dotrodeo/rodeo/web/src/assets/hardware/rev-b/rodeo-power-usbc-iso.webp

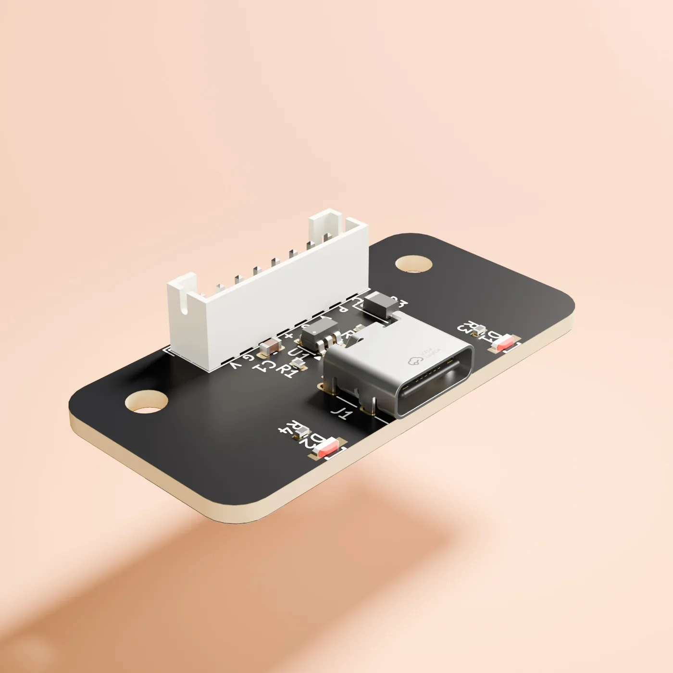
web/src/assets/hardware/rev-b/rodeo-power-usbc-iso.webp
