dotrodeo/rodeo/hardware/rodeo-motherboard/renders/rodeo-motherboard-front.jpg

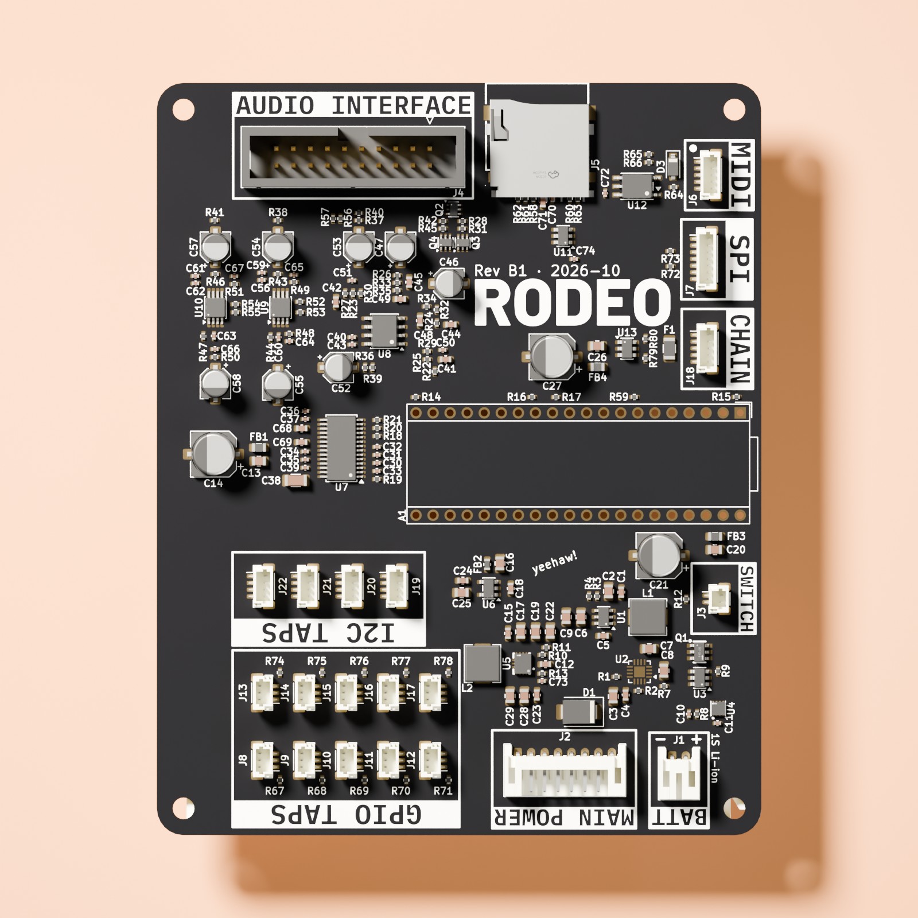
hardware/rodeo-motherboard/renders/rodeo-motherboard-front.jpg
