dotrodeo/rodeo/instruments/rodeo-002/docs/RODEO_002_CONCEPT.md

---
title: "rodeo-002 — Instrument Concept"
tags: [rodeo, rodeo-002, instrument, concept, granular, plaits, daisy-seed]
status: draft
created: 2026-09-20
updated: 2026-09-22
---

# rodeo-002 — Instrument Concept

**What it is:** the second instrument instance built on the Rodeo platform (see the repo
README — the platform is the product, an instance is a demonstration of it). rodeo-002 is a
**multi-engine digital polysynth feeding a Chroma-Console-style texture chain that ends in a
granular delay.** It is played from an external MIDI keyboard; it has no keybed and no
sequencer.

It is deliberately *not* rodeo-001. rodeo-001's governing rule was **no hidden controls**;
rodeo-002 accepts a **single shift layer** (Derek, 2026-09-20) in exchange for far more
parameters than its 21 physical controls could otherwise reach.

## Fixed constraints (Derek, 2026-09-20)

| | |
|---|---|
| Parts on hand | 1 motherboard · 1 encoder hub · **5 encoders** · **16 pots** · 1 OLED · **no buttons** |
| Played by | MIDI keyboard only (TRS MIDI IN). No arp/sequencer requirement |
| Daisy | Seed, **64 MB SDRAM** variant |
| Audio input | **Ignored for this build.** Possible future upgrade (the jacks exist) |
| Presets | **Required** |
| Voices | Voice-mode switch. **6 minimum, 8 target, 12 only if resources spare** |
| Touchstone | **Hologram Electronics Chroma Console** — its textures and granular delays |

## Signal flow

```
MIDI IN ─► voice alloc ─► N × [ macro-oscillator engine ─► SVF ─► amp env ] ─► stereo sum
                                                                                   │
   ┌───────────────────────────────────────────────────────────────────────────────┘
   ▼
 [CHARACTER] ──► [MOVEMENT] ──► [TEXTURE] ──► [SPACE] ──► tilt EQ ─► volume ─► LINE OUT
  drive /        chorus /       bitcrush /    granular delay / cloud,
  fold /         vibrato /      tape wobble / freeze, reverse, pitch-shifted
  saturate       phaser         lo-fi filter  grains (shimmer)
```

### The voice

One **engine per patch**, selected on the main encoder. Every engine is driven by the same
three macros — **Harmonics / Timbre / Morph** — so the panel never changes meaning, only
character. The engine list, **measured on hardware 2026-09-20** (budget section below).
"Voices" is the largest count that stayed under 70% audio load **with the texture chain
running**. Poly mode caps at 8 regardless — a higher number here is headroom, not voices.

| Engine | Source | Cost/voice | Voices |
|---|---|---|---|
| Virtual analog (synced variable-shape) | DaisySP `VariableShapeOscillator` | 3.3% | **16** |
| Variable saw | DaisySP `VariableSawOscillator` | 3.0% | **16** |
| ~~Particle (resonant noise grains)~~ | ~~DaisySP `Particle`~~ | ~~3.6%~~ | **DROPPED 2026-09-29** |
| Formant / vowel | DaisySP `FormantOscillator` | 4.6% | **12** |
| Harmonic / additive (16 partials) | DaisySP `HarmonicOscillator<16>` | 6.7% | **8** |
| 2-op FM | DaisySP `Fm2` | 6.8% | **8** |
| ~~Grainlet~~ | ~~DaisySP `GrainletOscillator`~~ | ~~6.9%~~ | **DROPPED 2026-09-29** |
| Vosim | DaisySP `VosimOscillator` | 8.9% | 6 |
| Z-osc | DaisySP `ZOscillator` | 9.5% | 6 |
| ~~Karplus string~~ | ~~DaisySP `String`~~ | ~~14.0%~~ | **DROPPED 2026-09-29** |
| ~~String voice~~ | ~~DaisySP `StringVoice`~~ | ~~16.4%~~ | **DROPPED 2026-09-29** |
| ~~Modal~~ | ~~DaisySP `ModalVoice`~~ | ~~46.2%~~ | **DROPPED** |
| Wavetable | *deferred* — would port from Plaits (MIT) | unmeasured | — |
| Chord | *deferred* — would port from Plaits (MIT) | unmeasured, ~4–6 osc/voice | — |

**Wavetable and Chord are deferred** (Derek, 2026-09-20): not ported for now, so the shipping
engine list is the twelve measured above.

**MODAL IS DROPPED** (Derek, 2026-09-22): at 46% for a single voice it could not run at all
beside an expensive Space type, and designing around it was not worth it.

**GRAINLET, PARTICLE, STRING AND KARPLUS ARE DROPPED** (Derek, 2026-09-29, after living with
the instrument): four engines nobody reached for, two of which could not be played
polyphonically at all. That leaves **seven engines** — virtual analog, variable saw, 2-op FM,
formant, Vosim, harmonic-16, Z-osc — every one of them polyphonic, so nothing overrides the
voice mode any more. The DSP stays in DaisySP if any of it is ever worth having back.

**The removal paid for itself twice over.** `Engine` holds one union sized by its largest
member, and `StringVoice` is **5368 bytes** against **148** for everything that remains. Per
voice storage fell 5220 bytes; across eight voices that is **~41.6 KB of DTCM**, and the build
went from **85.5% to 53.8%** of the 128 KB budget. The CPU ceiling moved too: the dearest engine
left is Z-osc at 9.02%, where String was 16.43%.

Per-voice costs above are the 2026-09-22 hardware fit (raw ticks, post-optimisation); they
are the numbers [`cost_model.h`](../firmware/common/cost_model.h) uses.

Most of the list is already vendored in `rodeo-sdk/DaisySP` — these are the
Plaits-derived modules Émilie Gillet contributed upstream, so the "Plaits-like" feel is mostly
a matter of *driving* them from common macros rather than porting new DSP. Anything still
missing comes from the MIT-licensed Mutable source.

**Per voice, after the engine:** a DaisySP `Svf` (Derek chose a real multimode filter over a
Plaits-style low-pass gate), **one ADSR** and one LFO.

**One envelope, shared** (decided 2026-09-21). The single ADSR drives the amp directly, and
the filter, Timbre and Morph through their amount controls (Filter env amount, Env→Timbre,
Env→Morph). That is what the panel has controls for — four envelope stages, not eight — and
it is how the platform's `06_poly_synth` example works.

**Voice modes:** Poly (8, or 6 on Vosim/Z-osc) · Mono (legato + glide) · Unison (stacked,
detuned by Spread).

### Patch gain (2026-10-01)

Derek: *"the maximum volume output has quite a wide range. Some patches are very loud, other
patches are very quiet."* Measured, that was **19.3 dB of peak spread** across the sixteen factory
presets — a lot more than "some patches are just louder".

**Where it comes from.** Not the engines: at identical settings all seven sit within **5.7 dB** of
each other, so a per-engine trim would have bought almost nothing. It comes from the patches —
envelope, filter, voice mode and how much of the chain is in play — which means nothing but a
stored, per-preset number can fix it.

**So every preset carries a gain**, linear, −18 to +12 dB, on the patch settings page in dB and
adjusted half a decibel at a time — **and shown to the half decibel**, since the step is half a
decibel. It first rounded to whole dB, which printed `+8 dB` for two different settings and so said
the knob had done nothing; a readout that cannot tell two states apart is worse than no readout
(Derek, 2026-10-01). Each adjustment also snaps to the half-decibel grid rather than running the
value through log and exp and keeping the error, so the text is exactly the state. Sixty-one
distinct readings end to end, enforced by `Ui.EveryGainDetentReadsDifferentlyFromTheLast`. It is applied **after the chain**, as a separate trim from the
master volume, for two reasons: turning a preset down must not also turn its drive down, and the
master is squared for feel, which would make a trim folded into it mean something else.

Why not a normaliser, the other option on the table: an automatic one fights the player. Close the
filter and it gets louder; it cannot tell "quiet because it is a pluck" from "quiet because it
needs gain". A number set once per sound is predictable, and it is what every synth with this
problem does.

**The factory bank is balanced with it**, to a −6 dB peak on a four-note chord at full velocity.
`Level.SuggestedFactoryGains` prints the figure each preset needs, and those are the numbers in
`factory_presets.h`. Peak spread is **2.4 dB** now, enforced by `Level.TheFactoryBankIsLevel`.
Peak is what is matched and RMS deliberately is not: a pluck carries less energy than a pad at the
same peak, and forcing their RMS together would mean boosting the pluck until it clipped.

**It cost no new storage.** `release` had been dead since the envelope became ADS on 2026-09-24 —
written in step with `decay`, read by nothing — so the gain took its four bytes at the same offset.
That still needed `PresetBank::kVersion` 2 → 3, because a v2 slot holds a copy of `decay` there and
a decay value read as a gain is a quiet preset nobody asked for. **A v2 bank is migrated rather
than rejected**: the layout is identical, so the whole migration is to put unity in that one field
and move the version on. Nothing saved is lost, which is the only reason the version could be
bumped at all.

### Effects review (2026-09-29)

Derek: *"I suspected some of them may not be working as expected."* All twenty types were measured
against what their names claim, not just for stability — the existing tests already asked whether
each type was stable, transparent at zero and audible at full, and a phaser that is really a
low-pass passes all three. `tests/fx_review_gtest.cpp` holds the harness and prints every number.

**Character, Movement and Space came out clean.** All five waveshapers add harmonics and none leaks
DC; Bias brings in even harmonics on four of them and takes them *away* on Rectify, which is
correct and documented (centred, Rectify is already full-wave). The Movement LFO runs at exactly the
0.05–12 Hz it claims, Vibrato is the only type without stereo motion (by design, no dry path), and
every Space type responds properly to both Time and Feedback.

**Two real faults, both in Texture:**

* **Crush was sending −0.125 of DC to the output.** `Decimator` quantises with an arithmetic shift,
  which truncates toward minus infinity instead of rounding, so every sample rounds down by up to a
  step; at full crush the step is a quarter of full scale and the mean error is half of that.
  Nothing downstream removed it — the output stage is tilt, volume and the limiter — so it reached
  the codec, and reached Space's feedback, where DC is amplified and a railed output is heard as
  *silence* because the line out is AC-coupled. **The Texture wet path is DC-blocked now**, the same
  arrangement Character has always had. `FxReview.NoSlotSendsDcDownTheChain` is the guard.
* **Squash was a volume control with a compressor attached.** Its make-up gain applied half the
  theoretical compensation, leaving a nominal −6 dB signal 7.5 dB down on Soft and 11.3 dB down on
  Pump. At 0.85 all three options land within half a decibel of unity, *together* — that they agree
  across ratios is what says 0.85 is right rather than a fudge.

**Two things that looked wrong and were not**, both worth recording so they are not "fixed" later:

* Crush's Smooth/Stepped option makes no difference at full crush. That is arithmetic, not a bug:
  `Decimator`'s `bit_overflow_` works out to exactly 2 at a whole-bit setting, and shifting by
  `bits+1` after a 2× pre-scale is the same as shifting by `bits`. The option is about the *sweep* —
  measured across the knob, Smooth changes on 19 of 28 steps and Stepped on 12.
* Dust barely registers in an energy measurement because it is crackle *on top of* the signal rather
  than a bed replacing it. It puts peaks at 0.85 against a 0.5 input, which is the thing to measure.

**One design observation, not a fault:** Chorus, Phaser and Flanger all show ~0.9 amplitude
modulation on a sine. That is a single delay tap combing against the dry, and the nulls sweep
through the fundamental. It is thin and wobbly where a multi-tap chorus would be lush. Left alone.

### The factory bank (rebuilt 2026-09-29)

Sixteen sounds, written from nothing for the instrument as it now is. The old bank predated the
sub-oscillator, Spread-as-width and the per-voice drift, so half of those controls sat at their
defaults in every slot.

It is built to **cover the instrument** rather than to be sixteen good sounds in one corner of it:
all seven engines, all three voice modes, all three filter types, all five Space types, and the sub
above the note, below it and switched off. `FactoryBank.CoversTheInstrument` enforces exactly that,
so the claim cannot quietly stop being true as engines and effects come and go, and
`FactoryBank.EveryPresetFitsTheBudget` checks every slot against the same cost model the firmware
uses — a factory sound the board cannot run is worse than no sound. Polyphony across the bank
lands between 4 and 8 voices, worst predicted load 68.7%.

Slot 1 is still **Init** and is not really a sound: it is the zero point, it is what every empty
user slot plays, and it is one detent away whatever you are doing.

**Editing this file does not change an instrument that already has a bank.** The stored bank is
replaced only when it is invalid or when asked, and the version is unchanged — *Factory Reset* in
the menu is what loads a new one. That also clears gestures and instrument state, which is what it
is for.

### Analog behaviour (2026-09-29)

Derek: *"I mostly just want to add a little more complexity/depth/richness."* Two things every
analog polysynth does for free and a digital one has to be told to do. Both cost effectively
nothing — no CPU worth measuring, no RAM, and **no panel controls at all**.

**Every voice is tuned slightly wrong, and wanders.** A fixed error per voice in cents
(`kVoiceCents`, irregular on purpose — evenly spaced offsets comb rather than thicken), plus a
slow wander from one-pole filtered noise, ~0.5 s to settle so it reads as drift and not vibrato.
Peak deviation is about 6 cents. Voice 0 is exactly in tune, because Mono only ever plays voice 0
and a lead should not be detuned from the rest of the band.

**Every voice has a place in the stereo field**, scaled by Spread (`kVoicePan`). The pan law is
equal power, so opening the field does not change how loud the instrument is, and Spread at 0 is
the old mono sum sample for sample.

The ordering of those positions is the whole point, and the first attempt got it wrong. A linear
ramp across all eight looks right and is not: Poly fills voices from index 0 upward, so a chord
smaller than the full polyphony takes the first few positions and sits entirely on one side —
measured, a C major 7th came out **L=371 against R=101**. The positions alternate outward from
the centre instead, so every even number of voices is balanced and a single held note lands 20%
off centre rather than hard left. `VoiceManager.AChordIsNotPushedToOneSide` is the regression
test.

### The sub-oscillator (2026-09-29)

A plain waveform under (or over) the note, mixed in before the filter. **Not a second macro
engine**, and that is the whole design: a second engine would roughly double the per-voice cost,
taking FM and Harmonic from 8 voices to 5 and Vosim and Z-osc to 3. What a second engine would
mostly buy is beating, which **Unison already gives** now that its detune works. What Poly lacked
was *weight*, and that is what a sub is for.

**Two knobs on the shift layer**: Sub level, and Sub interval (stepped — the screen names the
value rather than drawing a meter). Intervals are −12, −7, −5, unison, +5, +7, +12, +19; the
waveform (sine, triangle, saw, square) is on the patch settings page, being a set-once choice.
**Env→Timbre and Env→Morph moved to that page** to free the knobs — they are depths you set for a
patch and leave, so nothing was lost but the travel.

**Level 0 is off and costs nothing**, in CPU and in sound: `CostModel::MaxVoices` charges for the
sub only when a patch uses one, so presets that do not stay at full polyphony.

**It fits in the two bytes `StoredPreset` had left**, which is why it needed no
`PresetBank::kVersion` bump — a bump rejects the stored bank and loses every saved preset. Both
bytes were `reserved` and have always been written as zero, so every preset ever saved decodes as
*sub off, −12, sine*: silent, and set to what you would have picked anyway. Level is 0..255 over
0..1; the second byte packs waveform in the high nibble and interval in the low one.

**There is no slack left in the format.** The next thing that needs preset storage needs a
migration first, not another field.

**There are no mono-only engines any more (2026-09-29).** Modal, String and Karplus were the
three that cost too much per voice to be polyphonic, and all three are gone. Every engine that
remains plays in every voice mode; the polyphony cap is budget arithmetic in `CostModel` rather
than a property an engine declares, and `IsMonoOnly` / `ConstrainVoiceMode` have gone with them.
Poly is Poly on every engine.

| Engine class | Poly | Mono | Unison |
|---|---|---|---|
| Everything 8-voice or better | 8 | yes | up to 4 |
| Vosim, Z-osc | 7 | yes | up to 4 |

**The voice outranks the voice count** (Derek, 2026-09-21). FM, Harmonic and Grainlet run 8
voices at 66–69% in the plain build, 63.5–64.7% under the bootloader — close to the ceiling
either way, with ~5 points of room for the finished voice. If the finished voice (LFO, voice management, any
richer-voice additions) pushes one of them past 70%, **that engine drops to 6 voices** rather
than the voice being held back for it. Each engine's poly count is therefore set from the
finished firmware's measured load, not from the benchmark table.

Selecting a mono-only engine while in Poly **switches the voice mode to Mono and says so on
the OLED**, remembering the previous mode so that moving back to a polyphonic engine restores
it. The engine list is never filtered — every engine stays reachable in the same order, and
the instrument explains the change rather than hiding the option. This is the one place where
engine choice reaches outside the voice.

### The texture chain

Four slots in series, mirroring the Chroma Console's module layout: each slot has a
**selectable effect type** (encoder), **one amount knob** (pot), a **secondary parameter**
(shift + encoder) and a **bypass** (encoder tap). The chain is stereo and runs once on the
voice sum, not per voice.

### Effect types (decided 2026-09-21)

Chain order is **fixed: Character → Movement → Texture → Space**. Derek approved the lists
below as the starting set, to be revisited during implementation if something doesn't earn
its place.

**Each slot's secondary means one thing across all its types.** The shift layer is printed on
the locked panel, so "Character secondary" has to become a word that is true for every
Character type — otherwise the label could not be silkscreened and the OLED would have to
explain it. The discrete option is shown on the OLED, so it may vary.

| Slot | Amount pot | Secondary *(printed)* | Option *(shift + encoder turn, OLED)* |
|---|---|---|---|
| **Character** | Drive | **Bias** — offset into the shaper, odd ↔ even harmonics | Low cut before the drive: off / 100 Hz / 300 Hz |
| **Movement** | Depth | **Rate** | LFO shape: sine / triangle / square / random |
| **Texture** | Intensity | **Tone** — darker ↔ brighter after the effect | Per type (below) |
| **Space** | Mix | **Damp** — darkening in the feedback path | Grain-pitch quantize: free / semitones / fifths + octaves / octaves |

**CHARACTER** — waveshaping

| Type | What it is | Source |
|---|---|---|
| Warm | Gentle soft saturation — the "always on" sweetener | new, trivial (tanh) |
| Drive | Classic overdrive | DaisySP `Overdrive` |
| Fuzz | Hard clip; high Bias makes it gated and sputtery | new, small |
| Fold | Wavefolder; Bias gives asymmetric folds | DaisySP `Wavefolder` |
| Rectify | Octave-up fuzz; Bias blends half-wave into full-wave | new, trivial |

**MOVEMENT** — modulation

| Type | What it is | Source |
|---|---|---|
| Chorus | Stereo chorus | own, on DaisySP `DelayLine` |
| Vibrato | Pitch wobble only, no dry | own, on DaisySP `DelayLine` |
| Phaser | Swept all-pass, 6 stages with feedback | own |
| Flanger | Short delay with feedback | own, on DaisySP `DelayLine` |
| Tremolo | Amplitude; stereo LFO offset makes it autopan | own |

DaisySP's chorus, flanger and phaser each run a fixed internal LFO, so **all five are driven
from our own LFO** — that is what makes the LFO-shape option uniform. (As implemented; the
original plan had named the DaisySP classes.)

**TEXTURE** — degradation

| Type | What it is | Option | Source |
|---|---|---|---|
| Crush | Bit-depth reduction | smooth / hard steps | DaisySP `Decimator` |
| Downsample | Sample-rate reduction, aliasing | — | DaisySP `SampleRateReducer` |
| Tape | Wow and flutter, saturation, hiss | slow wow / fast flutter | new: modulated delay |
| Dust | Vinyl crackle and noise bed | vinyl / radio | own (xorshift RNG, not `rand()`) |
| Squash | Compressor, up to audible pumping | soft / hard / pump | own |

**SPACE** — the granular block. All types use Time / Feedback / Grain / Mix, grain pitch and
spread; **Freeze works in every type**.

| Type | What it does | Time | Feedback | Grain |
|---|---|---|---|---|
| Echo | Granular delay; small grains sound like a clean echo, large ones smear | delay time | repeats | grain size |
| Cloud | Grains scattered across the last *Time* seconds of the buffer | window | regeneration | density |
| Reverse | Echoes play backwards | delay time | repeats | segment length |
| Wash | Grains feed a diffuser — an ambient, reverb-like tail | size | regeneration | diffusion |
| Reverb | A plain reverb | pre-delay | decay | **shimmer** — pitched grains fed into the tail |

**Reverb is DaisySP-LGPL's `ReverbSc`** (Derek, 2026-09-21). Its controls map naturally:
Feedback is `SetFeedback`, Damp is `SetLpFreq`, and Freeze holds the tail indefinitely. Grain
turns the grain engine into a shimmer: grains pitched by the grain-pitch pot, fed back into the
reverb. It is the only type that runs the granular engine *and* a reverb together, so it is
the one to watch on the budget.

**Two rules the feedback types have to obey** — both learned from hardware on 2026-09-23, where
long decays "oversaturated and the audio eventually cut out, coming back when you lower the
settings":

* **No DC goes into a feedback loop.** The voices carry a small offset (~-0.04 measured, which
  is ordinary for asymmetric and sync'd oscillators) and every Space type feeds itself back —
  ReverbSc's DC gain is near 1/(1 - 0.99) = 100x at full decay, the granular types' about 20x.
  The offset walks the output onto the limiter and holds it at a constant -1.0, which has no AC
  left in it; since the Seed's line out is AC-coupled, that is *heard as silence*. Space blocks
  DC on its effect input and again on the reverb's input, where the shimmer loop makes its own.
  The dry path is deliberately not blocked, so the chain stays transparent at zero.
* **A longer decay must not be a louder reverb.** A feedback network's steady-state level goes
  as 1/sqrt(1 - decay), so the reverb's input trim tracks the decay instead of being fixed. The
  decay knob then lengthens the tail without acting as a volume control.

**Measured on hardware, 2026-09-21, re-measured 2026-09-22 after optimisation.** Load added by
each type at its heaviest settings, over an all-bypassed baseline, under the bootloader.
Measurement note: these figures come from raw timer ticks. libDaisy's `CpuLoadMeter` reported
0.0 for every case in `bench_space` (cause unexplained); in `bench_voices` it agrees with raw
ticks to within 0.2 points, so the voice numbers it produced stand.

| Slot | Types, cheapest → costliest (% of CPU) |
|---|---|
| Character | Drive 1.7 · Fold 1.9 · Fuzz 2.2 · Rectify 2.7 · Warm 3.0 |
| Movement | Tremolo 1.4 · Vibrato 3.4 · Chorus 3.6 · Flanger 3.6 · Phaser 5.2 |
| Texture | Downsample 1.3 · Crush 1.9 · Squash 2.4 · Dust 2.6 · Tape 6.5 |
| Space | Reverse 5.3 · Echo 7.8 · Cloud 11.0 · Wash 11.7 · **Reverb 20.6** |

Space's figures are **after the grain-engine optimisation of 2026-09-22** (Echo −23%,
Cloud −21%; the log before it is
[`bench_voices-2026-09-21-fx.log`](bench_voices-2026-09-21-fx.log), after it
[`bench_voices-2026-09-22-optimised.log`](bench_voices-2026-09-22-optimised.log)).

**Costs add:** the worst-case chain (Warm + Phaser + Tape + Reverb) measured **35.4%**, against
35.3% summed — so any configuration's cost can be predicted from this table. That is still
**~3× the 12.9% the benchmark's stand-in chain cost**, and Space is most of it: Reverb alone
costs more than the other three slots combined, because **ReverbSc is 11.6 of its 20.6**
(profile: [`bench_space-2026-09-22.log`](bench_space-2026-09-22.log) — ReverbSc 11.6, grains
~5.0, Space's own per-sample overhead ~5.2). A lighter in-house reverb is the one remaining
optimisation of any size; it is **not** done.

**SPACE is the headline block.** A granular delay whose buffer lives in SDRAM — 64 MB is
minutes of stereo float, so buffer length is a non-issue. Controls: Time, Feedback, Grain
(size/density macro), Mix on the main layer; grain pitch, position spread on shift.
**Freeze** (long-press its encoder) locks the buffer so new notes play over a held cloud;
that is the instrument's signature gesture, and it makes a "capture" feature nearly free.

## Resource budget — MEASURED on hardware, 2026-09-20

Measured by [`bench_voices`](../firmware/bench_voices/) on the real board, at 48 kHz / block
48, voices in SRAM and the grain buffer in SDRAM. Raw log:
[`bench_voices-2026-09-20.log`](bench_voices-2026-09-20.log).

**The texture chain costs a flat 12.9%** — 12.8–13.0% measured across five engines — and it
does not scale with voice count, because it runs once on the voice sum. That figure includes
the granular delay at its worst case: 12 overlapping grains, long and dense, shimmer pitch,
feedback up, reading a 4-second SDRAM buffer. **The headline feature of the instrument costs
about an eighth of the processor**, and SDRAM latency — the thing most likely to have made
this unworkable — is a non-issue.

Everything else is linear in voice count, so the whole budget is:

```
load = 12.9% (chain) + voices x cost-per-voice
```

**8 voices is confirmed for 7 of the 12 measured engines**, and the two cheapest run 16.
Per-engine cost is in the table above.

### Re-measured under the bootloader, 2026-09-21

The instrument runs as `BOOT_SRAM` (see *Firmware platform*), so the sweep was repeated in
that mode — log: [`bench_voices-2026-09-21-bootsram.log`](bench_voices-2026-09-21-bootsram.log).
**Every number carries over or improves:** across 125 paired measurements the load is 1.4
points lower on average (−3%), ranging from 5.6 points better to 1.6 worse. The chain is
unchanged at 12.9%. The gains concentrate in the engines with the most per-voice state — FM,
Formant, Grainlet — consistent with voice state moving to zero-wait-state DTCM in this mode.

The table above keeps the original plain-build figures, so it slightly *overstates* cost in
the shipping configuration. No engine changes voice class: Karplus now fits 4 voices at 68.6%,
a hair under the line, which doesn't matter because it is Mono/Unison-2 by design.

### What this means for the design

* **8 voices is the architecture** — not 6, not 12. Only the two VA engines and Particle
  could do more, and designing around a count that a third of the engine list cannot reach
  would make a worse instrument.
* **There is real headroom at 8 voices** on the cheaper engines: 8 VA voices plus the chain
  is ~39%. That is better spent on a *richer voice* — a second oscillator, a better filter, a
  second LFO — than on voices 9 through 16. **Cost anything per-voice against FM, Harmonic
  and Grainlet**, not VA: they are the ones at the ceiling, and they drop to 6 voices if it
  pushes them past it (see *Voice modes*).
* **70% is the ceiling, deliberately.** The benchmark ran with no pot scanning, no encoder
  polling, no OLED and no MIDI. Audio runs in interrupt context and the UI runs in what is
  left, so that 30% remainder is the UI's entire budget — a full OLED frame at 400 kHz is
  ~23 ms of I²C by itself.
* **Wavetable and Chord are deferred, and so unmeasured.** If revisited: Chord stacks 4–6
  oscillators per voice, so expect roughly 4 voices; Wavetable should be cheap.

## MIDI performance mapping (decided 2026-09-21)

A MIDI-keyboard-only instrument, so the keyboard's own controls matter as much as the panel's:

| Source | Destination | Adjust |
|---|---|---|
| Velocity | Amp level, always; filter by a per-patch amount | Patch settings: velocity→filter |
| Pitch bend | Pitch, **±2 semitones** default | Patch settings: bend range |
| Mod wheel (CC1) | **Adds** to LFO depth | — |
| Channel aftertouch | Morph | — |
| Sustain pedal (CC64) | Holds notes | — |

Glide time and LFO shape also sit on the patch-settings page — they have no panel position.

### The real chain changes the voice budget (2026-09-21)

With the real effects, the worst-case chain costs **36.8%**, not 12.9%. Voices at the 70%
ceiling with that chain running (log above; bootloader build):

| Engine | Stand-in chain | Real worst-case chain |
|---|---|---|
| Virtual analog · Variable saw · Particle · Formant | 12+ | 8–10 |
| FM · Harmonic · Grainlet | 8 | **4** |
| Vosim · Z-osc | 6 | **2** |
| Modal | 1 | **0** — does not fit |

A *light* chain is a different story: Warm + Chorus + Crush + Echo costs ~16%, and FM keeps 8
voices under it. The cap is what makes the difference visible instead of audible.

**Polyphony is capped from the cost table** (Derek, 2026-09-21), implemented in
[`cost_model.h`](../firmware/common/cost_model.h) and pinned to the hardware logs by host
tests — it predicts measured load within 2 points. The worst case is reachable by any player,
and an overload is an audible dropout, not a slowdown — so the firmware computes a safe voice
count from the measured costs whenever the engine or a slot's type changes, and the OLED
always shows it ("FM · 6 voices"). **The voice count can therefore change when a Space type
changes.** With Modal dropped, **every remaining engine fits beside every Space type**, so
there is no unplayable combination to rule on.

### Engine quirk worth knowing: virtual-analog Timbre at morph 0.5

`VariableShapeOscillator` crossfades two waveshapes, and **at exactly morph 0.5 the pulse width
cancels out** — measured on the host, bit-identical output for pulse widths 0.2 and 0.8, while
morph 0 or 1 gives ~0.85 relative divergence from the same change. Timbre drives pulse width on
that engine, so at the midpoint the Timbre knob does nothing whatsoever. It is the oscillator's
behaviour rather than a bug in the mapping, but it is invisible and it makes a knob look broken,
so the **Init** preset sits at morph 0.35 rather than 0.5.

## Envelope — ADS (2026-09-24)

One envelope drives amp and filter, and it has **three controls, not four**: Attack, Decay and
Sustain, with **Decay setting the fall time whether or not the key is still held** (Moog style,
Derek's call). The expressive range is the same in practice — a separate release is rarely set
to something very different from the decay — and it buys back a panel slot, which is what let
the whole envelope come onto the main layer and Filter env come out of the shift layer.

`Patch` and `StoredPreset` keep a `release` field, moved in step with decay by the panel and by
CC. Nothing reads it: `VoiceManager` takes the release time from `decay`. It is retained so the
stored format is byte-identical, which means no version bump and no saved preset lost; a later
firmware could separate the two again the same way.

**Two rules about starting a voice**, both learned the hard way on 2026-09-24, when Decay at
zero made the synth "somewhat randomly" stop responding to keypresses in a way no preset change
could clear:

* **Start a voice by retriggering its envelope, never by the gate alone.** DaisySP's `Adsr`
  restarts on a rising edge (`gate && !gate_`), and there is no edge when a voice is re-used for
  the same note or stolen while it is still held -- its gate was already high. The envelope then
  continues from wherever it was, which is inaudible with a long decay and *silent* with a short
  one.
* **A voice is finished only once it has been released and freed**, not merely when it is silent
  and idle. With sustain at zero the envelope reaches IDLE while the key is still down, so a
  note-off that skips the voice means the `Adsr` never sees the falling edge and its internal
  gate flag stays true for ever -- after which no note-on has a rising edge and the voice is
  dead until reset. A negative note number is the marker for properly wound down; rendering one
  more block of silence is what earns it.

Mono is exempt from the first rule on purpose: it is legato, so a new note over a held one
changes pitch without restarting the envelope. `MonoOn` therefore writes the voice directly
rather than going through `Start()`.

**And a third: glide belongs to a note that arrives while a key is still down**, nothing else.
`Start()` used to decide that from whether the voice was still *sounding*, which is right in
Poly — where a new note lands on a free voice — and wrong everywhere else. Unison restarts the
same voices for every note, so one still ringing out its release counted as sounding and every
keypress glided in from the last (2026-09-24). A stolen Poly voice did the same, from an
unrelated pitch. The caller now says whether it is legato, and only Unison and Mono ever say
yes.

## Preset system

Patches in the Daisy's QSPI flash: engine, all pot values (both layers), all four slot types
and their parameters, voice mode, the patch-settings page, **and the gesture loop if one was
recorded**. Browsing and saving live on the main encoder (see the control map).

**Not in presets** (Derek, 2026-09-21): **MIDI channel** and **master volume** are global. A
preset that stored the MIDI channel could leave the synth deaf to the keyboard, and one that
stored volume would jump the output level on load. Pot calibration is global too.

**Gestures save with presets** (Derek, 2026-09-21), so a preset can move by itself: it starts
its loop when loaded. Size is the only cost: gestures sample at the pot scan rate (~108 Hz —
see the control map), so a full 16-second, 16-pot gesture is ~55 KB, and 64 presets with full
gestures would take ~3.5 MB of the QSPI (which also holds the program image — see *Firmware
platform*). Storing only the pots that actually moved makes a
typical gesture far smaller.

**The instrument boots into the preset it was left on**, as STORED — unsaved edits are
discarded (Derek, 2026-09-24), so power-up is always a known-good sound and the header's `*` is
what tells you the patch has drifted since. Slot 1 if nothing has been chosen yet. The slot is
written to its own sector a few seconds after it changes, never the instant a preset is chosen:
the write is a 64 KB erase.

**Built 2026-09-24** (`common/preset.h`, `common/factory_presets.h`): **16 slots, all sixteen
shipping a factory sound**, browsed and loaded from MAIN exactly as the control map describes.
Saving therefore means replacing one, and there is no restore gesture yet — worth adding, along
with more slots, before the bank starts feeling crowded.

**New factory sounds reach an instrument that has already been saved to by filling its empty
slots at boot** (`FillEmptySlots`). The store's defaults are only written while it has never
been used, so after a first save a later firmware's bank would otherwise never be seen. Nothing
already in a slot is touched, whether factory or yours. The one thing it cannot tell is a slot
deliberately emptied from one never filled — there is no gesture for emptying a slot, so that
cannot arise today, but it is a constraint on adding one. Gestures and naming are built too (2026-09-25): saving spells a name first, and a take is
stored per slot.
Sixteen slots rather than sixty-four because that is what the browser can turn through
comfortably; the sector holds far more when gestures need it.

**Engines are stored by a stable id, never by enum position.** Dropping an engine renumbers
every engine after it, which would silently turn every saved patch into a different sound. Each
engine has a number assigned once in `preset.h` and never reused; a preset naming an engine the
firmware no longer has loads as virtual-analog **and says so**, rather than pretending. Every
other stored enum is range-checked on load, so an old or corrupt bank cannot produce a patch
that indexes past a table. No factory preset uses Grainlet, Particle, String or Karplus, so
dropping those (under consideration, 2026-09-24) orphans nothing.

**LFO rate: 0.05–40 Hz** (2026-09-24). It is ticked once per block, so the block rate is its
sample rate — initialised at the audio rate instead, it ran 48× slow and a nominal 20 Hz
measured 0.45 Hz on the host. Saved presets keep their stored 0–1 knob position, so their LFOs
now run at the speed they were always meant to.

**Physical-position problem:** pots hold their last physical position, so after a preset load
(and after every shift-layer release) the panel disagrees with the patch. Every pot therefore
uses **pickup** — a pot is inert until it crosses the stored value. This applies to the main
layer too, not just the shift layer.

## Firmware platform (decided 2026-09-21)

**The program runs from SRAM via the Daisy bootloader (`APP_TYPE = BOOT_SRAM`), not from
internal flash.** The Seed's internal flash is 128 KB, and `bench_voices` alone — twelve
engines and the chain, with no MIDI, UI, OLED, ADC driver, presets or gestures — already uses
89.7% of it at libDaisy's default `-O2`. The instrument cannot fit there.

Under `BOOT_SRAM` the bootloader copies the program from QSPI into ~480 KB of AXI SRAM at boot
and runs it from there, which is also fast memory, so DSP cost should carry over. Consequences:

* **Zero-initialised globals go to the 128 KB DTCM, not the 480 KB SRAM** — and DTCM also holds
  the stack. This is the real memory budget. `bench_voices` could not link its 16 voices there
  (overflow ~5 KB) and runs 12 in that mode, at 87% of DTCM. The instrument's 8 voices fit
  comfortably, but **any large buffer must be placed explicitly in SDRAM**
  (`DSY_SDRAM_BSS`): the grain buffer already is, and **the live gesture buffer (~55 KB) and
  preset staging must be too**. DTCM is zero-wait-state, so keeping voice state there is a
  speed win rather than a compromise.

* **Install the bootloader once** (`make program-boot`). After that, updates are `make
  program-dfu` into the bootloader: tap RESET, then tap BOOT while the LED pulses to hold it
  in DFU indefinitely. The BOOT button no longer has to be held through a reset.
* **Program image, calibration and presets share the 8 MB QSPI** (7.75 MB usable above the
  bootloader's reserved region). Plenty for all three. The map so far, with erases at 64 KB so
  each tenant gets its own 64 KB boundary:

  | Offset | What |
  |---|---|
  | `0x000000`–`0x03FFFF` | Reserved by the bootloader — do not touch |
  | `0x040000`– | Program image (an SRAM build cannot exceed 480 KB) |
  | `0x780000` | **Panel wiring map** (`PanelPots::Calibration`, ~12 B — which analog runs were built straight) |
  | `0x790000` | **Preset bank** (`PresetBank`, 16 slots, 2.6 KB) |
  | `0x100000`–`0x2FFFFF` | **Gestures**, 128 KB per preset slot — two erase blocks, which is what a full-length 32-lane take needs |
  | `0x7A0000` | **Instrument state** (the preset slot to boot into) |
  | `0x7B0000`– | Free |

  It lives far past the program on purpose: a reflash rewrites only the image, so what is stored
  survives a firmware update as well as a power cycle. **Pot travel is not stored, because it is
  not measured** — the ranges are fixed per wiring and inset by a dead zone (see the harness doc,
  *Bringing it up*). Learning them was tried on 2026-09-24 and removed: a learned endpoint is
  only as good as the worst sample ever taken, and persisting it made one bad sample permanent.
* **Re-run `bench_voices` under `BOOT_SRAM` once** (`make APP_TYPE=BOOT_SRAM`) to confirm the
  benchmark numbers carry over before relying on them in that mode.
* **Licence: the rodeo-002 firmware is always open source** (Derek, 2026-09-21), so the LGPL
  half of DaisySP (`ReverbSc`, `Compressor`, …) is fair game. Enable it with
  `USE_DAISYSP_LGPL = 1` in the app Makefile; the library is already built in the vendored
  tree (`DaisySP-LGPL/build/libdaisysp-lgpl.a`).
* **The enclosure needs access to the Daisy's own micro-USB** — updates and the debug log both
  go through it, and the panel USB-C is power-only. Derek is designing this into the case.

## rodeo-002 firmware v1.0.0 — 2026-09-25

**Scoped to this instrument.** The repository holds the whole platform — the motherboard, the
satellites, rodeo-001 — and each versions itself, so tags are written `rodeo-002/v1.0.0` rather
than `v1.0.0`, which would claim all of it. Component first, so a tag listing groups by
component rather than by version number.

The first build of rodeo-002 that is a finished instrument rather than a bring-up: MIDI, eight voices, the
texture chain, the panel and OLED, sixteen factory presets with naming, the gesture recorder
with per-slot persistence, settings pages, and CC in and out. Versioned in
`firmware/common/version.h` and printed in the startup banner.

**Semantic versioning**, which for an instrument means: **MAJOR** when the panel or a stored
format changes in a way a player or a saved preset would notice — a control moving, a bank that
has to be re-saved; **MINOR** for something new that takes nothing away — an engine, an effect
type, a destination, a page; **PATCH** for a fix.

## rodeo-002 firmware v2.0.0 — 2026-09-29

**Eight empty user slots** (16 factory + 8, `kNumSlots` 16 → 24), a **factory reset** in the
menu, and a **boot splash** carrying the version.

**MAJOR, not minor.** Nothing was taken away, but the bank grew, which changes the stored
layout: a v1 bank is rejected and the factory sixteen come back, so anything saved over a
factory slot is lost. That is the case the rule exists for — *a bank that has to be re-saved* —
and the version number is the only warning a player gets. No migration, by Derek's call
(2026-09-29).

**Factory reset clears presets, gestures and instrument state — not the panel wiring map**
(Derek, 2026-09-29), which is a fact about which cables were built rather than a preference;
clearing it would mean re-proving all 24 pots for no gain. It is the one destructive thing on
the instrument and so the one thing that must be *answered*: the confirmation page starts on
`NO` and has to be turned to `YES` before a tap does anything. A hold could not serve, because a
hold is shift.

Gestures are invalidated by writing zeros over each header's magic rather than by erasing —
flash can always clear bits, so four bytes turn a valid header invalid. Erasing 24 regions of
128 KB would freeze the panel for the better part of a minute; a later save to any of those
slots erases it properly anyway.

### Backlog after v2.0.0

* **The menu is awkward to navigate.** Reported as feeling "difficult and inconsistent" in use.
  Worth a design pass rather than a patch — likely candidates are how entering and leaving
  nest, and that a page and the menu answer the same gestures differently.
* **Occasional ghost UI updates remain**, less often than before the 20 ms confirm window.
  **The obvious theory is probably wrong**: they looked like they might share a cause with the
  load-dependent hum, the supply dipping under CPU load — but the motherboard feeds the pots and
  the ADC's reference from *the same* 3.3 V rail (`hardware-map.md`, *Power*), so the readings
  are ratiometric and rail movement cancels by construction. Something else is producing them.
  Worth measuring a resting channel's raw codes over minutes, looking for whether the excursions
  correlate with anything — OLED frames and the I²C burst that goes with them are the next
  suspects, since they are the loudest thing sharing the board with a 24-channel SPI scan.
* ~~A boot splash~~ **BUILT in v2.0.0** — RODEO, the instrument name and the version, shown
  while the log settles so it costs no time of its own.
* ~~Factory reset~~ **BUILT in v2.0.0.** Four regions were considered:
  the preset bank back to the factory sixteen (`PersistentStorage::RestoreDefaults`), the
  instrument state (boot slot, MIDI channels), the panel wiring map, and **all sixteen gesture
  regions**, which is sixteen 128 KB erases and therefore seconds rather than milliseconds — it
  should say what it is doing while it does it. Two things to decide first: whether a reset also
  clears the wiring map (it is a fact about the cables, not a preference, so arguably not), and
  **how it is confirmed**. The menu has no confirmation pattern yet, and a bare `Factory reset`
  entry that fires on a tap is a foot-gun; a hold cannot be used for it, because a hold is
  shift. The likely shape is a value-style item — turn to `YES`, then tap — which reuses the
  settings-page gesture rather than inventing one. This also closes the gap left when all
  sixteen slots became factory presets: there is currently no way back.
* ~~Eight more slots~~ **BUILT in v2.0.0** — 16 factory + 8 user, `kNumSlots` 16 → 24.
  **Empty rather than copies of Init**: an empty slot shows `-- empty --` and refuses to load,
  which is honest, whereas a copy of Init looks like a sound someone chose. **Half of this was
  wrong, and v3.0.0 fixed it**: once NAV cycled presets, refusing to load made an empty slot a
  hole in the scroll, so an empty slot now *plays* Init while still being *named* `-- empty --`.
  The name is what carries the honesty; the silence was carrying nothing (Derek, 2026-09-29:
  *"I don't think empty user slots should be silent"*). Init is substituted at load time rather
  than written into the bank, so banks already in flash need no version bump and lose nothing.
  `FillEmptySlots`
  composes correctly with that — it only fills where the *factory* bank has a preset, so slots
  17–24 stay empty rather than being refilled at every boot. Two costs to note: changing
  `kNumSlots` changes `PresetBank`'s size, so a stored bank is rejected and **a migration is
  needed or saved presets are lost** (read the 16-slot layout, copy it into the first sixteen);
  and 24 gesture regions at 128 KB are 3 MB, ending at `0x400000`, still well clear of the
  stores at `0x780000`. DTCM cost is ~2.6 KB for the two copies the store keeps, against ~21 KB
  free.

Still deferred by choice: Wavetable and Chord engines, a lighter in-house reverb to replace
ReverbSc, audio input, more preset slots and banks. **Grainlet, Particle, String and Karplus
were dropped on 2026-09-29** — that question is closed.

## Open questions

1. ~~Gesture recorder~~ **RESOLVED (Derek, 2026-09-21), BUILT 2026-09-24** (`common/gesture.h`).
   It moved off MAIN's long-press onto a menu entry — see the control map — because a hold that
   sometimes meant shift and sometimes armed a recorder was confusable in both directions.
   **Saved with presets since 2026-09-24**, and it cost no stored format change at all: a take
   is ~100 KB, three orders of magnitude bigger than a preset, so it never belonged in the bank.
   Each slot has its own 128 KB region from `0x100000`, and that region's own header answers
   whether the preset has a gesture — so no version bump, no migration, and no saved preset
   lost. Only the frames actually recorded are erased and written (a four-second take is 25 KB,
   not 100), because erasing stalls the panel for the best part of a second. Saving a slot
   *without* a gesture writes an empty header, which clears whatever was there: an old loop must
   not attach itself to a new sound.
2. ~~The three physical models miss the 6-voice minimum~~ **RESOLVED (Derek, 2026-09-20):**
   keep them, restricted to Mono/Unison — see Voice modes above.
3. ~~Panel layout~~ **LOCKED (Derek, 2026-09-20):** 4×4 pots, a column of 4 slot encoders, MAIN
   isolated under the OLED, 30 × 35 mm pitch — see the control map.
4. ~~Texture-slot effect lists~~ **RESOLVED (Derek, 2026-09-21):** see *Effect types* — 5 / 5 /
   5 / 5, printed secondaries Bias / Rate / Tone / Damp, fixed chain order. Every type still
   needs a cost measurement.
5. ~~MIDI CC in/out map for the pots~~ **RESOLVED, BUILT 2026-09-25.** In and out share one
   map (firmware README). Out is throttled to one message per 10 ms, round-robin: MIDI carries
   ~330 three-byte messages a second and 32 parameters would saturate it.
6. ~~The real chain's cost~~ **RESOLVED (Derek, 2026-09-22):** grain engine optimised
   (Space types −14 to −23%), worst chain now 35.4%; polyphony cap implemented in
   `cost_model.h`; Modal dropped, which removes the only unplayable combination. **Deferred:**
   replacing ReverbSc with a lighter in-house reverb (it is 11.6 of Reverb's 20.6) — worth
   ~2 voices on the heavy engines if Reverb patches ever feel too tight.
