dotrodeo/rodeo/instruments/rodeo-001/docs/RODEO_CONTROL_MAP.md

---
title: "Rodeo Control Map — Interface Contract"
tags: [rodeo, hardware, control-map, daisy-seed, pinout, ads114s08]
status: active
created: 2026-08-08
updated: 2026-08-22
---

# Rodeo Control Map — Interface Contract

**Owner:** Bumble (hardware/electronics). Source of truth for the pin/channel → function
assignment. Firmware (Fizz) reads controls exactly as mapped here; the panel (Honey) must
physically fit what is specified here. Keep all three in sync.

> Status: verified against the KiCad schematics in `rev-a/rodeo-motherboard/kicad/` (root
> `rodeo-motherboard.kicad_sch` + subsheets `daisy_seed`, `digital_io`, `jst_connectors`,
> `serial_io`) and cross-checked with the firmware-side `docs/hardware-map.md`. The **PCB**
> (`rodeo-motherboard.kicad_pcb`, 87 parts) is the net authority — the root schematic does not
> hierarchically instantiate the subsheets, so a schematic-only netlist is incomplete.

## ✅ SPI orientation — RESOLVED & bench-verified (2026-08-15)

The earlier "SPI data lines crossed" concern was a **stale local snapshot**. The current
copy under `rev-a/rodeo-motherboard/kicad/` is drawn **correctly** — verified pin-by-pin this
session: A1 pad11 `SPI1_PICO` (controller-out/MOSI) → `SPI_MOSI` ─R16─ `ADC_MOSI` → U3/U4
**DIN** (pin 10); A1 pad10 `SPI1_POCI` (controller-in/MISO) → `SPI_MISO` ─R13─ `ADC_MISO` →
U3/U4 **DOUT** (pin 12). And it is **proven in silicon**: `04_adc_1ch` read live data on U3
and `05_adc_scan` streams U4, so DOUT→MISO / DIN→MOSI is correct on the real board. No
reroute needed. (See resolved Issue 1 below.)

## Design maturity (Derek, 2026-08-08)

- **Finalized / trustworthy:** `rodeo-potentiometer` and the motherboard analog+digital
  fan-out it mates to. *(2026-08-20/21: `rodeo-rotary-switch` was here but is now **dropped**
  — see Ecosystem Update in the Path B section. Locked control types: pot, encoder (I2C),
  momentary button, OLED.)*
- **Done / interface-verified (2026-08-20):** `rodeo-button`, `rodeo-encoder`,
  `rodeo-encoder-hub` (STM32C031C6, 9-slot). The motherboard itself is the only remaining
  moving piece (this local copy may lag the latest).
- **Dropped:** `rodeo-rotary-switch`, `rodeo-switch` (SPDT), `rodeo-pixel`,
  `rodeo-encoder-bank` (RP2040 4-gang → replaced by the hub-and-satellite above).

---

## Confirmed budget (Derek, 2026-08-08)

| Resource | Count | Reality |
|---|---|---|
| Analog inputs | 24 | Two external **TI ADS114S08** 12-ch 16-bit ΔΣ ADCs (U3/U4) on **SPI1**, not the Seed's native ADC pins |
| Digital I/O | 12 | Raw Daisy Seed GPIO — **no buffers, no expanders, no muxes** |
| I2C | I2C1 | Qwiic/STEMMA-QT 4-pin header (J42); smart modules live here |
| SPI | SPI1 | Shared with the two ADCs; also broken out on J43 (no dedicated CS) |
| UART/MIDI | USART1 | J44 header **and** the MIDI DIN share USART1 → mutually exclusive |
| Display | **SSD1309 OLED, 128×64** | **I2C @ 0x3C** (Decision A, 2026-08-15) — feedback-only, shares I2C1/J42 with the encoder hub(s). **DD-001 originally chose SPI but that was SUPERSEDED:** the only SPI bus (SPI1) is fully owned by the two ADS114S08 ADCs, so the OLED had to move to I2C. So the I2C bus = **OLED 0x3C + encoder hub(s) 0x30–0x33.** (2026-08-20: I briefly mis-corrected this to SPI — reverted; Derek confirmed I2C.) |

## Governing design principle: NO HIDDEN CONTROLS

Derek: *"one of the goals of the synth is to have no hidden controls."* Every
player-adjustable parameter gets its own dedicated physical control — no menu-diving, no
shift layers. The OLED is feedback/visualization only. Consequences:

1. Continuous parameters are bounded by the **24 analog channels**.
2. Discrete selectors remain "visible" if labeled — a resistor-ladder rotary switch reads
   as one analog voltage giving N silk-screened positions on a single channel.
3. Encoders arrive over I2C (smart modules), so they do **not** consume the 24/12 budget —
   they're bus-limited, not pin-limited (see budget note under Modules).

---

## Motherboard is a HUB; controls are satellite PCBs

Rodeo is a modular ecosystem, not a monolith. The motherboard exposes its I/O as JST-SH
connectors; each control type is its own satellite PCB that wires back to the hub. This
**supersedes** the earlier "single co-designed control PCB" seam Honey and I sketched.

- **Dumb analog satellite** (`rodeo-potentiometer`): 3-pin JST-SH → an ADC channel.
- **Dumb digital satellite** (`rodeo-button`, momentary): 2-pin JST-SH → a digital GPIO.
- **Dumb encoder satellite** (`rodeo-encoder`, EC11): 4-pin (A/B/S/GND) → a hub slot.
- **Smart I2C hub** (`rodeo-encoder-hub`, STM32C031C6, 9 encoders): Qwiic → J42 @0x30.

  *(Dropped: rotary-switch, SPDT switch, pixel-LED, and the RP2040 encoder-bank strip.)*

### Ownership seam (revised)

- **Honey owns:** enclosure, panel layout as a *tiling of fixed satellite-board geometries*
  over the hub, panel cutouts, mounting, standoffs, knob/cap.
- **Bumble owns:** the **satellite↔hub wiring harness** (JST-SH pinouts, lengths, routing),
  the **I2C bus** (address allocation, pull-up sizing, chain length), ADC/SPI integrity,
  grounding, and any anti-alias filtering that isn't already on a satellite.

### Harness cable orientation (netlist-verified 2026-09-13)

JST-SH cables come in two builds — **straight** (pin 1 → pin 1) and **reversed**
(pin 1 → last pin) — and the ecosystem does **not** use one pin-1 convention
everywhere, so which one a run needs depends on the link. Verified pad-by-pad from
each board's `.kicad_pcb`:

| Link | Host pins (1 → N) | Satellite pins (1 → N) | Cable |
|---|---|---|---|
| **Analog:** motherboard J6–J29 ↔ `rodeo-potentiometer` / `rodeo-rotary-switch` | `+3V3 / signal / GND` | `GND / signal / supply-in` | **REVERSED** |
| **Digital:** motherboard J30–J41 ↔ `rodeo-button` | `DIG / GND` | `signal / GND` | straight |
| **I²C:** motherboard J42 ↔ `rodeo-encoder-hub` J1/J2 | `GND / +3V3 / SDA / SCL` | same | straight |
| **Encoder:** hub J3–J11 ↔ `rodeo-encoder` J1 | `A / B / S / GND` | same | straight |

On the analog satellites, pin 3 feeds the top of the pot / ladder through the 1 kΩ + 100 nF
supply filter, and pin 1 is ground — the mirror image of the motherboard side. What the wrong
cable does, per link:

- **Analog, built straight:** the satellite's supply and ground swap. Everything on those boards
  is passive, so nothing is damaged — but **every pot reads backwards** and a rotary-switch ladder
  inverts into the wrong bins. The wiper is the centre pin, so it still produces a plausible
  0–3.3 V sweep, which makes this look like a firmware sign bug rather than a harness fault.
- **I²C, built reversed:** SCL is grounded and SDA is tied to +3V3. The whole bus dies (the OLED
  goes dark too), and the hub MCU is back-powered through its SDA pin.
- **Encoder, built reversed:** A lands on the encoder's ground pin and B swaps with the switch, so
  the slot never counts.
- **Button:** straight matches the netlist. A reversed 2-pin still happens to switch, but build
  them straight.

**Never judge a cable by wire colour.** Motherboard connectors are vertical and satellite
connectors horizontal, so the ribbon colours land mirrored *even on a correct cable* — that is
exactly how the reversed I²C and encoder cables got built on first bring-up. Ohm out pin 1 at each
end before plugging in. Off-the-shelf Qwiic / STEMMA QT cables are straight and suit the I²C and
encoder runs (colours are meaningless on the encoder runs); the analog runs need reversed builds.

---

## Analog subsystem — 24 channels via 2× ADS114S08 (U3/U4) on SPI1

- 16-bit delta-sigma, 12 channels each. **Ratiometric to the +3V3 rail** (U2 TLV76733 LDO):
  `AVDD/DVDD/IOVDD/REFP0 = +3V3`, `AVSS/REFN0 = GND`. Pots share that same rail, so supply
  variation cancels in the reading. START/SYNC tied high (continuous conversion); `DRDY#`
  unconnected → firmware **polls with RDATA** on a fixed cadence, no data-ready line.
- Shared SPI1 with 33 Ω series resistors (R13/R14/R16); individually chip-selected:
  - `SPI_SCK` → Seed pin 9
  - `SPI_MISO` net → pad 10 (`SPI1_POCI`, controller-in) → ADC **DOUT**; `SPI_MOSI` net → pad 11 (`SPI1_PICO`, controller-out) → ADC **DIN**. Orientation verified correct & bench-proven — Issue 1 CLOSED (see SPI note up top). Firmware handle: `MISO=D9`, `MOSI=D10`.
  - `SPI_ADC1_CS` → Seed pin 32 (PA0, GPIO) = U3 (ADC A)
  - `SPI_ADC2_CS` → Seed pin 33 (PD11, GPIO) = U4 (ADC B)
  - Firmware: `NSS::SOFT`, drive PA0/PD11 as GPIO.

### Analog channel ↔ connector map (uniform)

| Connectors | Net | Goes to | Pinout |
|---|---|---|---|
| **J6–J17** | `ADC1_1..12` | U3 AIN0–AIN11 | 1=+3V3, 2=signal(wiper), 3=GND |
| **J18–J29** | `ADC2_1..12` | U4 AIN0–AIN11 | 1=+3V3, 2=signal, 3=GND |

Rule: `ADC1_k ↔ J(5+k)`, `ADC2_k ↔ J(17+k)`, and `AINindex = k−1`. All 24 are 3-pin
JST-SH 1.0 mm (`BM03B-SRSS-TB`, vertical). **These runs take REVERSED cables** — the
satellites are pinned `GND / signal / supply-in`; see *Harness cable orientation* above.

**Firmware channel-index convention (contract with `RodeoAdc::GetCode(ch)`):** the
canonical linear index is `ch = chip·12 + AINindex`, so:

| `ch` | Chip | AINx | Connector |
|---|---|---|---|
| `0..11`  | U3 (ADC A) | AIN0..AIN11 | J6..J17 |
| `12..23` | U4 (ADC B) | AIN0..AIN11 | J18..J29 |

i.e. `ch 0→J6`, `ch 11→J17`, `ch 12→J18`, `ch 23→J29`. This binding is the
source of truth; firmware `board.h` and the ADC lib must match it so a logical
control lands on the connector this map names.

**AINCOM is board-tied to GND** on both U3 and U4 (verified in KiCad), so each
single-ended read `AINx − AINCOM = AINx − GND` = the full 0–3.3 V wiper voltage,
ratiometric to the +3V3 pot supply. Unipolar → the 16-bit signed code spans
`0..+32767` (the negative half is unused); clamp small sub-zero excursions at
0 V to 0 (see firmware note).

**Latent channel footgun:** AIN6/AIN7 alias REFP1/REFN1 and AIN8–AIN11 alias
GPIO0–GPIO3 on the ADS114S08. We use REFP0/REFN0 (`REFSEL=00`) and no GPIO, so
all 12 per chip are free as inputs — but never set `REFSEL=01` or configure
those pins as GPIO, or the corresponding channels silently disappear.

> **⚡ ECOSYSTEM UPDATE (Derek, 2026-08-20/21): rotary switches + LEDs REMOVED.**
> Locked-available control types are now exactly four: **potentiometers (analog),
> rotary encoders (I2C), momentary buttons (digital), and the SSD1309 OLED (I2C).**
> Consequences for the allocation below, reconciled and now LOCKED:
> - `rodeo-rotary-switch` is **dropped**. **✅ DECIDED (Derek, 2026-08-21): Wave-select = encoders
>   (option b).** OSC1 Wave + OSC2 Wave become `rodeo-encoder` singles inside their own OSC
>   boxes, on **hub slots 7 & 8** @0x30 (hub now **8/9**, 1 spare). **ch0/ch3 (J6/J9) are freed
>   as spare ADS inputs** — reserved for a future CV/mod input. **Channel call (Bumble): leave
>   the gaps at J6/J9** (do NOT re-pack the 22 pots to the tail) — the 22 pots keep their exact
>   frozen ch assignments and harness wiring; the only `board.h` delta is ch0/ch3 → SPARE.
>   Rationale: zero disturbance to the frozen 1:1 physical-order mapping vs. a full 22-channel
>   renumber + harness rewire for a marginal spare-adjacency gain.
> - All **LED** hardware (per-encoder rings, pixel strip, indicators) removed from the
>   panel; the OLED is the **single feedback surface**. Hub LED chain stays on-board but
>   firmware-stubbed (parked future upgrade). No LED cutouts/lightpipes on the panel.
> Final locked panel tally: **22 pots + 8 encoders + 6 buttons + 1 OLED = 37 controls.**
> **Amended 2026-09-13 (Derek): 22 pots + 7 encoders + 5 buttons + 1 OLED = 35 controls** — OSC2
> hard-sync moved from a button to a press on the OSC2 Octave encoder, and Master tune removed.
> Current allocation in the Path B section below.
> Firmware note (Fizz): encoders are incremental → **persist waveform + encoder state across
> power cycles**, value shown on the OLED; wave-encoder steps ±1 through the 4 waveforms
> (wrap), direction per `CONFIG.ENC_DIR_INVERT`.

> **🎛️ VOICE UPDATE (Derek, 2026-08-22): voice = "a less-complicated multi-engine poly"** — 12-voice
> poly, oscillators **subtractive + FM + formant**, **polyphonic SVF** filter, Filter ADSR +
> Amp ADSR + **1 LFO single destination, no mod matrix**. Impact on this contract:
> - **Filter / mod / mix / global / voice controls: UNCHANGED and frozen** — they map 1:1 onto
>   the new voice (SVF ↔ Filter Type, LFO Dest ↔ the single destination, both ADSRs, etc.).
> - **✅ OSCILLATOR section RESOLVED — Option A (Derek, 2026-08-22): semantics-only, no channel
>   remap, stays 22/24.** Per-osc **Shape → model-dependent Timbre** (PW for subtractive /
>   FM-index for FM / formant-position for formant — the *interpretation* changes per engine,
>   the pot keeps its channel). The **Wave encoders (hub slots 7/8) = engine select**. The
>   global **Vowel pot stays as-is**. No FM/formant params get new channels; the ch0/ch3 spares
>   are preserved. Only firmware interpretation changes — the pin/channel/slot bindings below
>   are unaffected. (This is the one place we lean on per-engine macro re-use; Derek accepted it
>   for the oscillator only, filter/mod/mix stay strictly one-control-per-parameter.)

### THIS BUILD — Path B allocation (locked 2026-08-15, Derek)

**Decision (Derek, 2026-08-15):** the motherboard is already produced → **no respin → Path B.**
**Wheels removed** (Derek: desktop synth — pitch-bend + mod come over MIDI, not the panel),
dropping the surface to **35 analog** (26 pots + 9 selectors) + 1 toggle. We fit it onto the
board as-built: 24 ADS channels + digital cycle-buttons + one I2C encoder-hub + the OLED for
enum readout. (Path A / 3rd-ADC is the documented **Rev-B upgrade path** — see below.) Class
allocation is frozen here; the exact pot→connector *ordering* is deferred to a sync with Honey
so channel order matches physical left-to-right panel grouping.

| Subsystem | Budget | Gets | Count |
|---|---|---|---|
| **24 ADS channels** (J6–J29) | 24 | 22 live-sweep **pots** (ch0/ch3 = J6/J9 now **SPARE**) | **22 used, 2 spare** |
| **Digital GPIO** (J30–J41) | 12 | 5× momentary `rodeo-button` (cycle-enum) → **DIG_2–6 / J31–J35**; DIG_1 / J30 **SPARE** since 2026-09-13 | **5 used** (7 spare) |
| **I2C encoder-hub** (J42) | — | one `rodeo-encoder-hub` @`0x30`, 9-slot: 3 **trims** + 2 **octaves** + 2 **Wave**; OSC2 Octave press = hard-sync | **7 encoders → 1 hub (7/9)** |

**The 24 ADS channels** — 22 live-sweep pots (Wave/engine selectors moved to the encoder-hub):
OSC1 Timbre, OSC1 Spread, OSC2 Timbre, OSC2 Spread · OSC1 lvl, OSC2 lvl, Noise lvl ·
Cutoff, Resonance, Env amount, Vowel · Filt-ENV A/D/S/R, Amp-ENV A/D/S/R · LFO Rate, LFO
Amount · Master volume  = **22 pots**. **ch0 (J6) and ch3 (J9) are now SPARE** (Wave went to
encoders) — first free ADS headers, reserved for a future CV/mod input. **22 used, 2 spare.**

**Digital** — 5× momentary `rodeo-button` (2-pin JST-SH sig/GND, idle-high via STM32 internal
pull-up, 100 nF debounce on the satellite):
- **5 cycle-buttons** (momentary push → firmware cycles enum, OLED shows value): Filter Type,
  Keytrack, LFO Shape, LFO Dest, Voice Mode.
- ~~**1 hard-sync** (OSC2) button~~ — **moved 2026-09-13 (Derek)** to a **press on the OSC2
  Octave encoder** (hub slot 6); firmware toggles sync on the press edge. The button is gone and
  **DIG_1 / J30 is now SPARE**. The encoder is silkscreened **`PUSH: SYNC`** so the function
  stays visible under the no-hidden-controls rule (labeled = visible); sync state shows on the OLED.
= **5 of 12 digital used, 7 spare.**

#### 🔒 FROZEN digital-button table (2026-08-23, from Honey's Panel Layout, physical order)

Connector↔digital-index mapping is uniform: **`J(29+n) = DIG_n`** (J30 = DIG_1 … J41 = DIG_12).
The buttons take **J31–J35 = DIG_2–DIG_6 = Seed pins 3–7**; **J30 = DIG_1 = Seed pin 2 is SPARE**
(hard-sync moved to an encoder press 2026-09-13 — the other five kept their pins, so no re-pin and
no harness change). J30–J35 are all SDMMC pins — digital-only, no ADC/timer capability, so
nothing is wasted on them. **J36–J41 = DIG_7–DIG_12 = Seed pins 22–27 stay SPARE** — these are the *ADC-capable* pins, deliberately
reserved so a future need (native-ADC input, CV, a timer function) can reclaim them.

| Button (signal-flow order) | Section | `DIG_n` | Connector | Seed pin |
|---|---|---|---|---|
| ~~OSC2 Hard-sync~~ **SPARE** — hard-sync → OSC2 Octave press (2026-09-13) | — | DIG_1 | **J30** | 2 |
| Filter Type / SVF mode | FILTER | DIG_2 | **J31** | 3 |
| Filter Keytrack | FILTER | DIG_3 | **J32** | 4 |
| LFO Shape | LFO | DIG_4 | **J33** | 5 |
| LFO Dest | LFO | DIG_5 | **J34** | 6 |
| Voice Mode | GLOBAL | DIG_6 | **J35** | 7 |

**Firmware contract:** bind each button's logical enum to its `DIG_n` (→ the libDaisy pin for
Seed pins 3–7 in `board.h`), `GPIO::Pull::PULLUP`, active-low (pressed = 0). No SD card in
Rodeo, so the SDMMC pins are free as plain GPIO — no boot-strap conflict.

**Encoder-hub** (detented, OLED feedback, off the 24/12 budget — hub-and-satellite, one
9-slot `rodeo-encoder-hub` @`0x30`; see the LOCKED hub section below):
- **`0x30` index↔param table (LOCKED 2026-08-21):**
  slot 1 = OSC2 Detune · slot 2 = Unison detune · slot 3 = Glide · **slot 4 = spare** (was Master
  tune, removed 2026-09-13) · slot 5 = OSC1 Octave · **slot 6 = OSC2 Octave; press = OSC2
  hard-sync toggle** (2026-09-13) · **slot 7 = OSC1 Engine/Wave select** ·
  **slot 8 = OSC2 Engine/Wave select** (Option A: encoder picks the osc engine/waveform;
  steps ±1 with wrap) · slot 9 = spare. **7 of 9 slots used, 2 spare.**
  Slot 6 is the only slot with a press function; every other push-switch is unbound. With Master
  tune gone there is no panel tuning control — the pitch reference is fixed.
  Firmware binds these hub indices; physical hub-header↔slot wiring is Honey's harness (I
  confirm the index↔param map once her v2 harness is drawn — convention: header order = slot order).

**Electrical contract points I own for Path B (new, because we now lean on digital + I2C):**
- **Cycle-buttons = momentary-to-GND on the 2-pin digital connectors (sig/GND, no 3V3).**
  Idle-high is defined by the **STM32 internal pull-up** (Fizz: `GPIO::Pull::PULLUP`, ≈40 kΩ)
  — no hub-side resistor. Actuation is *momentary*, distinct from the SPDT `rodeo-switch`;
  Honey is adding a **`rodeo-button`** momentary satellite (confirmed 2026-08-15) — same
  2-pin electrical interface.
- **Wave rotary switches** ride `rodeo-rotary-switch` (finalized): resistor ladder → one
  analog voltage, 4 silk-labeled positions on 1 ADC channel each. Firmware thresholds the
  voltage into 4 bins (ladder has margin for ≥6 positions, so 4 is comfortable).
- **I2C is now a live bus** (OLED 0x3C + one encoder-hub 0x30 on J42). Chain length is
  finally known enough to size pull-ups (Issue 2): boot at 100 kHz, target **2.2–3.3 kΩ to
  +3V3** for 400 kHz. SSD1309 full-frame at 400 kHz ≈ 23 ms (~30 fps), so OLED does partial/low-rate
  refresh while encoder polls (16-byte bursts from `0x10`) interleave — Fizz schedules; no contention.
- **Release valve (0-spare ADS):** if we ever need a free ADS channel, demote one Wave rotary
  back to a cycle-button (frees 1 channel, costs 1 of the 7 spare digital). Trivial swap.

#### 🔒 FROZEN pot-by-pot table (2026-08-15, from Honey's Panel Layout v1)

Honey delivered the dimensioned panel's **physical left-to-right ADC sequence** (top band
then bottom, signal-flow order); I mapped it 1:1 onto the connectors via `ch = chip·12 +
AINindex`. **This table is the frozen firmware/panel contract** — `board.h` control enum
must bind these `ch` indices to these functions.

| `ch` | Function | Class | Chip | AINx | Connector |
|---|---|---|---|---|---|
| 0  | **SPARE** (was OSC1 Wave; moved to encoder-hub slot 7) — free ADS header, future CV/mod | — | U3 | AIN0  | **J6**  |
| 1  | OSC1 Timbre (model-dependent: PW / FM-index / formant-pos) | pot | U3 | AIN1  | **J7**  |
| 2  | OSC1 Spread | pot | U3 | AIN2  | **J8**  |
| 3  | **SPARE** (was OSC2 Wave; moved to encoder-hub slot 8) — free ADS header, future CV/mod | — | U3 | AIN3  | **J9**  |
| 4  | OSC2 Timbre (model-dependent: PW / FM-index / formant-pos) | pot | U3 | AIN4  | **J10** |
| 5  | OSC2 Spread | pot | U3 | AIN5  | **J11** |
| 6  | OSC1 level | pot | U3 | AIN6  | **J12** |
| 7  | OSC2 level | pot | U3 | AIN7  | **J13** |
| 8  | Noise level | pot | U3 | AIN8  | **J14** |
| 9  | Cutoff | pot | U3 | AIN9  | **J15** |
| 10 | Resonance | pot | U3 | AIN10 | **J16** |
| 11 | Filter Env amt | pot | U3 | AIN11 | **J17** |
| 12 | Vowel (formant)| pot | U4 | AIN0  | **J18** |
| 13 | Filt-ENV A | pot | U4 | AIN1  | **J19** |
| 14 | Filt-ENV D | pot | U4 | AIN2  | **J20** |
| 15 | Filt-ENV S | pot | U4 | AIN3  | **J21** |
| 16 | Filt-ENV R | pot | U4 | AIN4  | **J22** |
| 17 | Amp-ENV A | pot | U4 | AIN5  | **J23** |
| 18 | Amp-ENV D | pot | U4 | AIN6  | **J24** |
| 19 | Amp-ENV S | pot | U4 | AIN7  | **J25** |
| 20 | Amp-ENV R | pot | U4 | AIN8  | **J26** |
| 21 | LFO Rate | pot | U4 | AIN9  | **J27** |
| 22 | LFO Amount | pot | U4 | AIN10 | **J28** |
| 23 | Master Volume  | pot | U4 | AIN11 | **J29** |

- **U3 = ch0–11 (J6–J17):** both OSC blocks + MIX + top of FILTER (Cutoff/Reso/EnvAmt).
- **U4 = ch12–23 (J18–J29):** Vowel + both ADSRs + LFO + Volume.
- **ch0/ch3 (U3 AIN0/AIN3, J6/J9) are SPARE** — the Wave selectors moved to encoder-hub
  slots 7/8 (Derek 2026-08-21). Headers left unpopulated; `board.h` ch0/ch3 = SPARE, all 22
  pots keep their frozen ch. Firmware may skip them in the populated-channel list; if a defined
  reading is ever wanted, tie AIN0/AIN3 to GND (rev-B). Reserved for a future CV/mod input
  (which brings its own buffer + protection per the analog front-end note).
- **Chip boundary lands mid-FILTER** (ch11 EnvAmt on U3 │ ch12 Vowel on U4). **Kept as-is,
  not rotated:** the two chips convert in parallel and all 24 channels are read every scan,
  so a section spanning the boundary has no coherence or scan-grouping penalty — Honey's
  physical order is preserved 1:1.
- **Alias-pin reminder (Issue footgun):** ch6/ch7 use AIN6/AIN7 (= REFP1/REFN1 pads) and
  ch8–11 use AIN8–11 (= GPIO0–3 pads). Correct as inputs under `REFSEL=00` + no GPIO config;
  never repurpose those pins or the channel vanishes.

---

### REV-B UPGRADE PATH — 36-channel expansion (Path A, NOT this build)

> **Not built.** Derek chose Path B (board already produced). This is the documented upgrade
> for a future motherboard rev that wants the pure all-pots-and-switches Prophet surface.

Honey's Voice Inventory v0.1 tallies **37 analog controls** (26 pots + 9 rotary selectors +
2 wheels) for the all-visible 2-osc surface — 13 over the 24-channel budget. **Adding a 3rd
ADS114S08 (U5) on the shared SPI1 bus is feasible and low-risk.** Verdict and spec:

- **Bus:** U5 hangs on the same `SPI_SCK`/`SPI_MOSI`/`SPI_MISO` as U3/U4 — add 33 Ω series
  R's matching R13/R14/R16. Multi-drop MISO is safe: the ADS114S08 **tri-states DOUT when
  CS is high** (already relied on for U3/U4), so no bus contention.
- **Chip-select — the one new pin:** needs exactly one more GPIO. **Seed pin 8 = PG10
  (SPI1 hardware NSS), currently NC** — the natural `SPI_ADC3_CS`. We already run
  `NSS::SOFT` and drive CS as GPIO, so PG10-as-GPIO is fine. Leaves Seed pins 29/30/31/34/35
  still spare. → three CS: PA0(U3) / PD11(U4) / **PG10(U5)**.
- **Latency is ~free — parallel conversion.** Each ADS114S08 has its own ΔΣ core + input
  mux; the 3 chips convert **simultaneously**. The SPI bus only carries MUX-select + result
  readout. Going 24→36 does **not** deepen any chip's mux (each stays ≤12 channels), so
  full-surface scan wall-time is essentially unchanged — you read 3 chips over the bus
  instead of 2 (marginal SPI overhead). Expansion by adding chips (parallel) beats muxing
  deeper (serial). This is the key reason A is cheap.
- **Ref/power identical:** REFP0/REFN0 = +3V3/GND, AINCOM→GND, `REFSEL=00`, same AIN6/7 &
  AIN8–11 alias footgun (never enable as GPIO/REF). ~few mA on the 3V3 LDO — negligible;
  add 0.1 µF + 10 µF local decoupling like U3/U4.
- **CS hygiene:** three CS nets now — extend Fizz's "park all CS idle-high before probe"
  init (commit `611f48a`) to U5, and the **Rev-B 10 kΩ CS pull-ups (Issue 6) now cover 3
  nets** not 2.
- **Connectors:** +12 3-pin JST-SH → propose **J50–J61** (J45–J49 are power JST-ZH, so J50
  is the next free number). Channels extend the linear convention: `ch = chip·12 + AINx`
  with chip index 2 → **`ch 24..35` = U5 AIN0..AIN11 = J50..J61**.

**The two wheels ride the Seed's native ADC, not U5.** Only **1 of the 12 digital GPIO** is
used (the panel toggle), and pins 22–27 are ADC-capable (`ADC_0..5`, currently `DIG_7..12`).
Put pitch-bend + mod on **Seed pins 22/23 (ADC_0/ADC_1)** — 12-bit is plenty for a wheel, and
it keeps the 3rd chip's budget for the 35 pots+selectors (36 ch ⇒ **1 ADS spare**). Native
ADC shares the H7 die (noisier than the ratiometric ADS path); if pitch-wheel noise is ever
audible, **promote pitch-bend to the spare ADS channel** — we'll have it. Each native-ADC
wheel needs its own RC anti-alias (≈1 kΩ + 100 nF) and firmware oversampling.

**Rejected alternative:** an analog mux (74HC4051/4067) ahead of existing channels
reintroduces time-multiplexed settling + charge-injection on a *precision* ΔΣ input and adds
a scanned/"hidden" feel; a dedicated 3rd ADC keeps the firmware scan loop identical (just one
more CS) and the signal path clean. Not recommended.

**Cost of A:** it forces a **motherboard respin** (U5 + CS trace + J50–J61). Rev-B is already
anticipated for the CS pull-ups (Issue 6) and possibly the pixel connector (Issue 3), so U5
folds into that spin at modest marginal cost — but the currently-fabbed board can't do the
full 37-control surface; the all-visible build needs the next rev. **Gating question for
Honey answered: yes, 36 channels + 2 native-ADC wheels covers the whole surface.** Full
channel-by-channel assignment table lands once Derek makes the A-vs-B vibe call.

## Digital subsystem — 12 raw GPIO

- **J30–J41**, 2-pin JST-SH (`BM02B-SRSS-TB`), pinout `1=signal, 2=GND` (no 3V3).
- `DIG_1..DIG_6` → Seed pins 2–7 = **`seed::D1..D6` = PC11 / PC10 / PC9 / PC8 / PD2 / PC12**
  (the SDMMC1 pins D3/D2/D1/D0/CMD/CK — digital-only, no ADC/timer). Verified 1:1 against
  libDaisy's port table (Fizz, 2026-08-23). No SD card in Rodeo → free as plain GPIO.
- `DIG_7..DIG_12` → Seed pins 22–27 (ADC-capable pins used as GPIO; firmware could reclaim
  up to 6 as native analog if ever needed). PB1/PA7 are 3.3 V-tolerant only. **Kept SPARE.**
- **Canonical DIG_n→Seed-pin fact now also lives in firmware `common/board.h`** (Fizz added the
  generic map 2026-08-23; matches this table). board.h = firmware-consumed source, this doc =
  human contract; they must stay in sync (currently identical). *Instance* button→DIG_n
  assignment stays in rodeo-001's `control_map.h`, not board.h.
- No expanders/muxes on the board. To expand digital, either mux off-board or move the
  function to a smart I2C satellite.

## Buses

| Bus | Seed pins | Header | Notes |
|---|---|---|---|
| I2C1 | SCL=12 (PB8), SDA=13 (PB9) | J42, 4-pin Qwiic (`+3V3,GND,SDA,SCL`) | **No on-board pull-ups** — Issue 2. OLED + encoder banks live here |
| SPI1 | SCK=9, pin10, pin11 | J43, 6-pin | Shares the ADC bus; **no dedicated CS**. Seed pin 8 (PG10 CS) is NC |
| USART1 | TX=14 (PB6), RX=15 (PB7) | J44, 4-pin | **Shared with MIDI DIN** (opto 6N138 U1, TRS-A J2/J3) → mutually exclusive |
| Audio | in=16/17, out=18/19 | J4 in / J5 out, 3.5 mm TRS | Single-ended, 100 Ω series (R4/R5) |
| USB-C | — | J1 | **Power only** (VBUS→VIN); Seed USB D+/− dead-end. Flash via Seed's own port |
| Power | VIN=39 | J45–J49, 3-pin JST-ZH | `GND,+3V3,VIN`; U2 TLV76733 LDO 5→3.3, D1 TVS on VIN |
| Status LED | Seed pin 28 | — | `DAISY_STATUS` → R10 1K → D5 → GND |

## Daisy Seed pin map (verified from `daisy_seed.kicad_sch`)

| Pin | Seed name | Net | Function |
|---|---|---|---|
| 2–7 | SDMMC | DIG_1..DIG_6 | Digital I/O |
| 8 | SPI1_CS (PG10) | NC | unused |
| 9 | SPI1_SCK (PG11) | SPI_SCK | ADC SPI clock |
| 10 | SPI1_POCI (PB4=MISO) | `SPI_MOSI` net | ADC SPI data ⚠ |
| 11 | SPI1_PICO (PB5=MOSI) | `SPI_MISO` net | ADC SPI data ⚠ |
| 12 | I2C1_SCL (PB8) | I2C_SCL | I2C clock |
| 13 | I2C1_SDA (PB9) | I2C_SDA | I2C data |
| 14 | USART1_TX (PB6) | UART_TX | UART/MIDI TX |
| 15 | USART1_RX (PB7) | UART_RX | UART/MIDI RX |
| 16/17 | AUDIO_IN 1/2 | AUDIO_IN_L/R | Line in |
| 18/19 | AUDIO_OUT 1/2 | AUDIO_OUT_L/R | Line out |
| 22–27 | ADC_0..5 | DIG_7..DIG_12 | Digital I/O (ADC-capable pins as GPIO) |
| 28 | ADC_6 | DAISY_STATUS | Status LED |
| 32 | SAI2_SD_B (PA0) | SPI_ADC1_CS | U3 chip-select (GPIO) |
| 33 | SAI2_SD_A (PD11) | SPI_ADC2_CS | U4 chip-select (GPIO) |
| 36/37 | USB D−/D+ | NC | no panel USB data |
| 39 | VIN | VIN | 5 V power in |
| 20/40 | AGND/DGND | GND | ground |

Seed pins 8, 29, 30, 31, 34, 35 = no-connect. Seed 3V3 outputs (21/38) unconnected —
carrier runs its own LDO rail.

---

## Control modules (satellites)

| Module | Maturity | Class | Sense element | Interface | Budget cost |
|---|---|---|---|---|---|
| **rodeo-potentiometer** | ✅ final | dumb analog | Alps RK09K pot; on-board R1 1K + C1 100 nF RC anti-alias | 3-pin JST-SH (3V3/wiper/GND) | 1 ADC channel |
| **rodeo-button** | ✅ done | dumb digital | momentary tact + 100 nF debounce; idle-high via **STM32 internal pull-up** (no on-board R) | 2-pin JST-SH (sig/GND) | 1 digital GPIO |
| **rodeo-encoder** | ✅ done | dumb (into hub) | 1× EC11 detented encoder + push-switch | 4-pin (A/B/S/GND) → a hub slot | **0** on 24/12 budget (rides I2C via hub) |
| **rodeo-encoder-hub** | ✅ done | **smart I2C** | up to **9× EC11**, **STM32C031C6** target (quad decode + press-latch); LED chain HW present but **firmware-stubbed** | Qwiic 4-pin I2C @`0x30` (addr jumpers JP1/JP2) | **0** on 24/12 budget; 1 I2C address, 9 encoder slots |
| ~~**rodeo-rotary-switch**~~ | ❌ DROPPED 2026-08-20/21 | — | resistor-ladder rotary; **removed** (control set locked to pot/encoder/button/OLED) | — | — |
| ~~**rodeo-switch** (SPDT)~~ | ❌ DROPPED | — | hard-sync is not an SPDT — briefly a `rodeo-button`, and since 2026-09-13 a press on the OSC2 Octave encoder | — | — |
| ~~**rodeo-pixel**~~ | ❌ DROPPED | — | all LED feedback removed → OLED is sole feedback surface | — | — |

Encoder-hub (hub-and-satellite, current): **STM32C031C6** target, addr **0x30 default,
0x30–0x33** via 2 cuttable jumpers JP1/JP2 (on PD0 / PA15), read-clear delta register map +
press-latch, up to **9 encoders per hub**. Full electrical spec in the **LOCKED hub section**
below and `RODEO_HUB_I2C_CONTRACT.md`. *(Superseded: the old RP2040 4-gang `rodeo-encoder-bank`
strip — struck 2026-08-20.)*

### Budget accounting under "no hidden controls"

- **Continuous (pots):** each = 1 of the 24 ADC channels.
- **Buttons (`rodeo-button`, momentary):** each = 1 of the 12 digital GPIO. (Multi-position
  selection = press-to-cycle a button, value on OLED.)
- **Encoders:** via the I2C encoder-hub — **do not** touch 24/12. Up to 9 per hub; add hubs
  (0x30–0x33) if ever needed. Bus-limited, not pin-limited. Each encoder's push-switch comes free
  with its slot; exactly one is bound (OSC2 Octave press = hard-sync), and it must be silk-labeled.
- **OLED:** I2C @ 0x3C, shares J42 with the encoder-hub (0x30 — no collision).

I2C bus is now a shared managed resource I own: address allocation, pull-up value sized for
the total daisy-chain capacitance, and chain-length limits.

---

## Known issues / flags

### 1. ✅ RESOLVED — ADC SPI MOSI/MISO orientation correct & bench-verified (2026-08-15)

**Status: CLOSED.** The current local KiCad is drawn correctly and the ADC path is proven in
silicon — no reroute, not a fab blocker. Verified this session: ADC `DIN` (U3/U4 pin 10)
─R16─ `SPI_MOSI` → A1 pad11 `SPI1_PICO` (controller-out/MOSI); ADC `DOUT` (U3/U4 pin 12)
─R13─ `SPI_MISO` → A1 pad10 `SPI1_POCI` (controller-in/MISO). So the MCU drives DIN and reads
DOUT — correct. Bench (2026-08-14): `04_adc_1ch` read live pot data on U3; `05_adc_scan`
streams U4. The old "crossed" description was a stale snapshot and no longer applies.
Owner: Bumble. Blocks firmware ADC bring-up (Fizz).
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
