dotrodeo/rodeo/hardware/rodeo-audio-3.5mm/jlcpcb-panel/placement-check.png

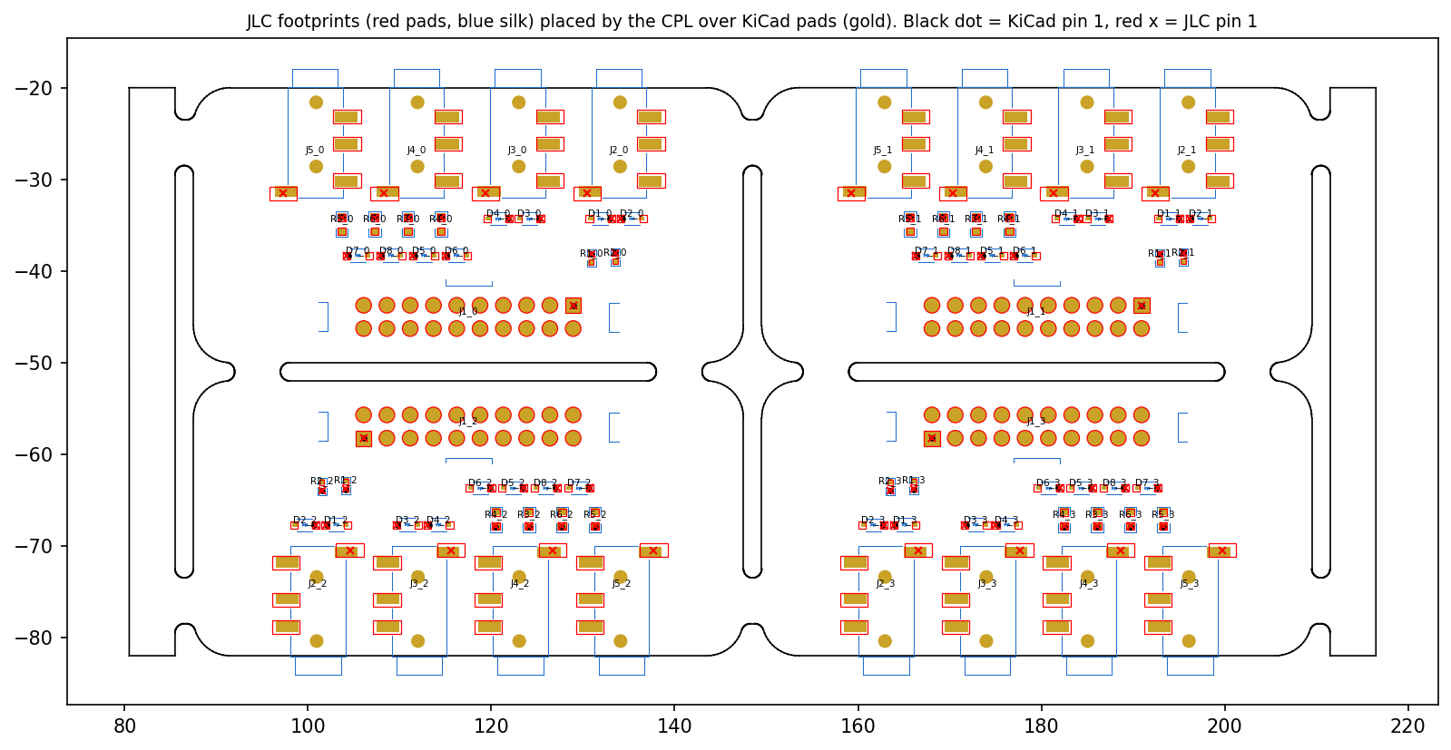
hardware/rodeo-audio-3.5mm/jlcpcb-panel/placement-check.png
