dotrodeo/rodeo/hardware/rodeo-audio-3.5mm/jlcpcb/placement-check.png

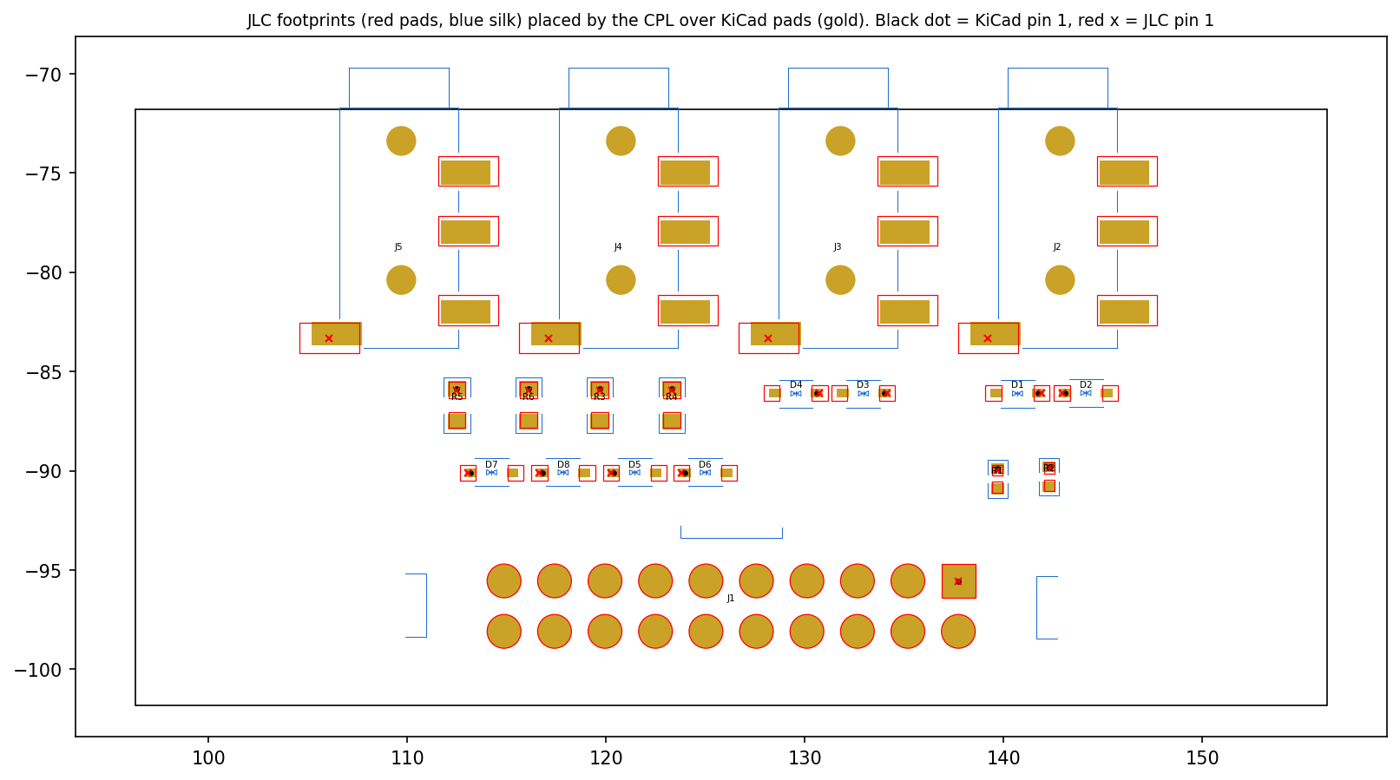
hardware/rodeo-audio-3.5mm/jlcpcb/placement-check.png
