dotrodeo/rodeo/hardware/rodeo-audio-3.5mm/renders/rodeo-audio-3.5mm-back.jpg

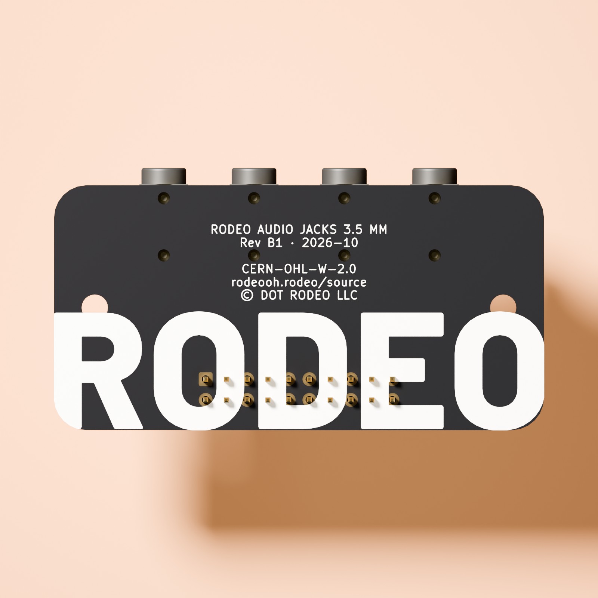
hardware/rodeo-audio-3.5mm/renders/rodeo-audio-3.5mm-back.jpg
