dotrodeo/rodeo/hardware/rodeo-audio-3.5mm/renders/rodeo-audio-3.5mm-iso.jpg

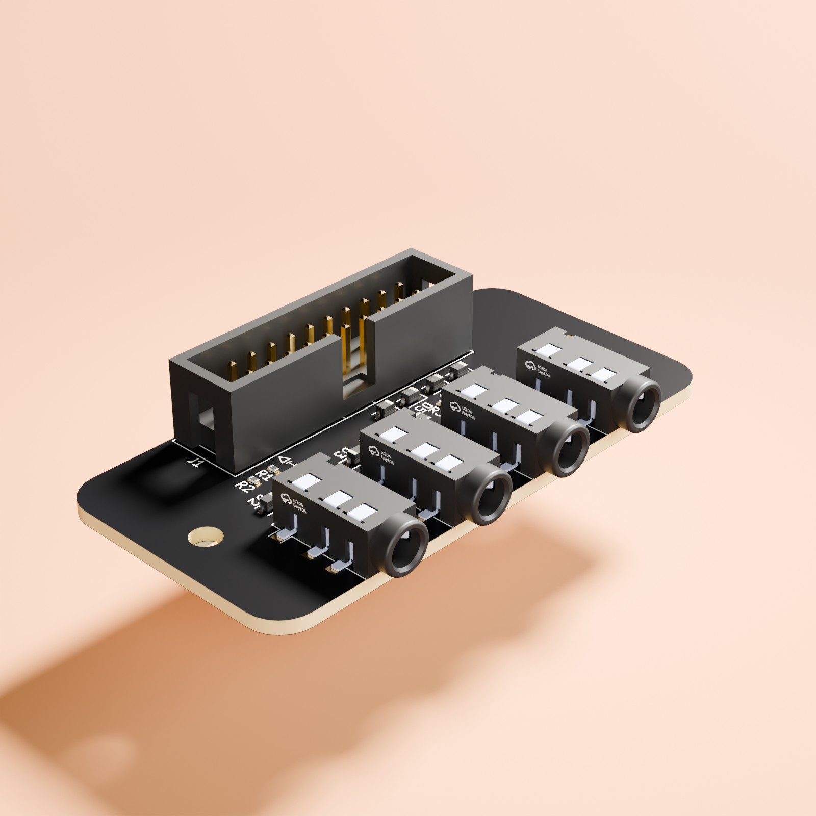
hardware/rodeo-audio-3.5mm/renders/rodeo-audio-3.5mm-iso.jpg
