dotrodeo/rodeo/hardware/rodeo-button-bank-4/jlcpcb-panel/placement-check.png

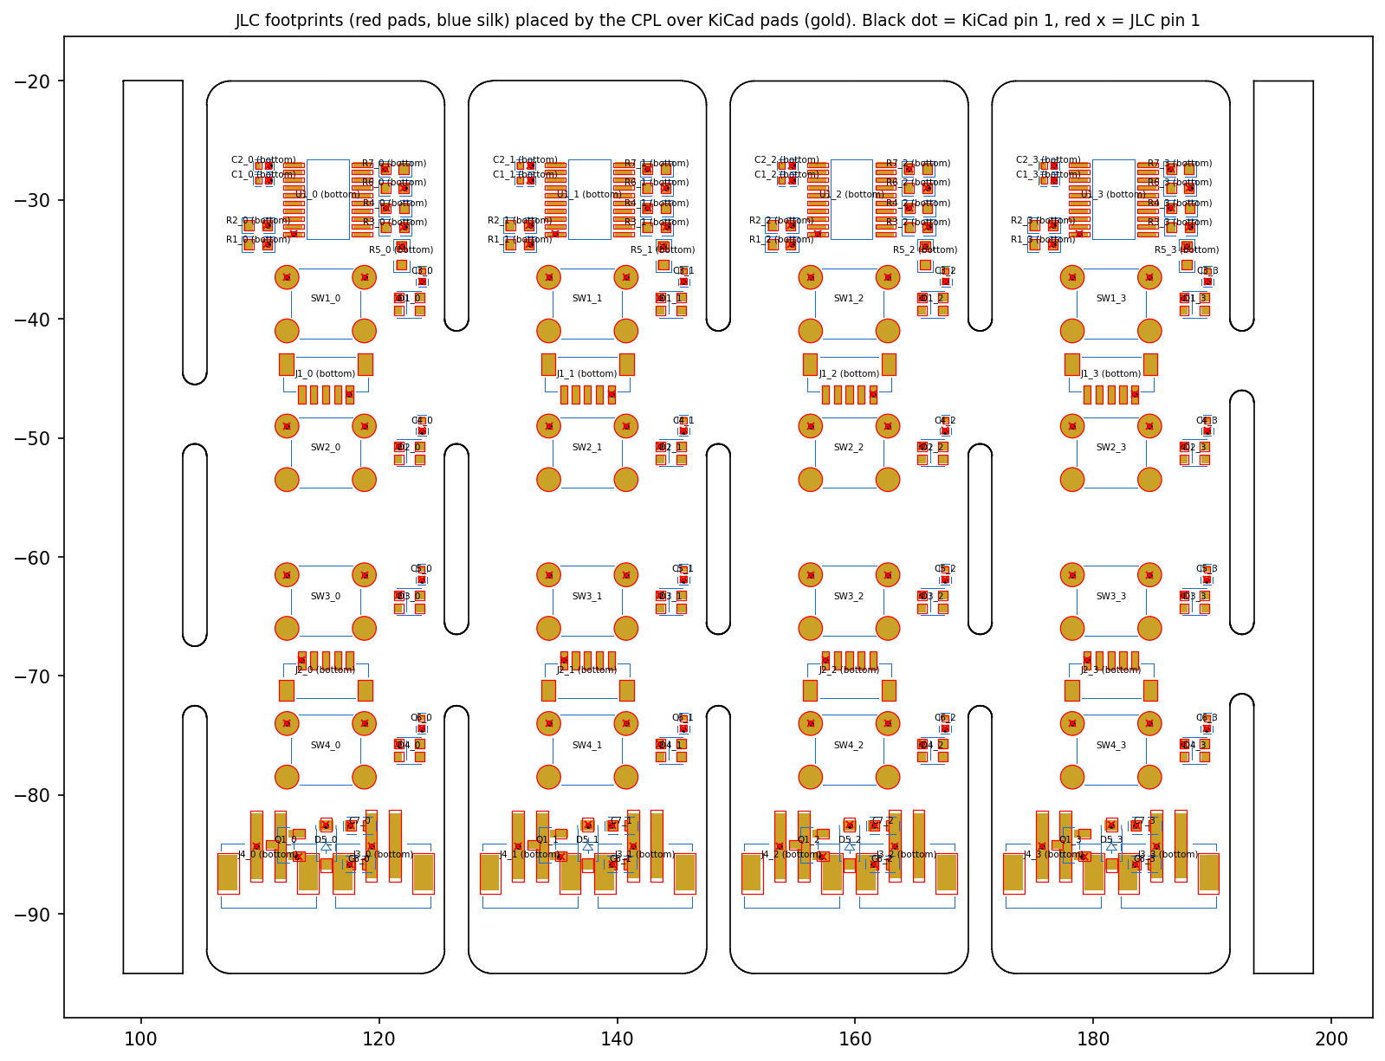
hardware/rodeo-button-bank-4/jlcpcb-panel/placement-check.png
