dotrodeo/rodeo/hardware/rodeo-button-bank-4/jlcpcb/placement-check.png

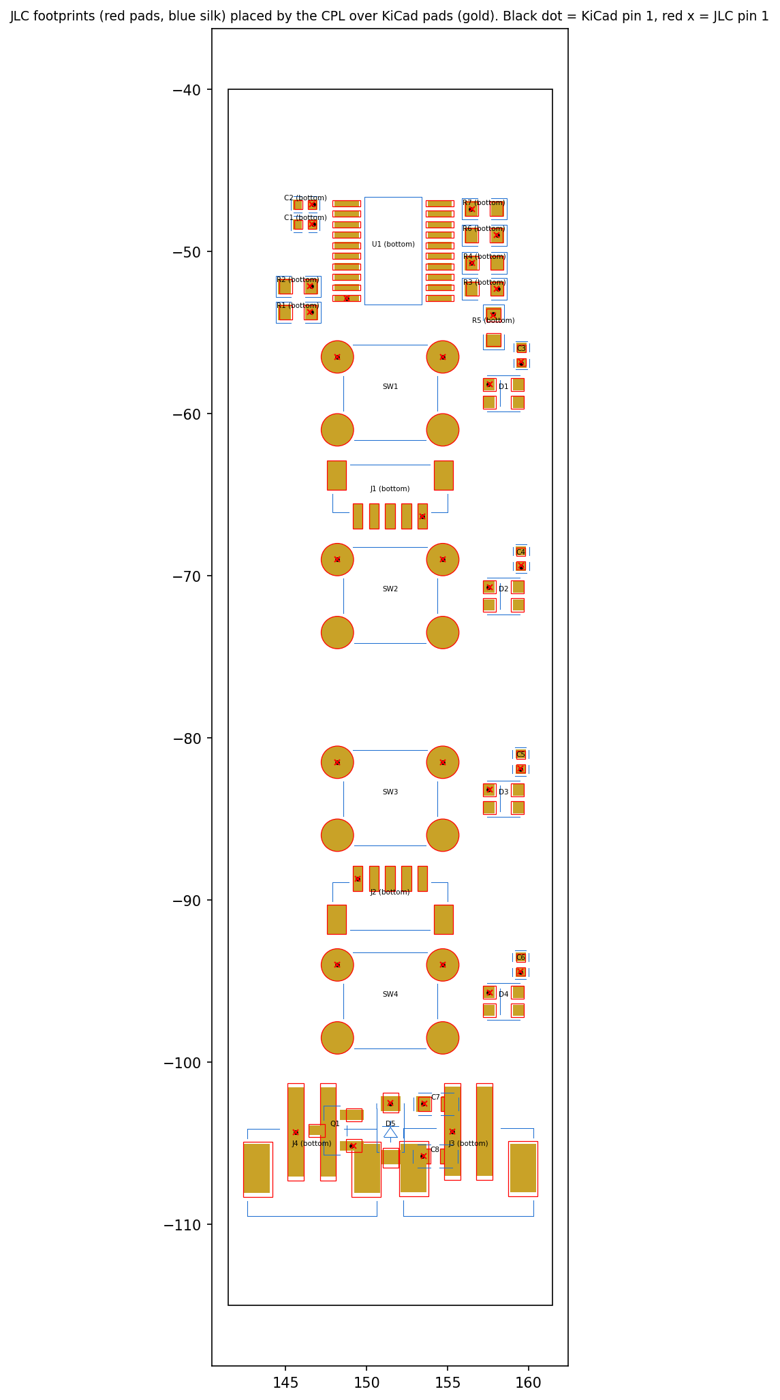
hardware/rodeo-button-bank-4/jlcpcb/placement-check.png
