dotrodeo/rodeo/hardware/rodeo-button-bank-4/renders/rodeo-button-bank-4-iso.jpg

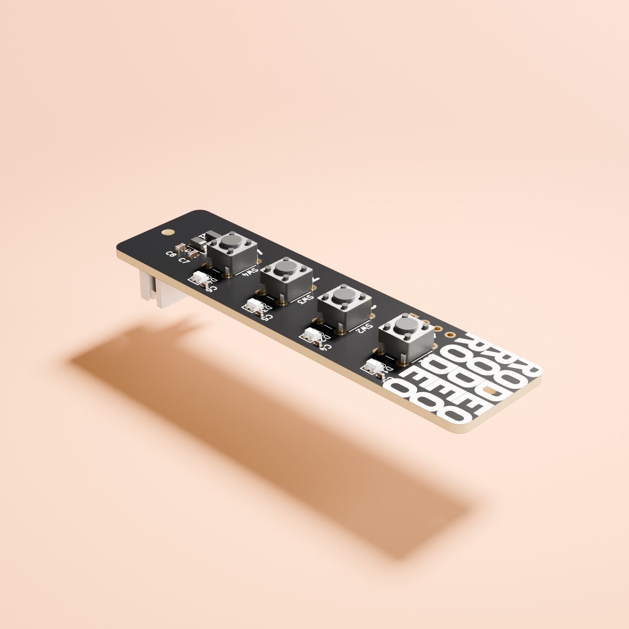
hardware/rodeo-button-bank-4/renders/rodeo-button-bank-4-iso.jpg
