dotrodeo/rodeo/hardware/rodeo-encoder-1/jlcpcb-panel/placement-check.png

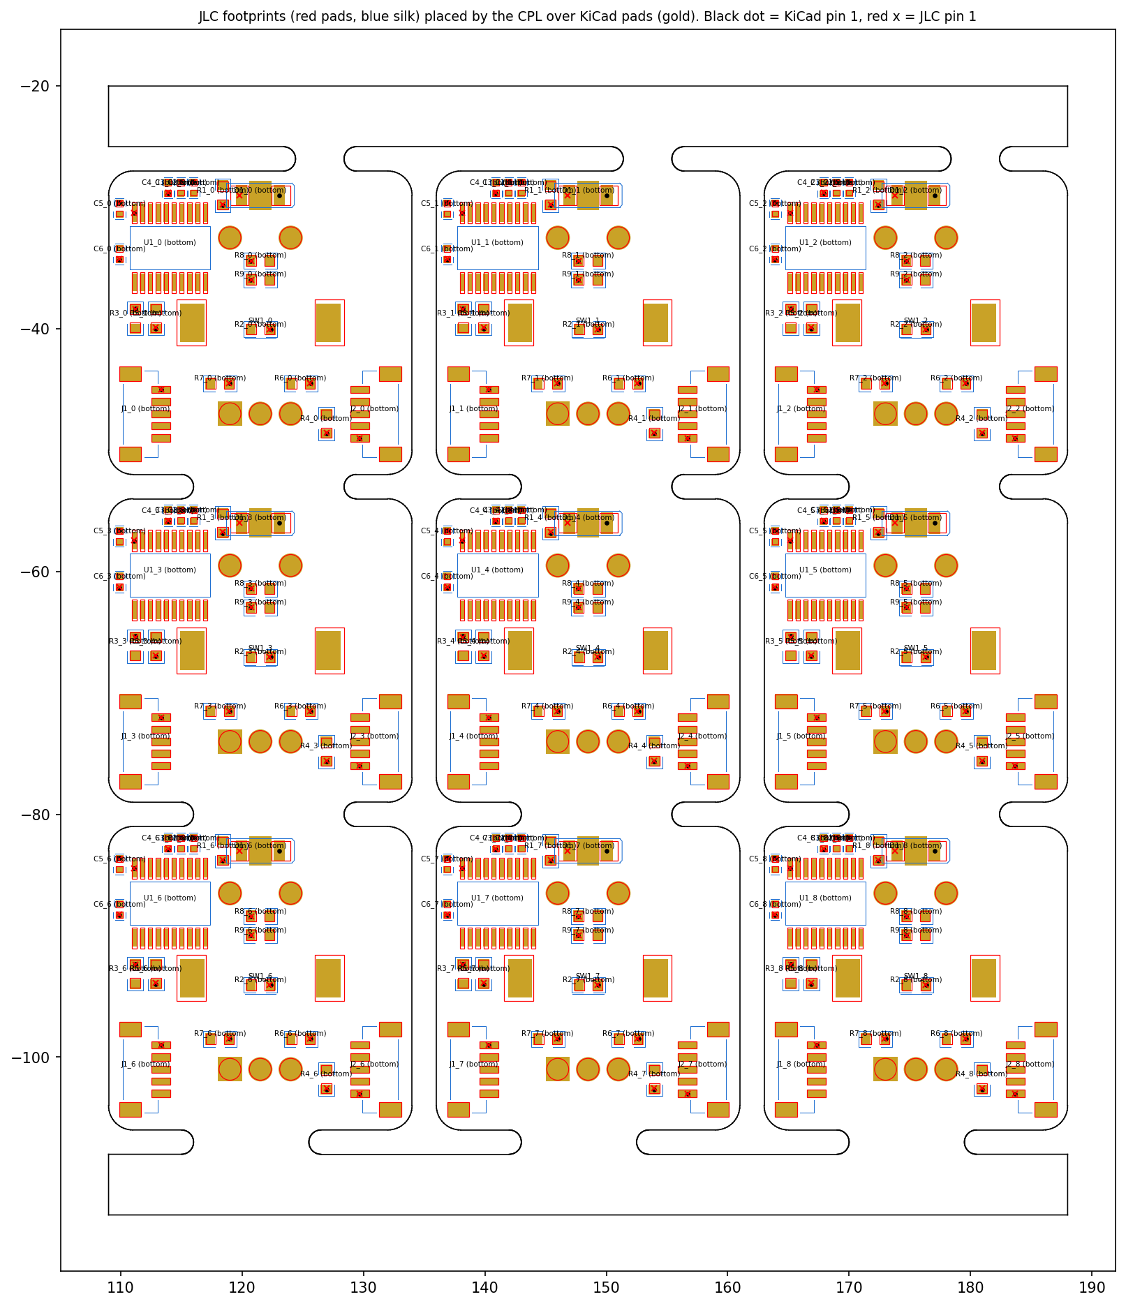
hardware/rodeo-encoder-1/jlcpcb-panel/placement-check.png
