dotrodeo/rodeo/hardware/rodeo-encoder-1/jlcpcb/placement-check.png

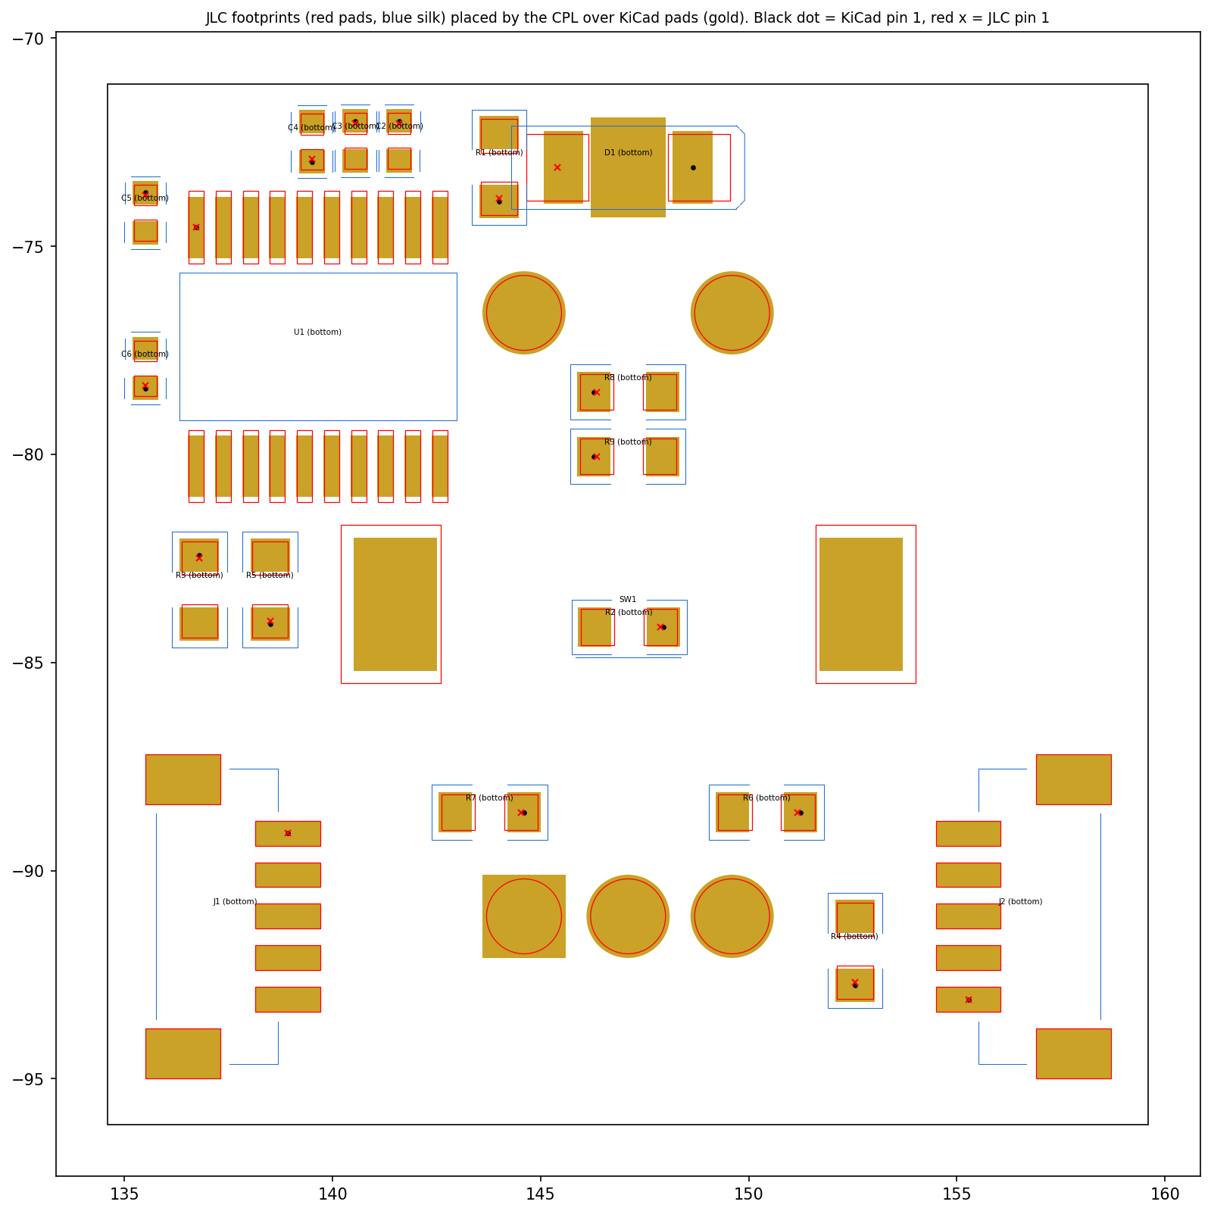
hardware/rodeo-encoder-1/jlcpcb/placement-check.png
