dotrodeo/rodeo/hardware/rodeo-encoder-1/renders/rodeo-encoder-1-back.jpg

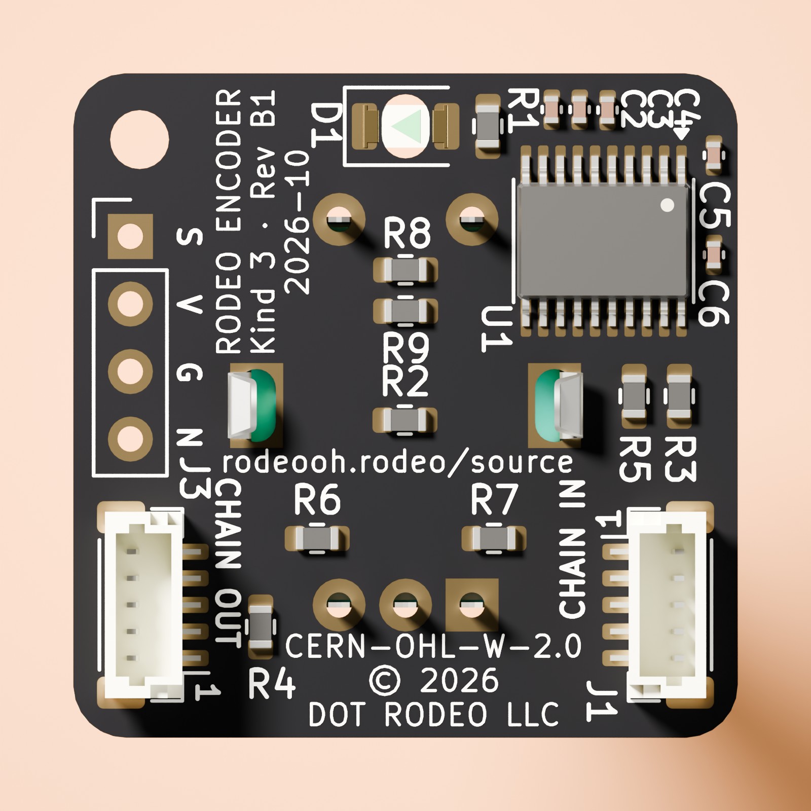
hardware/rodeo-encoder-1/renders/rodeo-encoder-1-back.jpg
