dotrodeo/rodeo/hardware/rodeo-encoder-1/renders/rodeo-encoder-1-front.jpg

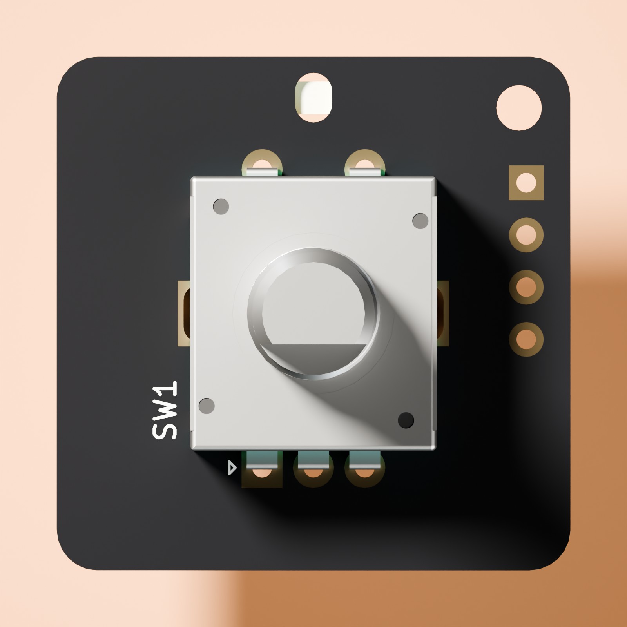
hardware/rodeo-encoder-1/renders/rodeo-encoder-1-front.jpg
