dotrodeo/rodeo/hardware/rodeo-encoder-1/renders/rodeo-encoder-1-iso.jpg

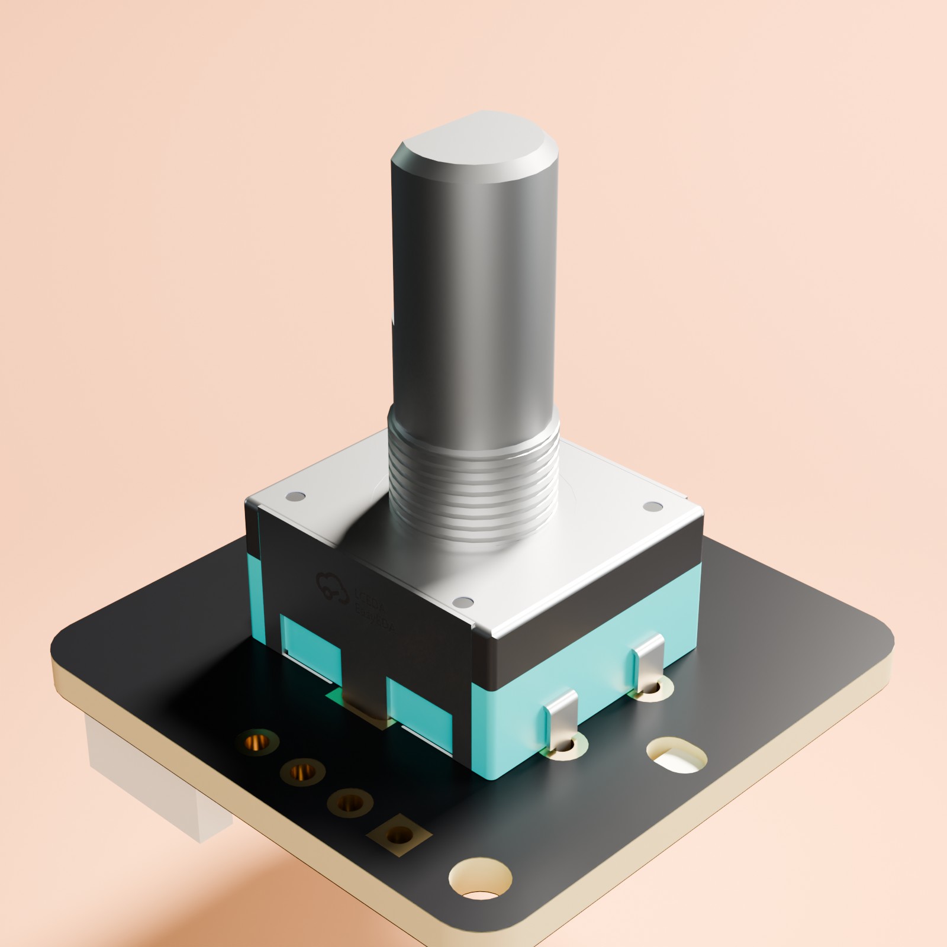
hardware/rodeo-encoder-1/renders/rodeo-encoder-1-iso.jpg
