dotrodeo/rodeo/hardware/rodeo-encoder-bank-4/jlcpcb-panel/placement-check.png

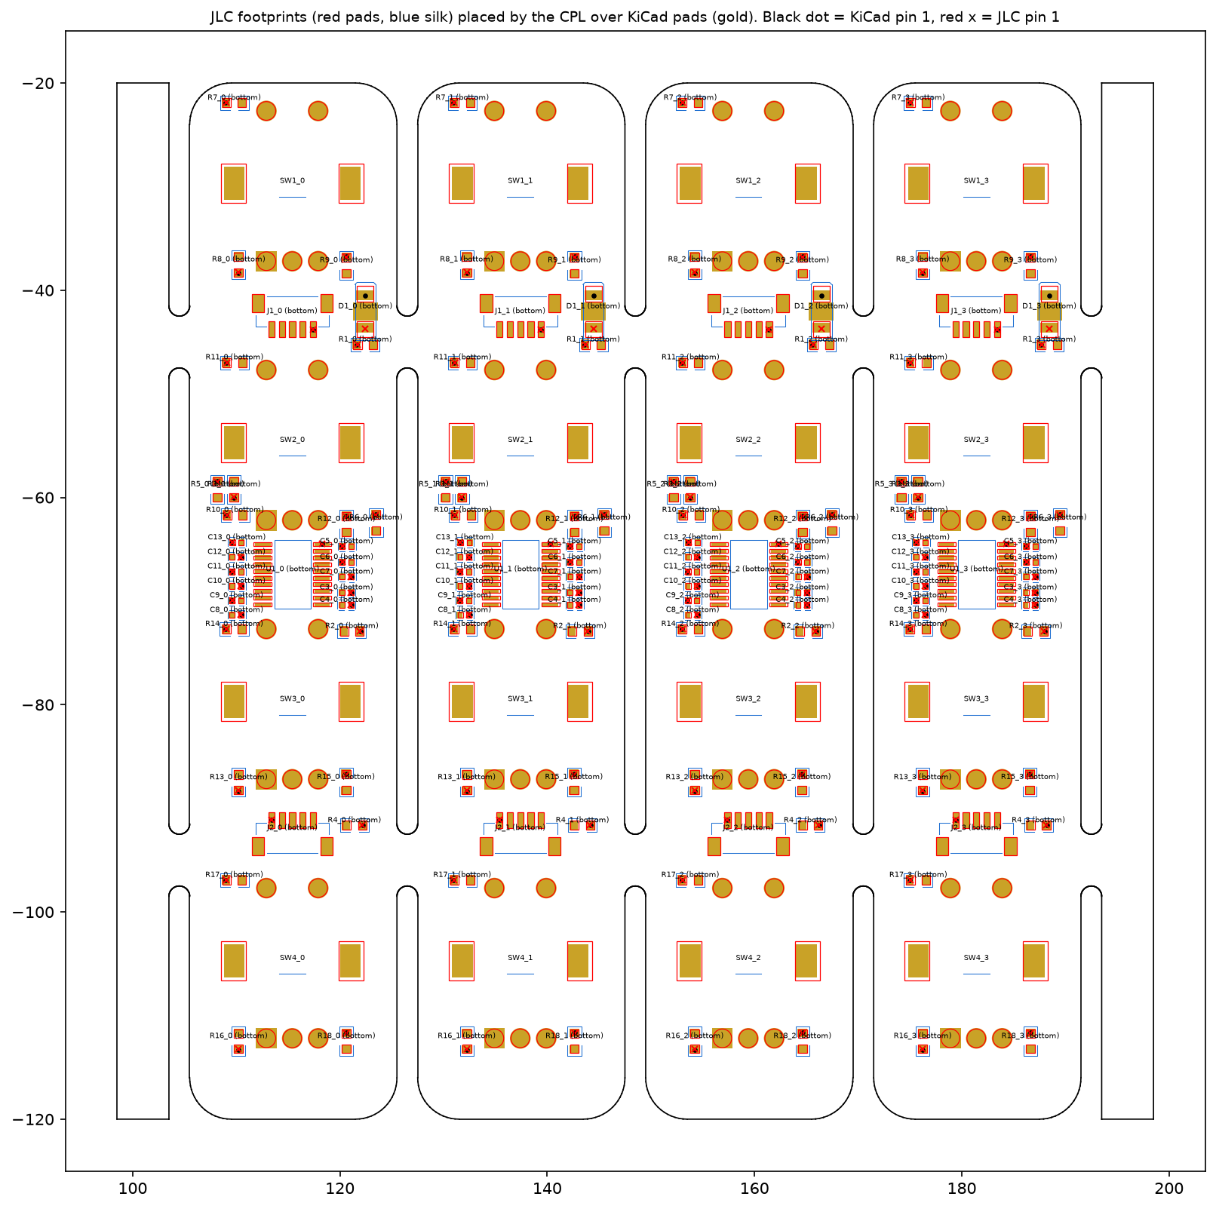
hardware/rodeo-encoder-bank-4/jlcpcb-panel/placement-check.png
