dotrodeo/rodeo/hardware/rodeo-encoder-bank-4/jlcpcb/placement-check.png

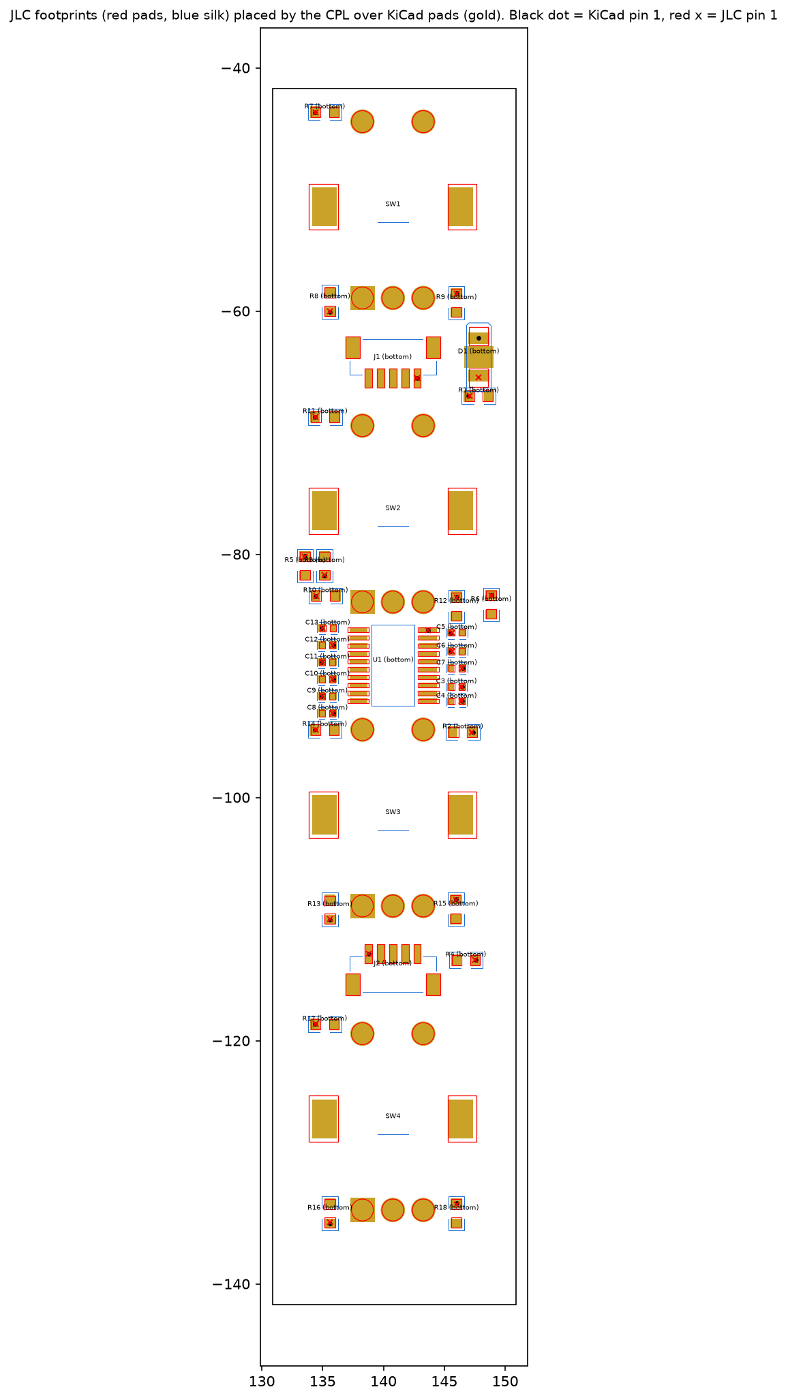
hardware/rodeo-encoder-bank-4/jlcpcb/placement-check.png
