dotrodeo/rodeo/hardware/rodeo-encoder-bank-4/renders/rodeo-encoder-bank-4-back.jpg

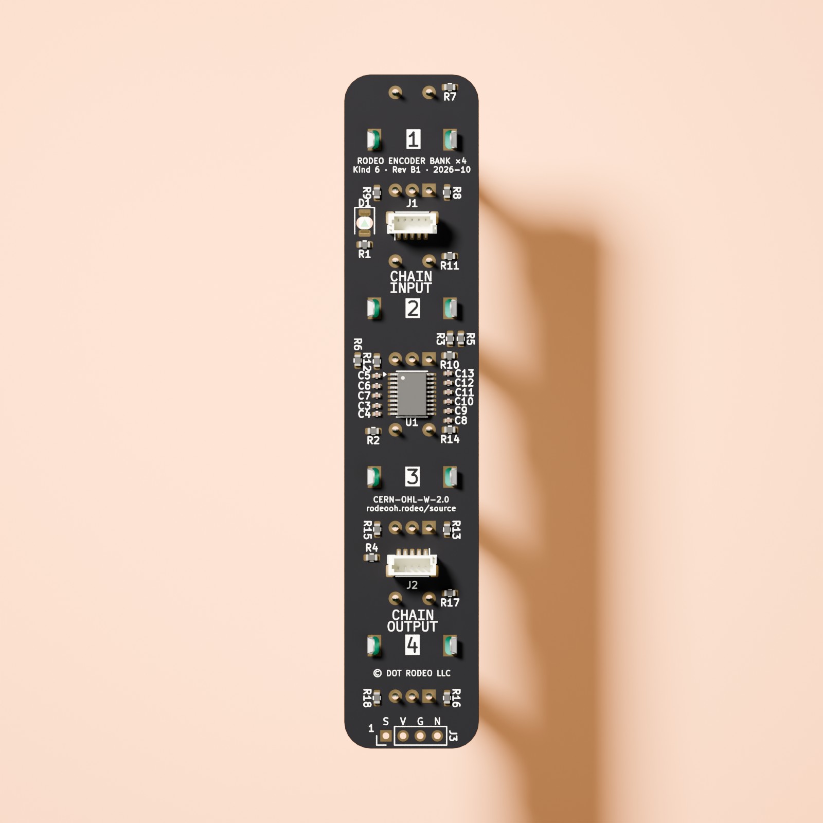
hardware/rodeo-encoder-bank-4/renders/rodeo-encoder-bank-4-back.jpg
