dotrodeo/rodeo/hardware/rodeo-midi/jlcpcb-panel/placement-check.png

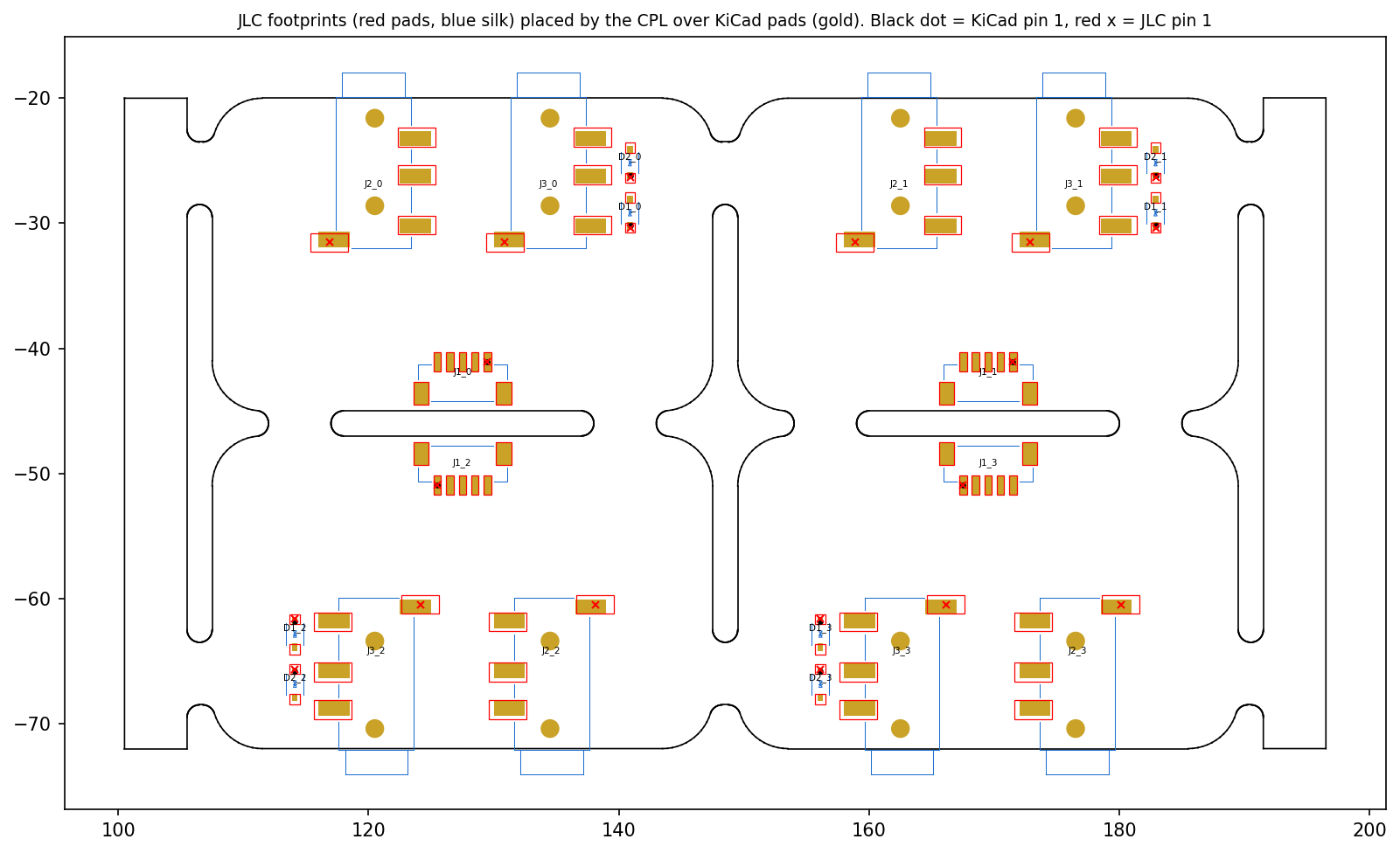
hardware/rodeo-midi/jlcpcb-panel/placement-check.png
