dotrodeo/rodeo/hardware/rodeo-midi/jlcpcb/placement-check.png

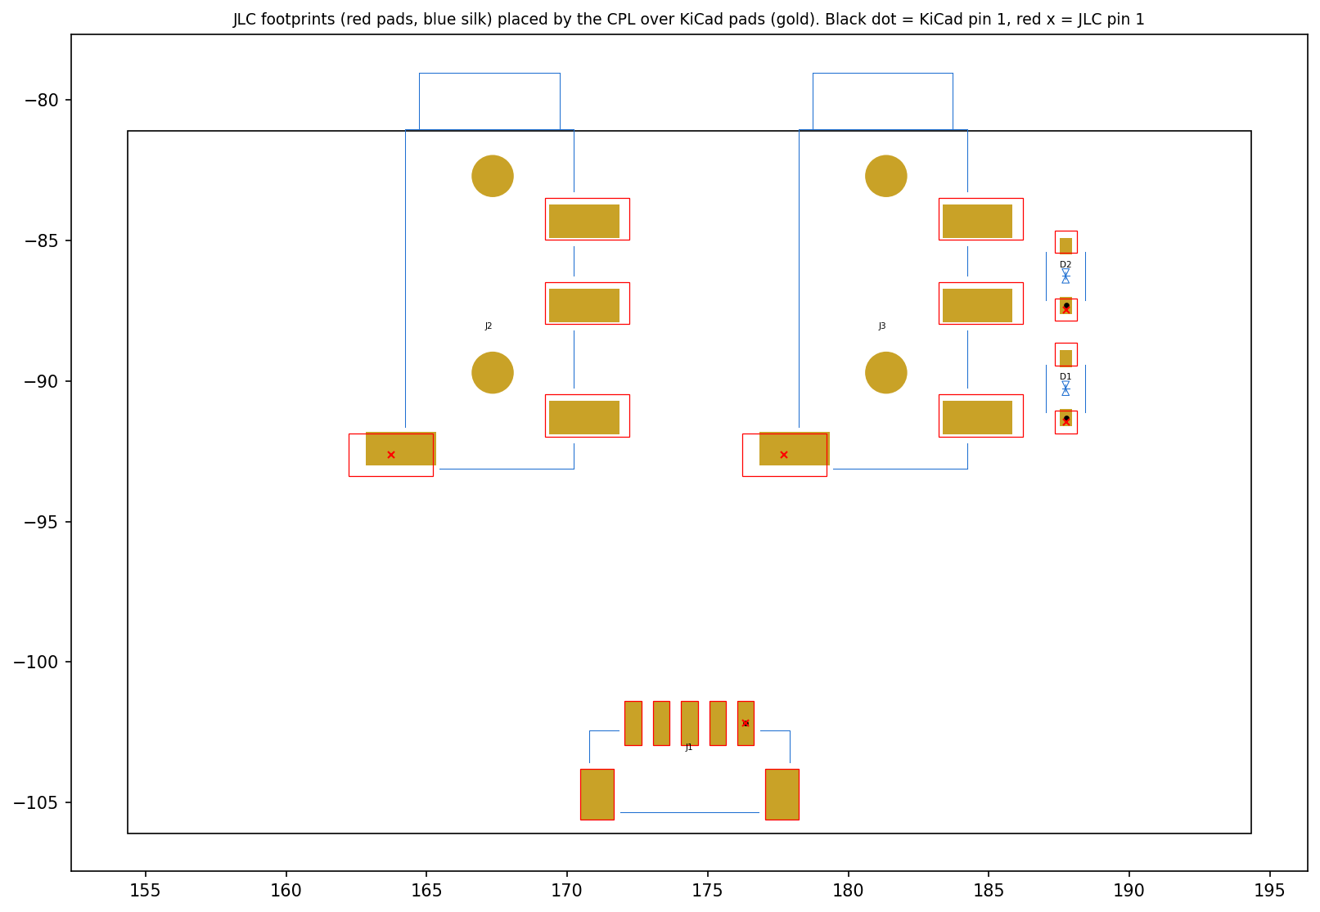
hardware/rodeo-midi/jlcpcb/placement-check.png
