dotrodeo/rodeo/hardware/rodeo-midi/renders/rodeo-midi-back.jpg

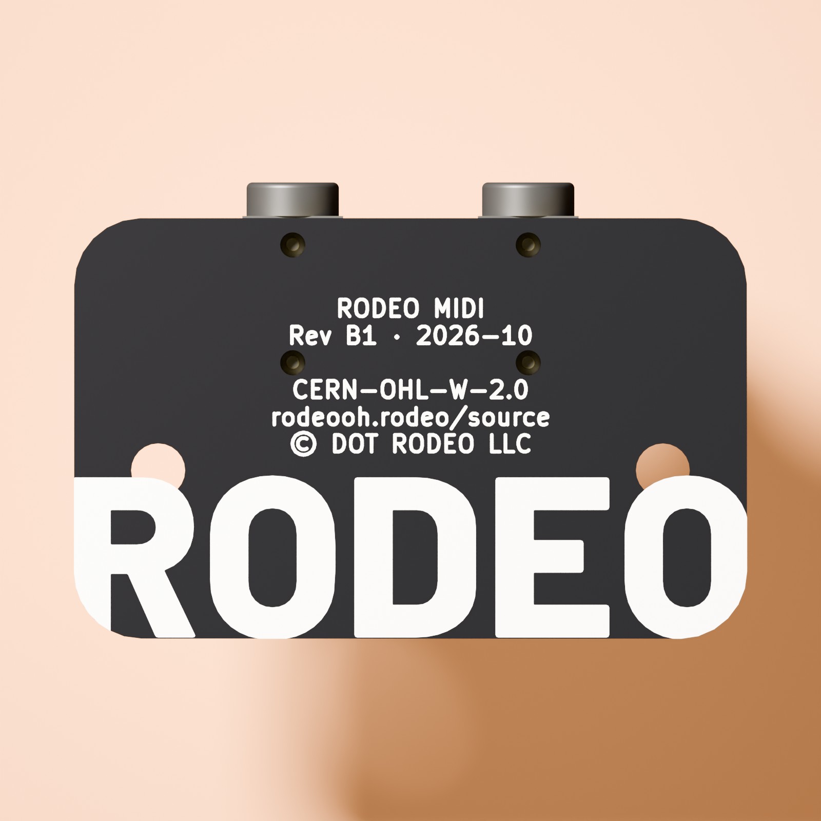
hardware/rodeo-midi/renders/rodeo-midi-back.jpg
