dotrodeo/rodeo/hardware/rodeo-midi/renders/rodeo-midi-front.jpg

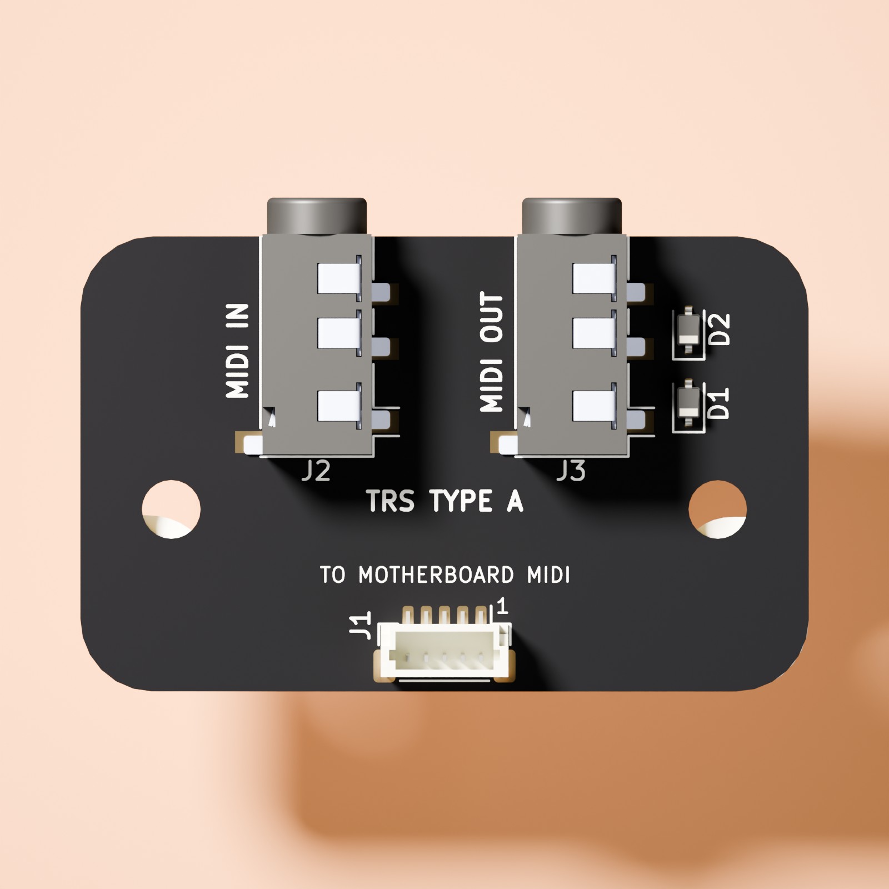
hardware/rodeo-midi/renders/rodeo-midi-front.jpg
