dotrodeo/rodeo/hardware/rodeo-midi/renders/rodeo-midi-iso.jpg

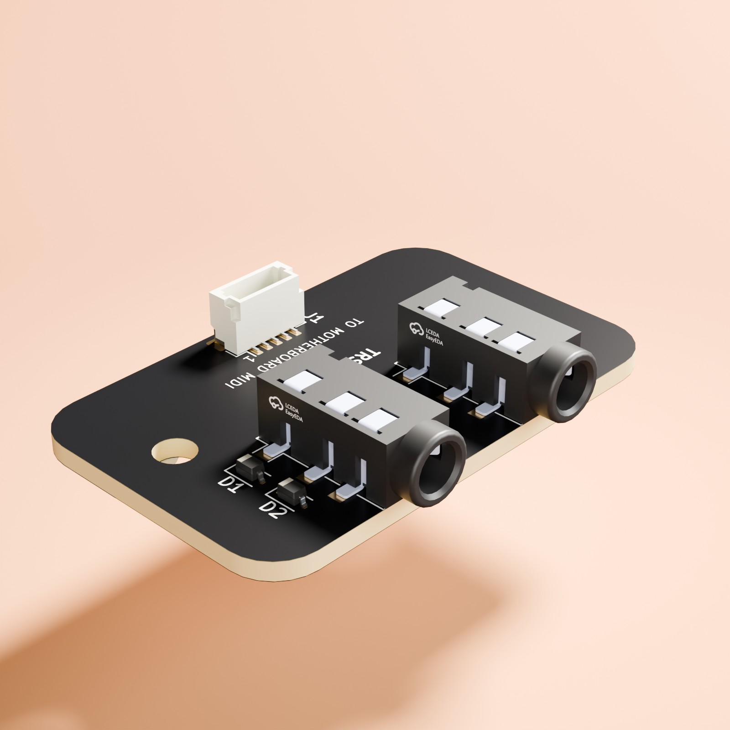
hardware/rodeo-midi/renders/rodeo-midi-iso.jpg
