dotrodeo/rodeo/hardware/rodeo-motherboard/jlcpcb-panel/placement-check.png

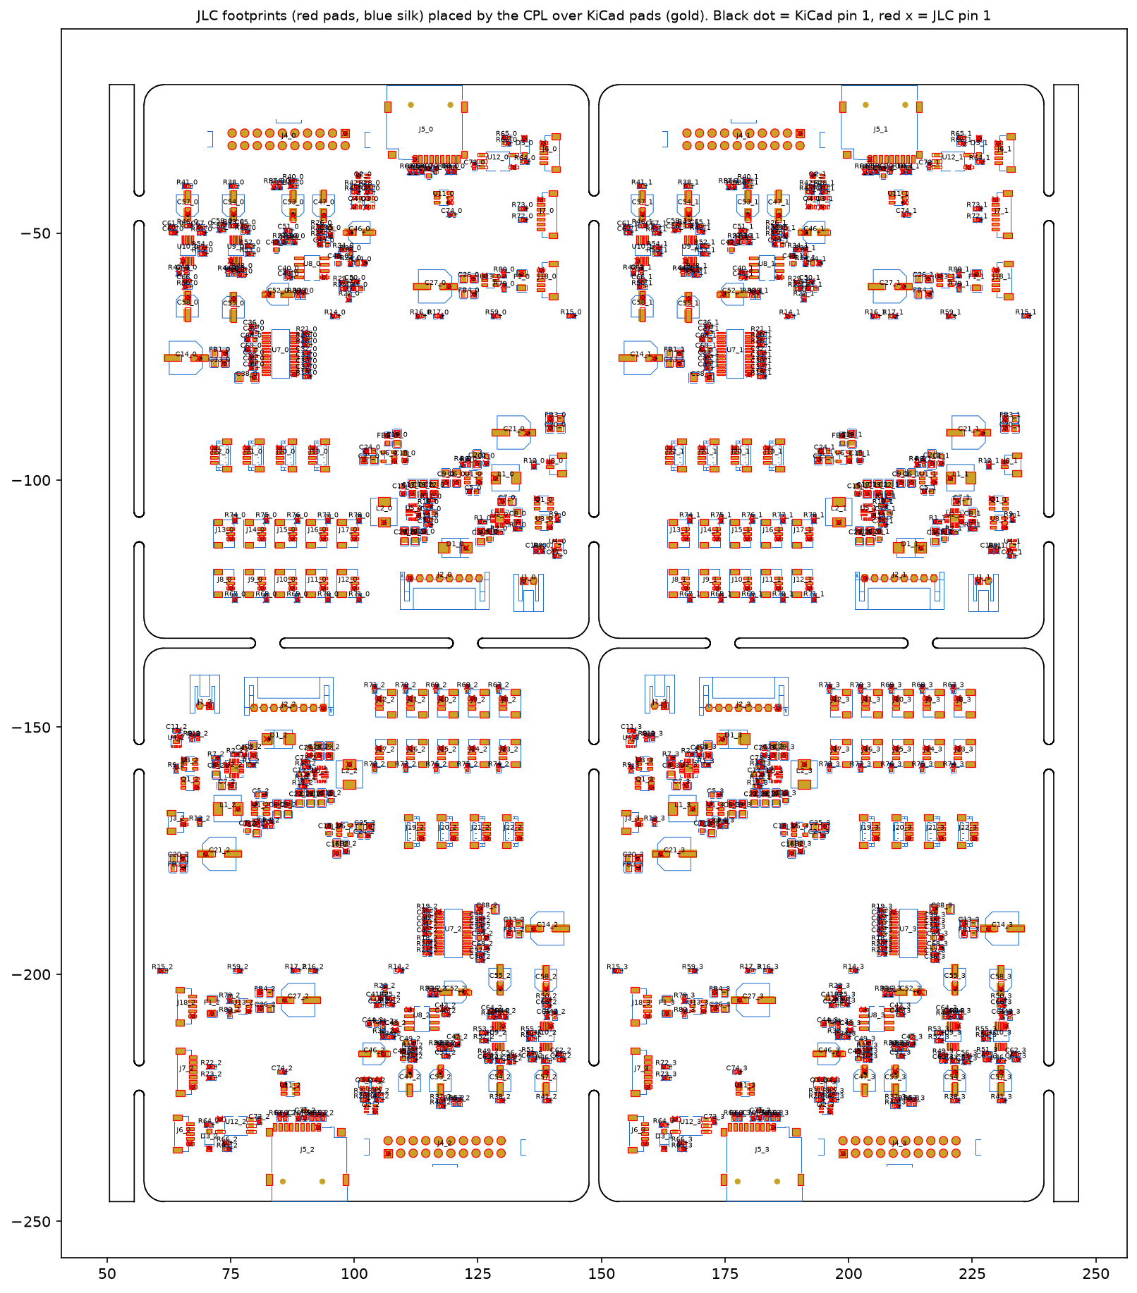
hardware/rodeo-motherboard/jlcpcb-panel/placement-check.png
