dotrodeo/rodeo/hardware/rodeo-motherboard/jlcpcb/placement-check.png

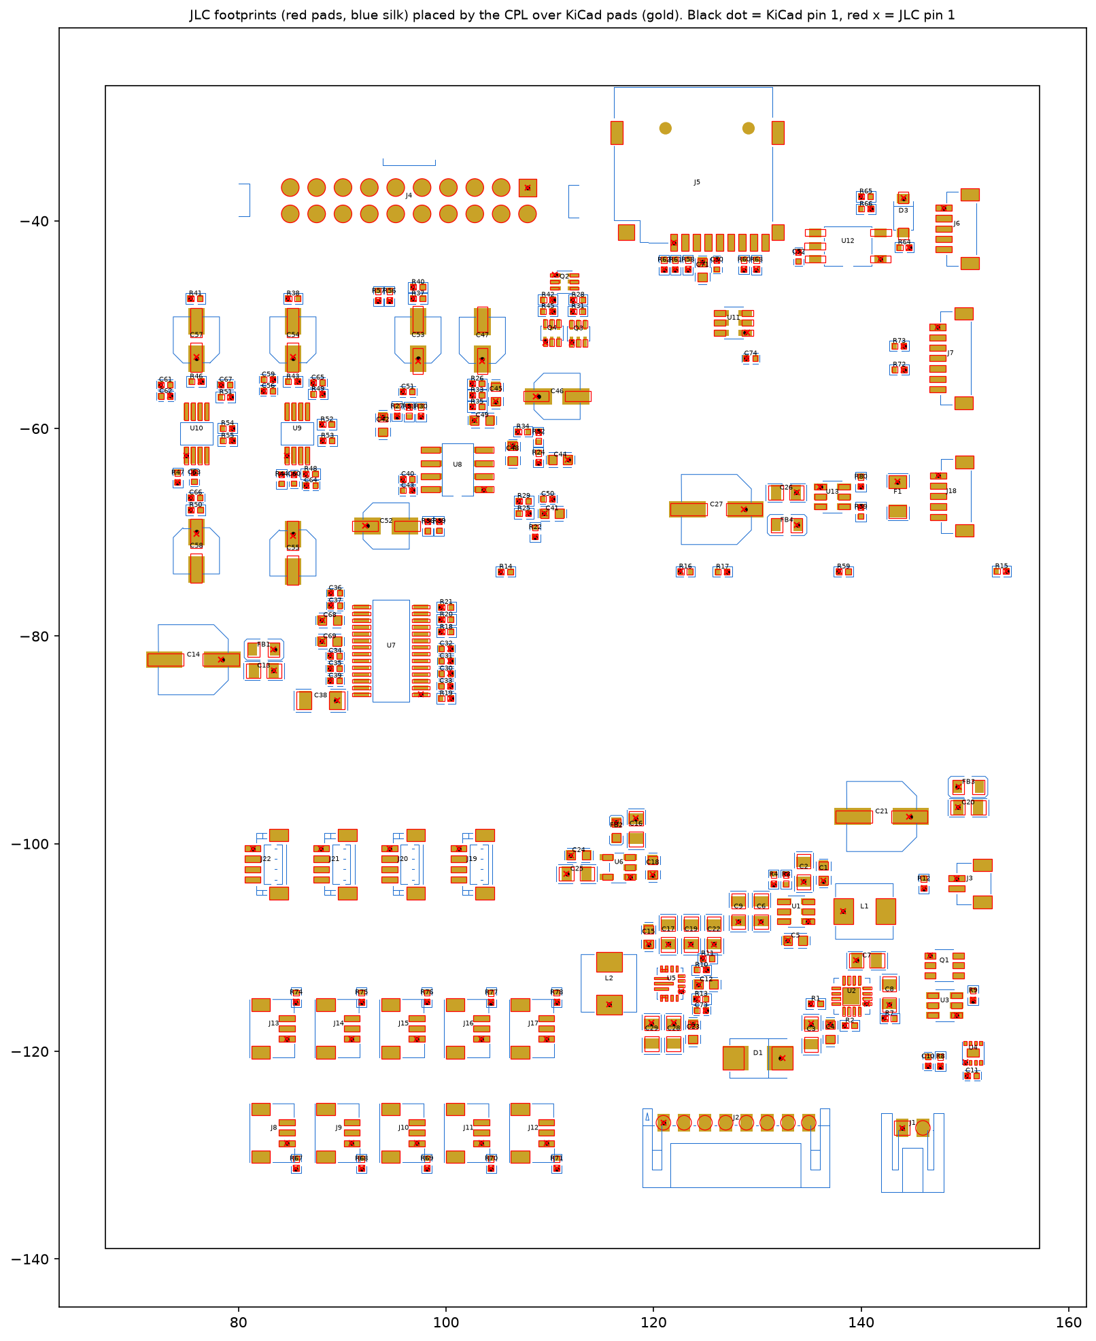
hardware/rodeo-motherboard/jlcpcb/placement-check.png
