dotrodeo/rodeo/hardware/rodeo-motherboard/renders/rodeo-motherboard-back.jpg

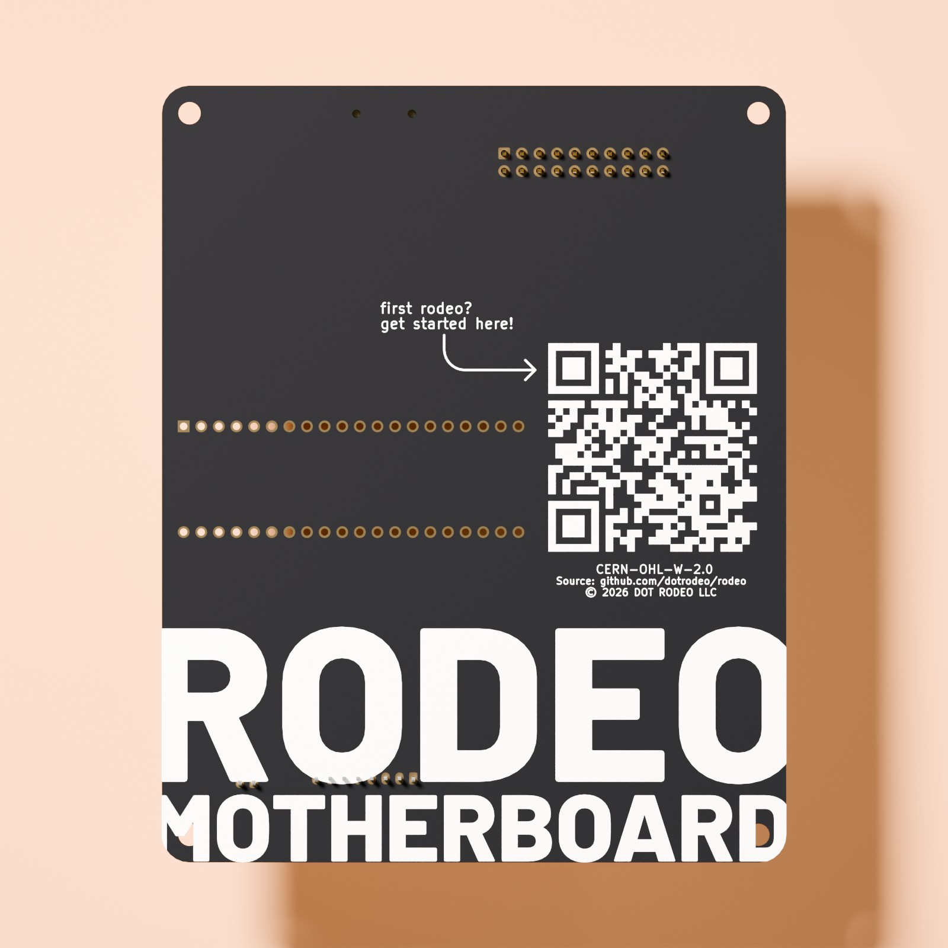
hardware/rodeo-motherboard/renders/rodeo-motherboard-back.jpg
