dotrodeo/rodeo/hardware/rodeo-motherboard/renders/rodeo-motherboard-iso.jpg

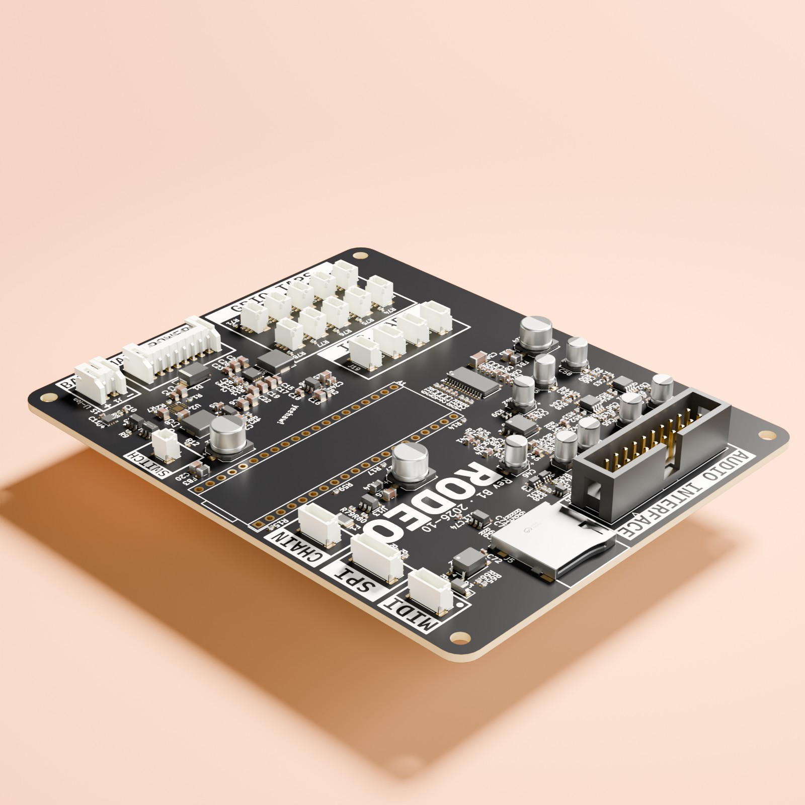
hardware/rodeo-motherboard/renders/rodeo-motherboard-iso.jpg
