dotrodeo/rodeo/hardware/rodeo-motherboard/renders/rodeo-motherboard-wide.jpg

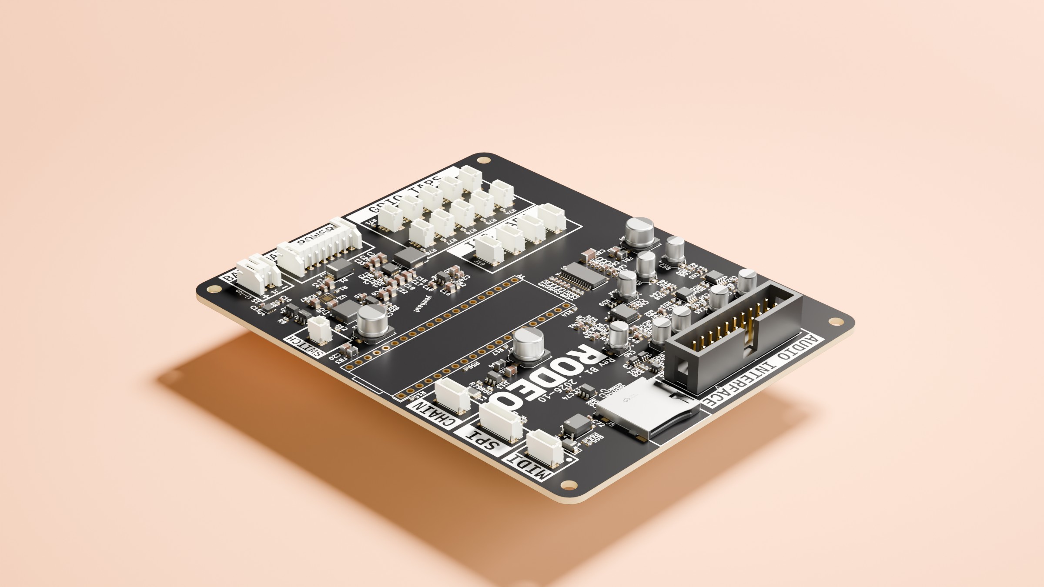
hardware/rodeo-motherboard/renders/rodeo-motherboard-wide.jpg
