dotrodeo/rodeo/hardware/rodeo-pot-1/jlcpcb-panel/placement-check.png

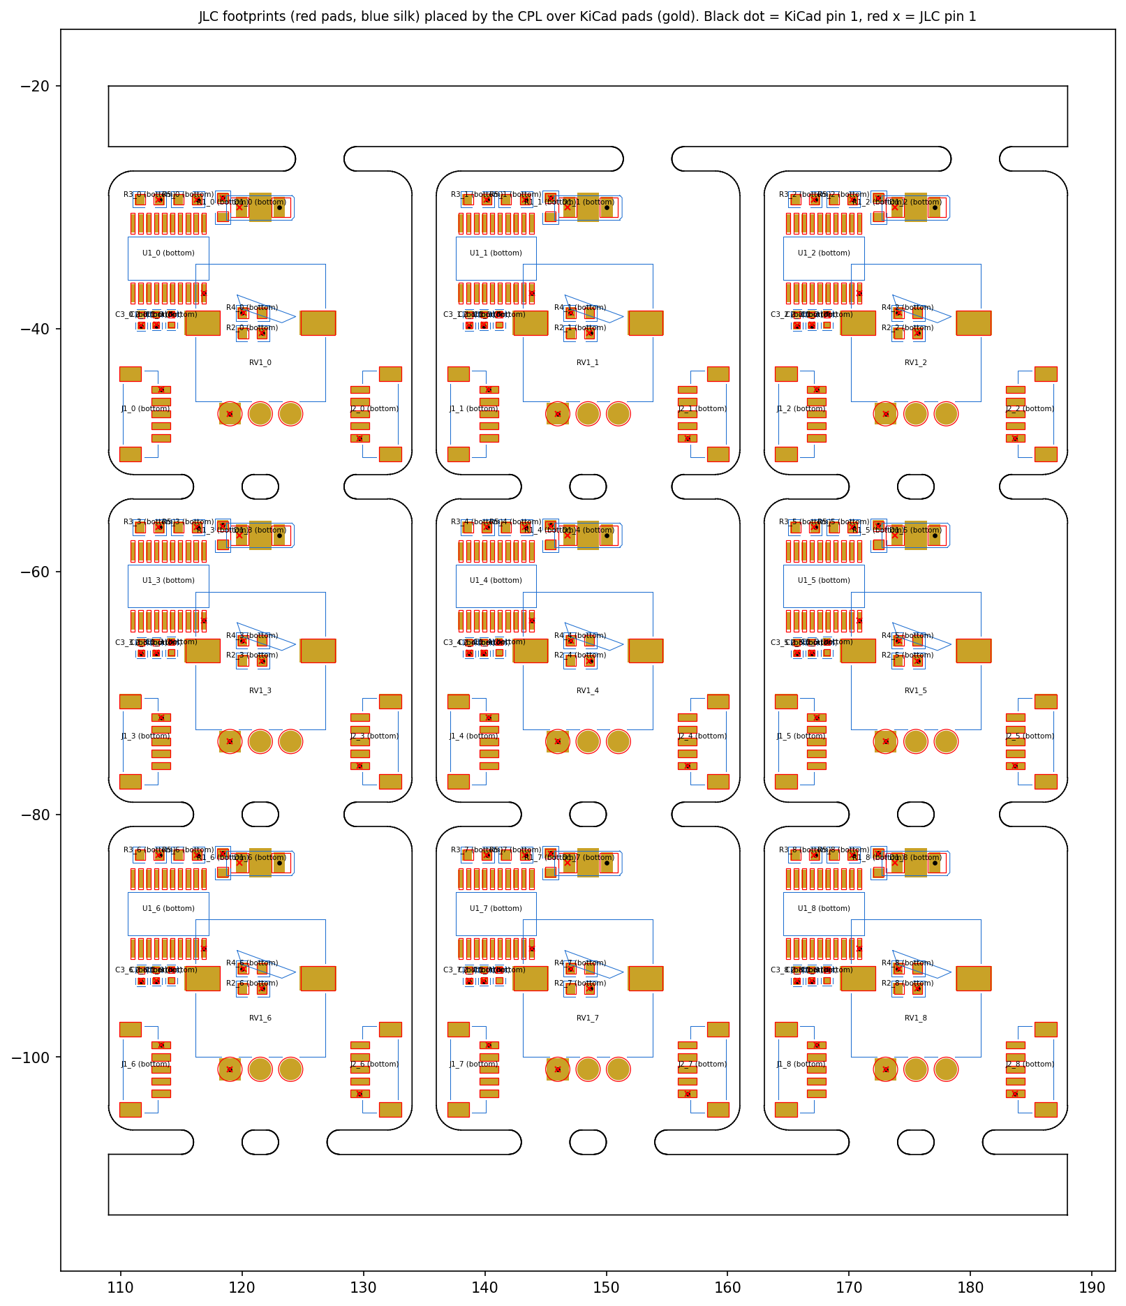
hardware/rodeo-pot-1/jlcpcb-panel/placement-check.png
