dotrodeo/rodeo/hardware/rodeo-pot-1/jlcpcb/placement-check.png

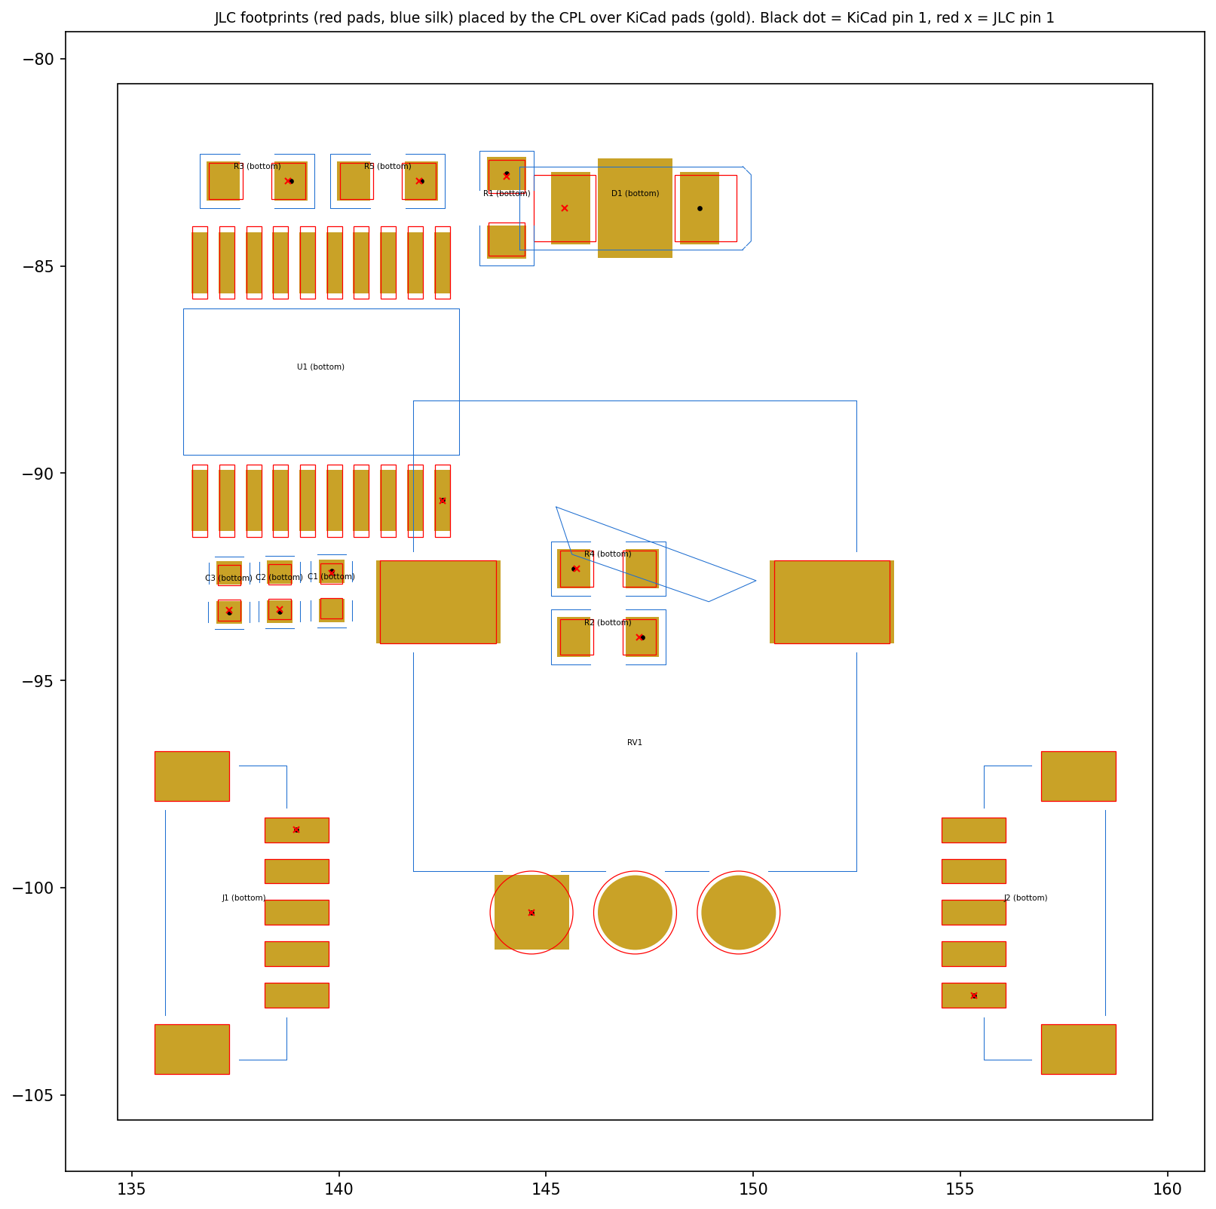
hardware/rodeo-pot-1/jlcpcb/placement-check.png
