dotrodeo/rodeo/hardware/rodeo-pot-1/renders/rodeo-pot-1-back.jpg

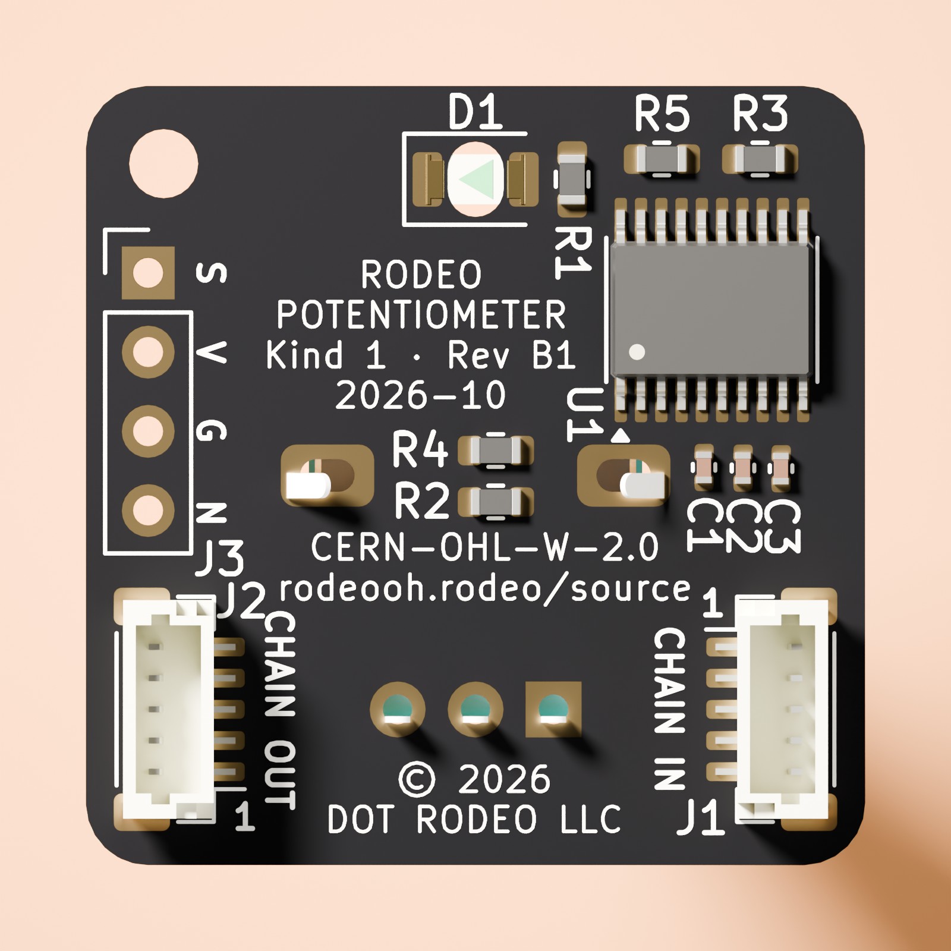
hardware/rodeo-pot-1/renders/rodeo-pot-1-back.jpg
