dotrodeo/rodeo/hardware/rodeo-pot-1/renders/rodeo-pot-1-front.jpg

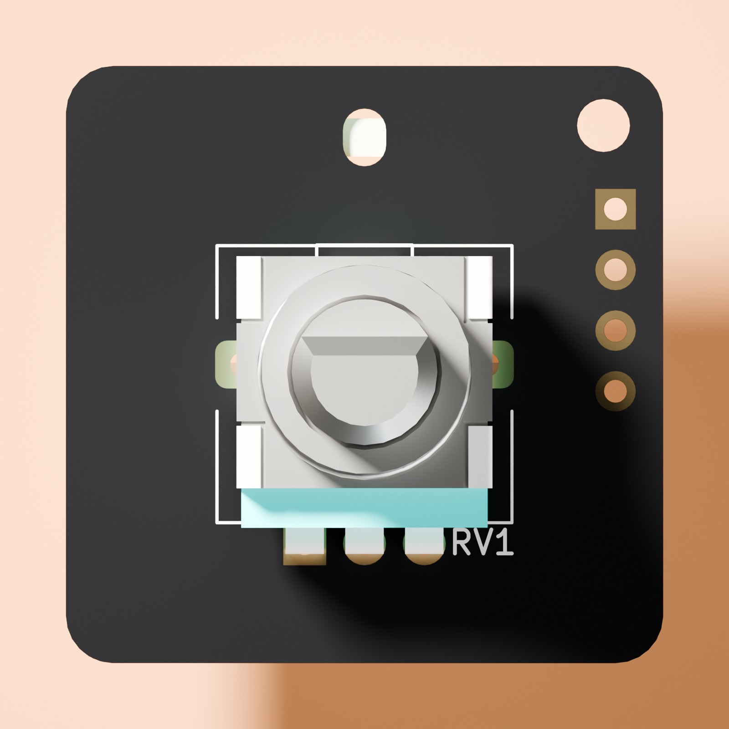
hardware/rodeo-pot-1/renders/rodeo-pot-1-front.jpg
