dotrodeo/rodeo/hardware/rodeo-pot-1/renders/rodeo-pot-1-iso.jpg

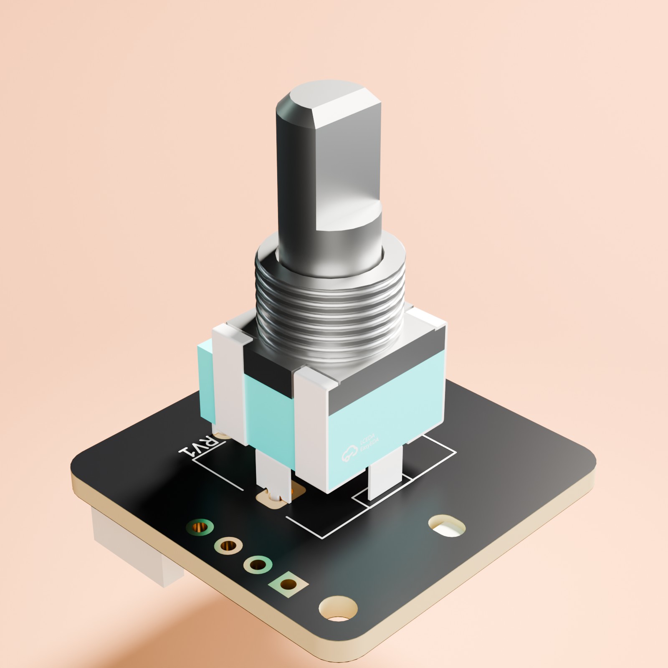
hardware/rodeo-pot-1/renders/rodeo-pot-1-iso.jpg
