dotrodeo/rodeo/hardware/rodeo-pot-bank-4/jlcpcb-panel/placement-check.png

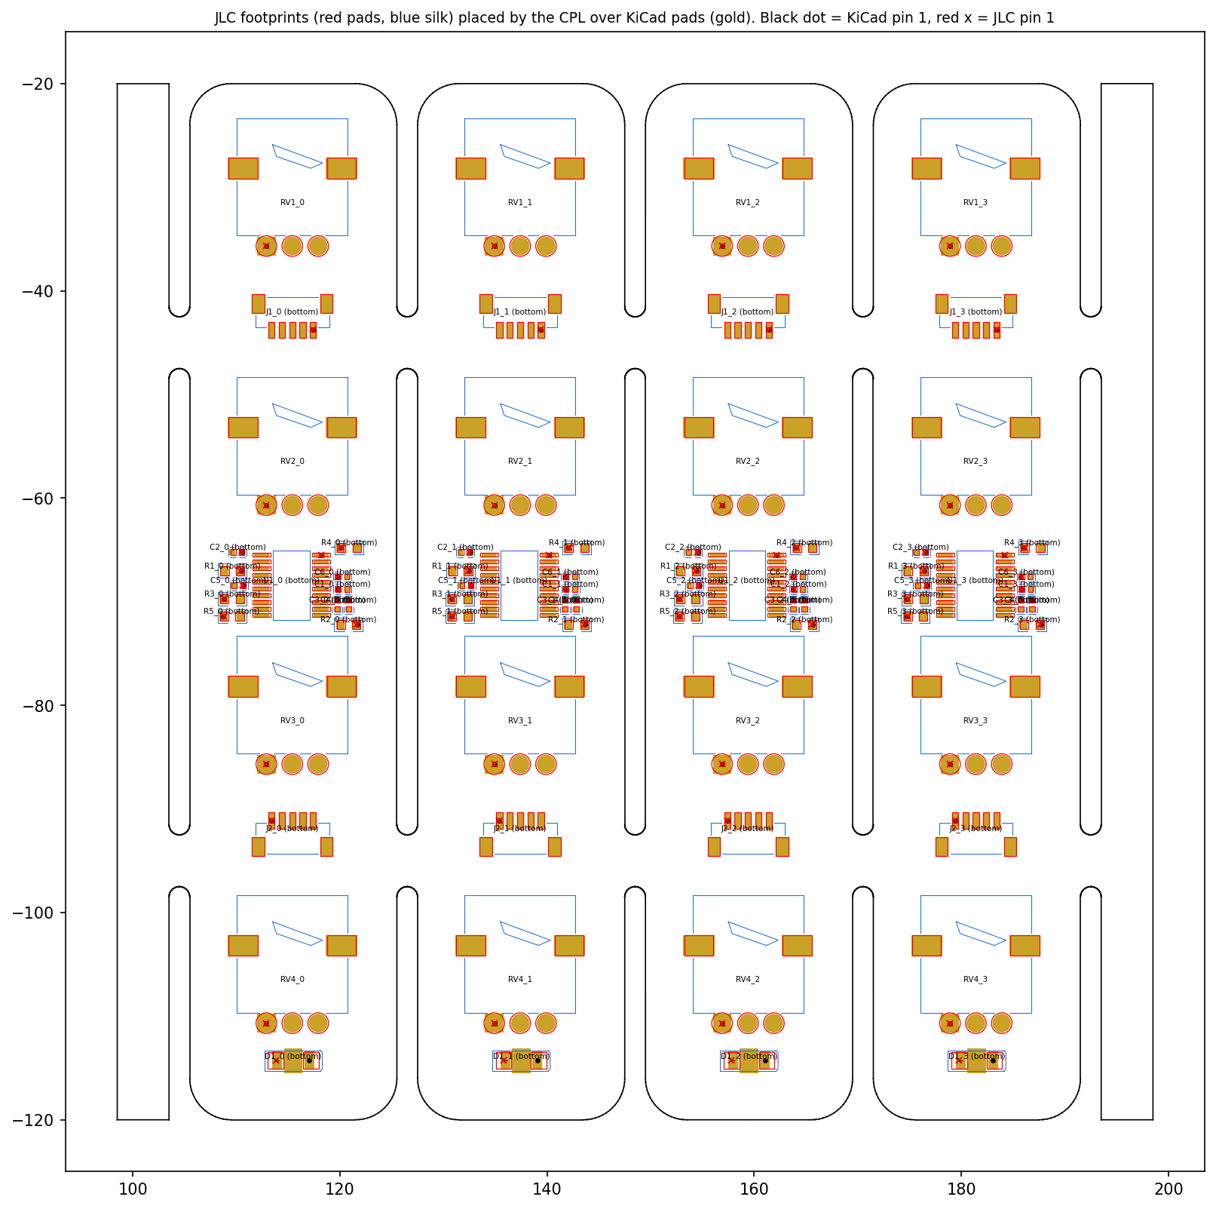
hardware/rodeo-pot-bank-4/jlcpcb-panel/placement-check.png
