dotrodeo/rodeo/hardware/rodeo-pot-bank-4/jlcpcb/placement-check.png

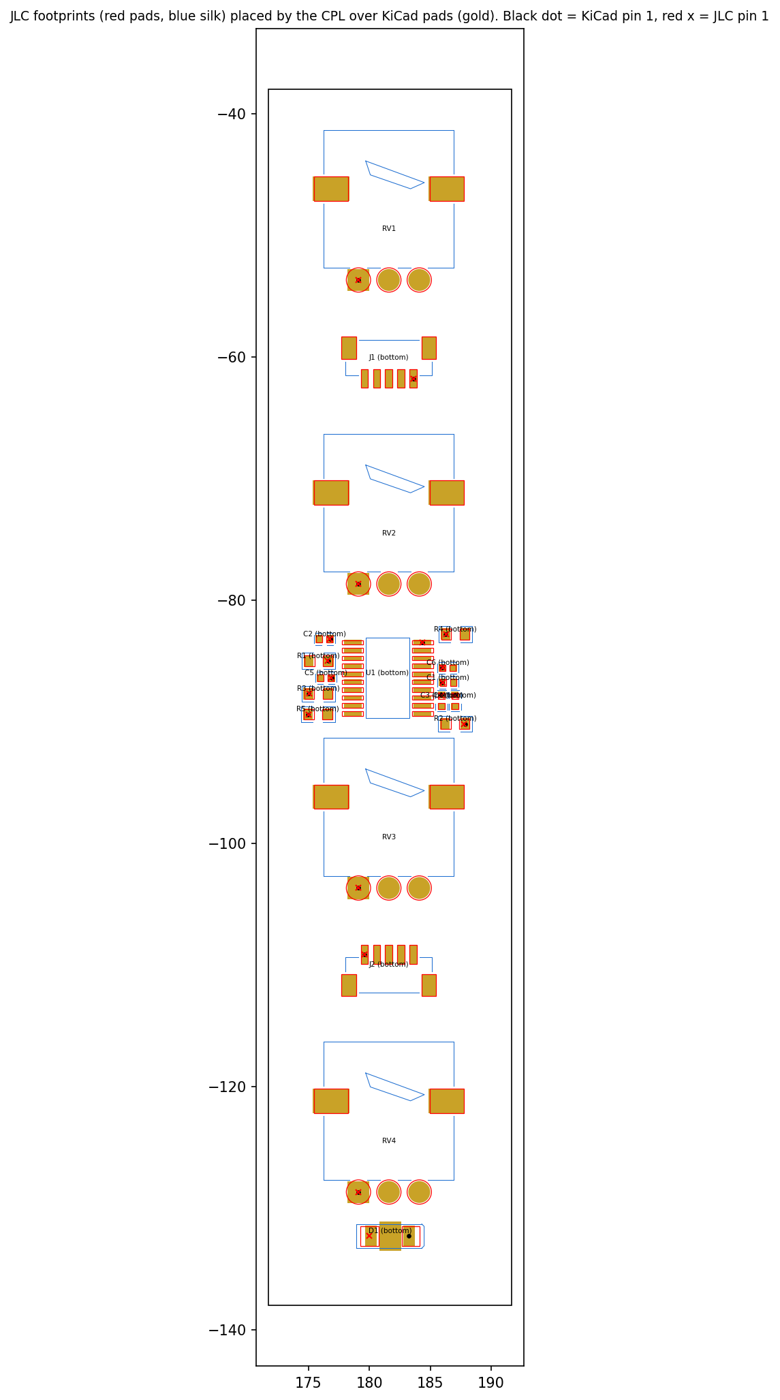
hardware/rodeo-pot-bank-4/jlcpcb/placement-check.png
