dotrodeo/rodeo/hardware/rodeo-pot-bank-4/renders/rodeo-pot-bank-4-back.jpg

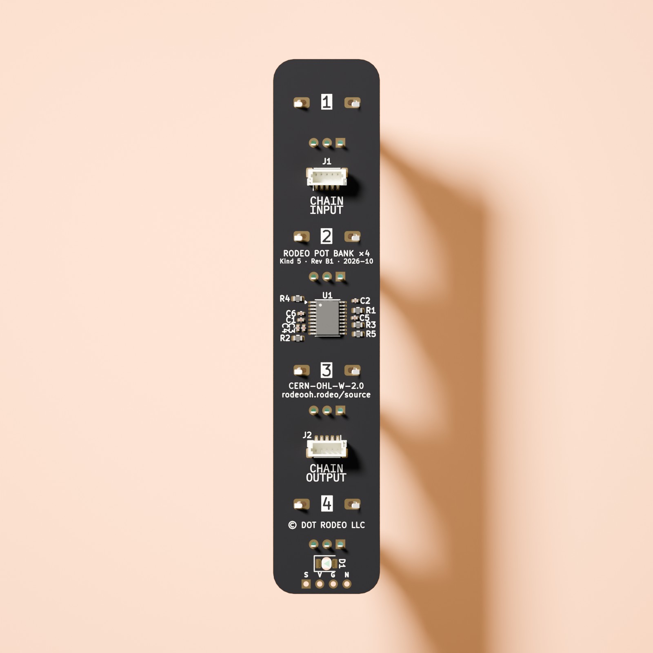
hardware/rodeo-pot-bank-4/renders/rodeo-pot-bank-4-back.jpg
