dotrodeo/rodeo/hardware/rodeo-power-barrel/jlcpcb-panel/placement-check.png

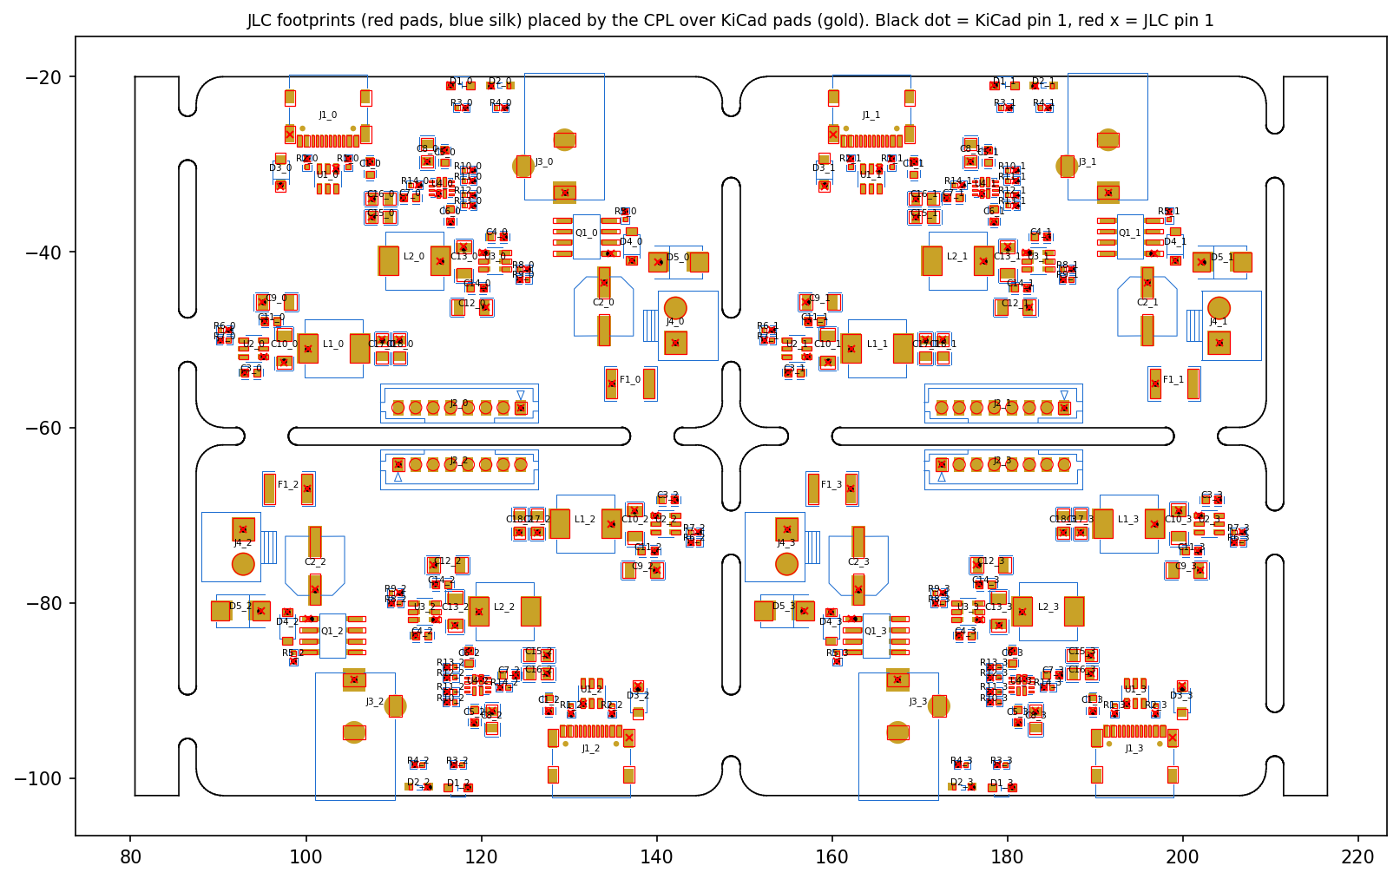
hardware/rodeo-power-barrel/jlcpcb-panel/placement-check.png
