dotrodeo/rodeo/hardware/rodeo-power-barrel/jlcpcb/placement-check.png

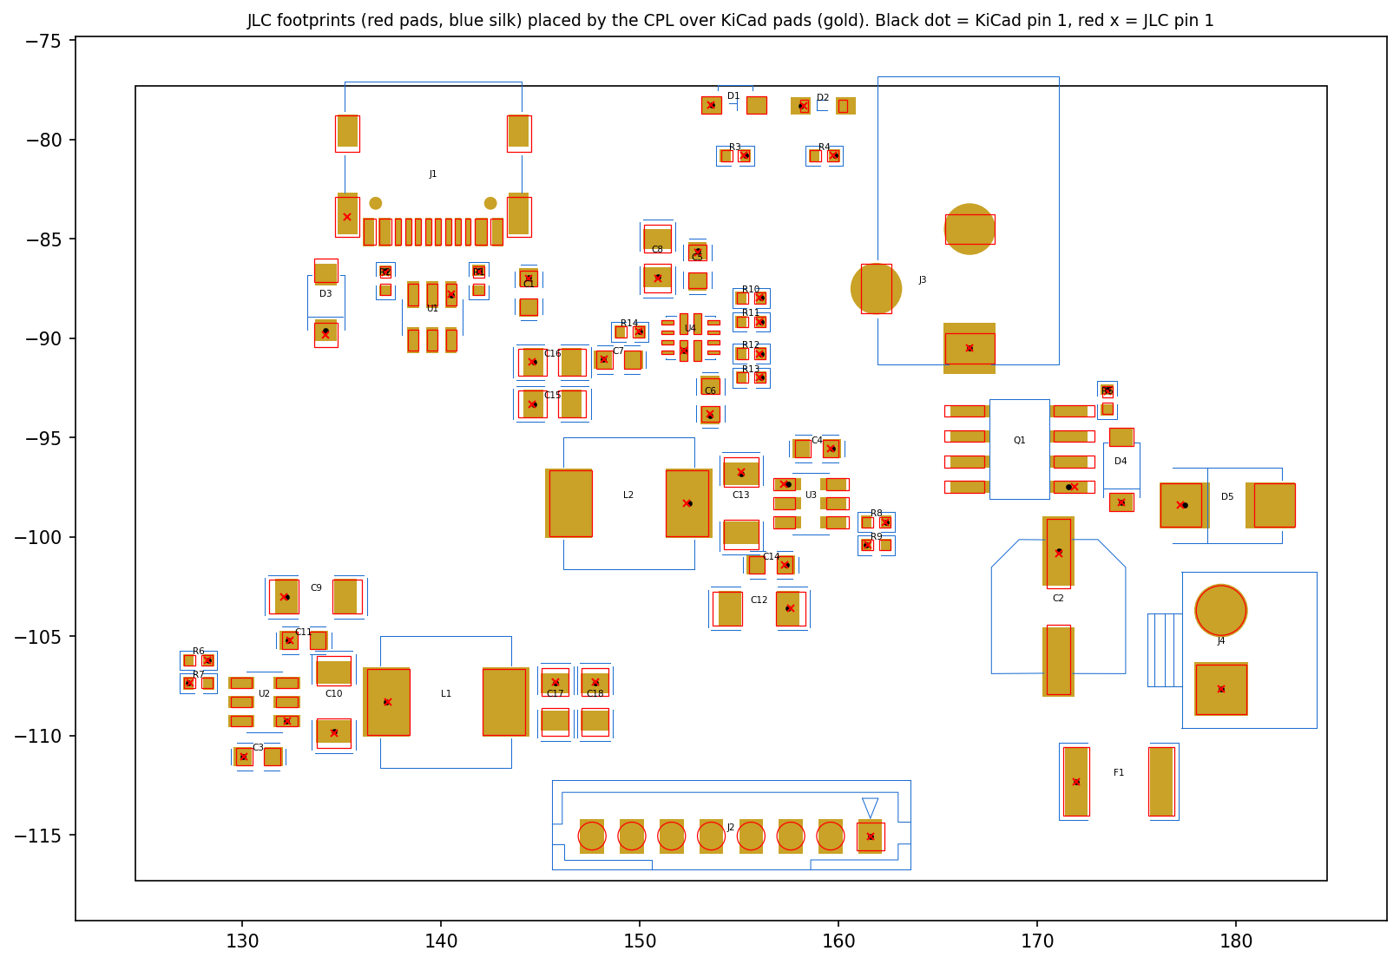
hardware/rodeo-power-barrel/jlcpcb/placement-check.png
