dotrodeo/rodeo/hardware/rodeo-power-barrel/renders/rodeo-power-barrel-back.jpg

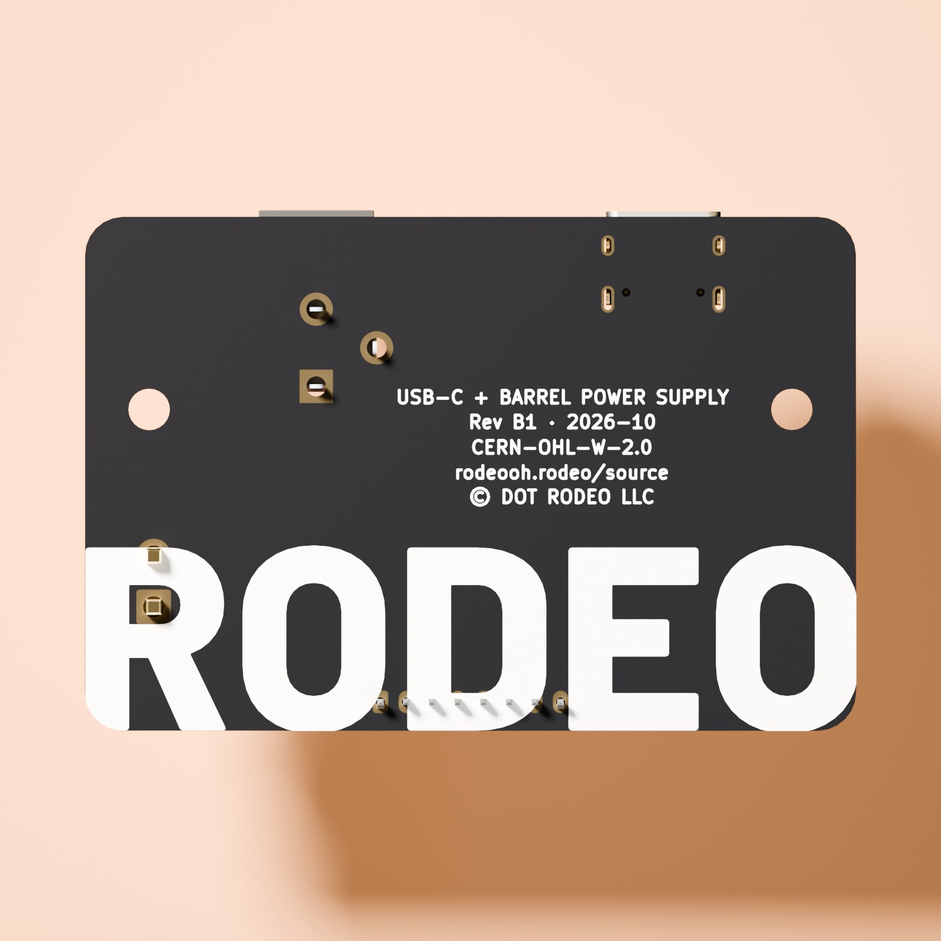
hardware/rodeo-power-barrel/renders/rodeo-power-barrel-back.jpg
