dotrodeo/rodeo/hardware/rodeo-power-barrel/renders/rodeo-power-barrel-front.jpg

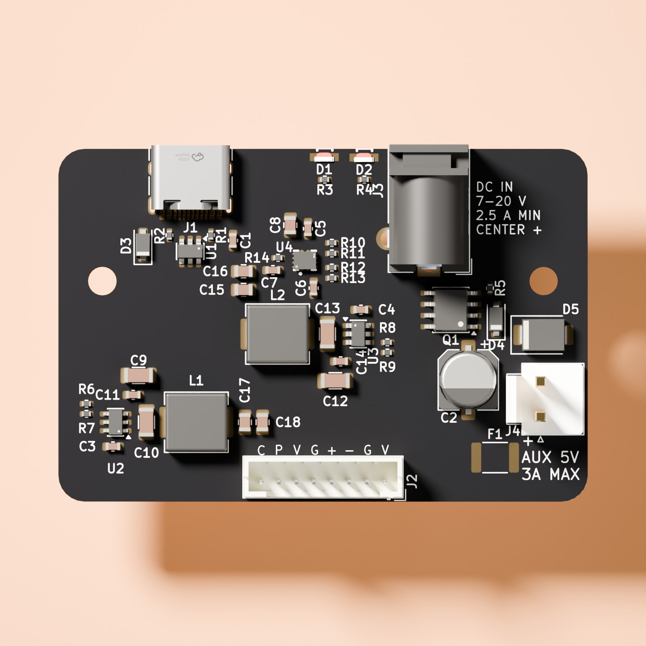
hardware/rodeo-power-barrel/renders/rodeo-power-barrel-front.jpg
