dotrodeo/rodeo/hardware/rodeo-power-barrel/renders/rodeo-power-barrel-iso.jpg

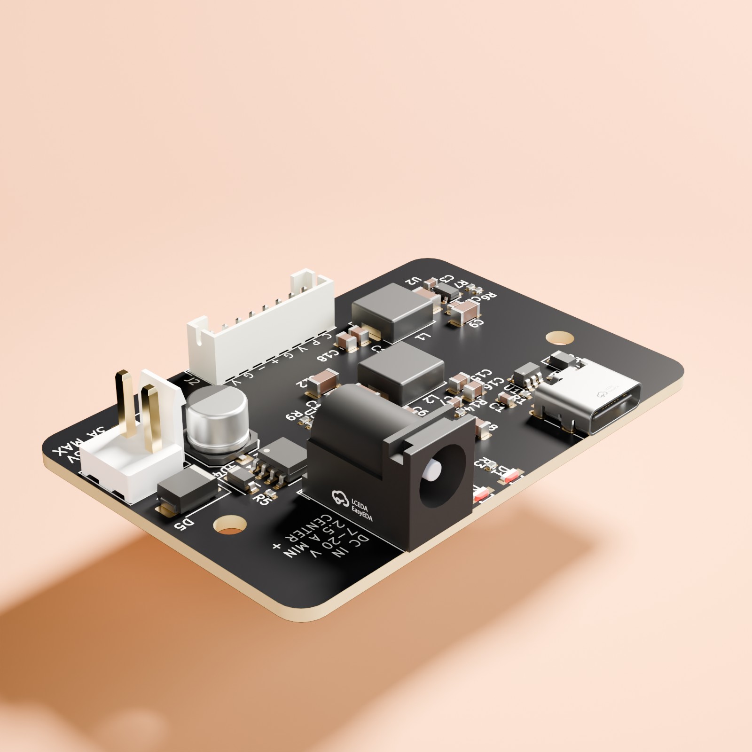
hardware/rodeo-power-barrel/renders/rodeo-power-barrel-iso.jpg
