dotrodeo/rodeo/hardware/rodeo-power-switch/jlcpcb-panel/placement-check.png

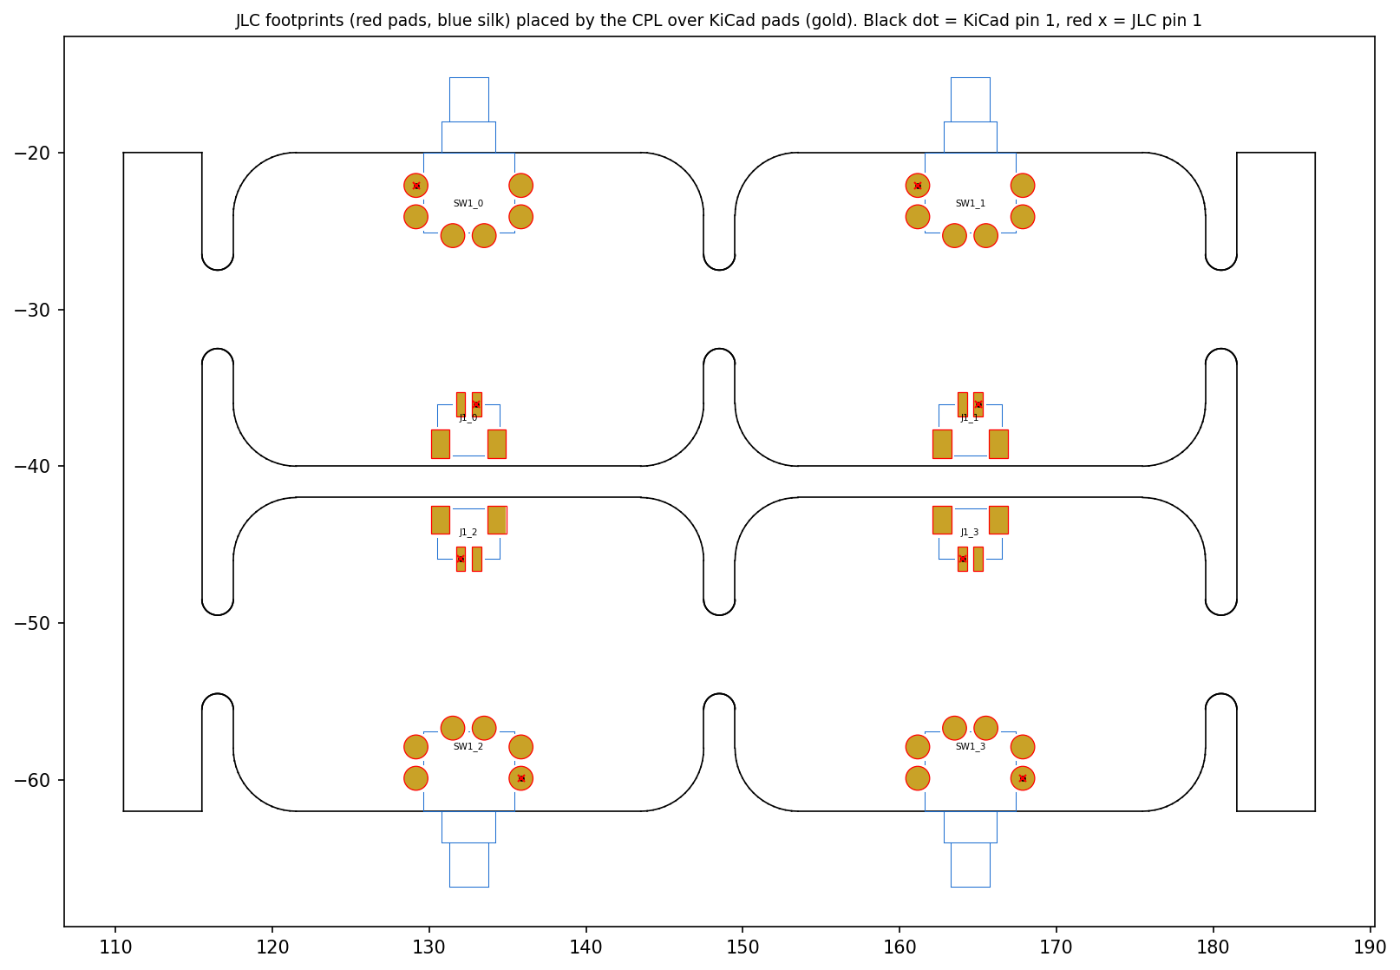
hardware/rodeo-power-switch/jlcpcb-panel/placement-check.png
