dotrodeo/rodeo/hardware/rodeo-power-switch/jlcpcb/placement-check.png

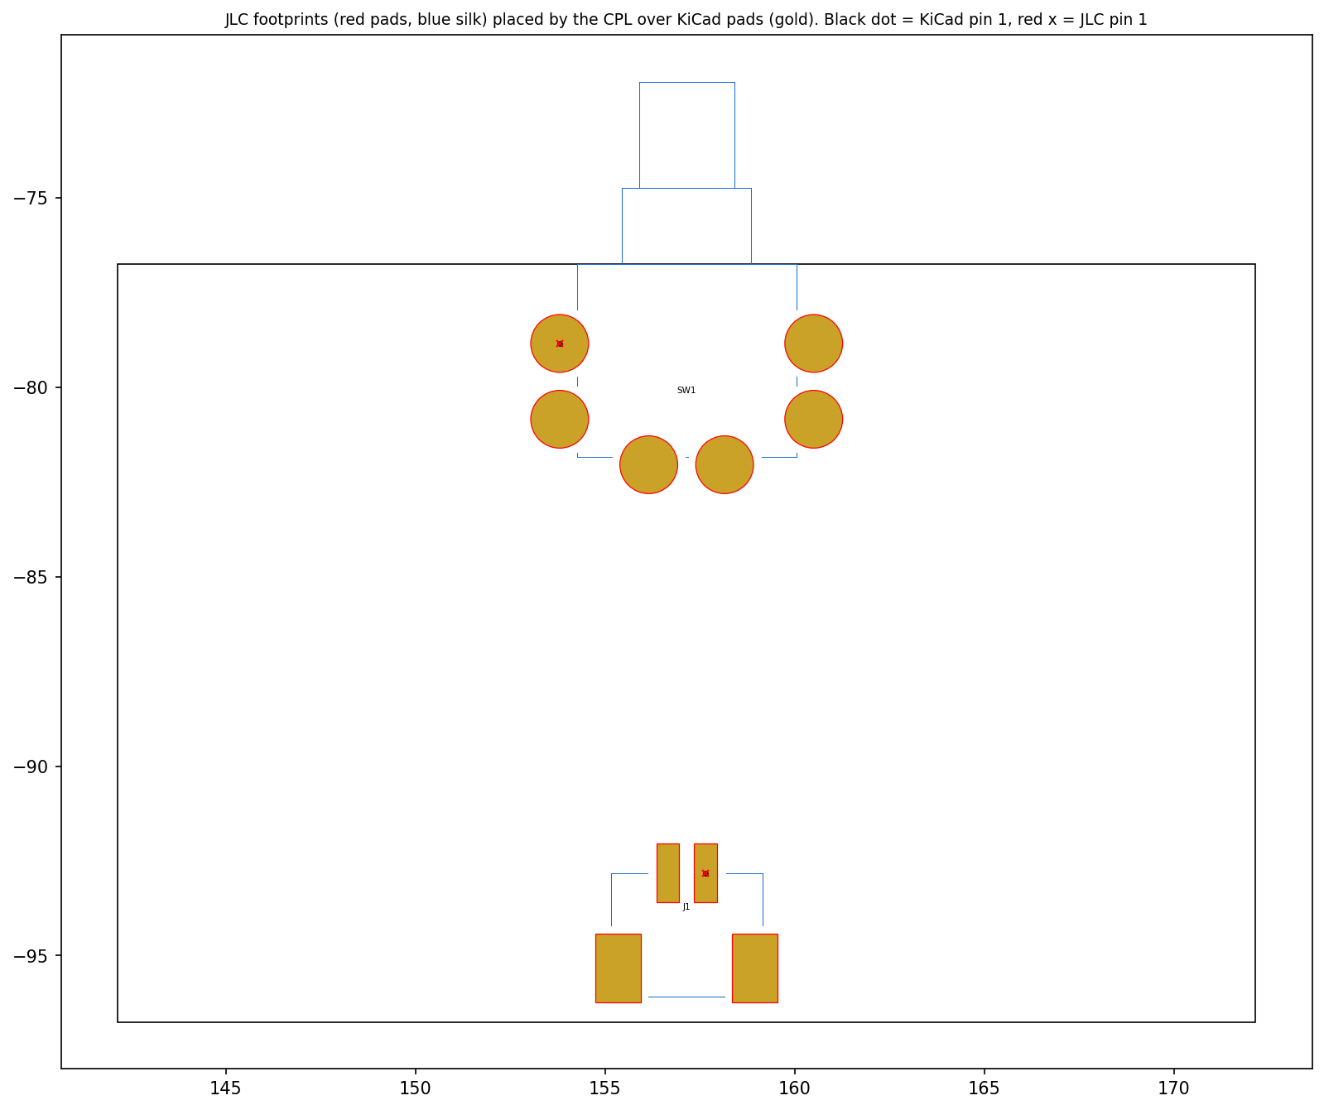
hardware/rodeo-power-switch/jlcpcb/placement-check.png
