dotrodeo/rodeo/hardware/rodeo-power-switch/renders/rodeo-power-switch-back.jpg

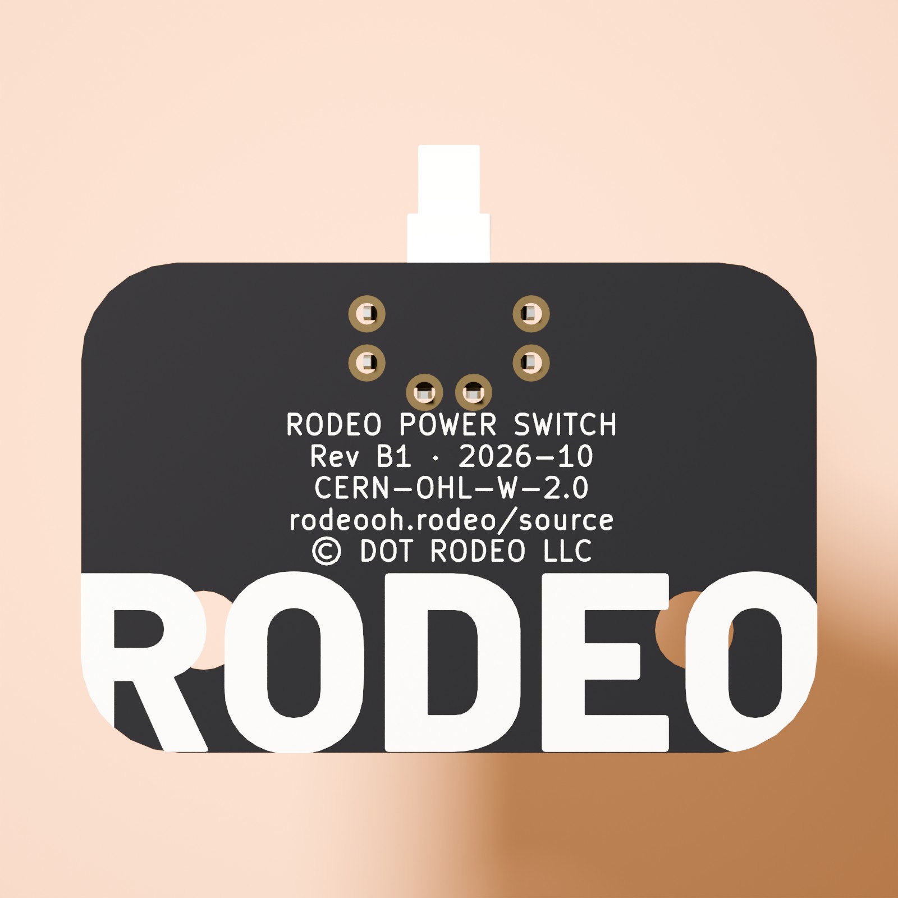
hardware/rodeo-power-switch/renders/rodeo-power-switch-back.jpg
