dotrodeo/rodeo/hardware/rodeo-power-switch/renders/rodeo-power-switch-front.jpg

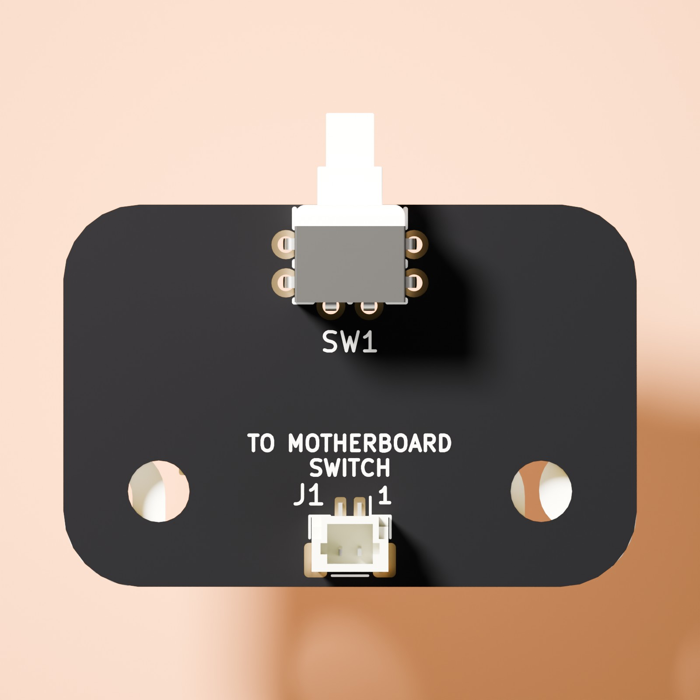
hardware/rodeo-power-switch/renders/rodeo-power-switch-front.jpg
