dotrodeo/rodeo/hardware/rodeo-power-switch/renders/rodeo-power-switch-iso.jpg

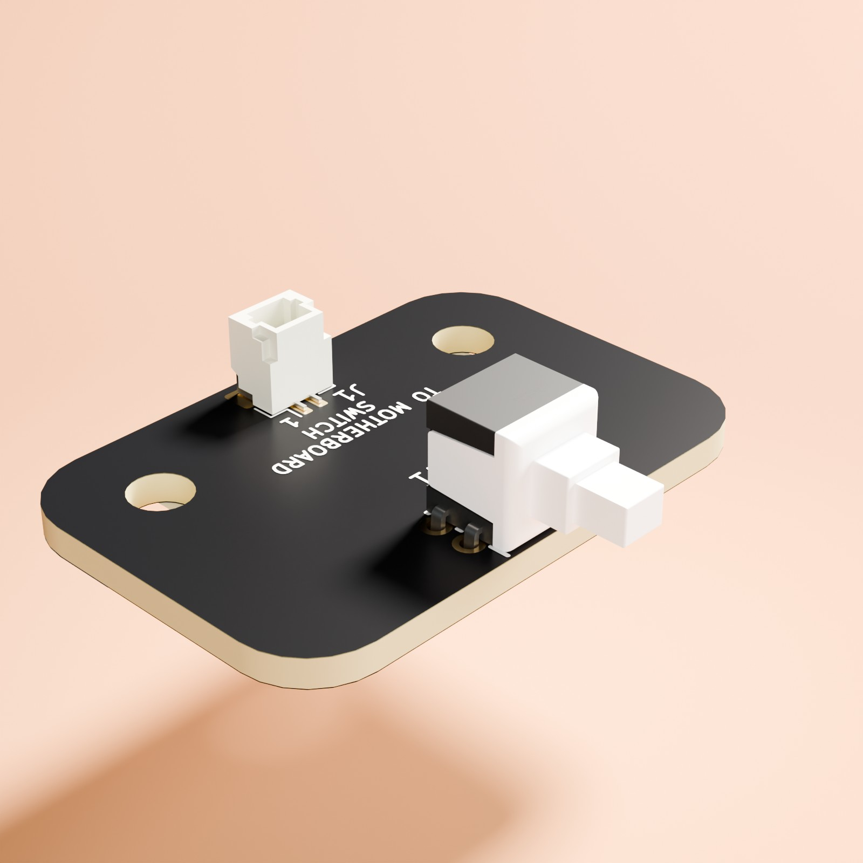
hardware/rodeo-power-switch/renders/rodeo-power-switch-iso.jpg
