dotrodeo/rodeo/hardware/rodeo-power-usbc/jlcpcb-panel/placement-check.png

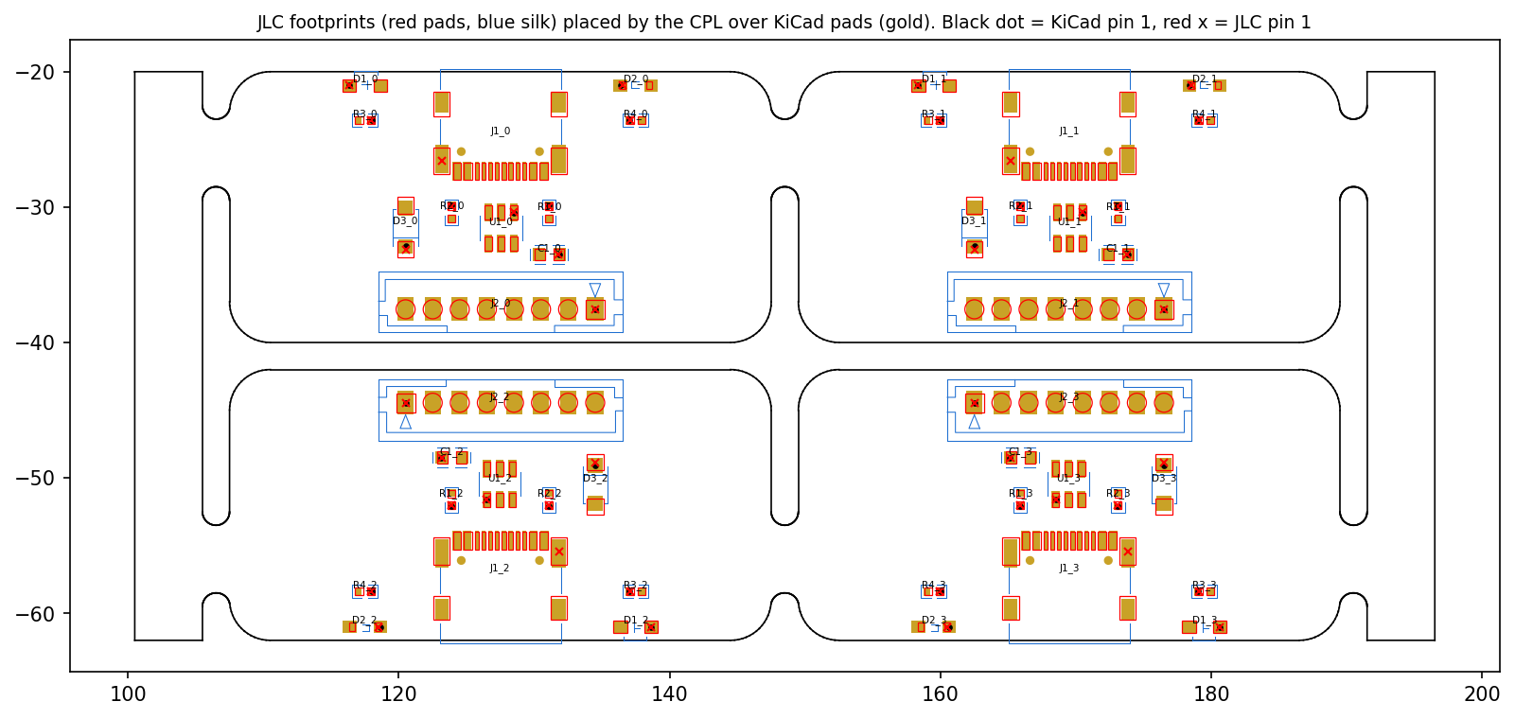
hardware/rodeo-power-usbc/jlcpcb-panel/placement-check.png
