dotrodeo/rodeo/hardware/rodeo-power-usbc/jlcpcb/placement-check.png

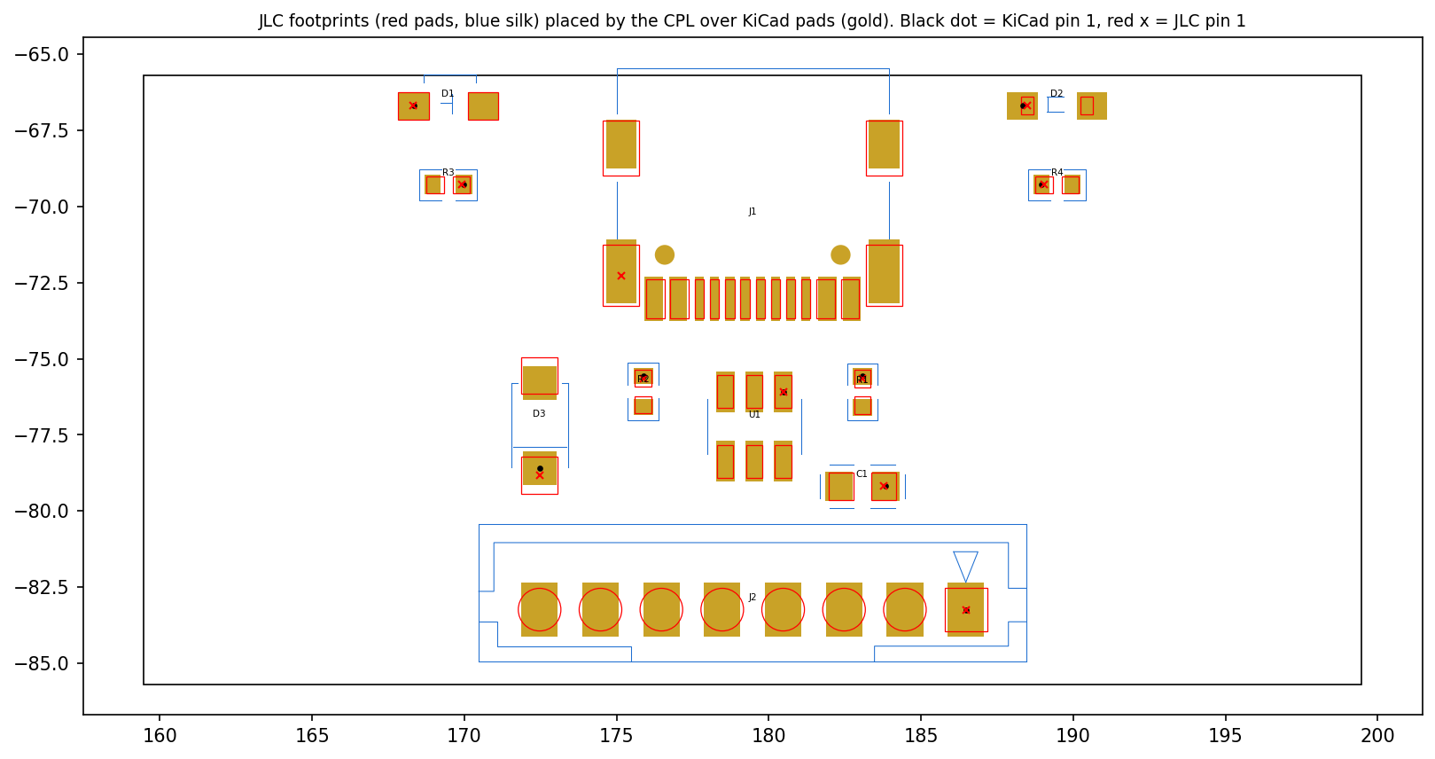
hardware/rodeo-power-usbc/jlcpcb/placement-check.png
