dotrodeo/rodeo/hardware/rodeo-power-usbc/renders/rodeo-power-usbc-back.jpg

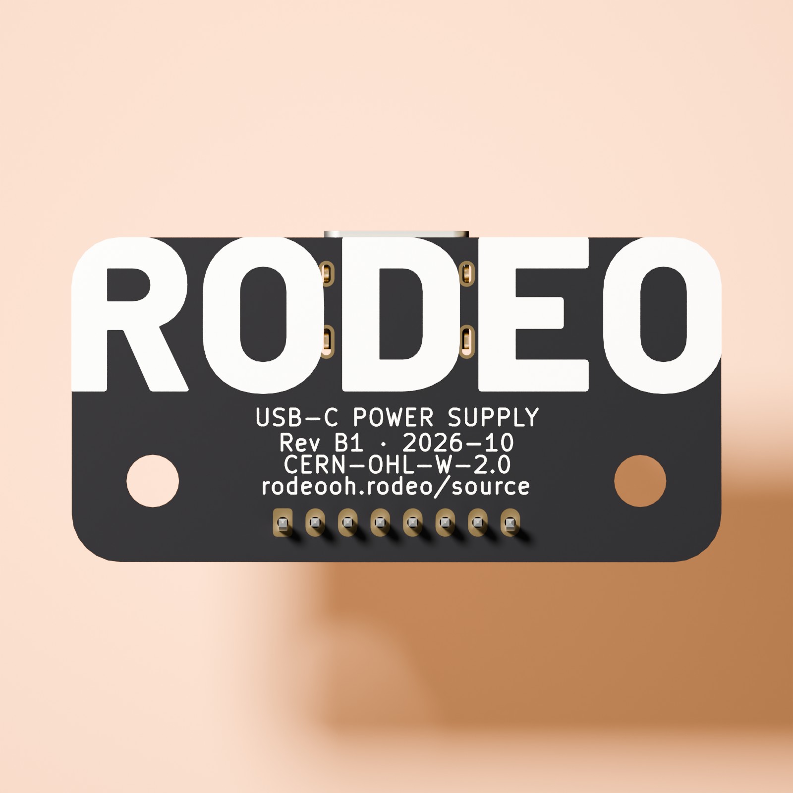
hardware/rodeo-power-usbc/renders/rodeo-power-usbc-back.jpg
