dotrodeo/rodeo/hardware/rodeo-power-usbc/renders/rodeo-power-usbc-front.jpg

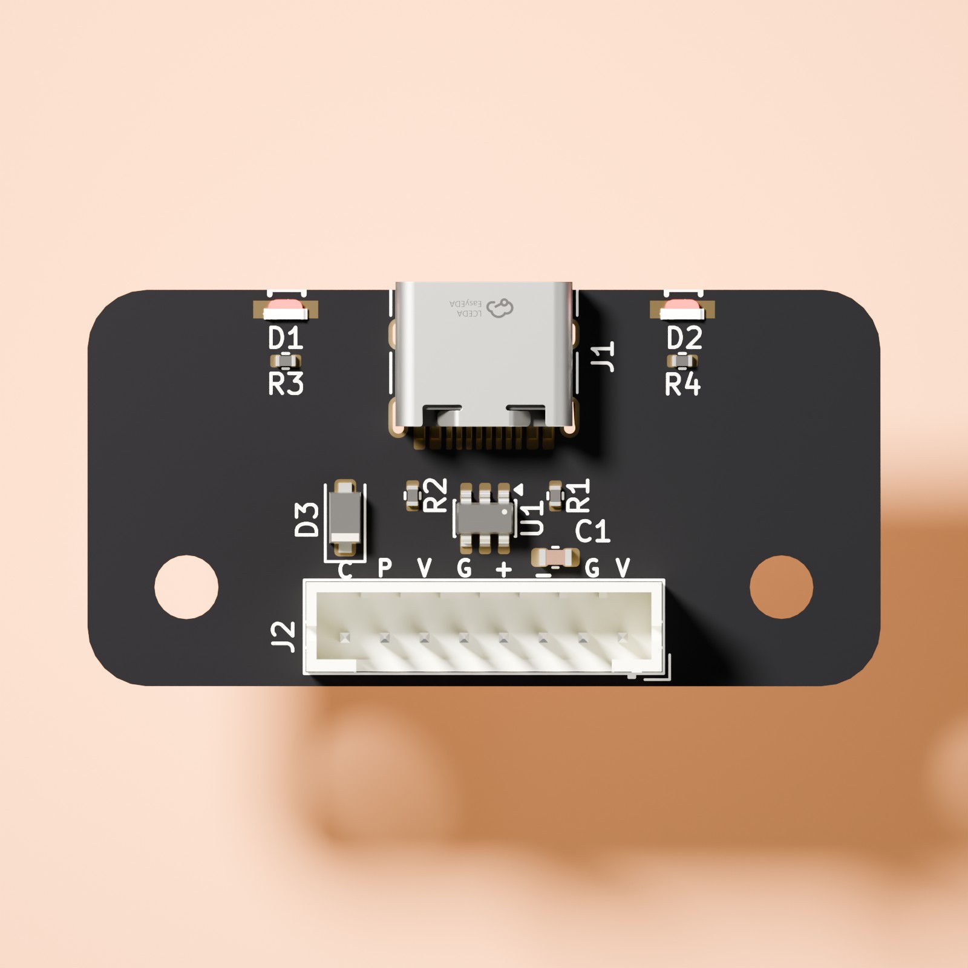
hardware/rodeo-power-usbc/renders/rodeo-power-usbc-front.jpg
