dotrodeo/rodeo/hardware/rodeo-power-usbc/renders/rodeo-power-usbc-iso.jpg

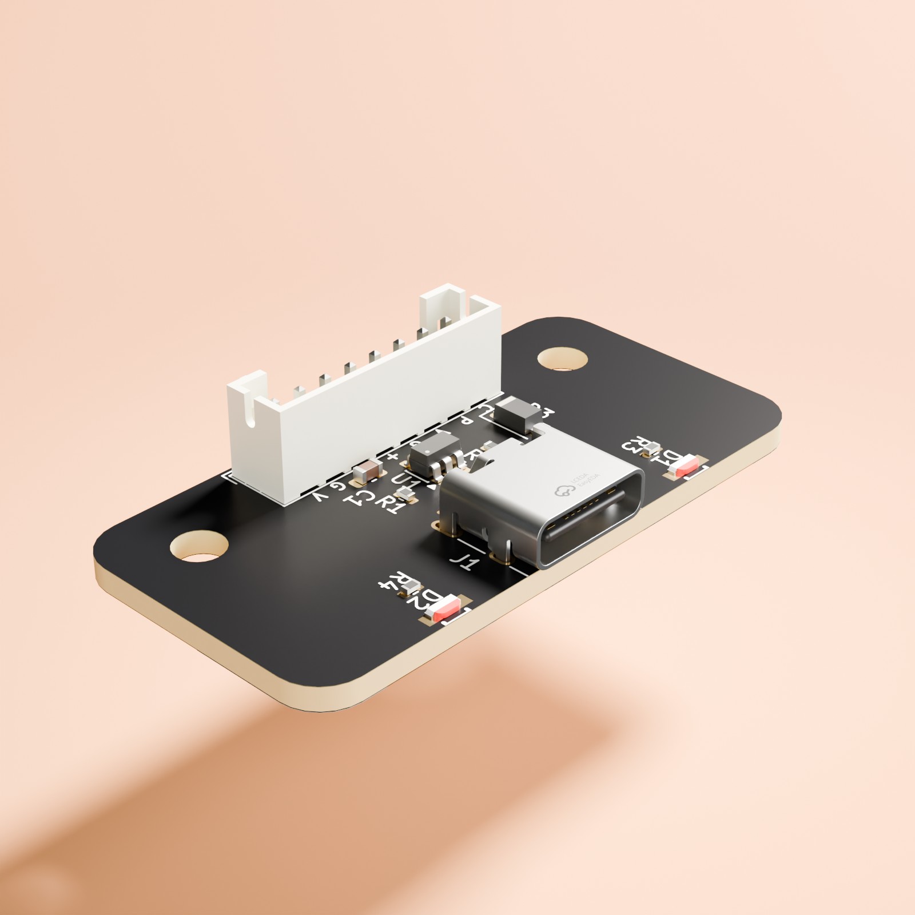
hardware/rodeo-power-usbc/renders/rodeo-power-usbc-iso.jpg
