dotrodeo/rodeo/web/src/assets/hardware/rev-b/rodeo-button-bank-4-front.webp

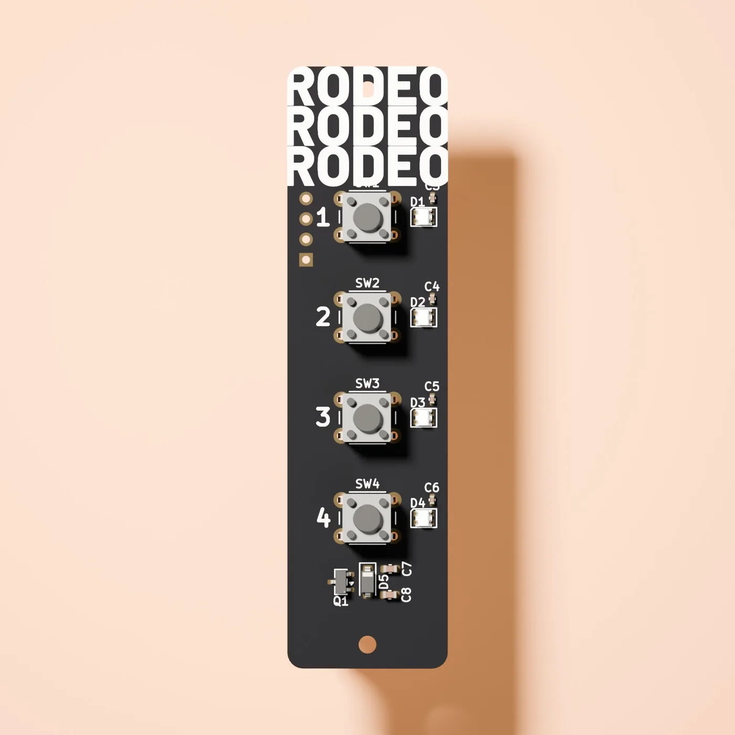
web/src/assets/hardware/rev-b/rodeo-button-bank-4-front.webp
