dotrodeo/rodeo/web/src/assets/hardware/rev-b/rodeo-encoder-bank-4-front.webp

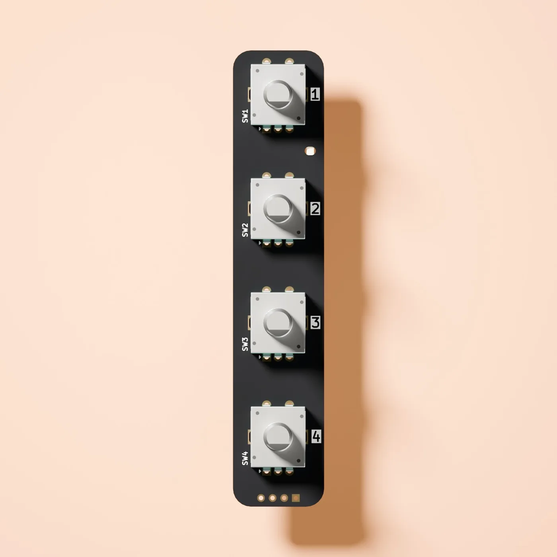
web/src/assets/hardware/rev-b/rodeo-encoder-bank-4-front.webp
