dotrodeo/rodeo/web/src/assets/hardware/rodeo-button.png

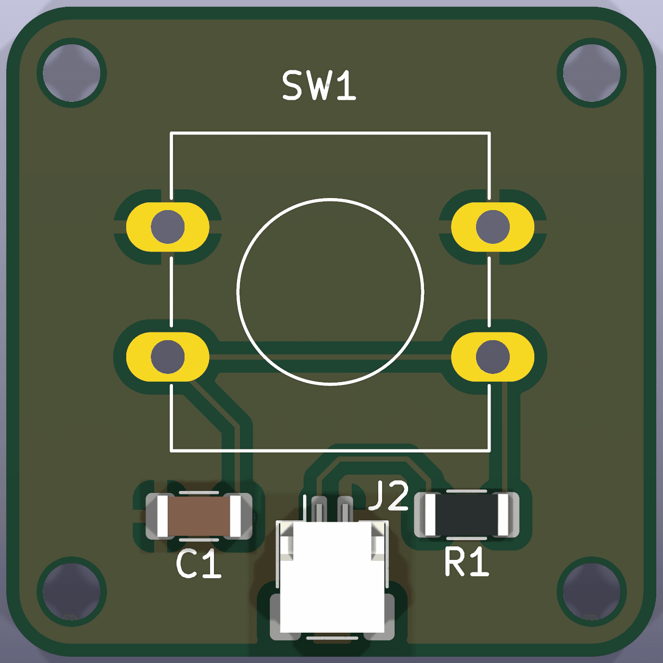
web/src/assets/hardware/rodeo-button.png
