dotrodeo/rodeo/web/src/assets/hardware/rodeo-encoder-hub-back.webp

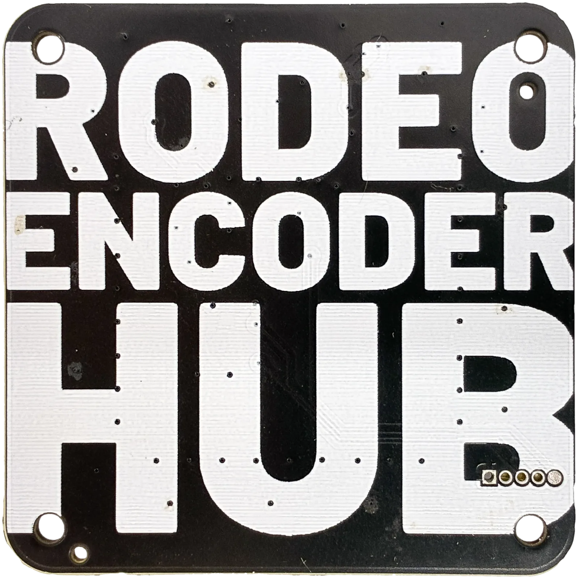
web/src/assets/hardware/rodeo-encoder-hub-back.webp
