dotrodeo/rodeo/web/src/assets/hardware/rodeo-encoder-hub.webp

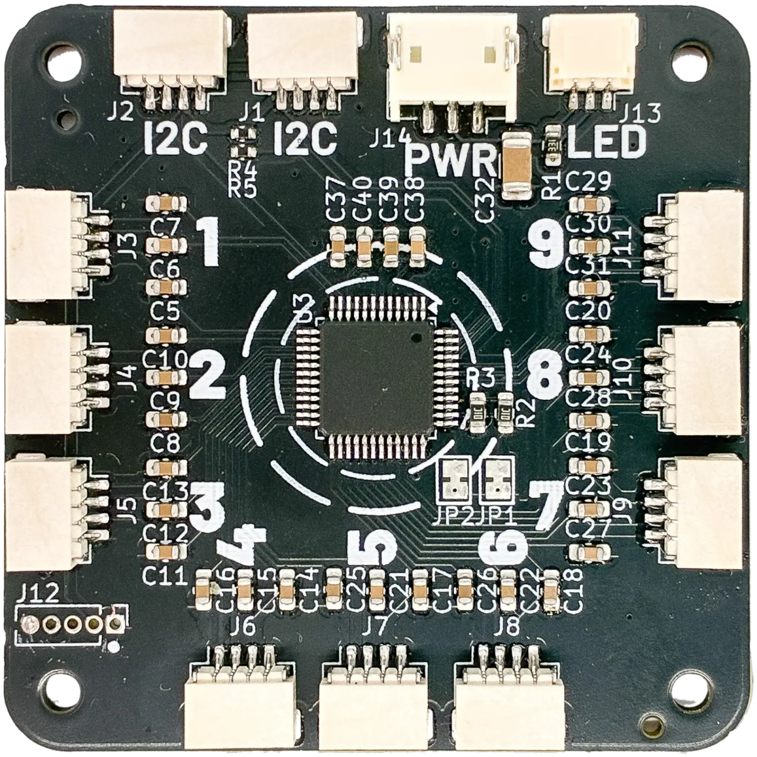
web/src/assets/hardware/rodeo-encoder-hub.webp
