dotrodeo/rodeo/web/src/assets/hardware/rodeo-encoder.png

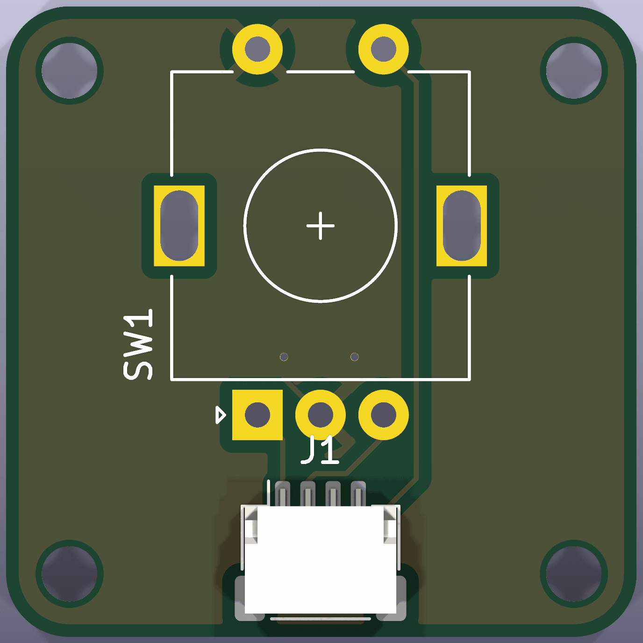
web/src/assets/hardware/rodeo-encoder.png
