dotrodeo/rodeo/web/src/assets/hardware/rodeo-motherboard-back.webp

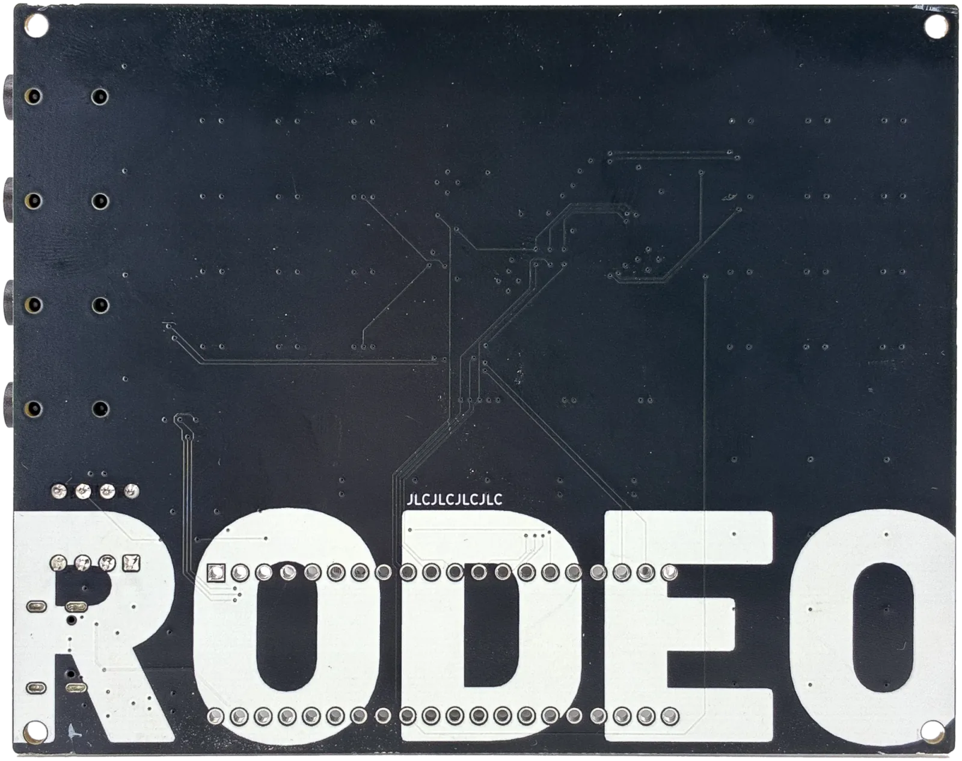
web/src/assets/hardware/rodeo-motherboard-back.webp
