dotrodeo/rodeo/web/src/assets/hardware/rodeo-motherboard-daisy.webp

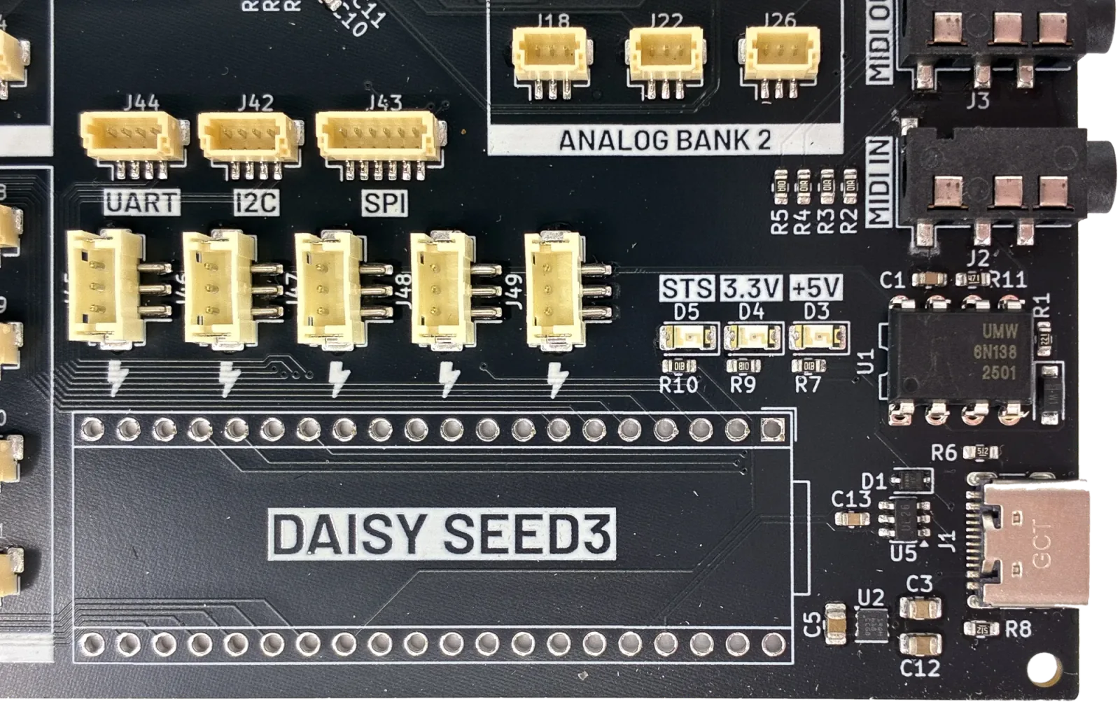
web/src/assets/hardware/rodeo-motherboard-daisy.webp
