dotrodeo/rodeo/web/src/assets/hardware/rodeo-motherboard-io.webp

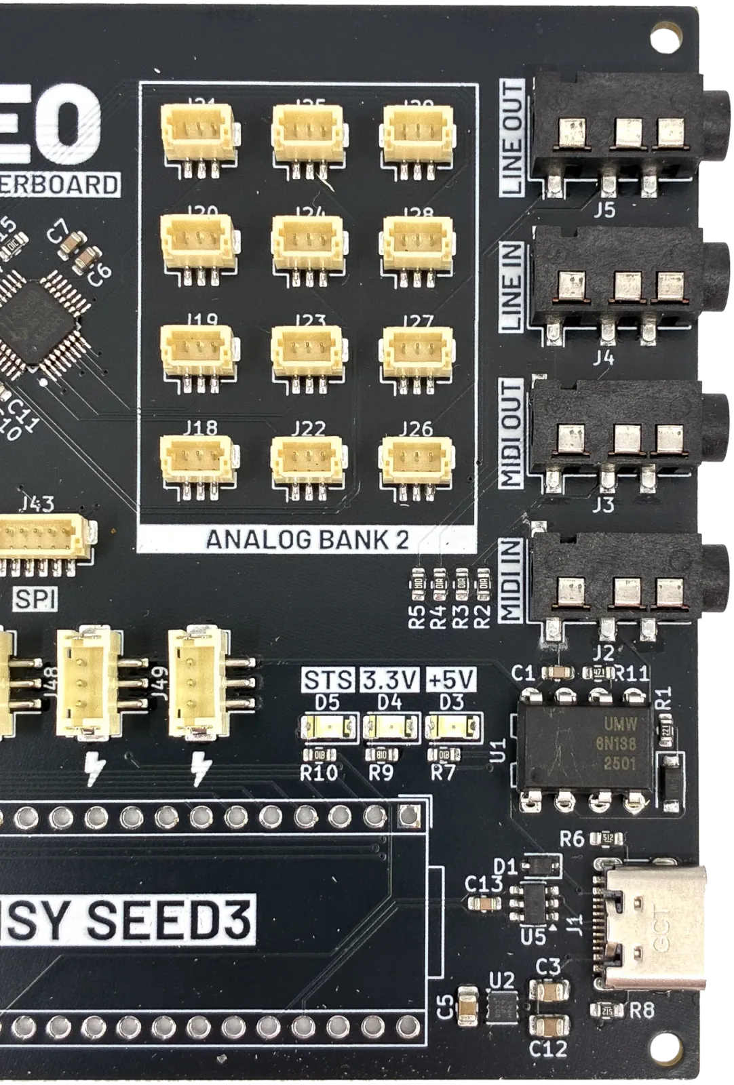
web/src/assets/hardware/rodeo-motherboard-io.webp
