dotrodeo/rodeo/web/src/assets/hardware/rodeo-motherboard.webp

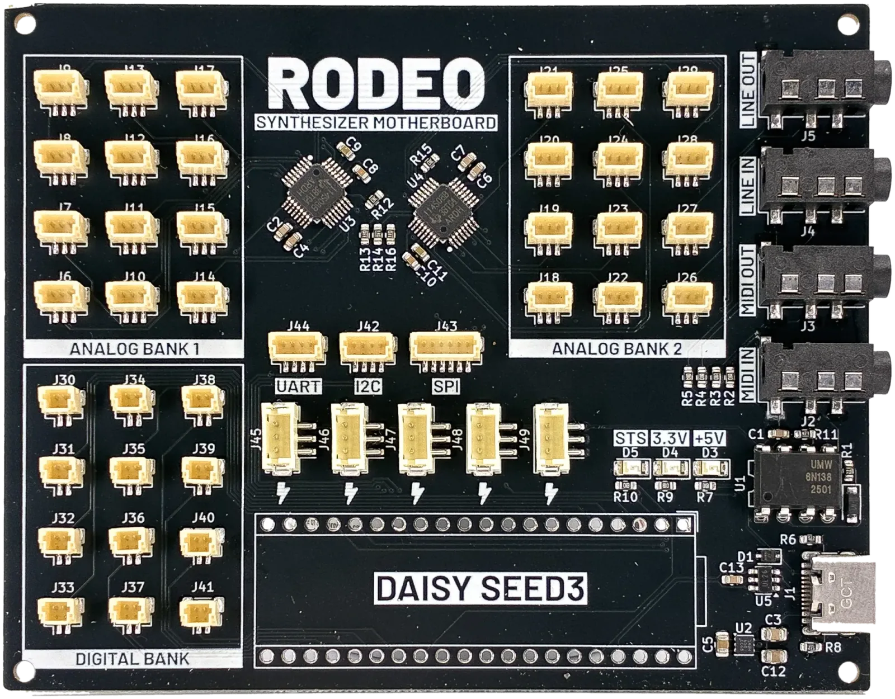
web/src/assets/hardware/rodeo-motherboard.webp
