dotrodeo/rodeo/web/src/assets/hardware/rodeo-potentiometer.png

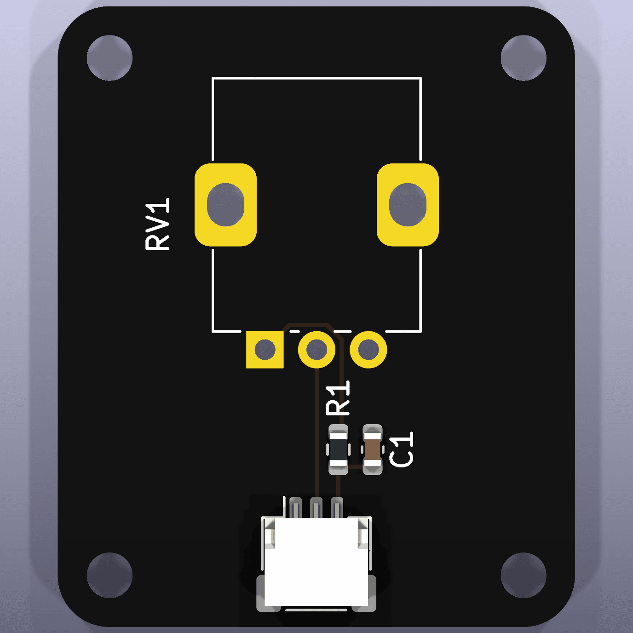
web/src/assets/hardware/rodeo-potentiometer.png
