dotrodeo/rodeo/hardware/rodeo-encoder-1/jlcpcb-panel/production_files/BOM-rodeo-encoder-1-panel.csv

Comment | Designator | Footprint | LCSC | Quantity
1u | C2_0,C2_1,C2_2,C2_3,C2_4,C2_5,C2_6,C2_7,C2_8 | C_0402_1005Metric | C52923 | 9
100n | C3_0,C3_1,C3_2,C3_3,C3_4,C3_5,C3_6,C3_7,C3_8 | C_0402_1005Metric | C1525 | 9
4.7n | C4_0,C4_1,C4_2,C4_3,C4_4,C4_5,C4_6,C4_7,C4_8,C5_0,C5_1,C5_2,C5_3,C5_4,C5_5,C5_6,C5_7,C5_8 | C_0402_1005Metric | C1538 | 18
10n | C6_0,C6_1,C6_2,C6_3,C6_4,C6_5,C6_6,C6_7,C6_8 | C_0402_1005Metric | C15195 | 9
LED | D1_0,D1_1,D1_2,D1_3,D1_4,D1_5,D1_6,D1_7,D1_8 | LED_1206_3216Metric_ReverseMount_Hole1.8x2.4mm | C125107 | 9
Conn_01x05 | J1_0,J1_1,J1_2,J1_3,J1_4,J1_5,J1_6,J1_7,J1_8,J2_0,J2_1,J2_2,J2_3,J2_4,J2_5,J2_6,J2_7,J2_8 | JST_SH_BM05B-SRSS-TB_1x05-1MP_P1.00mm_Vertical | C160391 | 18
1K5 | R1_0,R1_1,R1_2,R1_3,R1_4,R1_5,R1_6,R1_7,R1_8 | R_0603_1608Metric | C22843 | 9
33R | R2_0,R2_1,R2_2,R2_3,R2_4,R2_5,R2_6,R2_7,R2_8,R4_0,R4_1,R4_2,R4_3,R4_4,R4_5,R4_6,R4_7,R4_8 | R_0603_1608Metric | C23140 | 18
10K | R3_0,R3_1,R3_2,R3_3,R3_4,R3_5,R3_6,R3_7,R3_8,R8_0,R8_1,R8_2,R8_3,R8_4,R8_5,R8_6,R8_7,R8_8,R9_0,R9_1,R9_2,R9_3,R9_4,R9_5,R9_6,R9_7,R9_8 | R_0603_1608Metric | C25804 | 27
2K49 | R5_0,R5_1,R5_2,R5_3,R5_4,R5_5,R5_6,R5_7,R5_8 | R_0603_1608Metric | C22908 | 9
22K | R6_0,R6_1,R6_2,R6_3,R6_4,R6_5,R6_6,R6_7,R6_8,R7_0,R7_1,R7_2,R7_3,R7_4,R7_5,R7_6,R7_7,R7_8 | R_0603_1608Metric | C31850 | 18
RotaryEncoder_Switch_MP | SW1_0,SW1_1,SW1_2,SW1_3,SW1_4,SW1_5,SW1_6,SW1_7,SW1_8 | RotaryEncoder_Bourns_PEC11R-S_Vertical | C143790 | 9
CH32V003FxPx | U1_0,U1_1,U1_2,U1_3,U1_4,U1_5,U1_6,U1_7,U1_8 | TSSOP-20_4.4x6.5mm_P0.65mm | C5187096 | 9
