dotrodeo/rodeo/hardware/rodeo-pot-1/jlcpcb-panel/production_files/BOM-rodeo-pot-1-panel.csv

Comment | Designator | Footprint | LCSC | Quantity
100n | C1_0,C1_1,C1_2,C1_3,C1_4,C1_5,C1_6,C1_7,C1_8,C3_0,C3_1,C3_2,C3_3,C3_4,C3_5,C3_6,C3_7,C3_8 | C_0402_1005Metric | C1525 | 18
1u | C2_0,C2_1,C2_2,C2_3,C2_4,C2_5,C2_6,C2_7,C2_8 | C_0402_1005Metric | C52923 | 9
LED | D1_0,D1_1,D1_2,D1_3,D1_4,D1_5,D1_6,D1_7,D1_8 | LED_1206_3216Metric_ReverseMount_Hole1.8x2.4mm | C125107 | 9
Conn_01x05 | J1_0,J1_1,J1_2,J1_3,J1_4,J1_5,J1_6,J1_7,J1_8,J2_0,J2_1,J2_2,J2_3,J2_4,J2_5,J2_6,J2_7,J2_8 | JST_SH_BM05B-SRSS-TB_1x05-1MP_P1.00mm_Vertical | C160391 | 18
1K5 | R1_0,R1_1,R1_2,R1_3,R1_4,R1_5,R1_6,R1_7,R1_8 | R_0603_1608Metric | C22843 | 9
33R | R2_0,R2_1,R2_2,R2_3,R2_4,R2_5,R2_6,R2_7,R2_8,R4_0,R4_1,R4_2,R4_3,R4_4,R4_5,R4_6,R4_7,R4_8 | R_0603_1608Metric | C23140 | 18
10K | R3_0,R3_1,R3_2,R3_3,R3_4,R3_5,R3_6,R3_7,R3_8 | R_0603_1608Metric | C25804 | 9
715R | R5_0,R5_1,R5_2,R5_3,R5_4,R5_5,R5_6,R5_7,R5_8 | R_0603_1608Metric | C2998136 | 9
R_Potentiometer_MountingPin | RV1_0,RV1_1,RV1_2,RV1_3,RV1_4,RV1_5,RV1_6,RV1_7,RV1_8 | Potentiometer_Alps_RK09L_Single_Vertical | C470463 | 9
CH32V003FxPx | U1_0,U1_1,U1_2,U1_3,U1_4,U1_5,U1_6,U1_7,U1_8 | TSSOP-20_4.4x6.5mm_P0.65mm | C5187096 | 9
