dotrodeo/rodeo/hardware/rodeo-button-bank-4/jlcpcb-panel/production_files/BOM-rodeo-button-bank-4-panel.csv

Comment | Designator | Footprint | LCSC | Quantity
1u | C1_0,C1_1,C1_2,C1_3 | C_0402_1005Metric | C52923 | 4
100n | C2_0,C2_1,C2_2,C2_3,C3_0,C3_1,C3_2,C3_3,C4_0,C4_1,C4_2,C4_3,C5_0,C5_1,C5_2,C5_3,C6_0,C6_1,C6_2,C6_3 | C_0402_1005Metric | C1525 | 20
10u | C7_0,C7_1,C7_2,C7_3,C8_0,C8_1,C8_2,C8_3 | C_0603_1608Metric | C19702 | 8
WS2812B-2020-V6 | D1_0,D1_1,D1_2,D1_3,D2_0,D2_1,D2_2,D2_3,D3_0,D3_1,D3_2,D3_3,D4_0,D4_1,D4_2,D4_3 | LED_WS2812B-2020_PLCC4_2.0x2.0mm | C52917434 | 16
B5819W | D5_0,D5_1,D5_2,D5_3 | D_SOD-123 | C8598 | 4
IN | J1_0,J1_1,J1_2,J1_3 | JST_SH_BM05B-SRSS-TB_1x05-1MP_P1.00mm_Vertical | C160391 | 4
OUT | J2_0,J2_1,J2_2,J2_3 | JST_SH_BM05B-SRSS-TB_1x05-1MP_P1.00mm_Vertical | C160391 | 4
AUX IN | J3_0,J3_1,J3_2,J3_3 | JST_PH_B2B-PH-SM4-TB_1x02-1MP_P2.00mm_Vertical | C160352 | 4
AUX OUT | J4_0,J4_1,J4_2,J4_3 | JST_PH_B2B-PH-SM4-TB_1x02-1MP_P2.00mm_Vertical | C160352 | 4
AO3401A | Q1_0,Q1_1,Q1_2,Q1_3 | SOT-23 | C15127 | 4
33R | R1_0,R1_1,R1_2,R1_3,R2_0,R2_1,R2_2,R2_3 | R_0603_1608Metric | C23140 | 8
10K | R3_0,R3_1,R3_2,R3_3 | R_0603_1608Metric | C25804 | 4
8K66 | R4_0,R4_1,R4_2,R4_3 | R_0603_1608Metric | C23114 | 4
100R | R5_0,R5_1,R5_2,R5_3 | R_0603_1608Metric | C22775 | 4
100K | R6_0,R6_1,R6_2,R6_3,R7_0,R7_1,R7_2,R7_3 | R_0603_1608Metric | C25803 | 8
B3F-1052 | SW1_0,SW1_1,SW1_2,SW1_3,SW2_0,SW2_1,SW2_2,SW2_3,SW3_0,SW3_1,SW3_2,SW3_3,SW4_0,SW4_1,SW4_2,SW4_3 | SW_PUSH_6mm | C87037 | 16
CH32V003F4P6 | U1_0,U1_1,U1_2,U1_3 | TSSOP-20_4.4x6.5mm_P0.65mm | C5187096 | 4
