dotrodeo/rodeo/hardware/rodeo-power-usbc/jlcpcb-panel/production_files/BOM-rodeo-power-usbc-panel.csv

Comment | Designator | Footprint | LCSC | Quantity
4.7u | C1_0,C1_1,C1_2,C1_3 | C_0603_1608Metric | C69335 | 4
LTST-S220KGKT | D1_0,D1_1,D1_2,D1_3 | LED_LiteOn_LTST-S220_SideView | C160469 | 4
LTST-S220KRKT | D2_0,D2_1,D2_2,D2_3 | LED_LiteOn_LTST-S220_SideView | C284935 | 4
SMF5.0A | D3_0,D3_1,D3_2,D3_3 | D_SOD-123F | C193402 | 4
USB_C_Receptacle_USB2.0_16P | J1_0,J1_1,J1_2,J1_3 | USB_C_Receptacle_HRO_TYPE-C-31-M-12 | C165948 | 4
Conn_01x08 | J2_0,J2_1,J2_2,J2_3 | JST_PH_B8B-PH-K_1x08_P2.00mm_Vertical | C157974 | 4
5K1 | R1_0,R1_1,R1_2,R1_3,R2_0,R2_1,R2_2,R2_3 | R_0402_1005Metric | C25905 | 8
1K | R3_0,R3_1,R3_2,R3_3,R4_0,R4_1,R4_2,R4_3 | R_0402_1005Metric | C11702 | 8
USBLC6-2SC6 | U1_0,U1_1,U1_2,U1_3 | SOT-23-6 | C7519 | 4
