dotrodeo/rodeo/hardware/rodeo-power-switch/jlcpcb-panel/production_files/BOM-rodeo-power-switch-panel.csv

Comment | Designator | Footprint | LCSC | Quantity
Conn_01x02 | J1_0,J1_1,J1_2,J1_3 | JST_SH_BM02B-SRSS-TB_1x02-1MP_P1.00mm_Vertical | C160388 | 4
TK-6580A-1 | SW1_0,SW1_1,SW1_2,SW1_3 | SW-TH_TK-6580A-1 | C528770 | 4
