dotrodeo/rodeo/hardware/rodeo-power-switch/jlcpcb/production_files/BOM-rodeo-power-switch.csv

Comment | Designator | Footprint | LCSC | Quantity
Conn_01x02 | J1 | JST_SH_BM02B-SRSS-TB_1x02-1MP_P1.00mm_Vertical | C160388 | 1
TK-6580A-1 | SW1 | SW-TH_TK-6580A-1 | C528770 | 1
