dotrodeo/rodeo/hardware/rodeo-audio-3.5mm/jlcpcb/production_files/BOM-rodeo-audio-3-5mm.csv

Comment | Designator | Footprint | LCSC | Quantity
D_TVS | D1,D2,D3,D4,D5,D6,D7,D8 | D_SOD-323 | C7472904 | 8
Conn_02x10_Odd_Even | J1 | IDC-Header_2x10_P2.54mm_Vertical | C2977593 | 1
AudioJack4 | J2,J3,J4,J5 | Jack_3.5mm_PJ320D_Horizontal | C431535 | 4
100R | R1,R2 | R_0402_1005Metric | C25076 | 2
470R | R3,R4,R5,R6 | R_0603_1608Metric | C23179 | 4
