dotrodeo/rodeo/hardware/rodeo-power-barrel/jlcpcb/production_files/BOM-rodeo-power-barrel.csv

Comment | Designator | Footprint | LCSC | Quantity
4.7u | C1 | C_0603_1608Metric | C69335 | 1
47u | C2 | CP_Elec_6.3x5.4 | C72522 | 1
0.1u | C3,C4,C7,C11,C14 | C_0603_1608Metric | C14663 | 5
1u | C5,C6 | C_0603_1608Metric | C15849 | 2
10u | C8 | C_0805_2012Metric | C15850 | 1
10u | C9,C10,C12,C13 | C_1206_3216Metric | C513774 | 4
22u | C15,C16,C17,C18 | C_0805_2012Metric | C45783 | 4
LTST-S220KGKT | D1 | LED_LiteOn_LTST-S220_SideView | C160469 | 1
LTST-S220KRKT | D2 | LED_LiteOn_LTST-S220_SideView | C284935 | 1
SMF5.0A | D3 | D_SOD-123F | C193402 | 1
BZT52C12 | D4 | D_SOD-123 | C173429 | 1
SMBJ20A | D5 | D_SMB | C364296 | 1
Polyfuse | F1 | Fuse_1812_4532Metric | C262035 | 1
USB_C_Receptacle_USB2.0_16P | J1 | USB_C_Receptacle_HRO_TYPE-C-31-M-12 | C165948 | 1
Conn_01x08 | J2 | JST_PH_B8B-PH-K_1x08_P2.00mm_Vertical | C157974 | 1
Barrel_Jack_Switch | J3 | BarrelJack_CUI_PJ-102AH_Horizontal | C3096093 | 1
Conn_01x02_Pin | J4 | JST_VH_B2P-VH_1x02_P3.96mm_Vertical | C160315 | 1
MWSA0603S-100MT | L1,L2 | L_Sunlord_MWSA0603S | C132141 | 2
AO4407A | Q1 | SOIC-8_3.9x4.9mm_P1.27mm | C2841482 | 1
5K1 | R1,R2 | R_0402_1005Metric | C25905 | 2
1K | R3,R4 | R_0402_1005Metric | C11702 | 2
100K | R5,R6,R9 | R_0402_1005Metric | C25741 | 3
13K3 | R7,R8 | R_0402_1005Metric | C274352 | 2
15K | R10,R12 | R_0402_1005Metric | C25756 | 2
28K | R11 | R_0402_1005Metric | C25772 | 1
34K | R13 | R_0402_1005Metric | C48939 | 1
61K9 | R14 | R_0402_1005Metric | C25912 | 1
USBLC6-2SC6 | U1 | SOT-23-6 | C7519 | 1
TPS54302 | U2 | TSOT-23-6 | C311983 | 1
TPS54308 | U3 | SOT-23-6 | C168839 | 1
TPS2121RUXR | U4 | VQFN-HR-12_L2.5-W2.0-P0.50-BL | C485916 | 1
