dotrodeo/rodeo/rev-a/rodeo-encoder-hub/jlcpcb/production_files/BOM-rodeo-encoder-hub.csv

Comment | Designator | Footprint | LCSC | Quantity
100n | C37,C38,C40 | C_0603_1608Metric | C14663 | 3
100u | C32 | C_1206_3216Metric | C15008 | 1
10K | R2,R3 | R_0603_1608Metric | C25804 | 2
10n | C10,C11,C12,C13,C14,C15,C16,C17,C18,C19,C20,C21,C22,C23,C24,C25,C26,C27,C28,C29,C30,C31,C5,C6,C7,C8,C9 | C_0603_1608Metric | C57112 | 27
2.2K | R4,R5 | R_0402_1005Metric | C25879 | 2
330R | R1 | R_0603_1608Metric | C23138 | 1
4.7u | C39 | C_0603_1608Metric | C19666 | 1
Conn_01x03 | J13 | JST_SH_SM03B-SRSS-TB_1x03-1MP_P1.00mm_Horizontal | C160403 | 1
Conn_01x03 | J14 | JST_ZH_S3B-ZR-SM4A-TF_1x03-1MP_P1.50mm_Horizontal | C72591 | 1
Conn_01x04 | J1,J10,J11,J2,J3,J4,J5,J6,J7,J8,J9 | JST_SH_SM04B-SRSS-TB_1x04-1MP_P1.00mm_Horizontal | C160404 | 11
STM32C031C6Tx | U3 | LQFP-48_7x7mm_P0.5mm | C5456218 | 1
