dotrodeo/rodeo/rev-a/rodeo-encoder/jlcpcb/production_files/BOM-rodeo-encoder.csv

Comment | Designator | Footprint | LCSC | Quantity
RotaryEncoder_Switch | SW1 | RotaryEncoder_Alps_EC11E-Switch_Vertical_H20mm |  | 1
Conn_01x04 | J1 | JST_SH_SM04B-SRSS-TB_1x04-1MP_P1.00mm_Horizontal |  | 1
