dotrodeo/rodeo/hardware/rodeo-motherboard/jlcpcb-panel/production_files/BOM-rodeo-motherboard-panel.csv

Comment | Designator | Footprint | LCSC | Quantity
0.1u | C1_0,C1_1,C1_2,C1_3,C5_0,C5_1,C5_2,C5_3 | C_0603_1608Metric | C14663 | 8
10u | C2_0,C2_1,C2_2,C2_3,C3_0,C3_1,C3_2,C3_3,C13_0,C13_1,C13_2,C13_3,C16_0,C16_1,C16_2,C16_3,C20_0,C20_1,C20_2,C20_3,C25_0,C25_1,C25_2,C25_3,C26_0,C26_1,C26_2,C26_3,C28_0,C28_1,C28_2,C28_3,C29_0,C29_1,C29_2,C29_3 | C_0805_2012Metric | C15850 | 36
1u | C4_0,C4_1,C4_2,C4_3,C18_0,C18_1,C18_2,C18_3,C24_0,C24_1,C24_2,C24_3 | C_0603_1608Metric | C15849 | 12
22u | C6_0,C6_1,C6_2,C6_3,C9_0,C9_1,C9_2,C9_3,C17_0,C17_1,C17_2,C17_3,C19_0,C19_1,C19_2,C19_3,C22_0,C22_1,C22_2,C22_3 | C_0805_2012Metric | C45783 | 20
4.7u | C7_0,C7_1,C7_2,C7_3,C8_0,C8_1,C8_2,C8_3 | C_0805_2012Metric | C1779 | 8
0.1u | C10_0,C10_1,C10_2,C10_3,C30_0,C30_1,C30_2,C30_3,C32_0,C32_1,C32_2,C32_3,C34_0,C34_1,C34_2,C34_3,C37_0,C37_1,C37_2,C37_3,C39_0,C39_1,C39_2,C39_3,C43_0,C43_1,C43_2,C43_3,C59_0,C59_1,C59_2,C59_3,C60_0,C60_1,C60_2,C60_3,C62_0,C62_1,C62_2,C62_3,C63_0,C63_1,C63_2,C63_3,C70_0,C70_1,C70_2,C70_3,C72_0,C72_1,C72_2,C72_3,C74_0,C74_1,C74_2,C74_3 | C_0402_1005Metric | C1525 | 56
1u | C11_0,C11_1,C11_2,C11_3,C31_0,C31_1,C31_2,C31_3,C33_0,C33_1,C33_2,C33_3,C35_0,C35_1,C35_2,C35_3,C36_0,C36_1,C36_2,C36_3,C40_0,C40_1,C40_2,C40_3,C56_0,C56_1,C56_2,C56_3,C61_0,C61_1,C61_2,C61_3 | C_0402_1005Metric | C52923 | 32
100n | C12_0,C12_1,C12_2,C12_3 | C_0603_1608Metric | C14663 | 4
100u | C14_0,C14_1,C14_2,C14_3,C21_0,C21_1,C21_2,C21_3,C27_0,C27_1,C27_2,C27_3 | CP_Elec_6.3x5.4 | C2887276 | 12
10u | C15_0,C15_1,C15_2,C15_3,C23_0,C23_1,C23_2,C23_3,C71_0,C71_1,C71_2,C71_3 | C_0603_1608Metric | C96446 | 12
47u | C38_0,C38_1,C38_2,C38_3 | C_1206_3216Metric | C96123 | 4
2.2n | C41_0,C41_1,C41_2,C41_3,C42_0,C42_1,C42_2,C42_3 | C_0603_1608Metric | C296055 | 8
6.8n | C44_0,C44_1,C44_2,C44_3,C45_0,C45_1,C45_2,C45_3 | C_0603_1608Metric | C513559 | 8
22u | C46_0,C46_1,C46_2,C46_3,C47_0,C47_1,C47_2,C47_3,C52_0,C52_1,C52_2,C52_3,C53_0,C53_1,C53_2,C53_3 | CP_Elec_4x5.4 | C72502 | 16
1.5n | C48_0,C48_1,C48_2,C48_3,C49_0,C49_1,C49_2,C49_3 | C_0603_1608Metric | C107039 | 8
470p | C50_0,C50_1,C50_2,C50_3,C51_0,C51_1,C51_2,C51_3 | C_0402_1005Metric | C106259 | 8
10u | C54_0,C54_1,C54_2,C54_3,C55_0,C55_1,C55_2,C55_3,C57_0,C57_1,C57_2,C57_3,C58_0,C58_1,C58_2,C58_3 | CP_Elec_4x5.4 | C72484 | 16
150p | C64_0,C64_1,C64_2,C64_3,C65_0,C65_1,C65_2,C65_3,C66_0,C66_1,C66_2,C66_3,C67_0,C67_1,C67_2,C67_3 | C_0402_1005Metric | C541469 | 16
2.7n | C68_0,C68_1,C68_2,C68_3,C69_0,C69_1,C69_2,C69_3 | C_0603_1608Metric | C388043 | 8
10n | C73_0,C73_1,C73_2,C73_3 | C_0402_1005Metric | C15195 | 4
SMBJ5.0A | D1_0,D1_1,D1_2,D1_3 | D_SMB | C113974 | 4
1N4148W | D3_0,D3_1,D3_2,D3_3 | D_SOD-123 | C81598 | 4
nSMD075 | F1_0,F1_1,F1_2,F1_3 | Fuse_1206_3216Metric | C70078 | 4
BLM21PG221SN1D | FB1_0,FB1_1,FB1_2,FB1_3,FB3_0,FB3_1,FB3_2,FB3_3,FB4_0,FB4_1,FB4_2,FB4_3 | L_0805_2012Metric | C85840 | 12
BLM18KG601SN1D | FB2_0,FB2_1,FB2_2,FB2_3 | L_0603_1608Metric | C85833 | 4
Conn_01x02 | J1_0,J1_1,J1_2,J1_3 | JST_PH_S2B-PH-K_1x02_P2.00mm_Horizontal | C173752 | 4
Conn_01x08 | J2_0,J2_1,J2_2,J2_3 | JST_PH_S8B-PH-K_1x08_P2.00mm_Horizontal | C157915 | 4
Conn_01x02 | J3_0,J3_1,J3_2,J3_3 | JST_SH_BM02B-SRSS-TB_1x02-1MP_P1.00mm_Vertical | C160388 | 4
Conn_02x10_Odd_Even | J4_0,J4_1,J4_2,J4_3 | IDC-Header_2x10_P2.54mm_Vertical | C2977593 | 4
TF PUSH | J5_0,J5_1,J5_2,J5_3 | TF-SMD_TF-PUSH | C393941 | 4
Conn_01x05 | J6_0,J6_1,J6_2,J6_3,J18_0,J18_1,J18_2,J18_3 | JST_SH_BM05B-SRSS-TB_1x05-1MP_P1.00mm_Vertical | C160391 | 8
Conn_01x07 | J7_0,J7_1,J7_2,J7_3 | JST_SH_BM07B-SRSS-TB_1x07-1MP_P1.00mm_Vertical | C160393 | 4
Conn_01x03 | J8_0,J8_1,J8_2,J8_3,J9_0,J9_1,J9_2,J9_3,J10_0,J10_1,J10_2,J10_3,J11_0,J11_1,J11_2,J11_3,J12_0,J12_1,J12_2,J12_3,J13_0,J13_1,J13_2,J13_3,J14_0,J14_1,J14_2,J14_3,J15_0,J15_1,J15_2,J15_3,J16_0,J16_1,J16_2,J16_3,J17_0,J17_1,J17_2,J17_3 | JST_SH_BM03B-SRSS-TB_1x03-1MP_P1.00mm_Vertical | C160389 | 40
Conn_01x04 | J19_0,J19_1,J19_2,J19_3,J20_0,J20_1,J20_2,J20_3,J21_0,J21_1,J21_2,J21_3,J22_0,J22_1,J22_2,J22_3 | JST_SH_BM04B-SRSS-TB_1x04-1MP_P1.00mm_Vertical | C160390 | 16
2.2uH | L1_0,L1_1,L1_2,L1_3 | L_Sunlord_MWSA0518S | C408345 | 4
1.5uH | L2_0,L2_1,L2_2,L2_3 | L_Sunlord_MWSA0518S | C408344 | 4
FS8205A | Q1_0,Q1_1,Q1_2,Q1_3 | SOT-23-6_L2.9-W1.6-P0.95-LS2.8-BR | C2830320 | 4
BSS84DW | Q2_0,Q2_1,Q2_2,Q2_3 | SOT-363_SC-70-6 | C161617 | 4
2N7002DW | Q3_0,Q3_1,Q3_2,Q3_3,Q4_0,Q4_1,Q4_2,Q4_3 | SOT-363_SC-70-6 | C83571 | 8
1.18K | R1_0,R1_1,R1_2,R1_3 | R_0402_1005Metric | C270651 | 4
1.13K | R2_0,R2_1,R2_2,R2_3 | R_0402_1005Metric | C67014 | 4
10K | R3_0,R3_1,R3_2,R3_3,R7_0,R7_1,R7_2,R7_3,R12_0,R12_1,R12_2,R12_3,R15_0,R15_1,R15_2,R15_3,R18_0,R18_1,R18_2,R18_3,R20_0,R20_1,R20_2,R20_3,R21_0,R21_1,R21_2,R21_3,R28_0,R28_1,R28_2,R28_3,R42_0,R42_1,R42_2,R42_3,R79_0,R79_1,R79_2,R79_3 | R_0402_1005Metric | C25744 | 40
33K2 | R4_0,R4_1,R4_2,R4_3 | R_0402_1005Metric | C122548 | 4
100R | R8_0,R8_1,R8_2,R8_3,R56_0,R56_1,R56_2,R56_3,R57_0,R57_1,R57_2,R57_3,R65_0,R65_1,R65_2,R65_3,R66_0,R66_1,R66_2,R66_3 | R_0402_1005Metric | C25076 | 20
1K | R9_0,R9_1,R9_2,R9_3,R67_0,R67_1,R67_2,R67_3,R68_0,R68_1,R68_2,R68_3,R69_0,R69_1,R69_2,R69_3,R70_0,R70_1,R70_2,R70_3,R71_0,R71_1,R71_2,R71_3,R74_0,R74_1,R74_2,R74_3,R75_0,R75_1,R75_2,R75_3,R76_0,R76_1,R76_2,R76_3,R77_0,R77_1,R77_2,R77_3,R78_0,R78_1,R78_2,R78_3 | R_0402_1005Metric | C11702 | 44
19K1 | R10_0,R10_1,R10_2,R10_3 | R_0402_1005Metric | C52036 | 4
100K | R11_0,R11_1,R11_2,R11_3 | R_0402_1005Metric | C25741 | 4
47K | R13_0,R13_1,R13_2,R13_3,R19_0,R19_1,R19_2,R19_3,R39_0,R39_1,R39_2,R39_3,R40_0,R40_1,R40_2,R40_3,R58_0,R58_1,R58_2,R58_3,R60_0,R60_1,R60_2,R60_3,R61_0,R61_1,R61_2,R61_3,R62_0,R62_1,R62_2,R62_3,R63_0,R63_1,R63_2,R63_3 | R_0402_1005Metric | C25792 | 36
0R | R14_0,R14_1,R14_2,R14_3 | R_0402_1005Metric | C17168 | 4
2K2 | R16_0,R16_1,R16_2,R16_3,R17_0,R17_1,R17_2,R17_3 | R_0402_1005Metric | C25879 | 8
4K42 | R22_0,R22_1,R22_2,R22_3,R23_0,R23_1,R23_2,R23_3 | R_0402_1005Metric | C52269 | 8
1K33 | R24_0,R24_1,R24_2,R24_3,R26_0,R26_1,R26_2,R26_3 | R_0402_1005Metric | C423242 | 8
4K99 | R25_0,R25_1,R25_2,R25_3,R27_0,R27_1,R27_2,R27_3 | R_0402_1005Metric | C25903 | 8
2K32 | R29_0,R29_1,R29_2,R29_3,R30_0,R30_1,R30_2,R30_3 | R_0402_1005Metric | C82297 | 8
1M | R31_0,R31_1,R31_2,R31_3,R38_0,R38_1,R38_2,R38_3,R41_0,R41_1,R41_2,R41_3,R45_0,R45_1,R45_2,R45_3 | R_0402_1005Metric | C26083 | 16
1K5 | R32_0,R32_1,R32_2,R32_3,R33_0,R33_1,R33_2,R33_3 | R_0402_1005Metric | C25867 | 8
715R | R34_0,R34_1,R34_2,R34_3,R35_0,R35_1,R35_2,R35_3 | R_0402_1005Metric | C113474 | 8
560R | R36_0,R36_1,R36_2,R36_3,R37_0,R37_1,R37_2,R37_3 | R_0402_1005Metric | C25126 | 8
7K5 | R43_0,R43_1,R43_2,R43_3,R44_0,R44_1,R44_2,R44_3,R46_0,R46_1,R46_2,R46_3,R47_0,R47_1,R47_2,R47_3 | R_0402_1005Metric | C25918 | 16
10K5 | R48_0,R48_1,R48_2,R48_3,R49_0,R49_1,R49_2,R49_3,R50_0,R50_1,R50_2,R50_3,R51_0,R51_1,R51_2,R51_3 | R_0402_1005Metric | C25850 | 16
91R | R52_0,R52_1,R52_2,R52_3,R53_0,R53_1,R53_2,R53_3,R54_0,R54_1,R54_2,R54_3,R55_0,R55_1,R55_2,R55_3 | R_0402_1005Metric | C270574 | 16
22R | R59_0,R59_1,R59_2,R59_3 | R_0402_1005Metric | C25092 | 4
220R | R64_0,R64_1,R64_2,R64_3 | R_0402_1005Metric | C25091 | 4
33R | R72_0,R72_1,R72_2,R72_3,R73_0,R73_1,R73_2,R73_3,R80_0,R80_1,R80_2,R80_3 | R_0402_1005Metric | C25105 | 12
TPS563208 | U1_0,U1_1,U1_2,U1_3 | TSOT-23-6 | C468250 | 4
BQ24073RGT | U2_0,U2_1,U2_2,U2_3 | VQFN-16-1EP_3x3mm_P0.5mm_EP1.6x1.6mm | C15220 | 4
DW01A | U3_0,U3_1,U3_2,U3_3 | SOT-23-6 | C351410 | 4
MAX17048G+T10 | U4_0,U4_1,U4_2,U4_3 | TDFN-8_L2.0-W2.0-P0.50-BL-EP1.2 | C2682616 | 4
TPS63070RNMR | U5_0,U5_1,U5_2,U5_3 | VQFN-15_L3.0-W2.5-P0.50-BL | C109322 | 4
TPS7A2033PDBVR | U6_0,U6_1,U6_2,U6_3 | SOT-23-5 | C2862740 | 4
CS4272 | U7_0,U7_1,U7_2,U7_3 | TSSOP-28_4.4x9.7mm_P0.65mm | C2151111 | 4
OPA2376xxD | U8_0,U8_1,U8_2,U8_3 | SOIC-8_3.9x4.9mm_P1.27mm | C46316 | 4
THS4521IDGK | U9_0,U9_1,U9_2,U9_3,U10_0,U10_1,U10_2,U10_3 | VSSOP-8_3x3mm_P0.65mm | C170157 | 8
SRV05-4 | U11_0,U11_1,U11_2,U11_3 | SOT-23-6 | C13612 | 4
TLP2361 | U12_0,U12_1,U12_2,U12_3 | SO-5-6_4.55x3.7mm_P1.27mm | C107626 | 4
USBLC6-2SC6 | U13_0,U13_1,U13_2,U13_3 | SOT-23-6 | C7519 | 4
