dotrodeo/rodeo/hardware/rodeo-audio-3.5mm/jlcpcb-panel/production_files/BOM-rodeo-audio-3-5mm-panel.csv

Comment | Designator | Footprint | LCSC | Quantity
D_TVS | D1_0,D1_1,D1_2,D1_3,D2_0,D2_1,D2_2,D2_3,D3_0,D3_1,D3_2,D3_3,D4_0,D4_1,D4_2,D4_3,D5_0,D5_1,D5_2,D5_3,D6_0,D6_1,D6_2,D6_3,D7_0,D7_1,D7_2,D7_3,D8_0,D8_1,D8_2,D8_3 | D_SOD-323 | C7472904 | 32
Conn_02x10_Odd_Even | J1_0,J1_1,J1_2,J1_3 | IDC-Header_2x10_P2.54mm_Vertical | C2977593 | 4
AudioJack4 | J2_0,J2_1,J2_2,J2_3,J3_0,J3_1,J3_2,J3_3,J4_0,J4_1,J4_2,J4_3,J5_0,J5_1,J5_2,J5_3 | Jack_3.5mm_PJ320D_Horizontal | C431535 | 16
100R | R1_0,R1_1,R1_2,R1_3,R2_0,R2_1,R2_2,R2_3 | R_0402_1005Metric | C25076 | 8
470R | R3_0,R3_1,R3_2,R3_3,R4_0,R4_1,R4_2,R4_3,R5_0,R5_1,R5_2,R5_3,R6_0,R6_1,R6_2,R6_3 | R_0603_1608Metric | C23179 | 16
