dotrodeo/rodeo/rev-a/rodeo-rotary-switch/jlcpcb/production_files/BOM-rodeo-rotary-switch.csv

Comment | Designator | Footprint | LCSC | Quantity
100n | C1,C2 | C_0603_1608Metric | C14663 | 2
10K | R4,R7 | R_0603_1608Metric | C25804 | 2
1K | R1,R8 | R_0603_1608Metric | C21190 | 2
2.2K | R2 | R_0603_1608Metric | C4190 | 1
22K | R5 | R_0603_1608Metric | C31850 | 1
4.7K | R3 | R_0603_1608Metric | C23162 | 1
47K | R6 | R_0603_1608Metric | C25819 | 1
Conn_01x03 | J1 | JST_SH_SM03B-SRSS-TB_1x03-1MP_P1.00mm_Horizontal | C160403 | 1
~ | SW1 | SW-TH_SRBV141404 | C470374 | 1
