dotrodeo/rodeo/instruments/rodeo-002/models/Faceplate.3mf

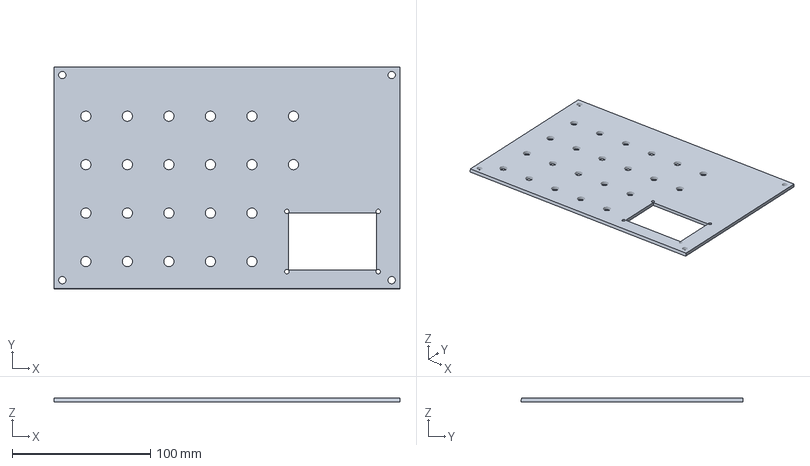
[picture p69: CAD file, 2026-10-06]
instruments/rodeo-002/models/Faceplate.3mf
250.0 x 160.7 x 3.00 mm
