dotrodeo/rodeo/rev-a/rodeo-motherboard/renders/rodeo-motherboard.step

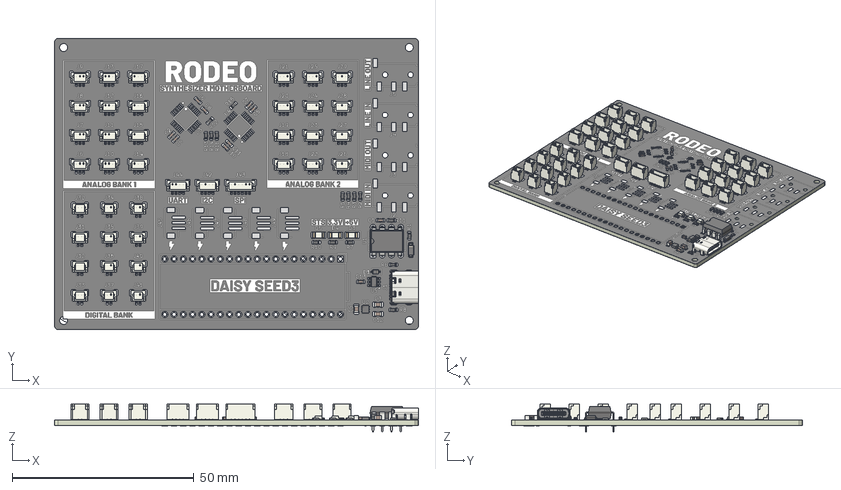
[picture p70: CAD file, 2026-09-17]
rev-a/rodeo-motherboard/renders/rodeo-motherboard.step
100.0 x 80.0 x 7.62 mm
DIP-8_W7.62mm
C_0805_2012Metric x 3
R_0603_1608Metric x 16
JST_SH_BM03B-SRSS-TB_1x03-1MP_P1.00mm_Vertical x 24
C_0603_1608Metric x 10
JST_SH_BM02B-SRSS-TB_1x02-1MP_P1.00mm_Vertical x 12
SOT-23-6
D_SOD-323
LED_1206_3216Metric x 3
WSON_6_1EP_2x2mm_P065mm_EP1x16mm
JST_SH_BM04B-SRSS-TB_1x04-1MP_P1.00mm_Vertical x 2
JST_SH_BM06B-SRSS-TB_1x06-1MP_P1.00mm_Vertical
USB_C_Receptacle_16P_TopMnt_Horizontal_GCT_USB4105-xx-A
D_SOD-123
rodeo-motherboard_pad
rodeo-motherboard_silkscreen x 2
rodeo-motherboard_soldermask x 2
rodeo-motherboard_PCB
