dotrodeo/rodeo/rev-a/rodeo-potentiometer/renders/rodeo-potentiometer.step

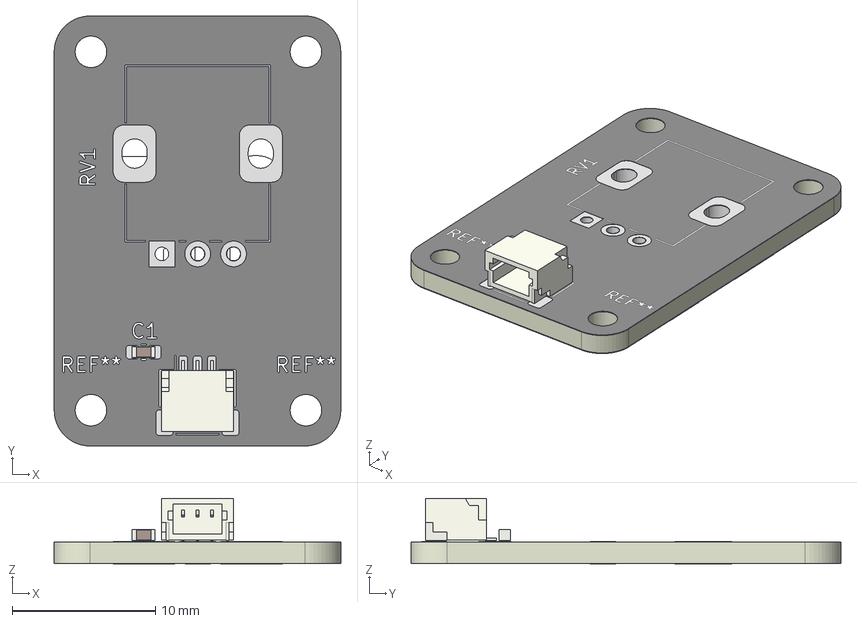
[picture p71: CAD file, 2026-08-21]
rev-a/rodeo-potentiometer/renders/rodeo-potentiometer.step
20.0 x 30.0 x 4.63 mm
C_0603_1608Metric
JST_SH_SM03B-SRSS-TB_1x03-1MP_P1.00mm_Horizontal
rodeo-potentiometer_pad
rodeo-potentiometer_silkscreen x 2
rodeo-potentiometer_soldermask x 2
rodeo-potentiometer_PCB
