dotrodeo/rodeo/rev-a/rodeo-rotary-switch/renders/rodeo-rotary-switch.step

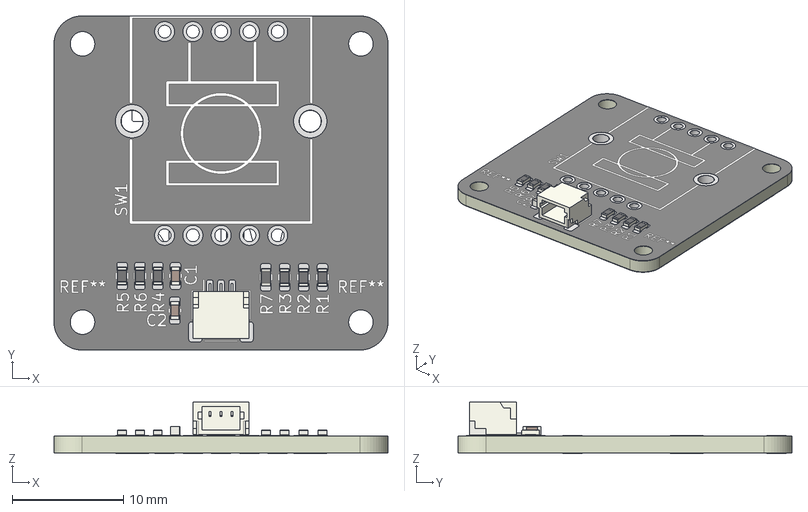
[picture p72: CAD file, 2026-08-21]
rev-a/rodeo-rotary-switch/renders/rodeo-rotary-switch.step
30.0 x 30.0 x 4.63 mm
R_0603_1608Metric x 7
C_0603_1608Metric x 2
JST_SH_SM03B-SRSS-TB_1x03-1MP_P1.00mm_Horizontal
rodeo-rotary-switch_pad
rodeo-rotary-switch_silkscreen x 2
rodeo-rotary-switch_soldermask x 2
rodeo-rotary-switch_PCB
