dotrodeo/rodeo/(list of files, cad)

Other CAD files:
instruments/rodeo-002/models/Faceplate.stl
