dotrodeo/rodeo/(list of files, drawings)

Other design files:
tools/kicad/easyeda-footprints/C1525.json
tools/kicad/easyeda-footprints/C1538.json
tools/kicad/easyeda-footprints/C1779.json
tools/kicad/easyeda-footprints/C4184.json
tools/kicad/easyeda-footprints/C7519.json
tools/kicad/easyeda-footprints/C8598.json
tools/kicad/easyeda-footprints/C11702.json
tools/kicad/easyeda-footprints/C12447.json
tools/kicad/easyeda-footprints/C13612.json
tools/kicad/easyeda-footprints/C14663.json
tools/kicad/easyeda-footprints/C15127.json
tools/kicad/easyeda-footprints/C15195.json
tools/kicad/easyeda-footprints/C15220.json
tools/kicad/easyeda-footprints/C15849.json
tools/kicad/easyeda-footprints/C15850.json
tools/kicad/easyeda-footprints/C17168.json
tools/kicad/easyeda-footprints/C19702.json
tools/kicad/easyeda-footprints/C21190.json
tools/kicad/easyeda-footprints/C22775.json
tools/kicad/easyeda-footprints/C22843.json
tools/kicad/easyeda-footprints/C22908.json
tools/kicad/easyeda-footprints/C23046.json
tools/kicad/easyeda-footprints/C23114.json
tools/kicad/easyeda-footprints/C23140.json
tools/kicad/easyeda-footprints/C23179.json
tools/kicad/easyeda-footprints/C23249.json
tools/kicad/easyeda-footprints/C25076.json
tools/kicad/easyeda-footprints/C25091.json
tools/kicad/easyeda-footprints/C25092.json
tools/kicad/easyeda-footprints/C25105.json
tools/kicad/easyeda-footprints/C25126.json
tools/kicad/easyeda-footprints/C25741.json
tools/kicad/easyeda-footprints/C25744.json
tools/kicad/easyeda-footprints/C25756.json
tools/kicad/easyeda-footprints/C25772.json
tools/kicad/easyeda-footprints/C25792.json
tools/kicad/easyeda-footprints/C25803.json
tools/kicad/easyeda-footprints/C25804.json
tools/kicad/easyeda-footprints/C25850.json
tools/kicad/easyeda-footprints/C25867.json
tools/kicad/easyeda-footprints/C25879.json
tools/kicad/easyeda-footprints/C25903.json
tools/kicad/easyeda-footprints/C25905.json
tools/kicad/easyeda-footprints/C25912.json
tools/kicad/easyeda-footprints/C25918.json
tools/kicad/easyeda-footprints/C26083.json
tools/kicad/easyeda-footprints/C31850.json
tools/kicad/easyeda-footprints/C45783.json
tools/kicad/easyeda-footprints/C46316.json
tools/kicad/easyeda-footprints/C48939.json
tools/kicad/easyeda-footprints/C52036.json
tools/kicad/easyeda-footprints/C52269.json
tools/kicad/easyeda-footprints/C52923.json
tools/kicad/easyeda-footprints/C60344.json
tools/kicad/easyeda-footprints/C67014.json
tools/kicad/easyeda-footprints/C69335.json
tools/kicad/easyeda-footprints/C70078.json
tools/kicad/easyeda-footprints/C72484.json
tools/kicad/easyeda-footprints/C72502.json
tools/kicad/easyeda-footprints/C72522.json
tools/kicad/easyeda-footprints/C81598.json
tools/kicad/easyeda-footprints/C82297.json
tools/kicad/easyeda-footprints/C83571.json
tools/kicad/easyeda-footprints/C85833.json
tools/kicad/easyeda-footprints/C85840.json
tools/kicad/easyeda-footprints/C87037.json
tools/kicad/easyeda-footprints/C96123.json
tools/kicad/easyeda-footprints/C96446.json
tools/kicad/easyeda-footprints/C106259.json
tools/kicad/easyeda-footprints/C107039.json
tools/kicad/easyeda-footprints/C107626.json
tools/kicad/easyeda-footprints/C109322.json
tools/kicad/easyeda-footprints/C113474.json
tools/kicad/easyeda-footprints/C113974.json
tools/kicad/easyeda-footprints/C122548.json
tools/kicad/easyeda-footprints/C125107.json
tools/kicad/easyeda-footprints/C132141.json
tools/kicad/easyeda-footprints/C143790.json
tools/kicad/easyeda-footprints/C157915.json
tools/kicad/easyeda-footprints/C157974.json
tools/kicad/easyeda-footprints/C160315.json
tools/kicad/easyeda-footprints/C160352.json
tools/kicad/easyeda-footprints/C160388.json
tools/kicad/easyeda-footprints/C160389.json
tools/kicad/easyeda-footprints/C160390.json
tools/kicad/easyeda-footprints/C160391.json
tools/kicad/easyeda-footprints/C160393.json
tools/kicad/easyeda-footprints/C160403.json
tools/kicad/easyeda-footprints/C160469.json
tools/kicad/easyeda-footprints/C161617.json
tools/kicad/easyeda-footprints/C165948.json
tools/kicad/easyeda-footprints/C168839.json
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
