dotrodeo/rodeo/hardware/rodeo-rotary-switch-1/rodeo-rotary-switch-1.kicad_pcb

## KiCad design hardware/rodeo-rotary-switch-1/rodeo-rotary-switch-1.kicad_pcb (2026-10-27)

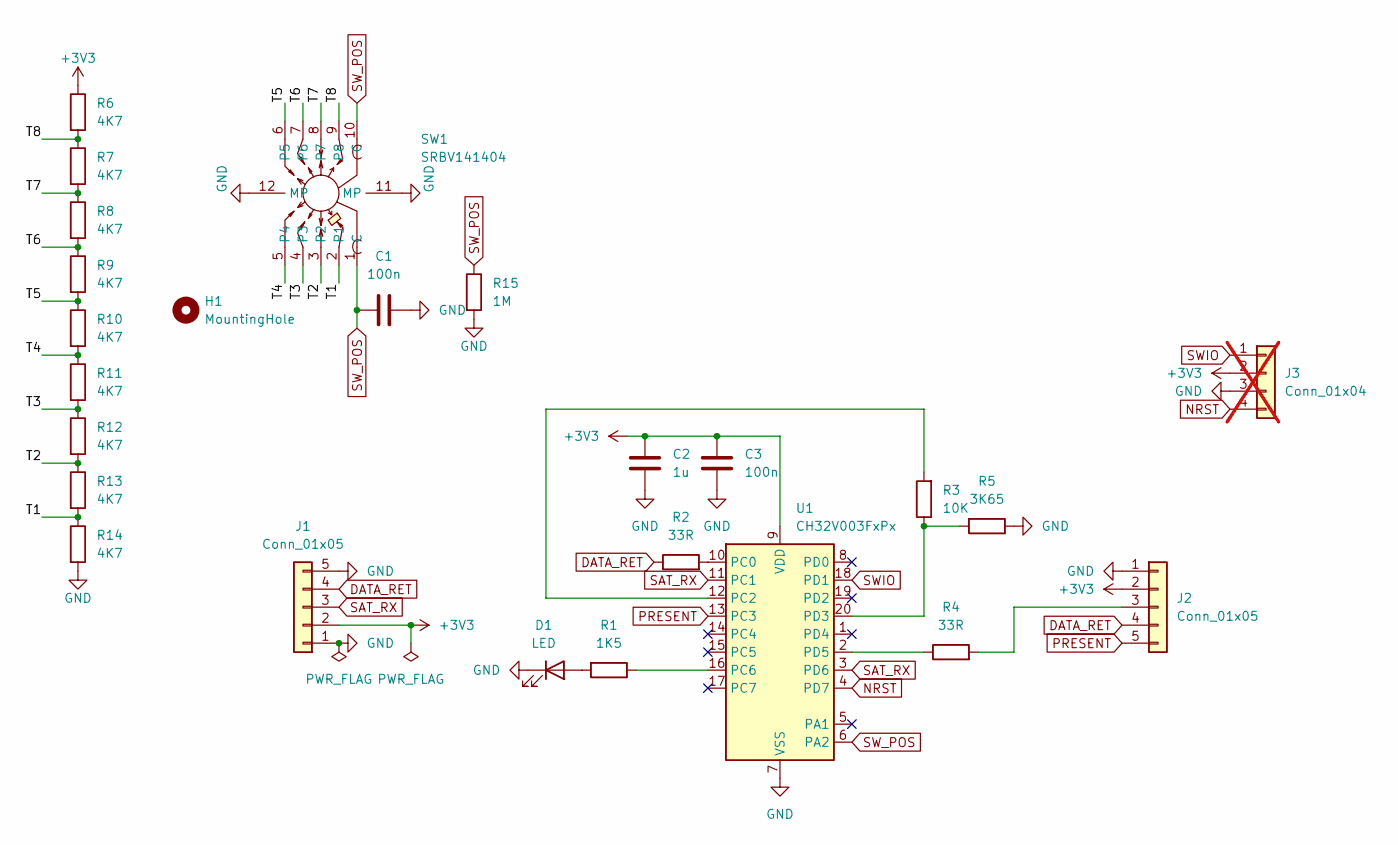
[picture p73: schematic rodeo-rotary-switch-1.kicad_sch]

Parts:
C1, C3: 100n; C_0402_1005Metric; LCSC Part C1525
C2: 1u; C_0402_1005Metric; LCSC Part C52923
D1: LED; LED_1206_3216Metric_ReverseMount_Hole1.8x2.4mm; LCSC Part C125107
H1: MountingHole; MountingHole_2.2mm_M2
J1, J2: Conn_01x05; JST_SH_BM05B-SRSS-TB_1x05-1MP_P1.00mm_Vertical; LCSC Part C160391
J3: Conn_01x04; PinHeader_1x04_P2.54mm_Vertical; not fitted
R1: 1K5; R_0603_1608Metric; LCSC Part C22843
R2, R4: 33R; R_0603_1608Metric; LCSC Part C23140
R3: 10K; R_0603_1608Metric; LCSC Part C25804
R5: 3K65; R_0603_1608Metric; LCSC Part C2930089
R6, R7, R8, R9, R10, R11, R12, R13, R14: 4K7; R_0603_1608Metric; LCSC Part C23162
R15: 1M; R_0603_1608Metric; LCSC Part C22935
SW1: SRBV141404; SW_Alps_SRBV; MPN SRBV141404; LCSC Part C209777
U1: CH32V003FxPx; TSSOP-20_4.4x6.5mm_P0.65mm; LCSC Part C5187096

Connections:
+3V3: C2.2, C3.2, J1.2, J2.2, J3.2, R6.1, U1.9 (VDD)
/T1: R13.2, R14.1, SW1.2 (P1)
/T2: R12.2, R13.1, SW1.3 (P2)
/T3: R11.2, R12.1, SW1.4 (P3)
/T4: R10.2, R11.1, SW1.5 (P4)
/T5: R9.2, R10.1, SW1.6 (P5)
/T6: R8.2, R9.1, SW1.7 (P6)
/T7: R7.2, R8.1, SW1.8 (P7)
/T8: R6.2, R7.1, SW1.9 (P8)
DATA_RET: J1.4, J2.4, R2.1
GND: C1.2, C2.1, C3.1, D1.1 (K), J1.1, J1.5, J2.1, J3.3, R5.1, R14.2, R15.2, SW1.11 (MP), SW1.12 (MP), U1.7 (VSS)
NRST: J3.4, U1.4 (PD7)
unnamed: D1.2 (A), R1.2
unnamed: J2.3, R4.2
unnamed: R2.2, U1.10 (PC0)
unnamed: R3.2, U1.12 (PC2)
unnamed: R1.1, U1.16 (PC6)
unnamed: R3.1, R5.2, U1.20 (PD3)
unnamed: R4.1, U1.2 (PD5)
PRESENT: J2.5, U1.13 (PC3)
SAT_RX: J1.3, U1.3 (PD6), U1.11 (PC1)
SWIO: J3.1, U1.18 (PD1)
SW_POS: C1.1, R15.1, SW1.1 (C), SW1.10 (C), U1.6 (PA2)

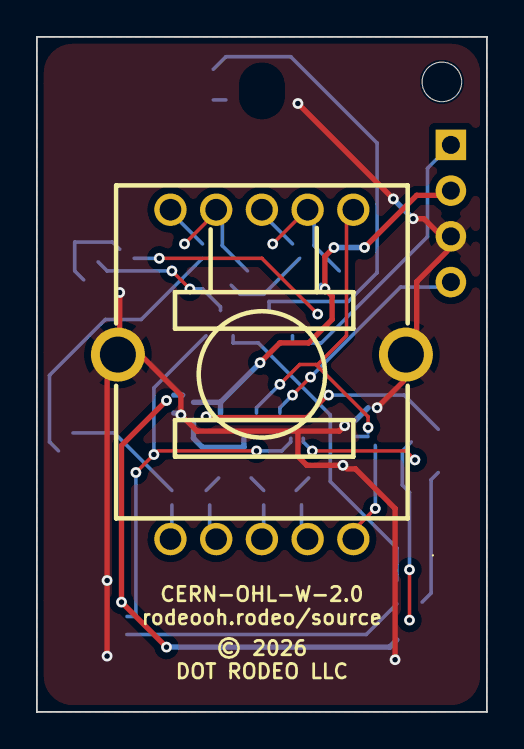
[picture p74: board rodeo-rotary-switch-1.kicad_pcb from above]

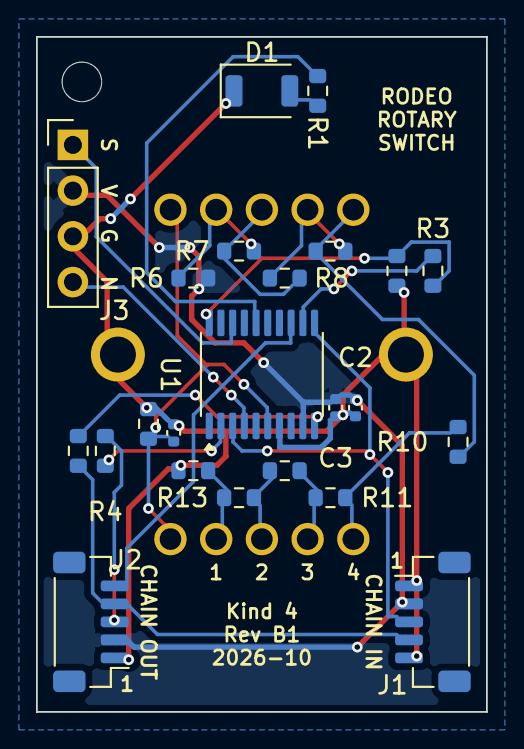
[picture p75: board rodeo-rotary-switch-1.kicad_pcb from below]

Board: 2 copper layers, 25.0 x 37.5 mm, 25 parts (23 on the bottom side), 23 nets.
