dotrodeo/rodeo/hardware/rodeo-button-bank-4/rodeo-button-bank-4.kicad_pcb

## KiCad design hardware/rodeo-button-bank-4/rodeo-button-bank-4.kicad_pcb (2026-10-23)

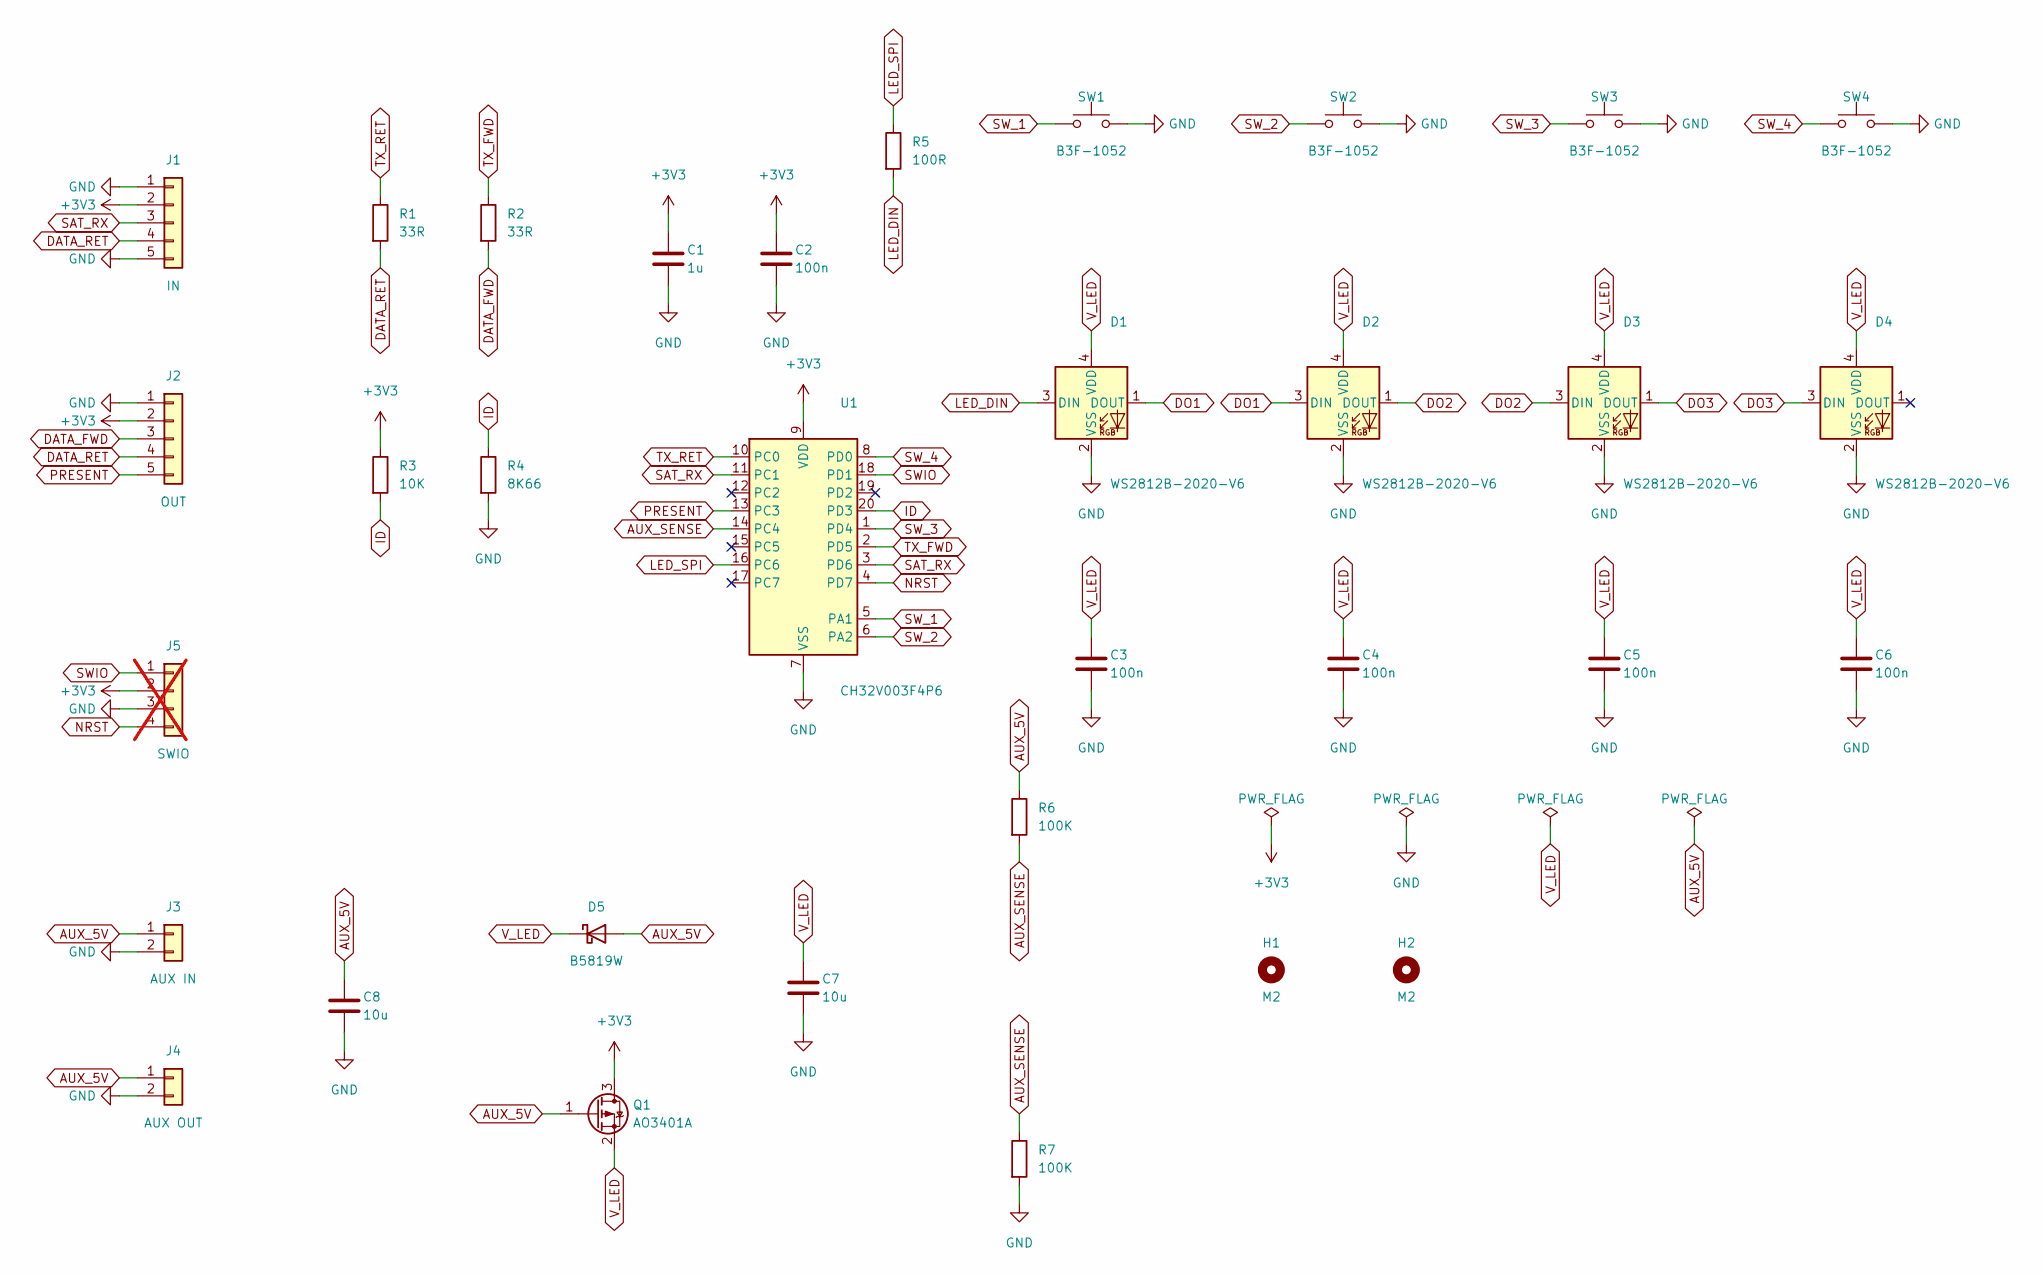
[picture p76: schematic rodeo-button-bank-4.kicad_sch, Rodeo button bank x4]

Parts:
C1: 1u; C_0402_1005Metric; LCSC Part C52923
C2, C3, C4, C5, C6: 100n; C_0402_1005Metric; LCSC Part C1525
C7, C8: 10u; C_0603_1608Metric; LCSC Part C19702
D1, D2, D3, D4: WS2812B-2020-V6; LED_WS2812B-2020_PLCC4_2.0x2.0mm; LCSC Part C52917434
D5: B5819W; D_SOD-123; LCSC Part C8598
H1, H2: M2; MountingHole_2.2mm_M2
J1: IN; JST_SH_BM05B-SRSS-TB_1x05-1MP_P1.00mm_Vertical; LCSC Part C160391
J2: OUT; JST_SH_BM05B-SRSS-TB_1x05-1MP_P1.00mm_Vertical; LCSC Part C160391
J3: AUX IN; JST_PH_B2B-PH-SM4-TB_1x02-1MP_P2.00mm_Vertical; LCSC Part C160352
J4: AUX OUT; JST_PH_B2B-PH-SM4-TB_1x02-1MP_P2.00mm_Vertical; LCSC Part C160352
J5: SWIO; PinHeader_1x04_P2.54mm_Vertical; not fitted
Q1: AO3401A; SOT-23; LCSC Part C15127
R1, R2: 33R; R_0603_1608Metric; LCSC Part C23140
R3: 10K; R_0603_1608Metric; LCSC Part C25804
R4: 8K66; R_0603_1608Metric; LCSC Part C23114
R5: 100R; R_0603_1608Metric; LCSC Part C22775
R6, R7: 100K; R_0603_1608Metric; LCSC Part C25803
SW1, SW2, SW3, SW4: B3F-1052; SW_PUSH_6mm; LCSC Part C87037
U1: CH32V003F4P6; TSSOP-20_4.4x6.5mm_P0.65mm; LCSC Part C5187096

Connections:
+3V3: C1.1, C2.1, J1.2, J2.2, J5.2, Q1.3 (D), R3.1, U1.9 (VDD)
AUX_5V: C8.1, D5.2 (A), J3.1, J4.1, Q1.1 (G), R6.1
AUX_SENSE: R6.2, R7.1, U1.14 (PC4)
DATA_FWD: J2.3, R2.2
DATA_RET: J1.4, J2.4, R1.2
DO1: D1.1 (DOUT), D2.3 (DIN)
DO2: D2.1 (DOUT), D3.3 (DIN)
DO3: D3.1 (DOUT), D4.3 (DIN)
GND: C1.2, C2.2, C3.2, C4.2, C5.2, C6.2, C7.2, C8.2, D1.2 (VSS), D2.2 (VSS), D3.2 (VSS), D4.2 (VSS), J1.1, J1.5, J2.1, J3.2, J4.2, J5.3, R4.2, R7.2, SW1.2, SW2.2, SW3.2, SW4.2, U1.7 (VSS)
ID: R3.2, R4.1, U1.20 (PD3)
LED_DIN: D1.3 (DIN), R5.2
LED_SPI: R5.1, U1.16 (PC6)
NRST: J5.4, U1.4 (PD7)
PRESENT: J2.5, U1.13 (PC3)
SAT_RX: J1.3, U1.3 (PD6), U1.11 (PC1)
SWIO: J5.1, U1.18 (PD1)
SW_1: SW1.1, U1.5 (PA1)
SW_2: SW2.1, U1.6 (PA2)
SW_3: SW3.1, U1.1 (PD4)
SW_4: SW4.1, U1.8 (PD0)
TX_FWD: R2.1, U1.2 (PD5)
TX_RET: R1.1, U1.10 (PC0)
V_LED: C3.1, C4.1, C5.1, C6.1, C7.1, D1.4 (VDD), D2.4 (VDD), D3.4 (VDD), D4.4 (VDD), D5.1 (K), Q1.2 (S)

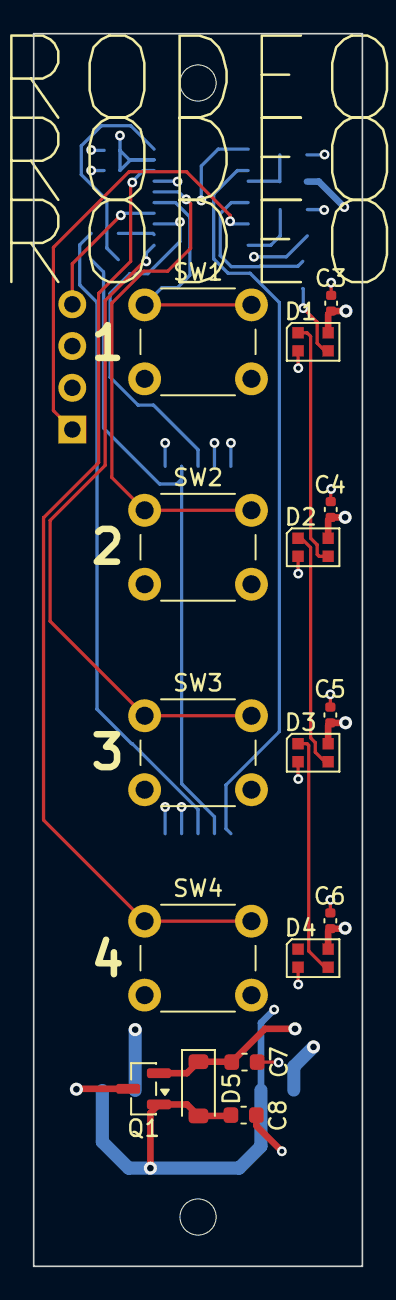
[picture p77: board rodeo-button-bank-4.kicad_pcb from above]

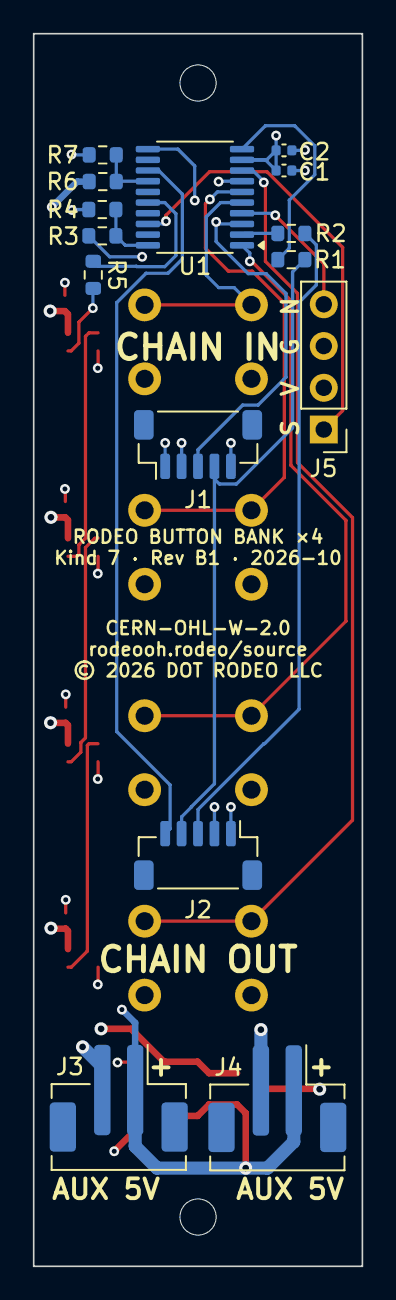
[picture p78: board rodeo-button-bank-4.kicad_pcb from below]

Board: 4 copper layers, 20.0 x 75.0 mm, 33 parts (15 on the bottom side), 23 nets.
