dotrodeo/rodeo/hardware/rodeo-power-usbc/rodeo-power-usbc.kicad_pcb

## KiCad design hardware/rodeo-power-usbc/rodeo-power-usbc.kicad_pcb (2026-10-16)

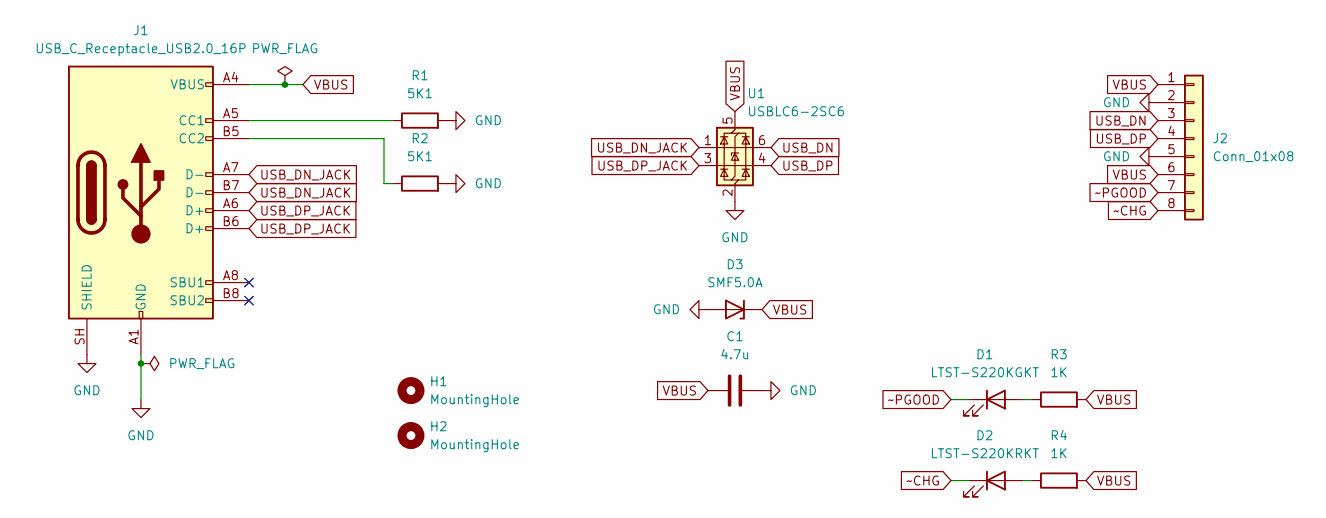
[picture p79: schematic rodeo-power-usbc.kicad_sch]

Parts:
C1: 4.7u; C_0603_1608Metric; LCSC Part C69335
D1: LTST-S220KGKT; LED_LiteOn_LTST-S220_SideView; LCSC Part C160469
D2: LTST-S220KRKT; LED_LiteOn_LTST-S220_SideView; LCSC Part C284935
D3: SMF5.0A; D_SOD-123F; LCSC Part C193402
H1, H2: MountingHole; MountingHole_3.2mm_M3
J1: USB_C_Receptacle_USB2.0_16P; USB_C_Receptacle_HRO_TYPE-C-31-M-12; LCSC Part C165948
J2: Conn_01x08; JST_PH_B8B-PH-K_1x08_P2.00mm_Vertical; LCSC Part C157974
R1, R2: 5K1; R_0402_1005Metric; LCSC Part C25905
R3, R4: 1K; R_0402_1005Metric; LCSC Part C11702
U1: USBLC6-2SC6; SOT-23-6; LCSC Part C7519

Connections:
GND: C1.2, D3.2 (A), J1.A1 (GND), J1.A12 (GND), J1.B1 (GND), J1.B12 (GND), J1.SH (SHIELD), J2.2, J2.5, R1.2, R2.2, U1.2 (GND)
unnamed: D1.2 (A), R3.1
unnamed: D2.2 (A), R4.1
unnamed: J1.A5 (CC1), R1.1
unnamed: J1.B5 (CC2), R2.1
USB_DN: J2.3, U1.6 (I/O1)
USB_DN_JACK: J1.A7 (D-), J1.B7 (D-), U1.1 (I/O1)
USB_DP: J2.4, U1.4 (I/O2)
USB_DP_JACK: J1.A6 (D+), J1.B6 (D+), U1.3 (I/O2)
VBUS: C1.1, D3.1 (K), J1.A4 (VBUS), J1.A9 (VBUS), J1.B4 (VBUS), J1.B9 (VBUS), J2.1, J2.6, R3.2, R4.2, U1.5 (VBUS)
~CHG: D2.1 (K), J2.8
~PGOOD: D1.1 (K), J2.7

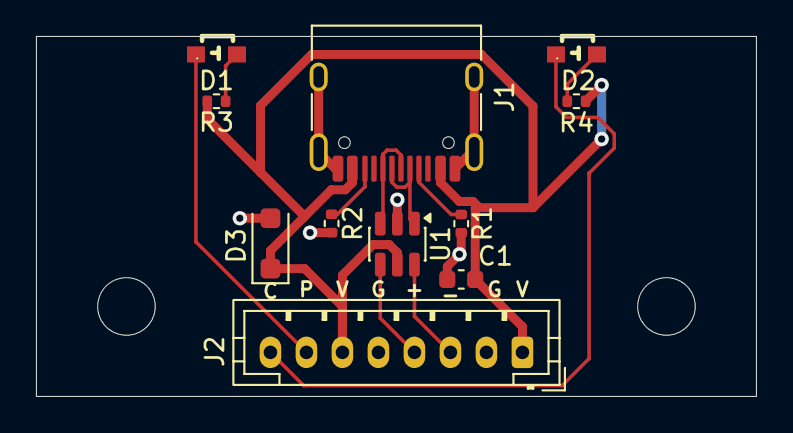
[picture p80: board rodeo-power-usbc.kicad_pcb from above]

Board: 2 copper layers, 40.0 x 20.0 mm, 13 parts (0 on the bottom side), 12 nets.
