dotrodeo/rodeo/hardware/rodeo-power-switch/rodeo-power-switch.kicad_pcb

## KiCad design hardware/rodeo-power-switch/rodeo-power-switch.kicad_pcb (2026-10-16)

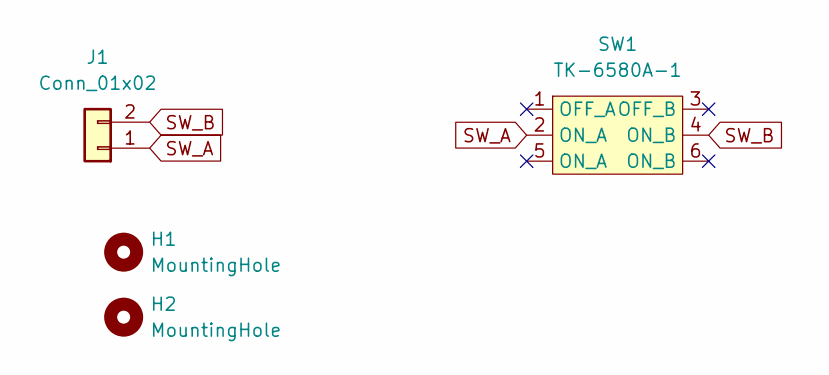
[picture p81: schematic rodeo-power-switch.kicad_sch]

Parts:
H1, H2: MountingHole; MountingHole_3.2mm_M3
J1: Conn_01x02; JST_SH_BM02B-SRSS-TB_1x02-1MP_P1.00mm_Vertical; LCSC Part C160388
SW1: TK-6580A-1; SW-TH_TK-6580A-1; MPN TK-6580A-1; LCSC Part C528770

Connections:
SW_A: J1.1, SW1.2 (ON_A)
SW_B: J1.2, SW1.4 (ON_B)

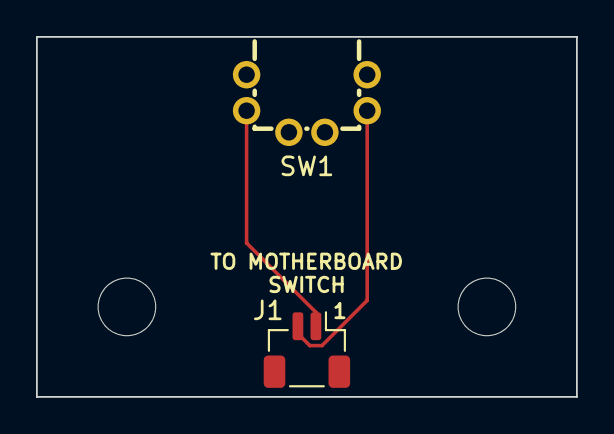
[picture p82: board rodeo-power-switch.kicad_pcb from above]

Board: 2 copper layers, 30.0 x 20.0 mm, 4 parts (0 on the bottom side), 2 nets.
