dotrodeo/rodeo/hardware/rodeo-motherboard/rodeo-motherboard.kicad_pcb

## KiCad design hardware/rodeo-motherboard/rodeo-motherboard.kicad_pcb (2026-10-16)

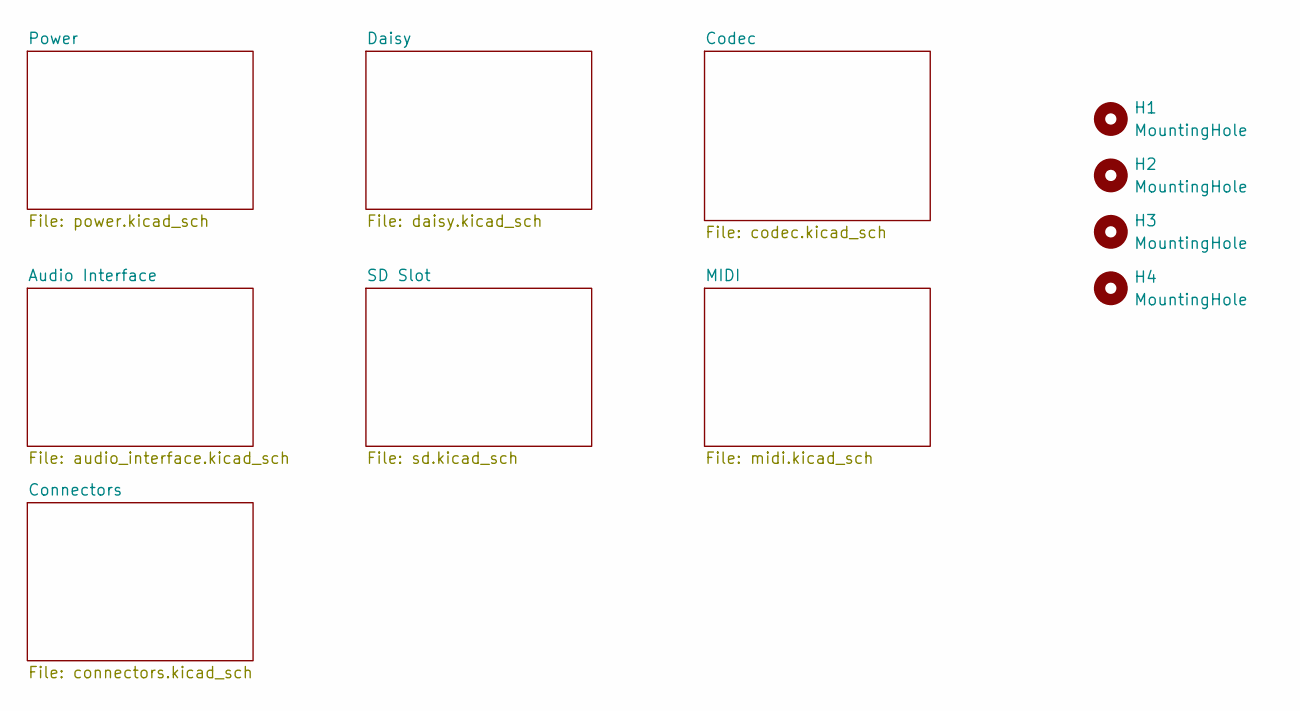
[picture p83: schematic rodeo-motherboard.kicad_sch]

Parts:
H1, H2, H3, H4: MountingHole; MountingHole_3.2mm_M3

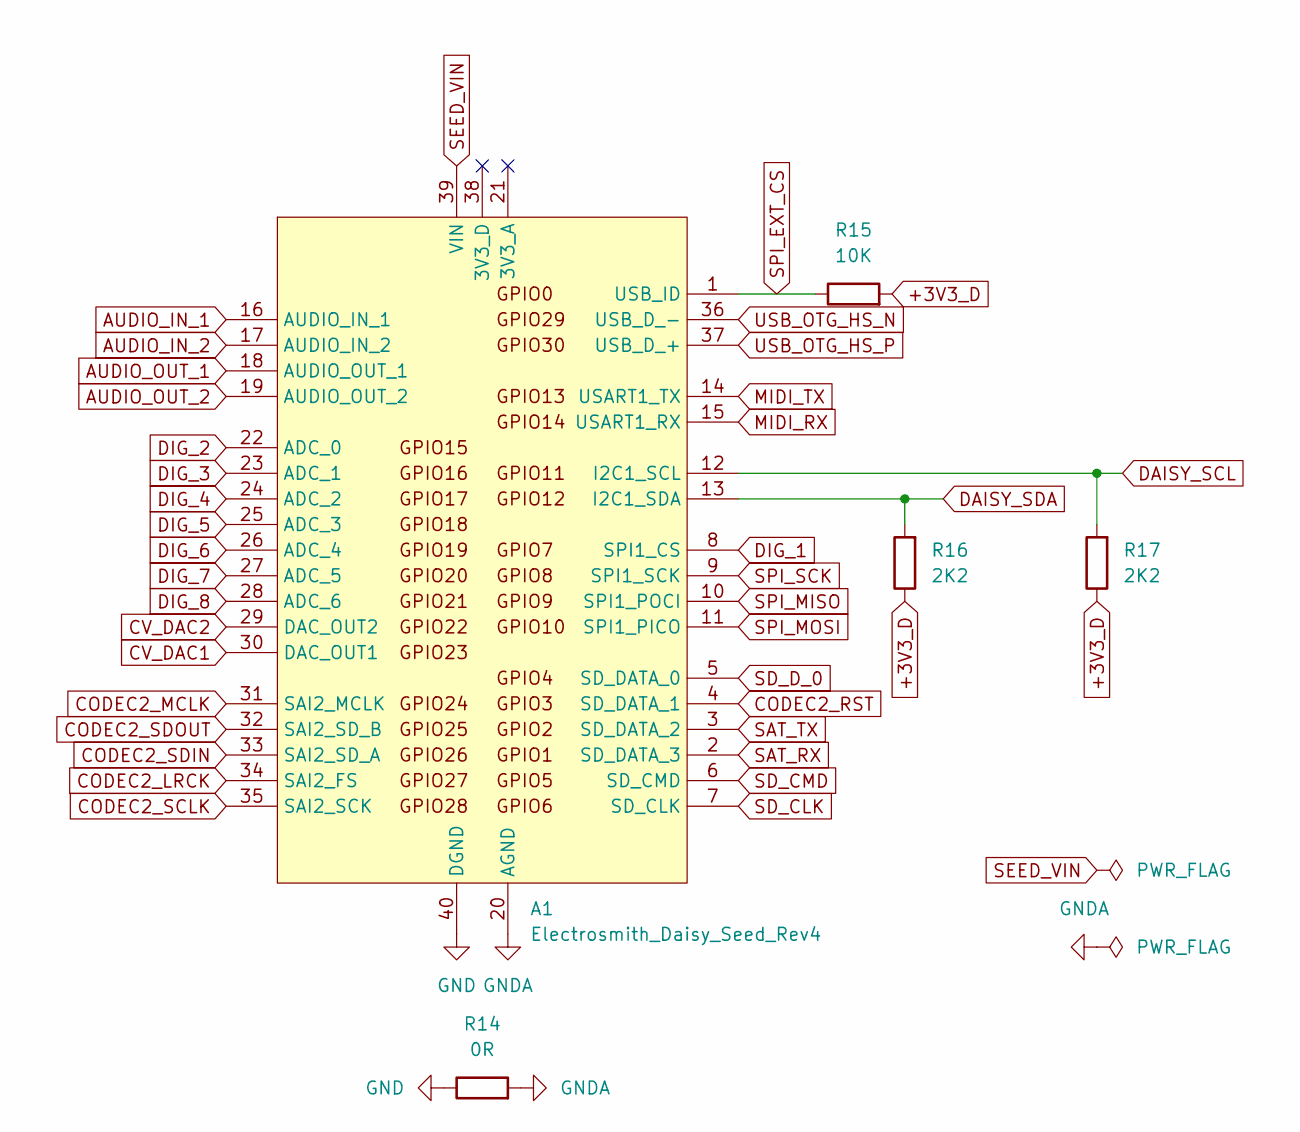
[picture p84: schematic daisy.kicad_sch]

Parts:
A1: Electrosmith_Daisy_Seed_Rev4; Electrosmith_Daisy_Seed
R14: 0R; R_0402_1005Metric; LCSC Part C17168
R15: 10K; R_0402_1005Metric; LCSC Part C25744
R16, R17: 2K2; R_0402_1005Metric; LCSC Part C25879

Connections:
+3V3_D: R15.2, R16.1, R17.1; also elsewhere on the board
AUDIO_IN_1: A1.16 (AUDIO_IN_1); also elsewhere on the board
AUDIO_IN_2: A1.17 (AUDIO_IN_2); also elsewhere on the board
AUDIO_OUT_1: A1.18 (AUDIO_OUT_1); also elsewhere on the board
AUDIO_OUT_2: A1.19 (AUDIO_OUT_2); also elsewhere on the board
CODEC2_LRCK: A1.34 (SAI2_FS); also elsewhere on the board
CODEC2_MCLK: A1.31 (SAI2_MCLK); also elsewhere on the board
CODEC2_RST: A1.4 (SD_DATA_1); also elsewhere on the board
CODEC2_SCLK: A1.35 (SAI2_SCK); also elsewhere on the board
CODEC2_SDIN: A1.33 (SAI2_SD_A); also elsewhere on the board
CODEC2_SDOUT: A1.32 (SAI2_SD_B); also elsewhere on the board
CV_DAC1: A1.30 (DAC_OUT1); also elsewhere on the board
CV_DAC2: A1.29 (DAC_OUT2); also elsewhere on the board
DAISY_SCL: A1.12 (I2C1_SCL), R17.2; also elsewhere on the board
DAISY_SDA: A1.13 (I2C1_SDA), R16.2; also elsewhere on the board
DIG_1: A1.8 (SPI1_CS); also elsewhere on the board
DIG_2: A1.22 (ADC_0); also elsewhere on the board
DIG_3: A1.23 (ADC_1); also elsewhere on the board
DIG_4: A1.24 (ADC_2); also elsewhere on the board
DIG_5: A1.25 (ADC_3); also elsewhere on the board
DIG_6: A1.26 (ADC_4); also elsewhere on the board
DIG_7: A1.27 (ADC_5); also elsewhere on the board
DIG_8: A1.28 (ADC_6); also elsewhere on the board
GND: A1.40 (DGND), R14.1; also elsewhere on the board
GNDA: A1.20 (AGND), R14.2
MIDI_RX: A1.15 (USART1_RX); also elsewhere on the board
MIDI_TX: A1.14 (USART1_TX); also elsewhere on the board
SAT_RX: A1.2 (SD_DATA_3); also elsewhere on the board
SAT_TX: A1.3 (SD_DATA_2); also elsewhere on the board
SD_CLK: A1.7 (SD_CLK); also elsewhere on the board
SD_CMD: A1.6 (SD_CMD); also elsewhere on the board
SD_D_0: A1.5 (SD_DATA_0); also elsewhere on the board
SEED_VIN: A1.39 (VIN); also elsewhere on the board
SPI_EXT_CS: A1.1 (USB_ID), R15.1; also elsewhere on the board
SPI_MISO: A1.10 (SPI1_POCI); also elsewhere on the board
SPI_MOSI: A1.11 (SPI1_PICO); also elsewhere on the board
SPI_SCK: A1.9 (SPI1_SCK); also elsewhere on the board
USB_OTG_HS_N: A1.36 (USB_D_-); also elsewhere on the board
USB_OTG_HS_P: A1.37 (USB_D_+); also elsewhere on the board

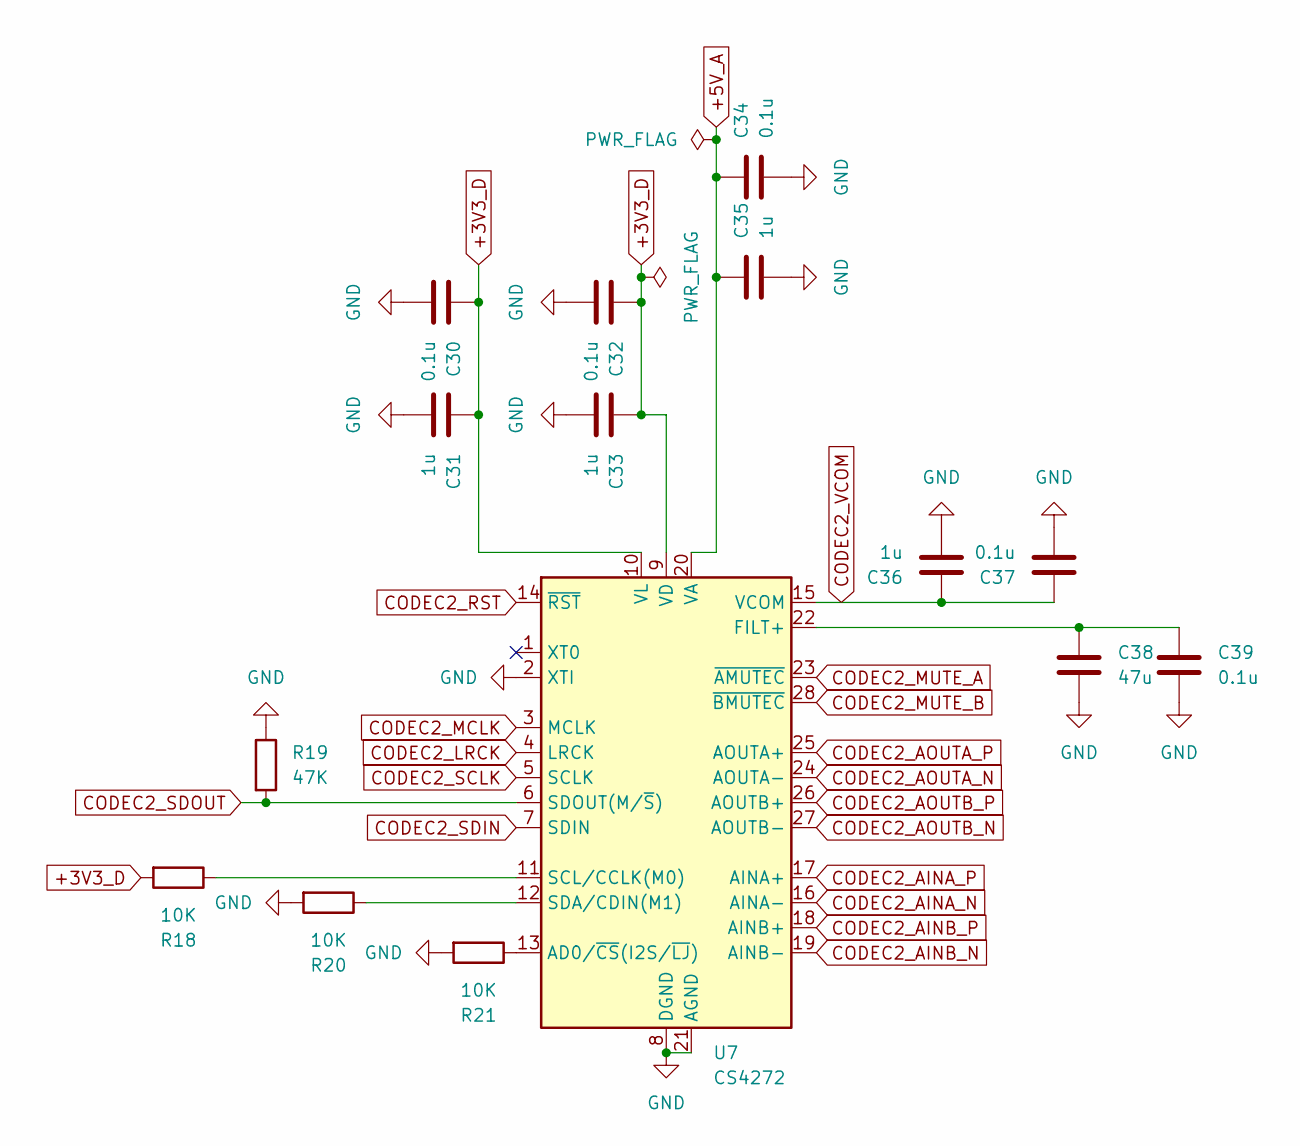
[picture p85: schematic codec.kicad_sch]

Parts:
C30, C32, C34, C37, C39: 0.1u; C_0402_1005Metric; LCSC Part C1525
C31, C33, C35, C36: 1u; C_0402_1005Metric; LCSC Part C52923
C38: 47u; C_1206_3216Metric; LCSC Part C96123
R18, R20, R21: 10K; R_0402_1005Metric; LCSC Part C25744
R19: 47K; R_0402_1005Metric; LCSC Part C25792
U7: CS4272; TSSOP-28_4.4x9.7mm_P0.65mm; LCSC Part C2151111

Connections:
+3V3_D: C30.2, C31.2, C32.2, C33.2, R18.2, U7.9 (VD), U7.10 (VL); also elsewhere on the board
+5V_A: C34.2, C35.2, U7.20 (VA); also elsewhere on the board
CODEC2_AINA_N: U7.16 (AINA-); also elsewhere on the board
CODEC2_AINA_P: U7.17 (AINA+); also elsewhere on the board
CODEC2_AINB_N: U7.19 (AINB-); also elsewhere on the board
CODEC2_AINB_P: U7.18 (AINB+); also elsewhere on the board
CODEC2_AOUTA_N: U7.24 (AOUTA-); also elsewhere on the board
CODEC2_AOUTA_P: U7.25 (AOUTA+); also elsewhere on the board
CODEC2_AOUTB_N: U7.27 (AOUTB-); also elsewhere on the board
CODEC2_AOUTB_P: U7.26 (AOUTB+); also elsewhere on the board
CODEC2_LRCK: U7.4 (LRCK); also elsewhere on the board
CODEC2_MCLK: U7.3 (MCLK); also elsewhere on the board
CODEC2_MUTE_A: U7.23 (~AMUTEC); also elsewhere on the board
CODEC2_MUTE_B: U7.28 (~BMUTEC); also elsewhere on the board
CODEC2_RST: U7.14 (~RST); also elsewhere on the board
CODEC2_SCLK: U7.5 (SCLK); also elsewhere on the board
CODEC2_SDIN: U7.7 (SDIN); also elsewhere on the board
CODEC2_SDOUT: R19.2, U7.6 (SDOUT(M/~S)); also elsewhere on the board
CODEC2_VCOM: C36.2, C37.2, U7.15 (VCOM)
GND: C30.1, C31.1, C32.1, C33.1, C34.1, C35.1, C36.1, C37.1, C38.2, C39.1, R19.1, R20.2, R21.2, U7.2 (XTI), U7.8 (DGND), U7.21 (AGND); also elsewhere on the board
unnamed: R21.1, U7.13 (AD0/~CS(I2S/~LJ))
unnamed: C38.1, C39.2, U7.22 (FILT+)
unnamed: R18.1, U7.11 (SCL/CCLK(M0))
unnamed: R20.1, U7.12 (SDA/CDIN(M1))

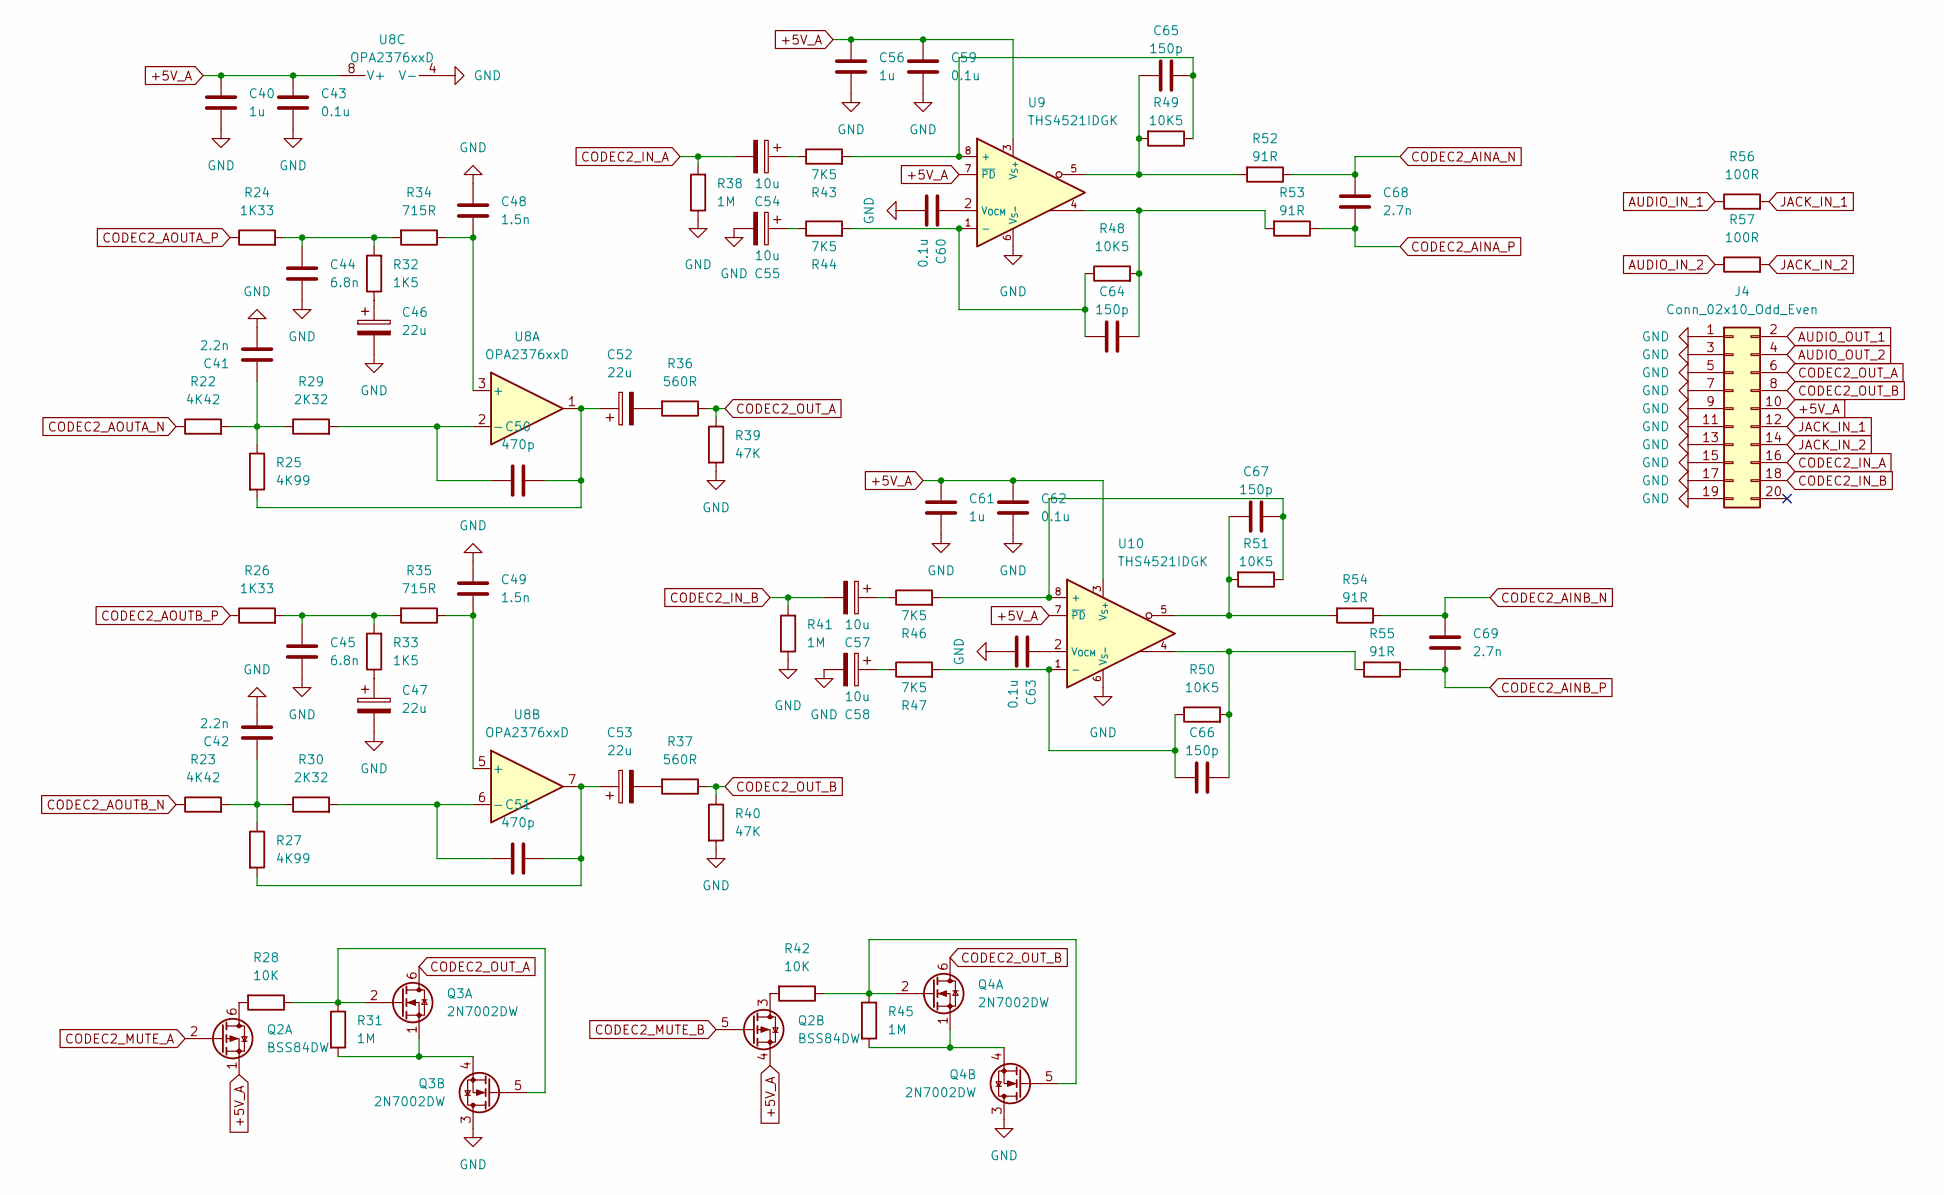
[picture p86: schematic audio_interface.kicad_sch]

Parts:
C40, C56, C61: 1u; C_0402_1005Metric; LCSC Part C52923
C41, C42: 2.2n; C_0603_1608Metric; LCSC Part C296055
C43, C59, C60, C62, C63: 0.1u; C_0402_1005Metric; LCSC Part C1525
C44, C45: 6.8n; C_0603_1608Metric; LCSC Part C513559
C46, C47, C52, C53: 22u; CP_Elec_4x5.4; LCSC Part C72502
C48, C49: 1.5n; C_0603_1608Metric; LCSC Part C107039
C50, C51: 470p; C_0402_1005Metric; LCSC Part C106259
C54, C55, C57, C58: 10u; CP_Elec_4x5.4; LCSC Part C72484
C64, C65, C66, C67: 150p; C_0402_1005Metric; LCSC Part C541469
C68, C69: 2.7n; C_0603_1608Metric; LCSC Part C388043
J4: Conn_02x10_Odd_Even; IDC-Header_2x10_P2.54mm_Vertical; LCSC Part C2977593
Q2: BSS84DW; SOT-363_SC-70-6; LCSC Part C161617
Q3, Q4: 2N7002DW; SOT-363_SC-70-6; LCSC Part C83571
R22, R23: 4K42; R_0402_1005Metric; LCSC Part C52269
R24, R26: 1K33; R_0402_1005Metric; LCSC Part C423242
R25, R27: 4K99; R_0402_1005Metric; LCSC Part C25903
R28, R42: 10K; R_0402_1005Metric; LCSC Part C25744
R29, R30: 2K32; R_0402_1005Metric; LCSC Part C82297
R31, R38, R41, R45: 1M; R_0402_1005Metric; LCSC Part C26083
R32, R33: 1K5; R_0402_1005Metric; LCSC Part C25867
R34, R35: 715R; R_0402_1005Metric; LCSC Part C113474
R36, R37: 560R; R_0402_1005Metric; LCSC Part C25126
R39, R40: 47K; R_0402_1005Metric; LCSC Part C25792
R43, R44, R46, R47: 7K5; R_0402_1005Metric; LCSC Part C25918
R48, R49, R50, R51: 10K5; R_0402_1005Metric; LCSC Part C25850
R52, R53, R54, R55: 91R; R_0402_1005Metric; LCSC Part C270574
R56, R57: 100R; R_0402_1005Metric; LCSC Part C25076
U8: OPA2376xxD; SOIC-8_3.9x4.9mm_P1.27mm; LCSC Part C46316
U9, U10: THS4521IDGK; VSSOP-8_3x3mm_P0.65mm; LCSC Part C170157

Connections:
+5V_A: C40.2, C43.1, C56.2, C59.1, C61.2, C62.1, J4.10, Q2.1 (S), Q2.4 (S), U8.8 (V+), U9.3 (V_{S+}), U9.7 (~PD), U10.3 (V_{S+}), U10.7 (~PD); also elsewhere on the board
AUDIO_IN_1: R56.1; also elsewhere on the board
AUDIO_IN_2: R57.1; also elsewhere on the board
AUDIO_OUT_1: J4.2; also elsewhere on the board
AUDIO_OUT_2: J4.4; also elsewhere on the board
CODEC2_AINA_N: C68.2, R52.1; also elsewhere on the board
CODEC2_AINA_P: C68.1, R53.1; also elsewhere on the board
CODEC2_AINB_N: C69.2, R54.1; also elsewhere on the board
CODEC2_AINB_P: C69.1, R55.1; also elsewhere on the board
CODEC2_AOUTA_N: R22.1; also elsewhere on the board
CODEC2_AOUTA_P: R24.1; also elsewhere on the board
CODEC2_AOUTB_N: R23.1; also elsewhere on the board
CODEC2_AOUTB_P: R26.1; also elsewhere on the board
CODEC2_IN_A: C54.2, J4.16, R38.2
CODEC2_IN_B: C57.2, J4.18, R41.2
CODEC2_MUTE_A: Q2.2 (G); also elsewhere on the board
CODEC2_MUTE_B: Q2.5 (G); also elsewhere on the board
CODEC2_OUT_A: J4.6, Q3.6 (D), R36.1, R39.1
CODEC2_OUT_B: J4.8, Q4.6 (D), R37.1, R40.1
GND: C40.1, C41.2, C42.2, C43.2, C44.1, C45.1, C46.2, C47.2, C48.2, C49.2, C55.2, C56.1, C58.2, C59.2, C60.2, C61.1, C62.2, C63.2, J4.1, J4.3, J4.5, J4.7, J4.9, J4.11, J4.13, J4.15, J4.17, J4.19, Q3.3 (D), Q4.3 (D), R38.1, R39.2, R40.2, R41.1, U8.4 (V-), U9.6 (V_{S-}), U10.6 (V_{S-}); also elsewhere on the board
JACK_IN_1: J4.12, R56.2
JACK_IN_2: J4.14, R57.2
unnamed: C41.1, R22.2, R25.1, R29.1
unnamed: C42.1, R23.2, R27.1, R30.1
unnamed: C44.2, R24.2, R32.2, R34.2
unnamed: C45.2, R26.2, R33.2, R35.2
unnamed: C46.1, R32.1
unnamed: C47.1, R33.1
unnamed: C50.1, C52.1, R25.2, U8.1
unnamed: C51.1, C53.1, R27.2, U8.7
unnamed: C52.2, R36.2
unnamed: C53.2, R37.2
unnamed: C54.1, R43.1
unnamed: C55.1, R44.1
unnamed: C57.1, R46.1
unnamed: C58.1, R47.1
unnamed: C64.2, R48.2, R53.2, U9.4
unnamed: C65.1, R49.2, R52.2, U9.5
unnamed: C66.2, R50.2, R55.2, U10.4
unnamed: C67.1, R51.2, R54.2, U10.5
unnamed: Q2.6 (D), R28.2
unnamed: Q2.3 (D), R42.2
unnamed: Q3.2 (G), Q3.5 (G), R28.1, R31.1
unnamed: Q3.1 (S), Q3.4 (S), R31.2
unnamed: Q4.2 (G), Q4.5 (G), R42.1, R45.1
unnamed: Q4.1 (S), Q4.4 (S), R45.2
unnamed: C48.1, R34.1, U8.3 (+)
unnamed: C50.2, R29.2, U8.2 (-)
unnamed: C49.1, R35.1, U8.5 (+)
unnamed: C51.2, R30.2, U8.6 (-)
unnamed: C65.2, R43.2, R49.1, U9.8 (+)
unnamed: C64.1, R44.2, R48.1, U9.1 (-)
unnamed: C60.1, U9.2 (V_{OCM})
unnamed: C67.2, R46.2, R51.1, U10.8 (+)
unnamed: C66.1, R47.2, R50.1, U10.1 (-)
unnamed: C63.1, U10.2 (V_{OCM})
