dotrodeo/rodeo/hardware/rodeo-motherboard/rodeo-motherboard.kicad_pcb

## KiCad design hardware/rodeo-motherboard/rodeo-motherboard.kicad_pcb (continued)

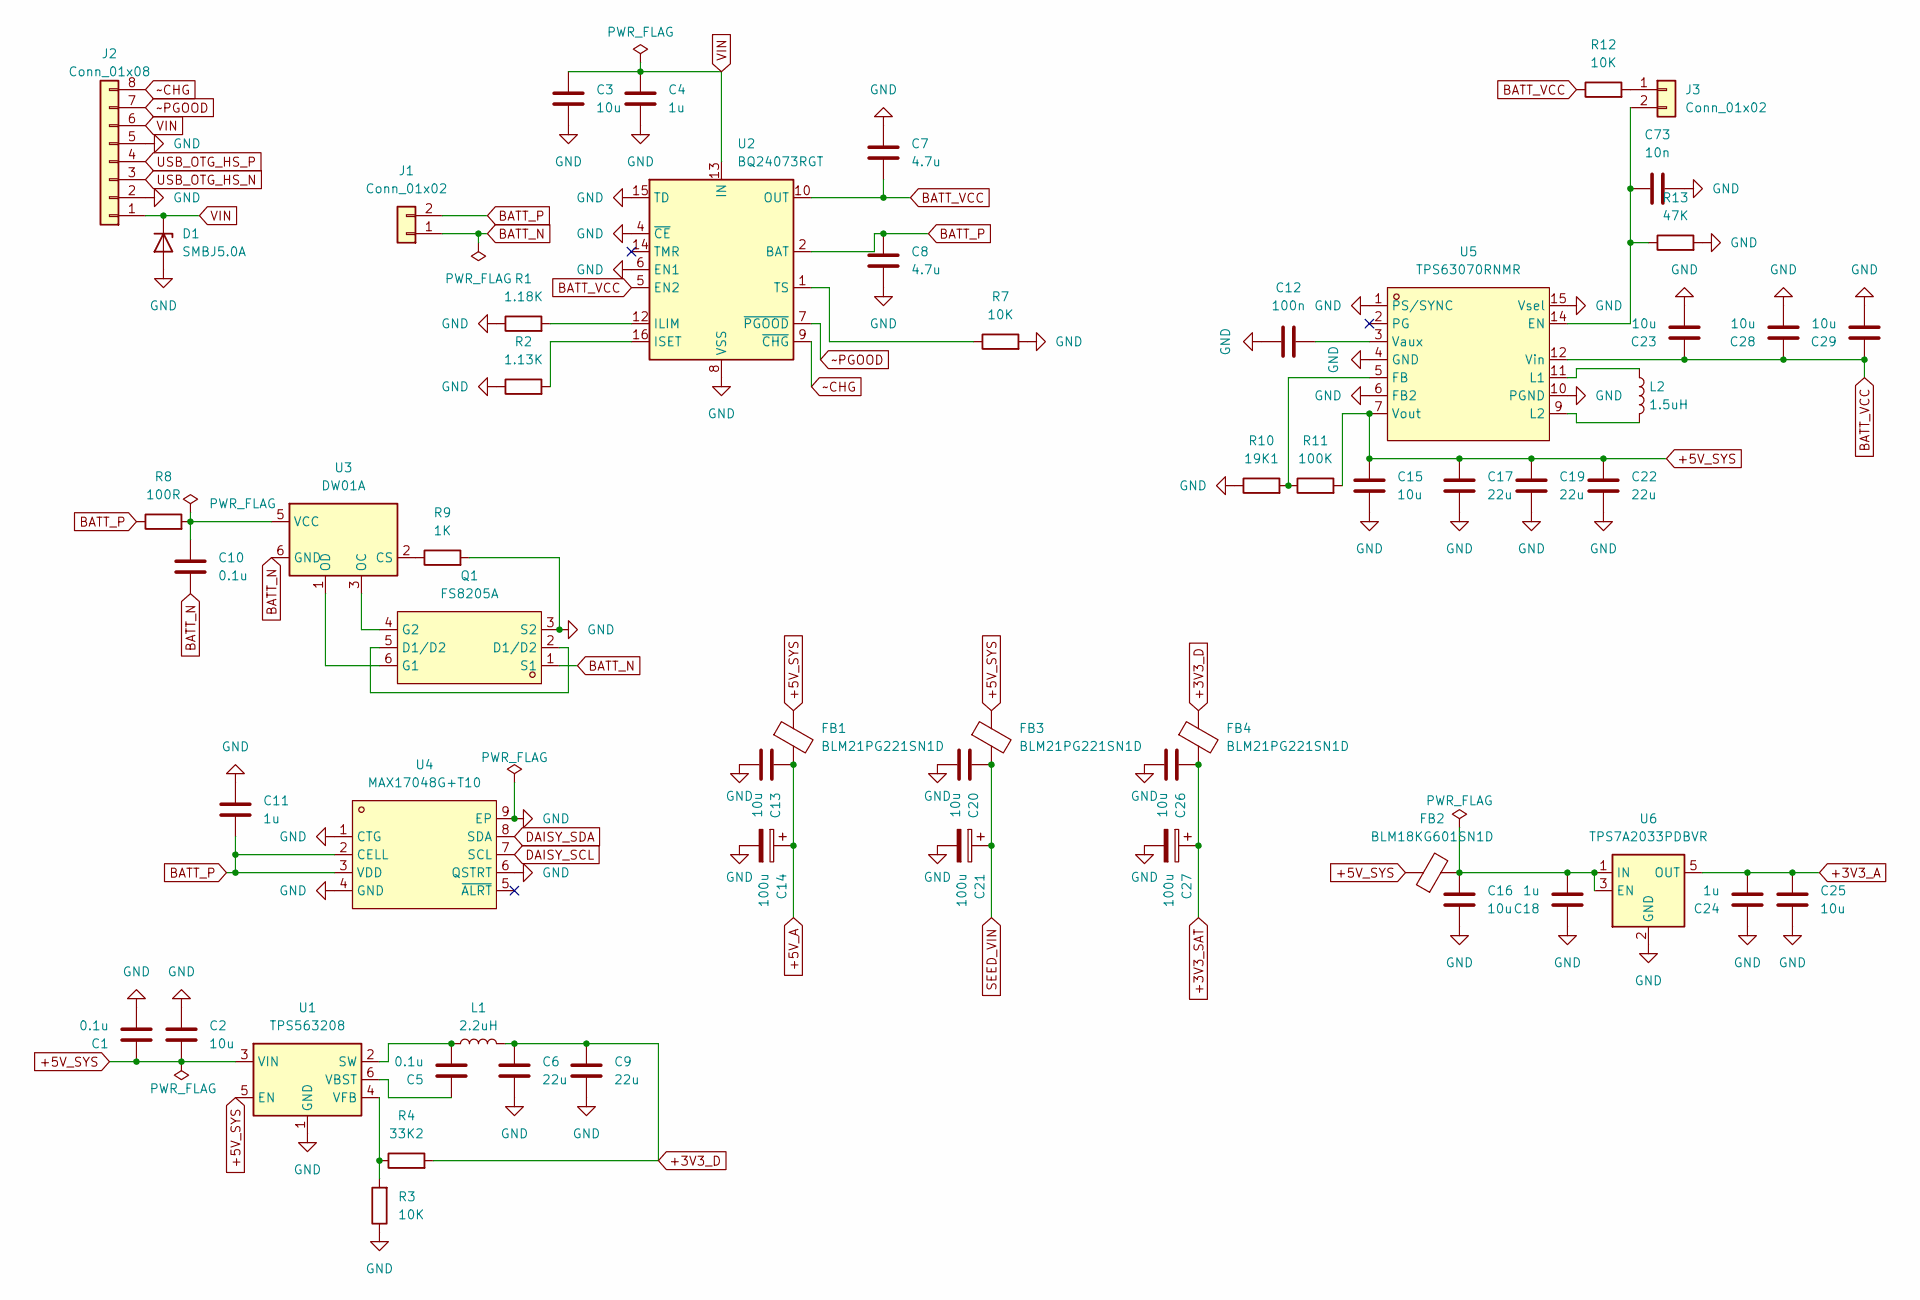
[picture p87: schematic power.kicad_sch]

Parts:
C1, C5: 0.1u; C_0603_1608Metric; LCSC Part C14663
C2, C3, C13, C16, C20, C25, C26, C28, C29: 10u; C_0805_2012Metric; LCSC Part C15850
C4, C18, C24: 1u; C_0603_1608Metric; LCSC Part C15849
C6, C9, C17, C19, C22: 22u; C_0805_2012Metric; LCSC Part C45783
C7, C8: 4.7u; C_0805_2012Metric; LCSC Part C1779
C10: 0.1u; C_0402_1005Metric; LCSC Part C1525
C11: 1u; C_0402_1005Metric; LCSC Part C52923
C12: 100n; C_0603_1608Metric; LCSC Part C14663
C14, C21, C27: 100u; CP_Elec_6.3x5.4; LCSC Part C2887276
C15, C23: 10u; C_0603_1608Metric; LCSC Part C96446
C73: 10n; C_0402_1005Metric; LCSC Part C15195
D1: SMBJ5.0A; D_SMB; LCSC Part C113974
FB1, FB3, FB4: BLM21PG221SN1D; L_0805_2012Metric; MPN BLM21PG221SN1D; LCSC Part C85840
FB2: BLM18KG601SN1D; L_0603_1608Metric; MPN BLM18KG601SN1D; LCSC Part C85833
J1: Conn_01x02; JST_PH_S2B-PH-K_1x02_P2.00mm_Horizontal; MPN S2B-PH-K-S(LF)(SN); LCSC Part C173752
J2: Conn_01x08; JST_PH_S8B-PH-K_1x08_P2.00mm_Horizontal; LCSC Part C157915
J3: Conn_01x02; JST_SH_BM02B-SRSS-TB_1x02-1MP_P1.00mm_Vertical; LCSC Part C160388
L1: 2.2uH; L_Sunlord_MWSA0518S; MPN MWSA0518S-2R2MT; LCSC Part C408345
L2: 1.5uH; L_Sunlord_MWSA0518S; MPN MWSA0518S-1R5MT; LCSC Part C408344
Q1: FS8205A; SOT-23-6_L2.9-W1.6-P0.95-LS2.8-BR; MPN FS8205A; LCSC Part C2830320
R1: 1.18K; R_0402_1005Metric; LCSC Part C270651
R2: 1.13K; R_0402_1005Metric; LCSC Part C67014
R3, R7, R12: 10K; R_0402_1005Metric; LCSC Part C25744
R4: 33K2; R_0402_1005Metric; LCSC Part C122548
R8: 100R; R_0402_1005Metric; LCSC Part C25076
R9: 1K; R_0402_1005Metric; LCSC Part C11702
R10: 19K1; R_0402_1005Metric; LCSC Part C52036
R11: 100K; R_0402_1005Metric; LCSC Part C25741
R13: 47K; R_0402_1005Metric; LCSC Part C25792
U1: TPS563208; TSOT-23-6; MPN TPS563208DDCR; LCSC Part C468250
U2: BQ24073RGT; VQFN-16-1EP_3x3mm_P0.5mm_EP1.6x1.6mm; MPN BQ24073RGTR; LCSC Part C15220
U3: DW01A; SOT-23-6; MPN DW01A; LCSC Part C351410
U4: MAX17048G+T10; TDFN-8_L2.0-W2.0-P0.50-BL-EP1.2; MPN MAX17048G+T10; LCSC Part C2682616
U5: TPS63070RNMR; VQFN-15_L3.0-W2.5-P0.50-BL; MPN TPS63070RNMR; LCSC Part C109322
U6: TPS7A2033PDBVR; SOT-23-5; MPN TPS7A2033PDBVR; LCSC Part C2862740

Connections:
+3V3_A: C24.2, C25.2, U6.5 (OUT); also elsewhere on the board
+3V3_D: C6.2, C9.2, FB4.1, L1.2, R4.2; also elsewhere on the board
+3V3_SAT: C26.2, C27.1, FB4.2; also elsewhere on the board
+5V_A: C13.2, C14.1, FB1.2; also elsewhere on the board
+5V_SYS: C1.1, C2.1, C15.1, C17.1, C19.1, C22.1, FB1.1, FB2.1, FB3.1, R11.2, U1.3 (VIN), U1.5 (EN), U5.7 (Vout)
BATT_N: C10.1, J1.1, Q1.1 (S1), U3.6 (GND)
BATT_P: C8.1, C11.1, J1.2, R8.1, U2.2 (BAT), U2.3 (BAT), U4.2 (CELL), U4.3 (VDD)
BATT_VCC: C7.1, C23.1, C28.1, C29.1, R12.1, U2.5 (EN2), U2.10 (OUT), U2.11 (OUT), U5.12 (Vin)
DAISY_SCL: U4.7 (SCL); also elsewhere on the board
DAISY_SDA: U4.8 (SDA); also elsewhere on the board
GND: C1.2, C2.2, C3.2, C4.2, C6.1, C7.2, C8.2, C9.1, C11.2, C12.2, C13.1, C14.2, C15.2, C16.1, C17.2, C18.1, C19.2, C20.1, C21.2, C22.2, C23.2, C24.1, C25.1, C26.1, C27.2, C28.2, C29.2, C73.1, D1.2 (A), J2.2, J2.5, Q1.3 (S2), R1.1, R2.1, R3.1, R7.2, R9.2, R10.1, R13.2, U1.1 (GND), U2.4 (~CE), U2.6 (EN1), U2.8 (VSS), U2.15 (TD), U2.17 (VSS), U4.1 (CTG), U4.4 (GND), U4.6 (QSTRT), U4.9 (EP), U5.1 (PS/SYNC), U5.4 (GND), U5.6 (FB2), U5.10 (PGND), U5.15 (Vsel), U6.2 (GND); also elsewhere on the board
unnamed: J3.1, R12.2
unnamed: C73.2, J3.2, R13.1, U5.14 (EN)
unnamed: Q1.2 (D1/D2), Q1.5 (D1/D2)
unnamed: Q1.6 (G1), U3.1 (OD)
unnamed: Q1.4 (G2), U3.3 (OC)
unnamed: C5.2, L1.1, U1.2 (SW)
unnamed: C5.1, U1.6 (VBST)
unnamed: R3.2, R4.1, U1.4 (VFB)
unnamed: R1.2, U2.12 (ILIM)
unnamed: R2.2, U2.16 (ISET)
unnamed: R7.1, U2.1 (TS)
unnamed: R9.1, U3.2 (CS)
unnamed: C10.2, R8.2, U3.5 (VCC)
unnamed: R10.2, R11.1, U5.5 (FB)
unnamed: L2.1, U5.11 (L1)
unnamed: L2.2, U5.9 (L2)
unnamed: C12.1, U5.3 (Vaux)
unnamed: C16.2, C18.2, FB2.2, U6.1 (IN), U6.3 (EN)
SEED_VIN: C20.2, C21.1, FB3.2; also elsewhere on the board
USB_OTG_HS_N: J2.3; also elsewhere on the board
USB_OTG_HS_P: J2.4; also elsewhere on the board
VIN: C3.1, C4.1, D1.1 (K), J2.1, J2.6, U2.13 (IN)
~CHG: J2.8, U2.9 (~CHG)
~PGOOD: J2.7, U2.7 (~PGOOD)

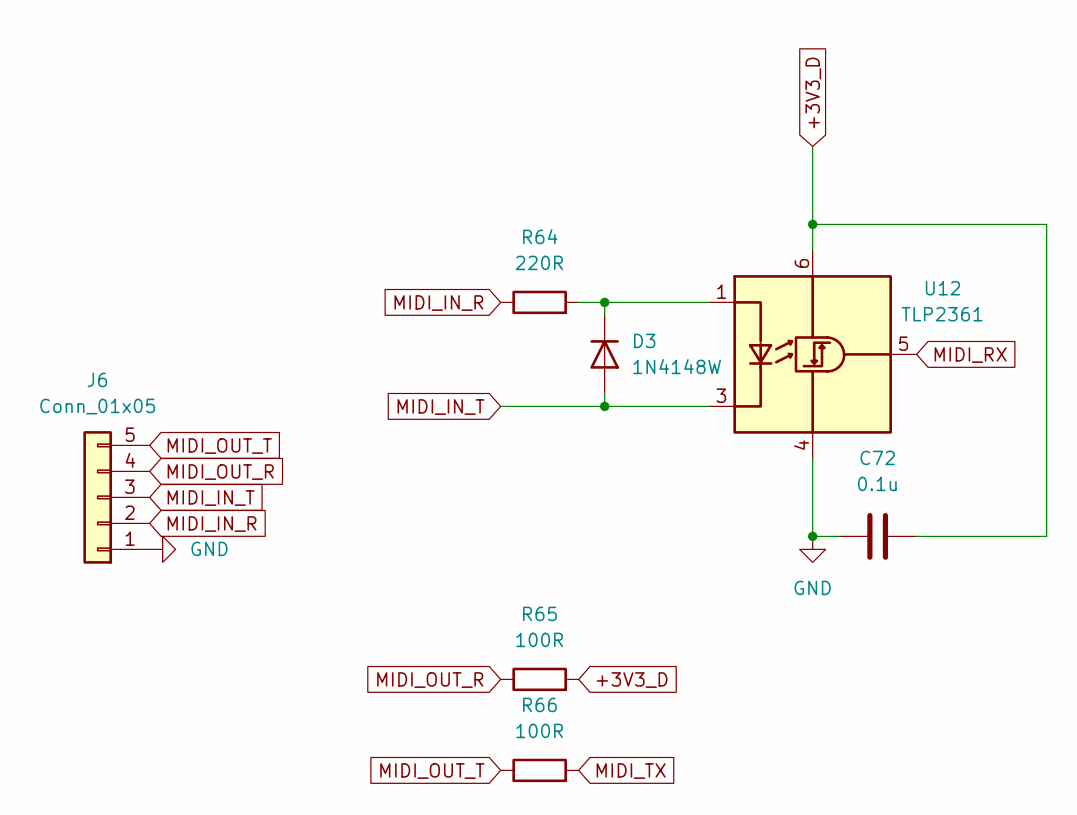
[picture p88: schematic midi.kicad_sch]

Parts:
C72: 0.1u; C_0402_1005Metric; LCSC Part C1525
D3: 1N4148W; D_SOD-123; LCSC Part C81598
J6: Conn_01x05; JST_SH_BM05B-SRSS-TB_1x05-1MP_P1.00mm_Vertical; LCSC Part C160391
R64: 220R; R_0402_1005Metric; LCSC Part C25091
R65, R66: 100R; R_0402_1005Metric; LCSC Part C25076
U12: TLP2361; SO-5-6_4.55x3.7mm_P1.27mm; LCSC Part C107626

Connections:
+3V3_D: C72.2, R65.2, U12.6 (VDD); also elsewhere on the board
GND: C72.1, J6.1, U12.4 (GND); also elsewhere on the board
MIDI_IN_R: J6.2, R64.1
MIDI_IN_T: D3.2 (A), J6.3, U12.3 (K)
MIDI_OUT_R: J6.4, R65.1
MIDI_OUT_T: J6.5, R66.1
MIDI_RX: U12.5 (VO); also elsewhere on the board
MIDI_TX: R66.2; also elsewhere on the board
unnamed: D3.1 (K), R64.2, U12.1 (A)

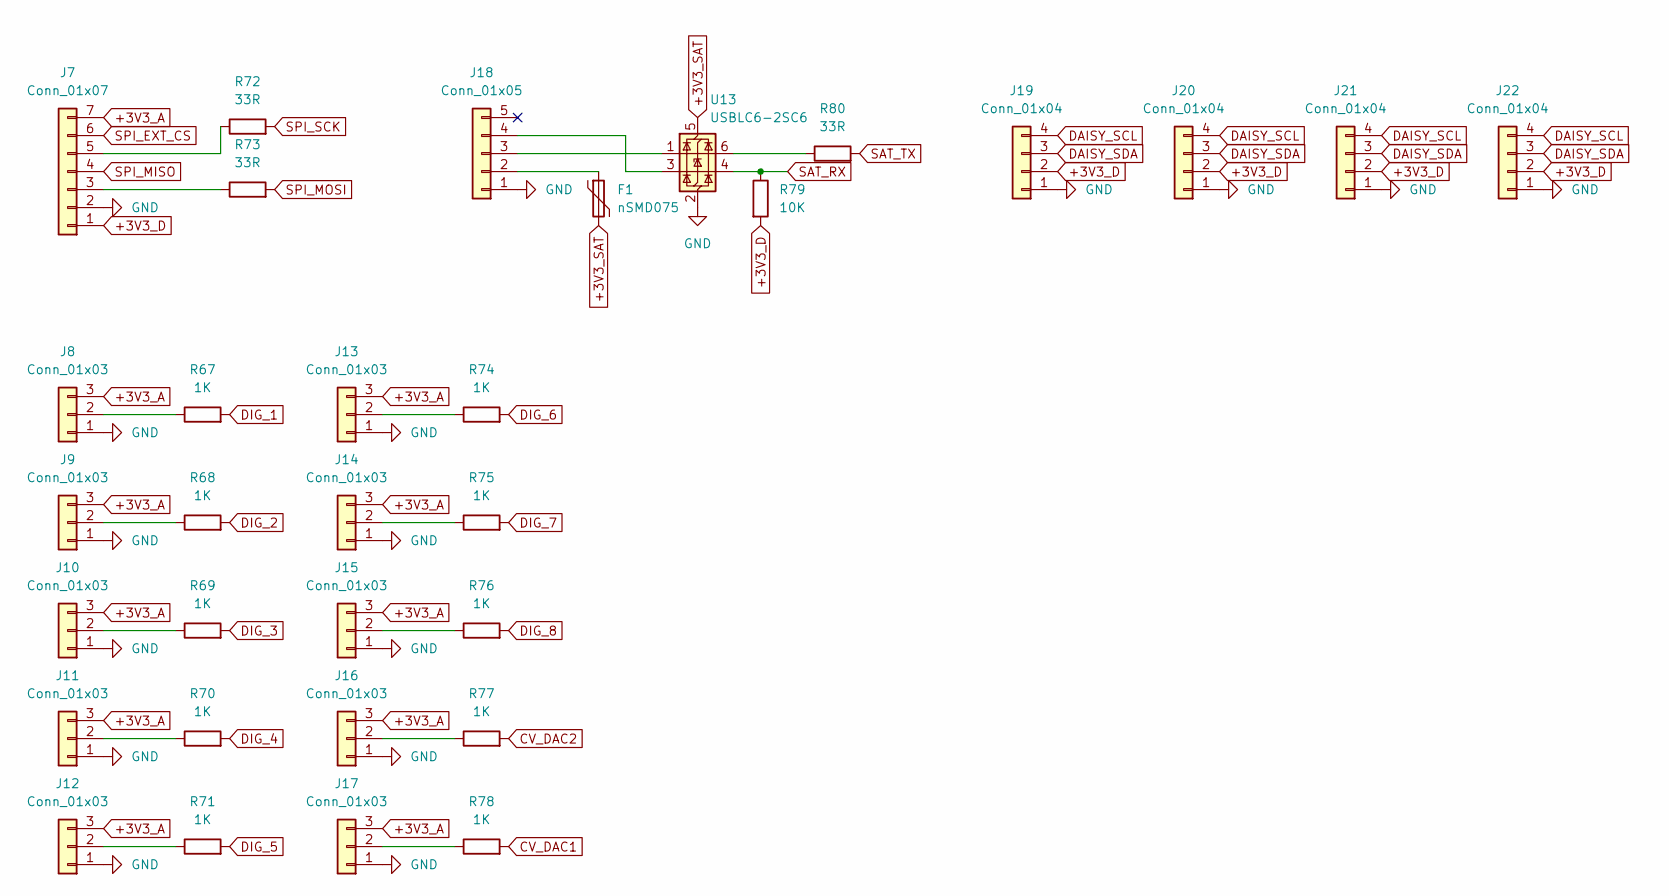
[picture p89: schematic connectors.kicad_sch]

Parts:
F1: nSMD075; Fuse_1206_3216Metric; LCSC Part C70078
J7: Conn_01x07; JST_SH_BM07B-SRSS-TB_1x07-1MP_P1.00mm_Vertical; LCSC Part C160393
J8, J9, J10, J11, J12, J13, J14, J15, J16, J17: Conn_01x03; JST_SH_BM03B-SRSS-TB_1x03-1MP_P1.00mm_Vertical; LCSC Part C160389
J18: Conn_01x05; JST_SH_BM05B-SRSS-TB_1x05-1MP_P1.00mm_Vertical; LCSC Part C160391
J19, J20, J21, J22: Conn_01x04; JST_SH_BM04B-SRSS-TB_1x04-1MP_P1.00mm_Vertical; LCSC Part C160390
R67, R68, R69, R70, R71, R74, R75, R76, R77, R78: 1K; R_0402_1005Metric; LCSC Part C11702
R72, R73, R80: 33R; R_0402_1005Metric; LCSC Part C25105
R79: 10K; R_0402_1005Metric; LCSC Part C25744
U13: USBLC6-2SC6; SOT-23-6; LCSC Part C7519

Connections:
+3V3_A: J7.7, J8.3, J9.3, J10.3, J11.3, J12.3, J13.3, J14.3, J15.3, J16.3, J17.3; also elsewhere on the board
+3V3_D: J7.1, J19.2, J20.2, J21.2, J22.2, R79.2; also elsewhere on the board
+3V3_SAT: F1.2, U13.5 (VBUS); also elsewhere on the board
CV_DAC1: R78.2; also elsewhere on the board
CV_DAC2: R77.2; also elsewhere on the board
DAISY_SCL: J19.4, J20.4, J21.4, J22.4; also elsewhere on the board
DAISY_SDA: J19.3, J20.3, J21.3, J22.3; also elsewhere on the board
DIG_1: R67.2; also elsewhere on the board
DIG_2: R68.2; also elsewhere on the board
DIG_3: R69.2; also elsewhere on the board
DIG_4: R70.2; also elsewhere on the board
DIG_5: R71.2; also elsewhere on the board
DIG_6: R74.2; also elsewhere on the board
DIG_7: R75.2; also elsewhere on the board
DIG_8: R76.2; also elsewhere on the board
GND: J7.2, J8.1, J9.1, J10.1, J11.1, J12.1, J13.1, J14.1, J15.1, J16.1, J17.1, J18.1, J19.1, J20.1, J21.1, J22.1, U13.2 (GND); also elsewhere on the board
unnamed: J7.3, R73.1
unnamed: J7.5, R72.1
unnamed: J8.2, R67.1
unnamed: J9.2, R68.1
unnamed: J10.2, R69.1
unnamed: J11.2, R70.1
unnamed: J12.2, R71.1
unnamed: J13.2, R74.1
unnamed: J14.2, R75.1
unnamed: J15.2, R76.1
unnamed: J16.2, R77.1
unnamed: J17.2, R78.1
unnamed: F1.1, J18.2
unnamed: J18.3, U13.1 (I/O1)
unnamed: J18.4, U13.3 (I/O2)
unnamed: R80.1, U13.6 (I/O1)
SAT_RX: R79.1, U13.4 (I/O2); also elsewhere on the board
SAT_TX: R80.2; also elsewhere on the board
SPI_EXT_CS: J7.6; also elsewhere on the board
SPI_MISO: J7.4; also elsewhere on the board
SPI_MOSI: R73.2; also elsewhere on the board
SPI_SCK: R72.2; also elsewhere on the board

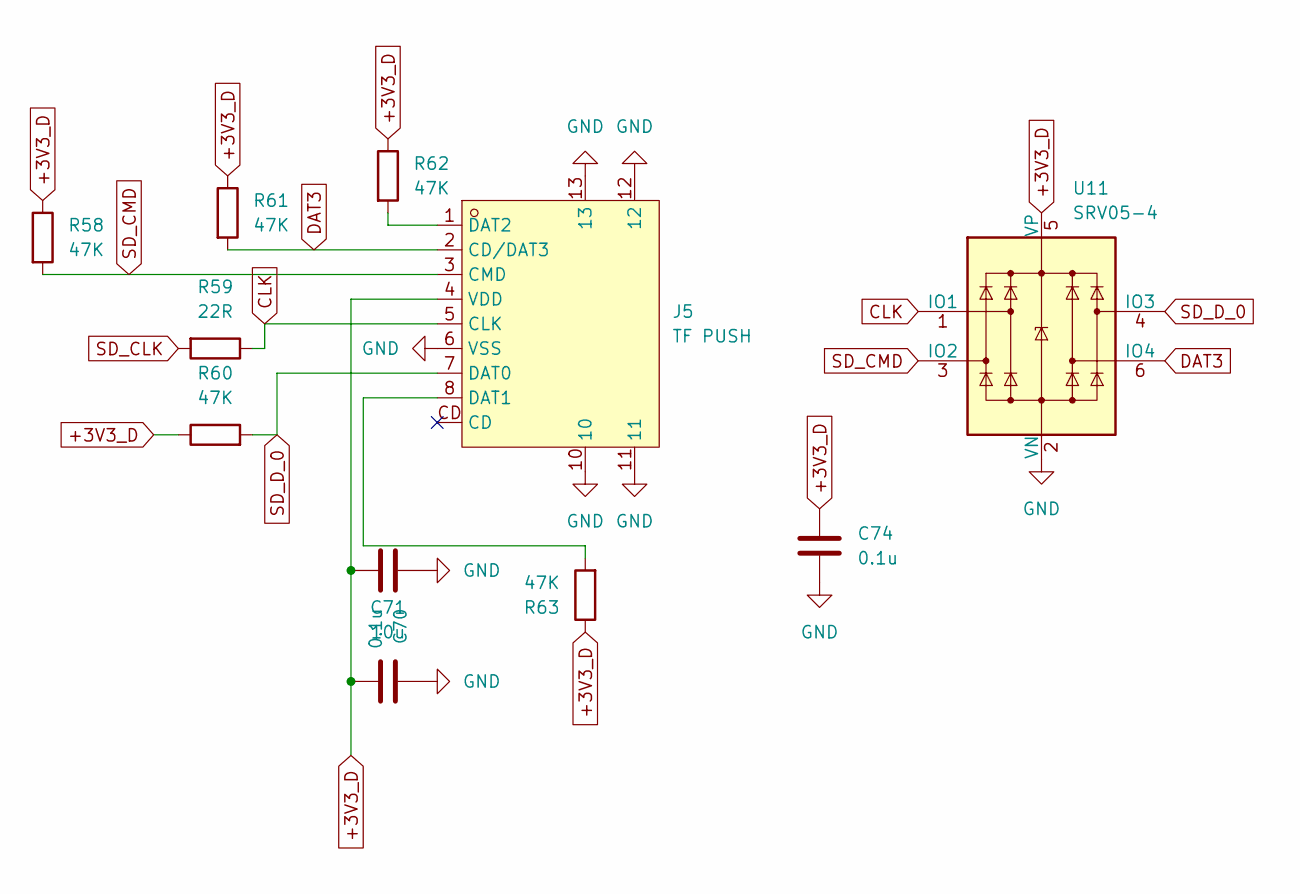
[picture p90: schematic sd.kicad_sch]

Parts:
C70, C74: 0.1u; C_0402_1005Metric; LCSC Part C1525
C71: 10u; C_0603_1608Metric; LCSC Part C96446
J5: TF PUSH; TF-SMD_TF-PUSH; MPN TF PUSH; LCSC Part C393941
R58, R60, R61, R62, R63: 47K; R_0402_1005Metric; LCSC Part C25792
R59: 22R; R_0402_1005Metric; LCSC Part C25092
U11: SRV05-4; SOT-23-6; LCSC Part C13612

Connections:
+3V3_D: C70.1, C71.1, C74.1, J5.4 (VDD), R58.1, R60.1, R61.1, R62.1, R63.1, U11.5 (VP); also elsewhere on the board
CLK: J5.5 (CLK), R59.1, U11.1 (IO1)
DAT3: J5.2 (CD/DAT3), R61.2, U11.6 (IO4)
GND: C70.2, C71.2, C74.2, J5.6 (VSS), J5.10, J5.11, J5.12, J5.13, U11.2 (VN); also elsewhere on the board
unnamed: J5.8 (DAT1), R63.2
unnamed: J5.1 (DAT2), R62.2
SD_CLK: R59.2; also elsewhere on the board
SD_CMD: J5.3 (CMD), R58.2, U11.3 (IO2); also elsewhere on the board
SD_D_0: J5.7 (DAT0), R60.2, U11.4 (IO3); also elsewhere on the board

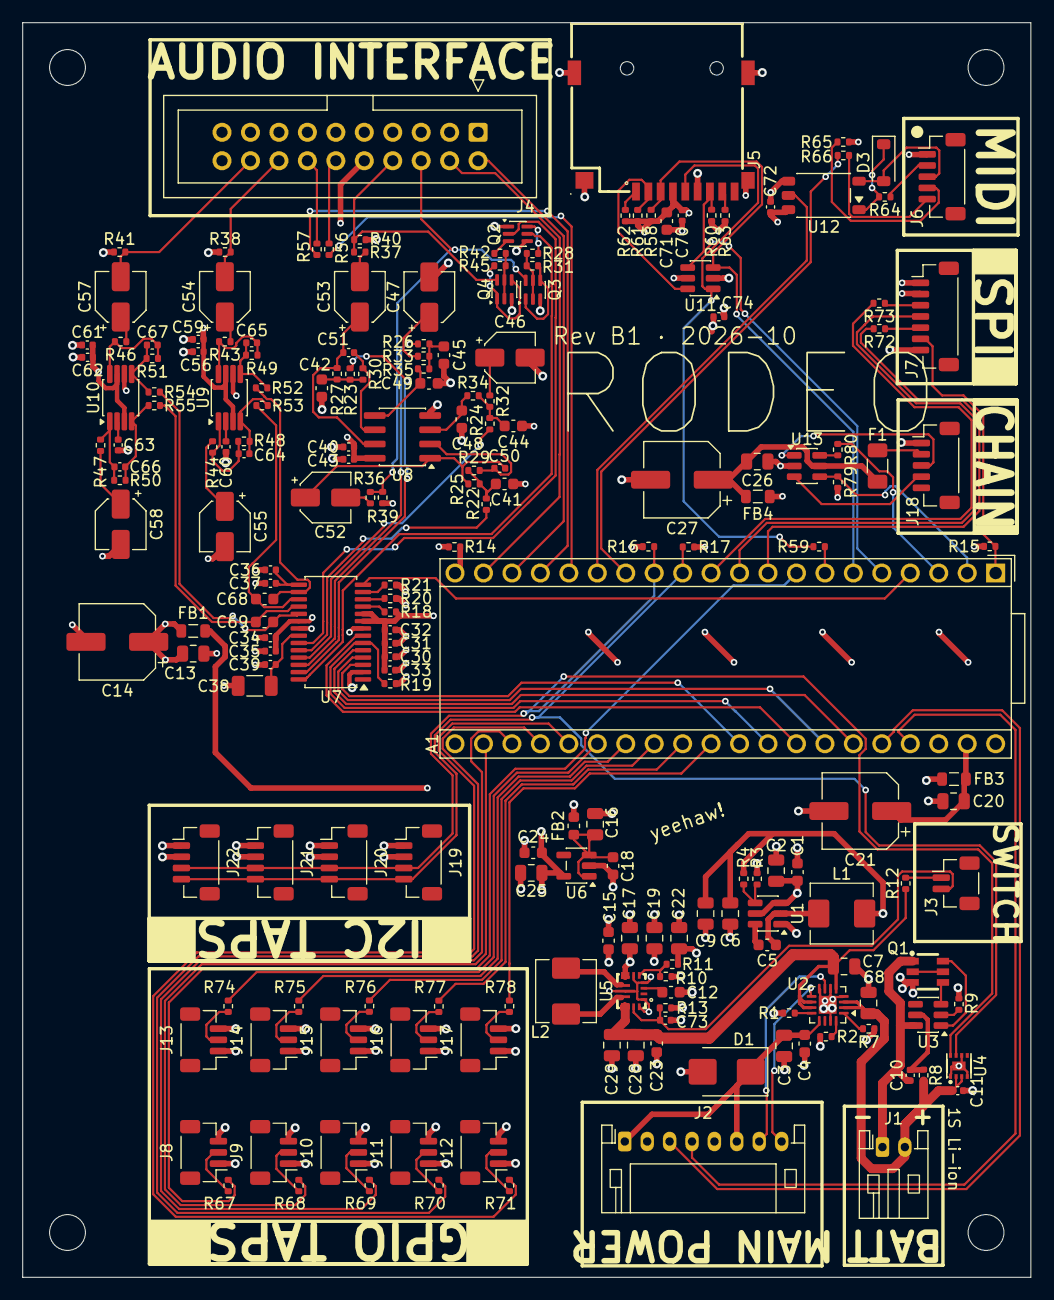
[picture p91: board hardware/rodeo-motherboard/rodeo-motherboard.kicad_pcb from above]

Board: 4 copper layers, 90.0 x 112.0 mm, 205 parts (0 on the bottom side), 147 nets.
