dotrodeo/rodeo/rev-a/rodeo-rotary-switch/rodeo-rotary-switch.kicad_pcb

## KiCad design rev-a/rodeo-rotary-switch/rodeo-rotary-switch.kicad_pcb (2026-08-21)

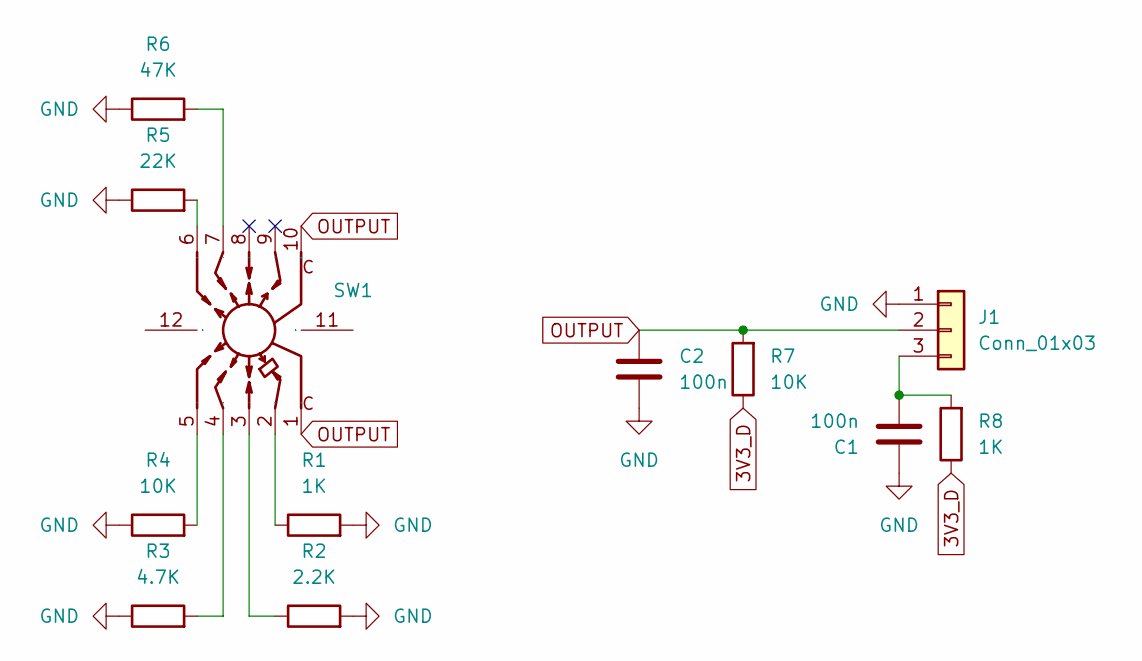
[picture p92: schematic rodeo-rotary-switch.kicad_sch]

Parts:
C1, C2: 100n; C_0603_1608Metric
J1: Conn_01x03; JST_SH_SM03B-SRSS-TB_1x03-1MP_P1.00mm_Horizontal
R1, R8: 1K; R_0603_1608Metric
R2: 2.2K; R_0603_1608Metric
R3: 4.7K; R_0603_1608Metric
R4, R7: 10K; R_0603_1608Metric
R5: 22K; R_0603_1608Metric
R6: 47K; R_0603_1608Metric
SW1: SW-TH_SRBV141404; Manufacturer Part SRBV160803; LCSC Part Name SRBV160803三件套 三件套

Connections:
3V3_D: R7.1, R8.1
GND: C1.1, C2.2, J1.1, R1.2, R2.2, R3.1, R4.1, R5.1, R6.1
unnamed: C1.2, J1.3, R8.2
unnamed: R1.1, SW1.2
unnamed: R2.1, SW1.3
unnamed: R3.2, SW1.4
unnamed: R4.2, SW1.5
unnamed: R5.2, SW1.6
unnamed: R6.2, SW1.7
OUTPUT: C2.1, J1.2, R7.2, SW1.1, SW1.10

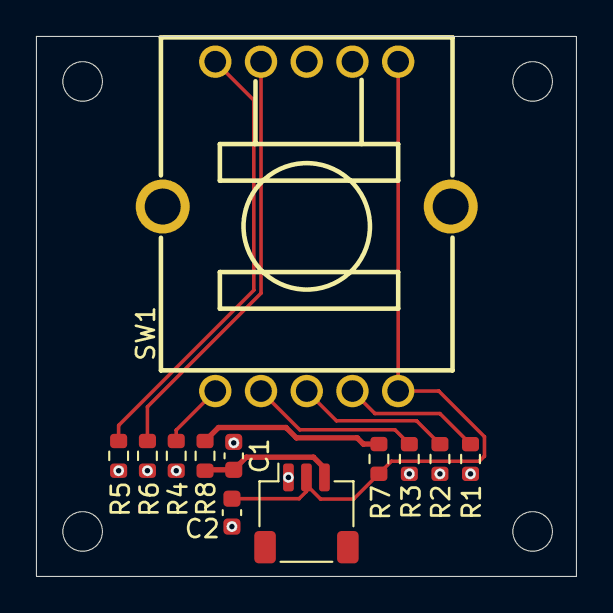
[picture p93: board rodeo-rotary-switch.kicad_pcb from above]

Board: 2 copper layers, 30.0 x 30.0 mm, 12 parts (0 on the bottom side), 10 nets.
