dotrodeo/rodeo/rev-a/rodeo-motherboard/kicad/rodeo-motherboard.kicad_pcb

## KiCad design rev-a/rodeo-motherboard/kicad/rodeo-motherboard.kicad_pcb (2026-08-21)

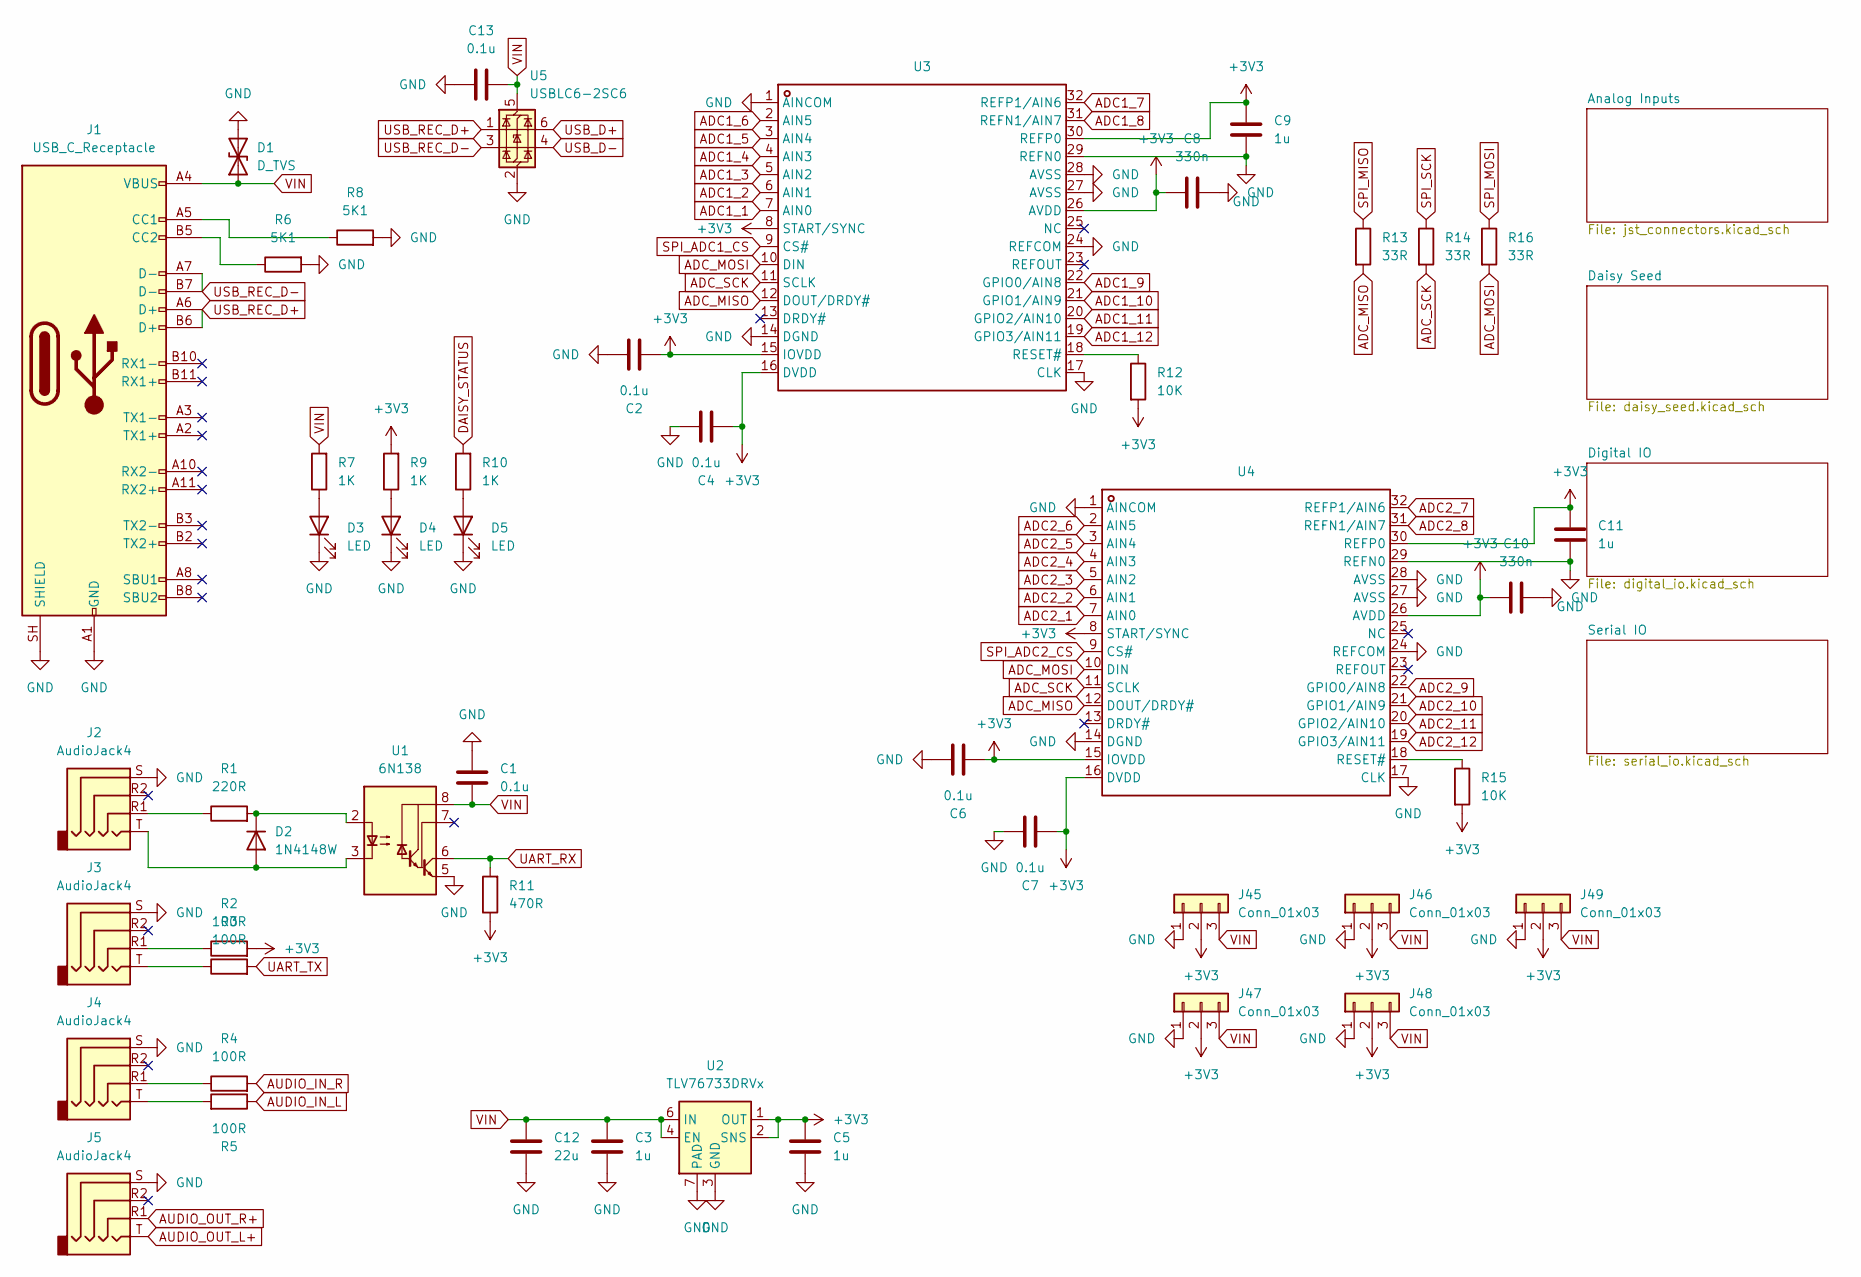
[picture p94: schematic rodeo-motherboard.kicad_sch]

Parts:
C1, C2, C4, C6, C7, C13: 0.1u; C_0603_1608Metric
C3, C5: 1u; C_0805_2012Metric
C8, C10: 330n; C_0603_1608Metric
C9, C11: 1u; C_0603_1608Metric
C12: 22u; C_0805_2012Metric
D1: D_TVS; D_SOD-323
D2: 1N4148W; D_SOD-123
D3, D4, D5: LED; LED_1206_3216Metric
J1: USB_C_Receptacle; USB_C_Receptacle_GCT_USB4105-xx-A_16P_TopMnt_Horizontal
J2, J3, J4, J5: AudioJack4; Jack_3.5mm_PJ320D_Horizontal
J45, J46, J47, J48, J49: Conn_01x03; JST_ZH_B3B-ZR-SM4-TF_1x03-1MP_P1.50mm_Vertical
R1: 220R; R_0603_1608Metric
R2, R3, R4, R5: 100R; R_0603_1608Metric
R6, R8: 5K1; R_0603_1608Metric
R7, R9, R10: 1K; R_0603_1608Metric
R11: 470R; R_0603_1608Metric
R12, R15: 10K; R_0603_1608Metric
R13, R14, R16: 33R; R_0603_1608Metric
U1: 6N138; DIP-8_W7.62mm
U2: TLV76733DRVx; WSON-6-1EP_2x2mm_P0.65mm_EP1x1.6mm_ThermalVias
U3, U4: TQFP-32_L5.0-W5.0-P0.50-LS7.0-BL; Manufacturer Part ADS114S08BIPBSR; LCSC Part Name 具有PGA和电压基准的低功耗、低噪声、高集成度、6通道和12通道、4kSPS、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
U5: USBLC6-2SC6; SOT-23-6

Connections:
+3V3: C2.1, C4.1, C5.1, C6.1, C7.1, C8.1, C9.2, C10.1, C11.2, J45.2, J46.2, J47.2, J48.2, J49.2, R2.2, R9.2, R11.1, R12.2, R15.2, U2.1 (OUT), U2.2 (SNS), U3.8 (START/SYNC), U3.15 (IOVDD), U3.16 (DVDD), U3.26 (AVDD), U3.30 (REFP0), U4.8 (START/SYNC), U4.15 (IOVDD), U4.16 (DVDD), U4.26 (AVDD), U4.30 (REFP0); also elsewhere on the board
ADC1_1: U3.7 (AIN0); also elsewhere on the board
ADC1_2: U3.6 (AIN1); also elsewhere on the board
ADC1_3: U3.5 (AIN2); also elsewhere on the board
ADC1_4: U3.4 (AIN3); also elsewhere on the board
ADC1_5: U3.3 (AIN4); also elsewhere on the board
ADC1_6: U3.2 (AIN5); also elsewhere on the board
ADC1_7: U3.32 (REFP1/AIN6); also elsewhere on the board
ADC1_8: U3.31 (REFN1/AIN7); also elsewhere on the board
ADC1_9: U3.22 (GPIO0/AIN8); also elsewhere on the board
ADC1_10: U3.21 (GPIO1/AIN9); also elsewhere on the board
ADC1_11: U3.20 (GPIO2/AIN10); also elsewhere on the board
ADC1_12: U3.19 (GPIO3/AIN11); also elsewhere on the board
ADC2_1: U4.7 (AIN0); also elsewhere on the board
ADC2_2: U4.6 (AIN1); also elsewhere on the board
ADC2_3: U4.5 (AIN2); also elsewhere on the board
ADC2_4: U4.4 (AIN3); also elsewhere on the board
ADC2_5: U4.3 (AIN4); also elsewhere on the board
ADC2_6: U4.2 (AIN5); also elsewhere on the board
ADC2_7: U4.32 (REFP1/AIN6); also elsewhere on the board
ADC2_8: U4.31 (REFN1/AIN7); also elsewhere on the board
ADC2_9: U4.22 (GPIO0/AIN8); also elsewhere on the board
ADC2_10: U4.21 (GPIO1/AIN9); also elsewhere on the board
ADC2_11: U4.20 (GPIO2/AIN10); also elsewhere on the board
ADC2_12: U4.19 (GPIO3/AIN11); also elsewhere on the board
ADC_MISO: R13.2, U3.12 (DOUT/DRDY#), U4.12 (DOUT/DRDY#)
ADC_MOSI: R16.2, U3.10 (DIN), U4.10 (DIN)
ADC_SCK: R14.2, U3.11 (SCLK), U4.11 (SCLK)
AUDIO_IN_L: R5.1; also elsewhere on the board
AUDIO_IN_R: R4.2; also elsewhere on the board
AUDIO_OUT_L+: J5.T; also elsewhere on the board
AUDIO_OUT_R+: J5.R1; also elsewhere on the board
DAISY_STATUS: R10.2; also elsewhere on the board
GND: C1.1, C2.2, C3.2, C4.2, C5.2, C6.2, C7.2, C8.2, C9.1, C10.2, C11.1, C12.2, C13.1, D1.2 (A2), D3.1 (K), D4.1 (K), D5.1 (K), J1.A1 (GND), J1.A12 (GND), J1.B1 (GND), J1.B12 (GND), J1.SH (SHIELD), J2.S, J3.S, J4.S, J5.S, J45.1, J46.1, J47.1, J48.1, J49.1, R6.2, R8.2, U1.5 (GND), U2.3 (GND), U2.5 (GND), U2.7 (PAD), U3.1 (AINCOM), U3.14 (DGND), U3.17 (CLK), U3.24 (REFCOM), U3.27 (AVSS), U3.28 (AVSS), U3.29 (REFN0), U4.1 (AINCOM), U4.14 (DGND), U4.17 (CLK), U4.24 (REFCOM), U4.27 (AVSS), U4.28 (AVSS), U4.29 (REFN0), U5.2 (GND); also elsewhere on the board
unnamed: D2.2 (A), J2.T, U1.3 (C2)
unnamed: D2.1 (K), R1.2, U1.2 (C1)
unnamed: D3.2 (A), R7.1
unnamed: D4.2 (A), R9.1
unnamed: D5.2 (A), R10.1
unnamed: J1.A5 (CC1), R8.1
unnamed: J1.B5 (CC2), R6.1
unnamed: J2.R1, R1.1
unnamed: J3.R1, R2.1
unnamed: J3.T, R3.1
unnamed: J4.R1, R4.1
unnamed: J4.T, R5.2
unnamed: R12.1, U3.18 (RESET#)
unnamed: R15.1, U4.18 (RESET#)
SPI_ADC1_CS: U3.9 (CS#); also elsewhere on the board
SPI_ADC2_CS: U4.9 (CS#); also elsewhere on the board
SPI_MISO: R13.1; also elsewhere on the board
SPI_MOSI: R16.1; also elsewhere on the board
SPI_SCK: R14.1; also elsewhere on the board
UART_RX: R11.2, U1.6 (VO2); also elsewhere on the board
UART_TX: R3.2; also elsewhere on the board
USB_D+: U5.6 (I/O1); also elsewhere on the board
USB_D-: U5.4 (I/O2); also elsewhere on the board
USB_REC_D+: J1.A6 (D+), J1.B6 (D+), U5.1 (I/O1)
USB_REC_D-: J1.A7 (D-), J1.B7 (D-), U5.3 (I/O2)
VIN: C1.2, C3.1, C12.1, C13.2, D1.1 (A1), J1.A4 (VBUS), J1.A9 (VBUS), J1.B4 (VBUS), J1.B9 (VBUS), J45.3, J46.3, J47.3, J48.3, J49.3, R7.2, U1.8 (VCC), U2.4 (EN), U2.6 (IN), U5.5 (VBUS); also elsewhere on the board

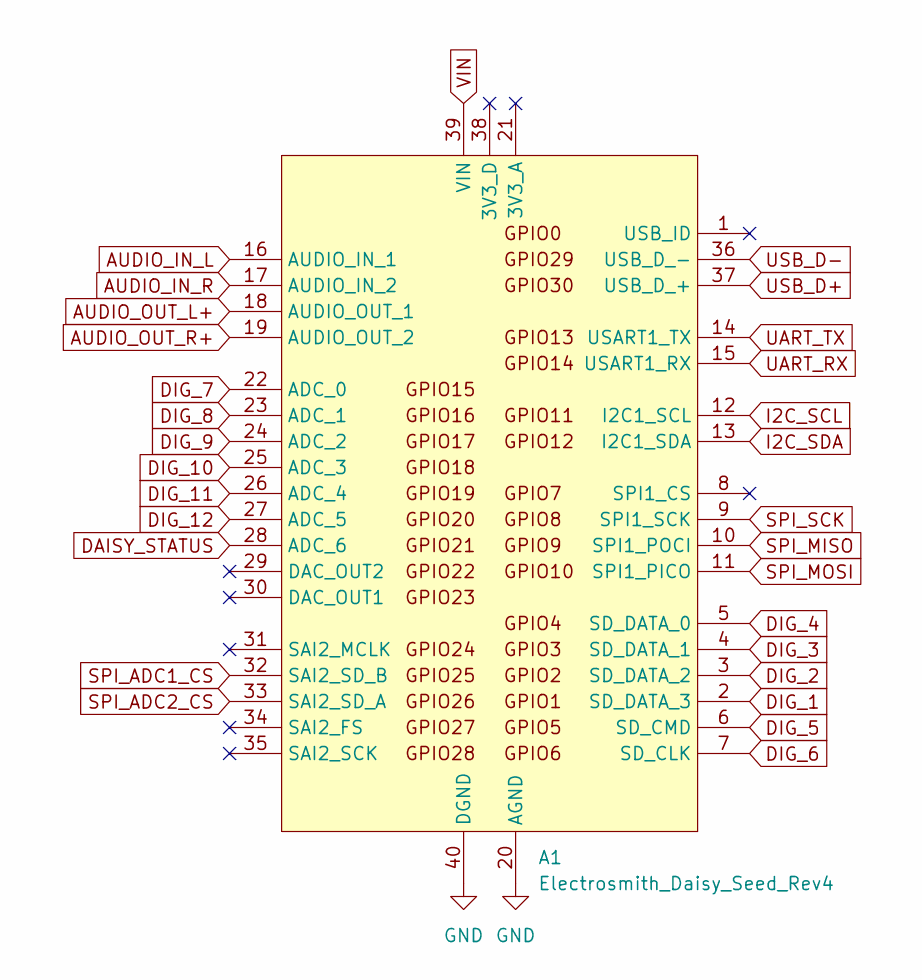
[picture p95: schematic daisy_seed.kicad_sch]

Parts:
A1: Electrosmith_Daisy_Seed_Rev4; Electrosmith_Daisy_Seed

Connections:
AUDIO_IN_L: A1.16 (AUDIO_IN_1); also elsewhere on the board
AUDIO_IN_R: A1.17 (AUDIO_IN_2); also elsewhere on the board
AUDIO_OUT_L+: A1.18 (AUDIO_OUT_1); also elsewhere on the board
AUDIO_OUT_R+: A1.19 (AUDIO_OUT_2); also elsewhere on the board
DAISY_STATUS: A1.28 (ADC_6); also elsewhere on the board
DIG_1: A1.2 (SD_DATA_3); also elsewhere on the board
DIG_2: A1.3 (SD_DATA_2); also elsewhere on the board
DIG_3: A1.4 (SD_DATA_1); also elsewhere on the board
DIG_4: A1.5 (SD_DATA_0); also elsewhere on the board
DIG_5: A1.6 (SD_CMD); also elsewhere on the board
DIG_6: A1.7 (SD_CLK); also elsewhere on the board
DIG_7: A1.22 (ADC_0); also elsewhere on the board
DIG_8: A1.23 (ADC_1); also elsewhere on the board
DIG_9: A1.24 (ADC_2); also elsewhere on the board
DIG_10: A1.25 (ADC_3); also elsewhere on the board
DIG_11: A1.26 (ADC_4); also elsewhere on the board
DIG_12: A1.27 (ADC_5); also elsewhere on the board
GND: A1.20 (AGND), A1.40 (DGND); also elsewhere on the board
I2C_SCL: A1.12 (I2C1_SCL); also elsewhere on the board
I2C_SDA: A1.13 (I2C1_SDA); also elsewhere on the board
SPI_ADC1_CS: A1.32 (SAI2_SD_B); also elsewhere on the board
SPI_ADC2_CS: A1.33 (SAI2_SD_A); also elsewhere on the board
SPI_MISO: A1.10 (SPI1_POCI); also elsewhere on the board
SPI_MOSI: A1.11 (SPI1_PICO); also elsewhere on the board
SPI_SCK: A1.9 (SPI1_SCK); also elsewhere on the board
UART_RX: A1.15 (USART1_RX); also elsewhere on the board
UART_TX: A1.14 (USART1_TX); also elsewhere on the board
USB_D+: A1.37 (USB_D_+); also elsewhere on the board
USB_D-: A1.36 (USB_D_-); also elsewhere on the board
VIN: A1.39 (VIN); also elsewhere on the board

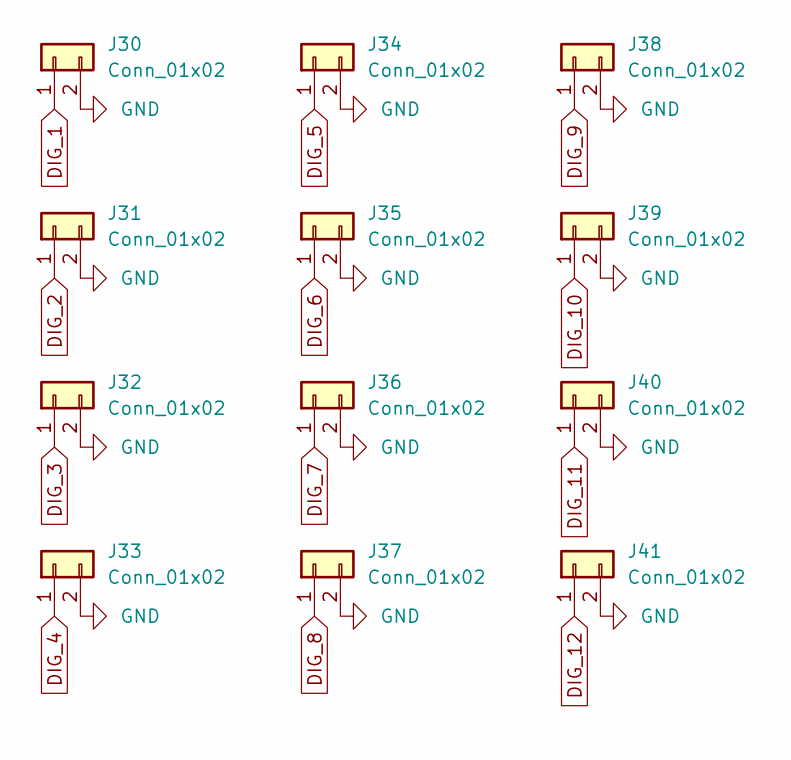
[picture p96: schematic digital_io.kicad_sch]

Parts:
J30, J31, J32, J33, J34, J35, J36, J37, J38, J39, J40, J41: Conn_01x02; JST_SH_BM02B-SRSS-TB_1x02-1MP_P1.00mm_Vertical

Connections:
DIG_1: J30.1; also elsewhere on the board
DIG_2: J31.1; also elsewhere on the board
DIG_3: J32.1; also elsewhere on the board
DIG_4: J33.1; also elsewhere on the board
DIG_5: J34.1; also elsewhere on the board
DIG_6: J35.1; also elsewhere on the board
DIG_7: J36.1; also elsewhere on the board
DIG_8: J37.1; also elsewhere on the board
DIG_9: J38.1; also elsewhere on the board
DIG_10: J39.1; also elsewhere on the board
DIG_11: J40.1; also elsewhere on the board
DIG_12: J41.1; also elsewhere on the board
GND: J30.2, J31.2, J32.2, J33.2, J34.2, J35.2, J36.2, J37.2, J38.2, J39.2, J40.2, J41.2; also elsewhere on the board

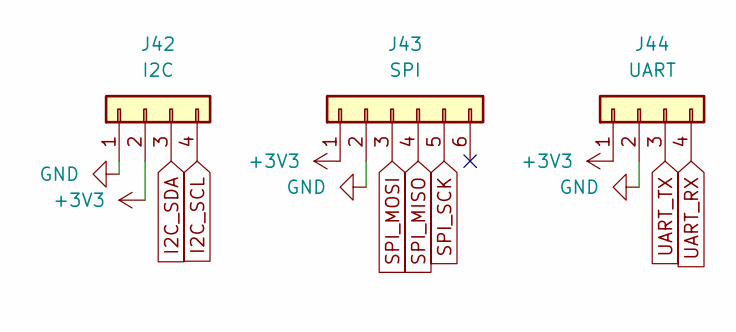
[picture p97: schematic serial_io.kicad_sch]

Parts:
J42: I2C; JST_SH_BM04B-SRSS-TB_1x04-1MP_P1.00mm_Vertical
J43: SPI; JST_SH_BM06B-SRSS-TB_1x06-1MP_P1.00mm_Vertical
J44: UART; JST_SH_BM04B-SRSS-TB_1x04-1MP_P1.00mm_Vertical

Connections:
+3V3: J42.2, J43.1, J44.1; also elsewhere on the board
GND: J42.1, J43.2, J44.2; also elsewhere on the board
I2C_SCL: J42.4; also elsewhere on the board
I2C_SDA: J42.3; also elsewhere on the board
SPI_MISO: J43.4; also elsewhere on the board
SPI_MOSI: J43.3; also elsewhere on the board
SPI_SCK: J43.5; also elsewhere on the board
UART_RX: J44.4; also elsewhere on the board
UART_TX: J44.3; also elsewhere on the board
