dotrodeo/rodeo/rev-a/rodeo-motherboard/kicad/rodeo-motherboard.kicad_pcb

## KiCad design rev-a/rodeo-motherboard/kicad/rodeo-motherboard.kicad_pcb (continued)

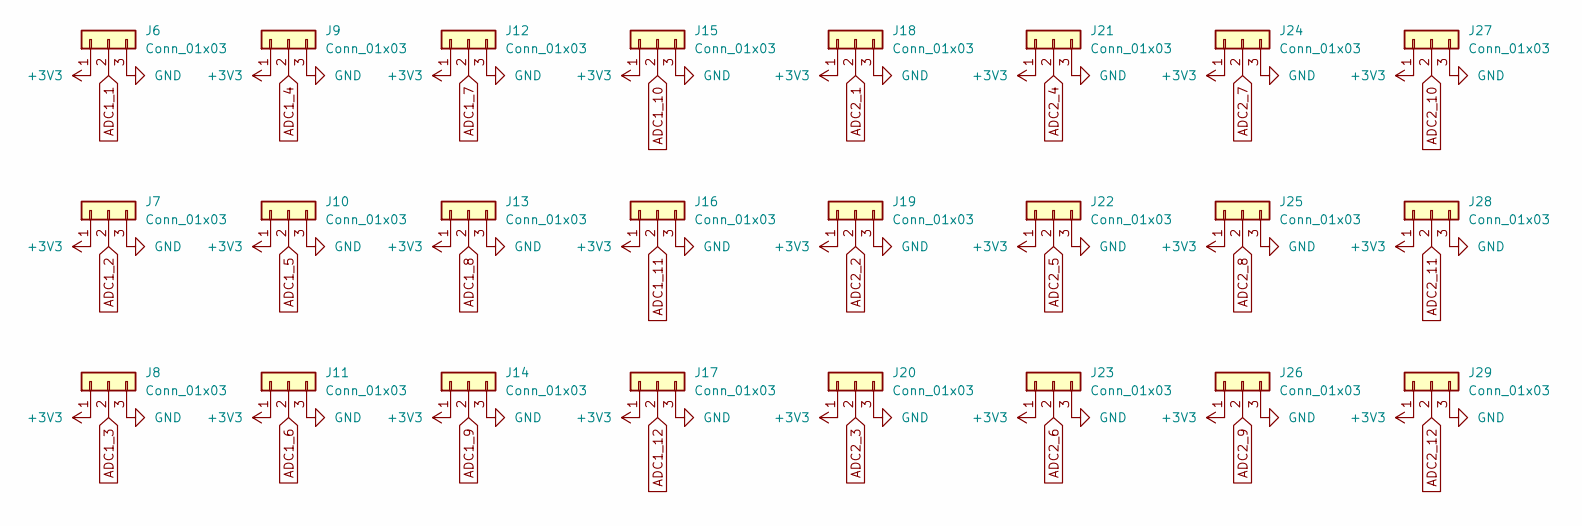
[picture p98: schematic jst_connectors.kicad_sch]

Parts:
J6, J7, J8, J9, J10, J11, J12, J13, J14, J15, J16, J17, J18, J19, J20, J21, J22, J23, J24, J25, J26, J27, J28, J29: Conn_01x03; JST_SH_BM03B-SRSS-TB_1x03-1MP_P1.00mm_Vertical

Connections:
+3V3: J6.1, J7.1, J8.1, J9.1, J10.1, J11.1, J12.1, J13.1, J14.1, J15.1, J16.1, J17.1, J18.1, J19.1, J20.1, J21.1, J22.1, J23.1, J24.1, J25.1, J26.1, J27.1, J28.1, J29.1; also elsewhere on the board
ADC1_1: J6.2; also elsewhere on the board
ADC1_2: J7.2; also elsewhere on the board
ADC1_3: J8.2; also elsewhere on the board
ADC1_4: J9.2; also elsewhere on the board
ADC1_5: J10.2; also elsewhere on the board
ADC1_6: J11.2; also elsewhere on the board
ADC1_7: J12.2; also elsewhere on the board
ADC1_8: J13.2; also elsewhere on the board
ADC1_9: J14.2; also elsewhere on the board
ADC1_10: J15.2; also elsewhere on the board
ADC1_11: J16.2; also elsewhere on the board
ADC1_12: J17.2; also elsewhere on the board
ADC2_1: J18.2; also elsewhere on the board
ADC2_2: J19.2; also elsewhere on the board
ADC2_3: J20.2; also elsewhere on the board
ADC2_4: J21.2; also elsewhere on the board
ADC2_5: J22.2; also elsewhere on the board
ADC2_6: J23.2; also elsewhere on the board
ADC2_7: J24.2; also elsewhere on the board
ADC2_8: J25.2; also elsewhere on the board
ADC2_9: J26.2; also elsewhere on the board
ADC2_10: J27.2; also elsewhere on the board
ADC2_11: J28.2; also elsewhere on the board
ADC2_12: J29.2; also elsewhere on the board
GND: J6.3, J7.3, J8.3, J9.3, J10.3, J11.3, J12.3, J13.3, J14.3, J15.3, J16.3, J17.3, J18.3, J19.3, J20.3, J21.3, J22.3, J23.3, J24.3, J25.3, J26.3, J27.3, J28.3, J29.3; also elsewhere on the board

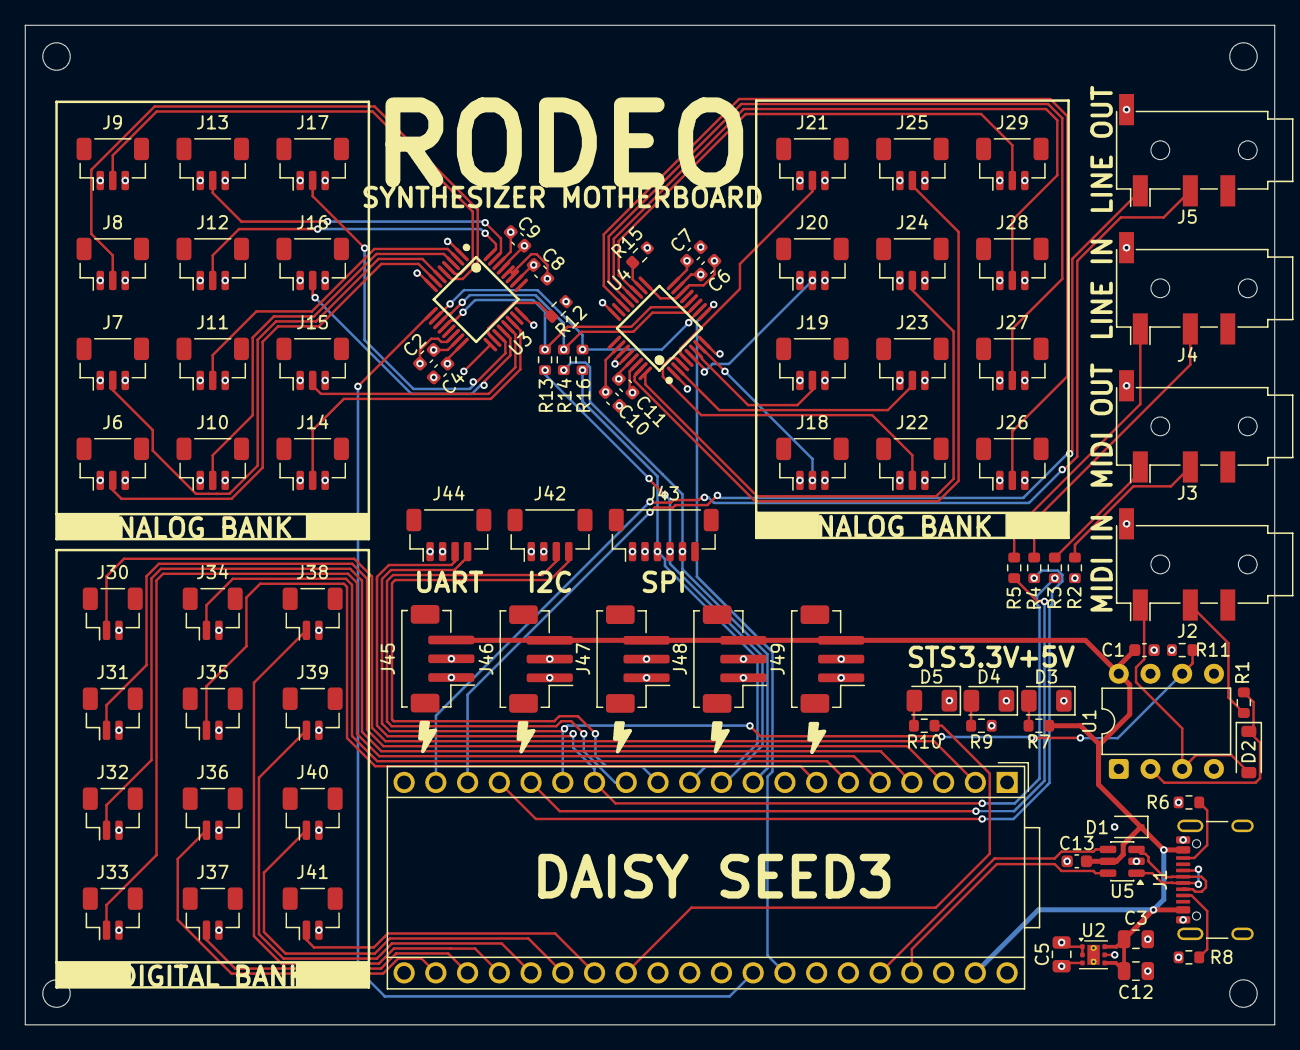
[picture p99: board rev-a/rodeo-motherboard/kicad/rodeo-motherboard.kicad_pcb from above]

Board: 4 copper layers, 100.0 x 80.0 mm, 89 parts (0 on the bottom side), 74 nets.
