dotrodeo/rodeo/hardware/rodeo-encoder-bank-4/rodeo-encoder-bank-4.kicad_pcb

## KiCad design hardware/rodeo-encoder-bank-4/rodeo-encoder-bank-4.kicad_pcb (2026-10-16)

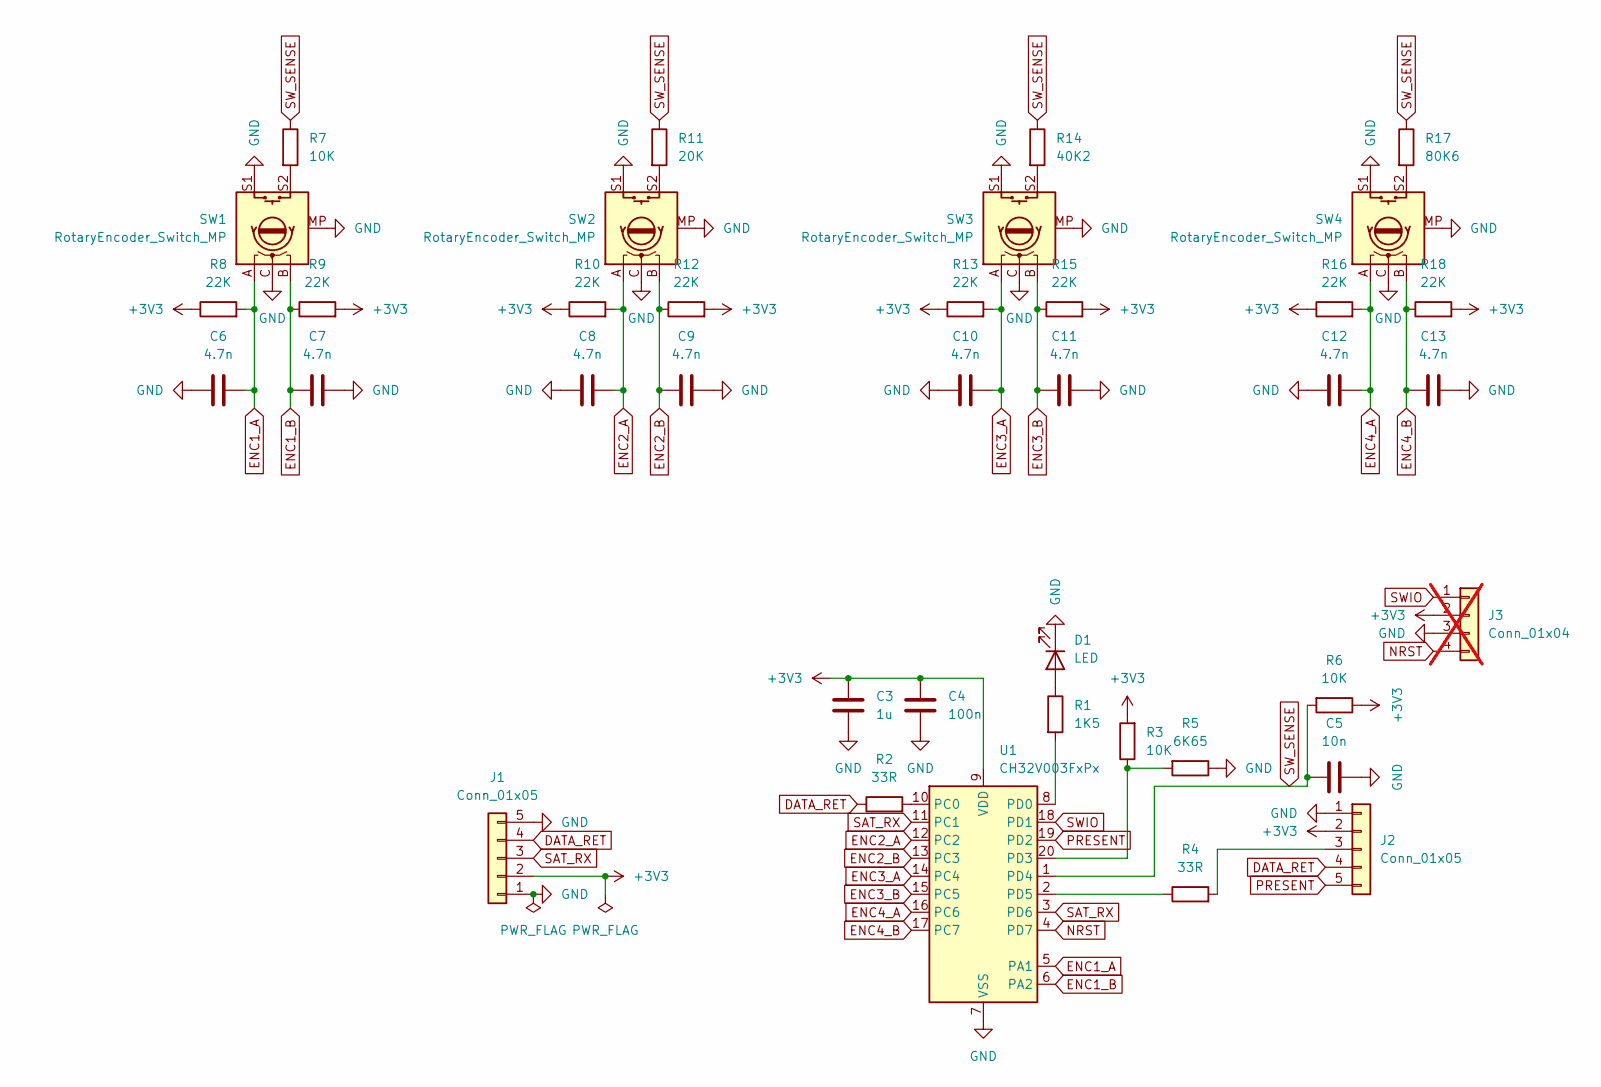
[picture p100: schematic rodeo-encoder-bank-4.kicad_sch]

Parts:
C3: 1u; C_0402_1005Metric; LCSC Part C52923
C4: 100n; C_0402_1005Metric; LCSC Part C1525
C5: 10n; C_0402_1005Metric; LCSC Part C15195
C6, C7, C8, C9, C10, C11, C12, C13: 4.7n; C_0402_1005Metric; LCSC Part C1538
D1: LED; LED_1206_3216Metric_ReverseMount_Hole1.8x2.4mm; LCSC Part C125107
J1, J2: Conn_01x05; JST_SH_BM05B-SRSS-TB_1x05-1MP_P1.00mm_Vertical; LCSC Part C160391
J3: Conn_01x04; PinHeader_1x04_P2.54mm_Vertical; not fitted
R1: 1K5; R_0603_1608Metric; LCSC Part C22843
R2, R4: 33R; R_0603_1608Metric; LCSC Part C23140
R3, R6, R7: 10K; R_0603_1608Metric; LCSC Part C25804
R5: 6K65; R_0603_1608Metric; LCSC Part C60344
R8, R9, R10, R12, R13, R15, R16, R18: 22K; R_0603_1608Metric; LCSC Part C31850
R11: 20K; R_0603_1608Metric; LCSC Part C4184
R14: 40K2; R_0603_1608Metric; LCSC Part C12447
R17: 80K6; R_0603_1608Metric; LCSC Part C23249
SW1, SW2, SW3, SW4: RotaryEncoder_Switch_MP; RotaryEncoder_Bourns_PEC11R-S_Vertical; LCSC Part C143790
U1: CH32V003FxPx; TSSOP-20_4.4x6.5mm_P0.65mm; LCSC Part C5187096

Connections:
+3V3: C3.2, C4.2, J1.2, J2.2, J3.2, R3.2, R6.1, R8.1, R9.2, R10.1, R12.2, R13.1, R15.2, R16.1, R18.2, U1.9 (VDD)
DATA_RET: J1.4, J2.4, R2.1
ENC1_A: C6.1, R8.2, SW1.A, U1.5 (PA1)
ENC1_B: C7.2, R9.1, SW1.B, U1.6 (PA2)
ENC2_A: C8.1, R10.2, SW2.A, U1.12 (PC2)
ENC2_B: C9.2, R12.1, SW2.B, U1.13 (PC3)
ENC3_A: C10.1, R13.2, SW3.A, U1.14 (PC4)
ENC3_B: C11.2, R15.1, SW3.B, U1.15 (PC5)
ENC4_A: C12.1, R16.2, SW4.A, U1.16 (PC6)
ENC4_B: C13.2, R18.1, SW4.B, U1.17 (PC7)
GND: C3.1, C4.1, C5.2, C6.2, C7.1, C8.2, C9.1, C10.2, C11.1, C12.2, C13.1, D1.1 (K), J1.1, J1.5, J2.1, J3.3, R5.1, SW1.C, SW1.MP, SW1.S1, SW2.C, SW2.MP, SW2.S1, SW3.C, SW3.MP, SW3.S1, SW4.C, SW4.MP, SW4.S1, U1.7 (VSS)
NRST: J3.4, U1.4 (PD7)
unnamed: D1.2 (A), R1.1
unnamed: J2.3, R4.2
unnamed: R7.2, SW1.S2
unnamed: R11.2, SW2.S2
unnamed: R14.2, SW3.S2
unnamed: R17.2, SW4.S2
unnamed: R2.2, U1.10 (PC0)
unnamed: R1.2, U1.8 (PD0)
unnamed: R3.1, R5.2, U1.20 (PD3)
unnamed: R4.1, U1.2 (PD5)
PRESENT: J2.5, U1.19 (PD2)
SAT_RX: J1.3, U1.3 (PD6), U1.11 (PC1)
SWIO: J3.1, U1.18 (PD1)
SW_SENSE: C5.1, R6.2, R7.1, R11.1, R14.1, R17.1, U1.1 (PD4)

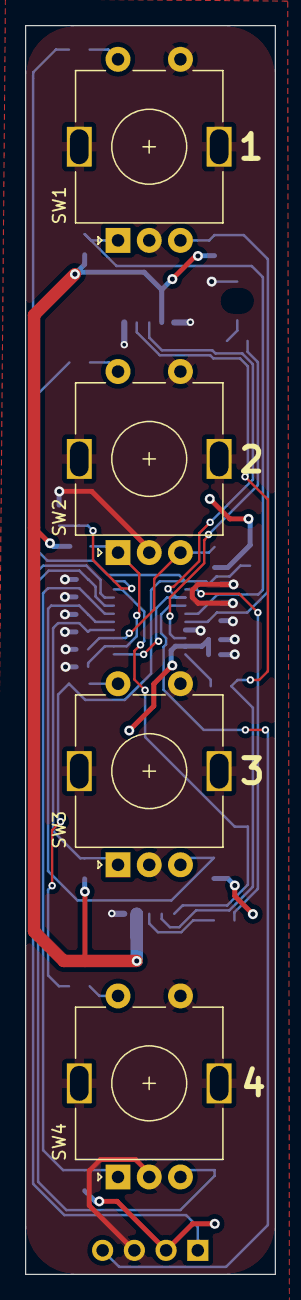
[picture p101: board rodeo-encoder-bank-4.kicad_pcb from above]

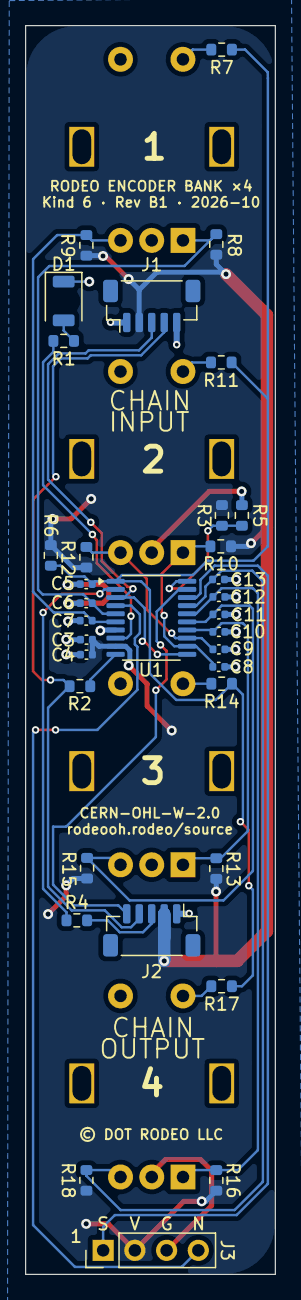
[picture p102: board rodeo-encoder-bank-4.kicad_pcb from below]

Board: 2 copper layers, 20.0 x 100.0 mm, 38 parts (34 on the bottom side), 26 nets.
