dotrodeo/rodeo/hardware/rodeo-power-barrel/rodeo-power-barrel.kicad_pcb

## KiCad design hardware/rodeo-power-barrel/rodeo-power-barrel.kicad_pcb (2026-10-16)

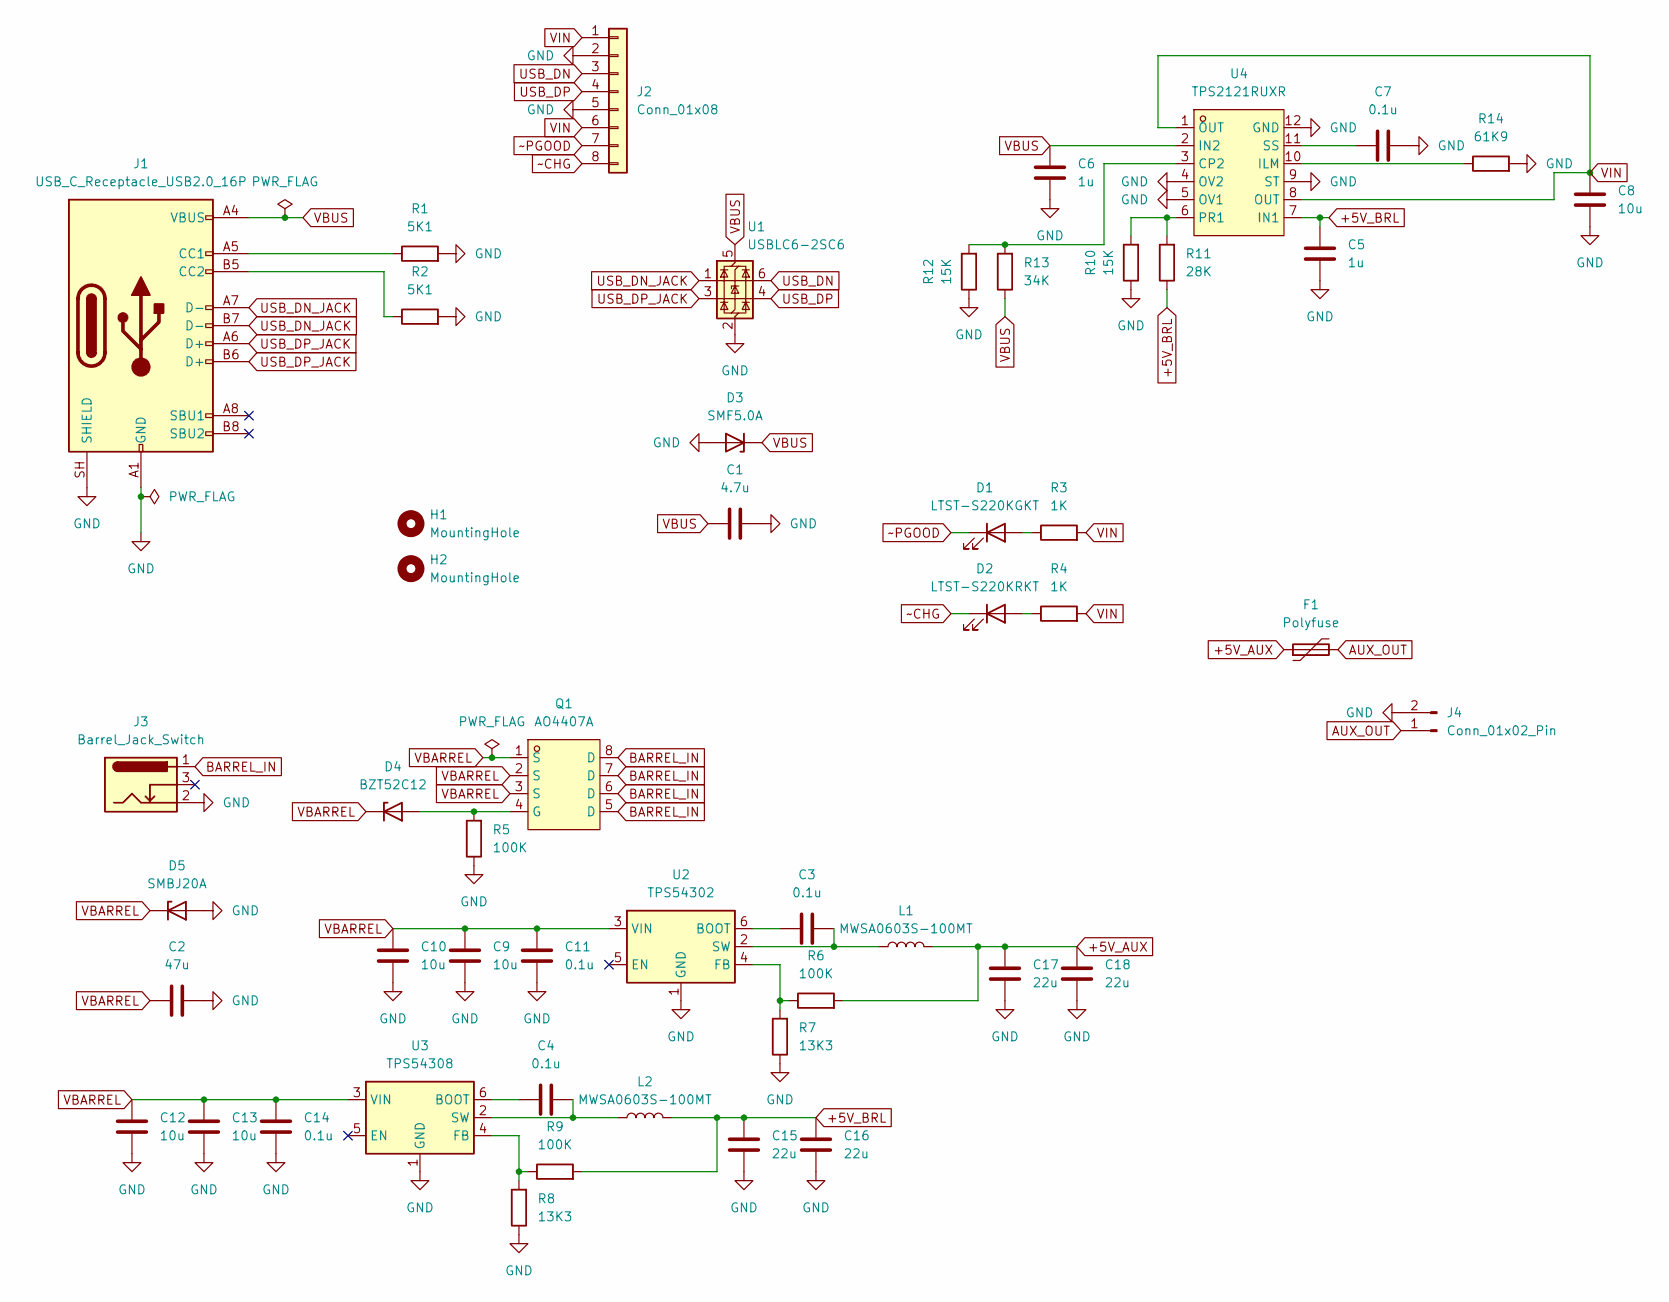
[picture p103: schematic rodeo-power-barrel.kicad_sch]

Parts:
C1: 4.7u; C_0603_1608Metric; LCSC Part C69335
C2: 47u; CP_Elec_6.3x5.4; LCSC Part C72522
C3, C4, C7, C11, C14: 0.1u; C_0603_1608Metric; LCSC Part C14663
C5, C6: 1u; C_0603_1608Metric; LCSC Part C15849
C8: 10u; C_0805_2012Metric; LCSC Part C15850
C9, C10, C12, C13: 10u; C_1206_3216Metric; LCSC Part C513774
C15, C16, C17, C18: 22u; C_0805_2012Metric; LCSC Part C45783
D1: LTST-S220KGKT; LED_LiteOn_LTST-S220_SideView; LCSC Part C160469
D2: LTST-S220KRKT; LED_LiteOn_LTST-S220_SideView; LCSC Part C284935
D3: SMF5.0A; D_SOD-123F; LCSC Part C193402
D4: BZT52C12; D_SOD-123; LCSC Part C173429
D5: SMBJ20A; D_SMB; LCSC Part C364296
F1: Polyfuse; Fuse_1812_4532Metric; LCSC Part C262035
H1, H2: MountingHole; MountingHole_3.2mm_M3
J1: USB_C_Receptacle_USB2.0_16P; USB_C_Receptacle_HRO_TYPE-C-31-M-12; LCSC Part C165948
J2: Conn_01x08; JST_PH_B8B-PH-K_1x08_P2.00mm_Vertical; LCSC Part C157974
J3: Barrel_Jack_Switch; BarrelJack_CUI_PJ-102AH_Horizontal; LCSC Part C3096093
J4: Conn_01x02_Pin; JST_VH_B2P-VH_1x02_P3.96mm_Vertical; LCSC Part C160315
L1, L2: MWSA0603S-100MT; L_Sunlord_MWSA0603S; LCSC Part C132141
Q1: AO4407A; SOIC-8_3.9x4.9mm_P1.27mm; MPN AO4407A; LCSC Part C2841482
R1, R2: 5K1; R_0402_1005Metric; LCSC Part C25905
R3, R4: 1K; R_0402_1005Metric; LCSC Part C11702
R5, R6, R9: 100K; R_0402_1005Metric; LCSC Part C25741
R7, R8: 13K3; R_0402_1005Metric; LCSC Part C274352
R10, R12: 15K; R_0402_1005Metric; LCSC Part C25756
R11: 28K; R_0402_1005Metric; LCSC Part C25772
R13: 34K; R_0402_1005Metric; LCSC Part C48939
R14: 61K9; R_0402_1005Metric; LCSC Part C25912
U1: USBLC6-2SC6; SOT-23-6; LCSC Part C7519
U2: TPS54302; TSOT-23-6; LCSC Part C311983
U3: TPS54308; SOT-23-6; LCSC Part C168839
U4: TPS2121RUXR; VQFN-HR-12_L2.5-W2.0-P0.50-BL; MPN TPS2121RUXR; LCSC Part C485916

Connections:
+5V_AUX: C17.2, C18.2, F1.1, L1.2, R6.2
+5V_BRL: C5.2, C15.2, C16.2, L2.2, R9.2, R11.1, U4.7 (IN1)
AUX_OUT: F1.2, J4.1
BARREL_IN: J3.1, Q1.5 (D), Q1.6 (D), Q1.7 (D), Q1.8 (D)
GND: C1.2, C2.2, C5.1, C6.1, C7.1, C8.2, C9.1, C10.1, C11.1, C12.1, C13.1, C14.1, C15.1, C16.1, C17.1, C18.1, D3.2 (A), D5.2 (A), J1.A1 (GND), J1.A12 (GND), J1.B1 (GND), J1.B12 (GND), J1.SH (SHIELD), J2.2, J2.5, J3.2, J4.2, R1.2, R2.2, R5.1, R7.1, R8.1, R10.1, R12.1, R14.2, U1.2 (GND), U2.1 (GND), U3.1 (GND), U4.4 (OV2), U4.5 (OV1), U4.9 (ST), U4.12 (GND)
unnamed: D1.2 (A), R3.1
unnamed: D2.2 (A), R4.1
unnamed: D4.2 (A), Q1.4 (G), R5.2
unnamed: J1.A5 (CC1), R1.1
unnamed: J1.B5 (CC2), R2.1
unnamed: C3.1, U2.6 (BOOT)
unnamed: R6.1, R7.2, U2.4 (FB)
unnamed: C3.2, L1.1, U2.2 (SW)
unnamed: C4.1, U3.6 (BOOT)
unnamed: R8.2, R9.1, U3.4 (FB)
unnamed: C4.2, L2.1, U3.2 (SW)
unnamed: R12.2, R13.2, U4.3 (CP2)
unnamed: R14.1, U4.10 (ILM)
unnamed: R10.2, R11.2, U4.6 (PR1)
unnamed: C7.2, U4.11 (SS)
USB_DN: J2.3, U1.6 (I/O1)
USB_DN_JACK: J1.A7 (D-), J1.B7 (D-), U1.1 (I/O1)
USB_DP: J2.4, U1.4 (I/O2)
USB_DP_JACK: J1.A6 (D+), J1.B6 (D+), U1.3 (I/O2)
VBARREL: C2.1, C9.2, C10.2, C11.2, C12.2, C13.2, C14.2, D4.1 (K), D5.1 (K), Q1.1 (S), Q1.2 (S), Q1.3 (S), U2.3 (VIN), U3.3 (VIN)
VBUS: C1.1, C6.2, D3.1 (K), J1.A4 (VBUS), J1.A9 (VBUS), J1.B4 (VBUS), J1.B9 (VBUS), R13.1, U1.5 (VBUS), U4.2 (IN2)
VIN: C8.1, J2.1, J2.6, R3.2, R4.2, U4.1 (OUT), U4.8 (OUT)
~CHG: D2.1 (K), J2.8
~PGOOD: D1.1 (K), J2.7

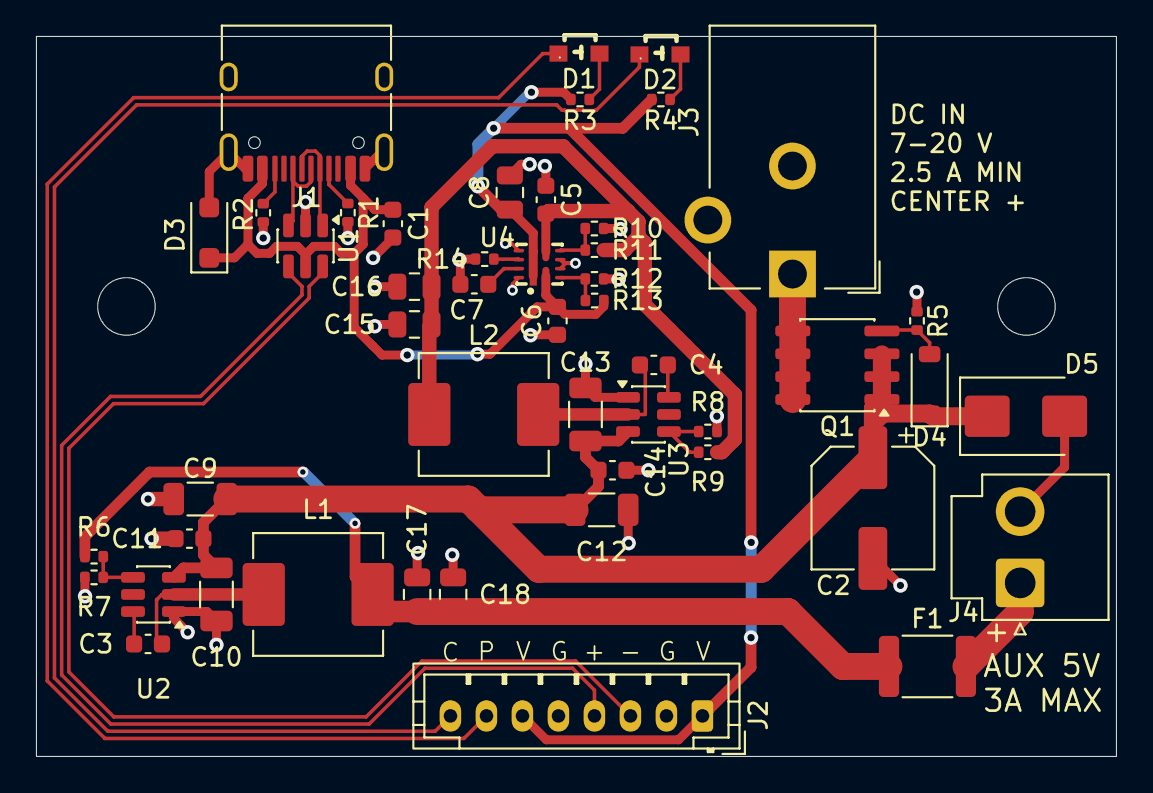
[picture p104: board rodeo-power-barrel.kicad_pcb from above]

Board: 2 copper layers, 60.0 x 40.0 mm, 51 parts (0 on the bottom side), 29 nets.
