dotrodeo/rodeo/rev-a/rodeo-encoder-hub/rodeo-encoder-hub.kicad_pcb

## KiCad design rev-a/rodeo-encoder-hub/rodeo-encoder-hub.kicad_pcb (2026-08-21)

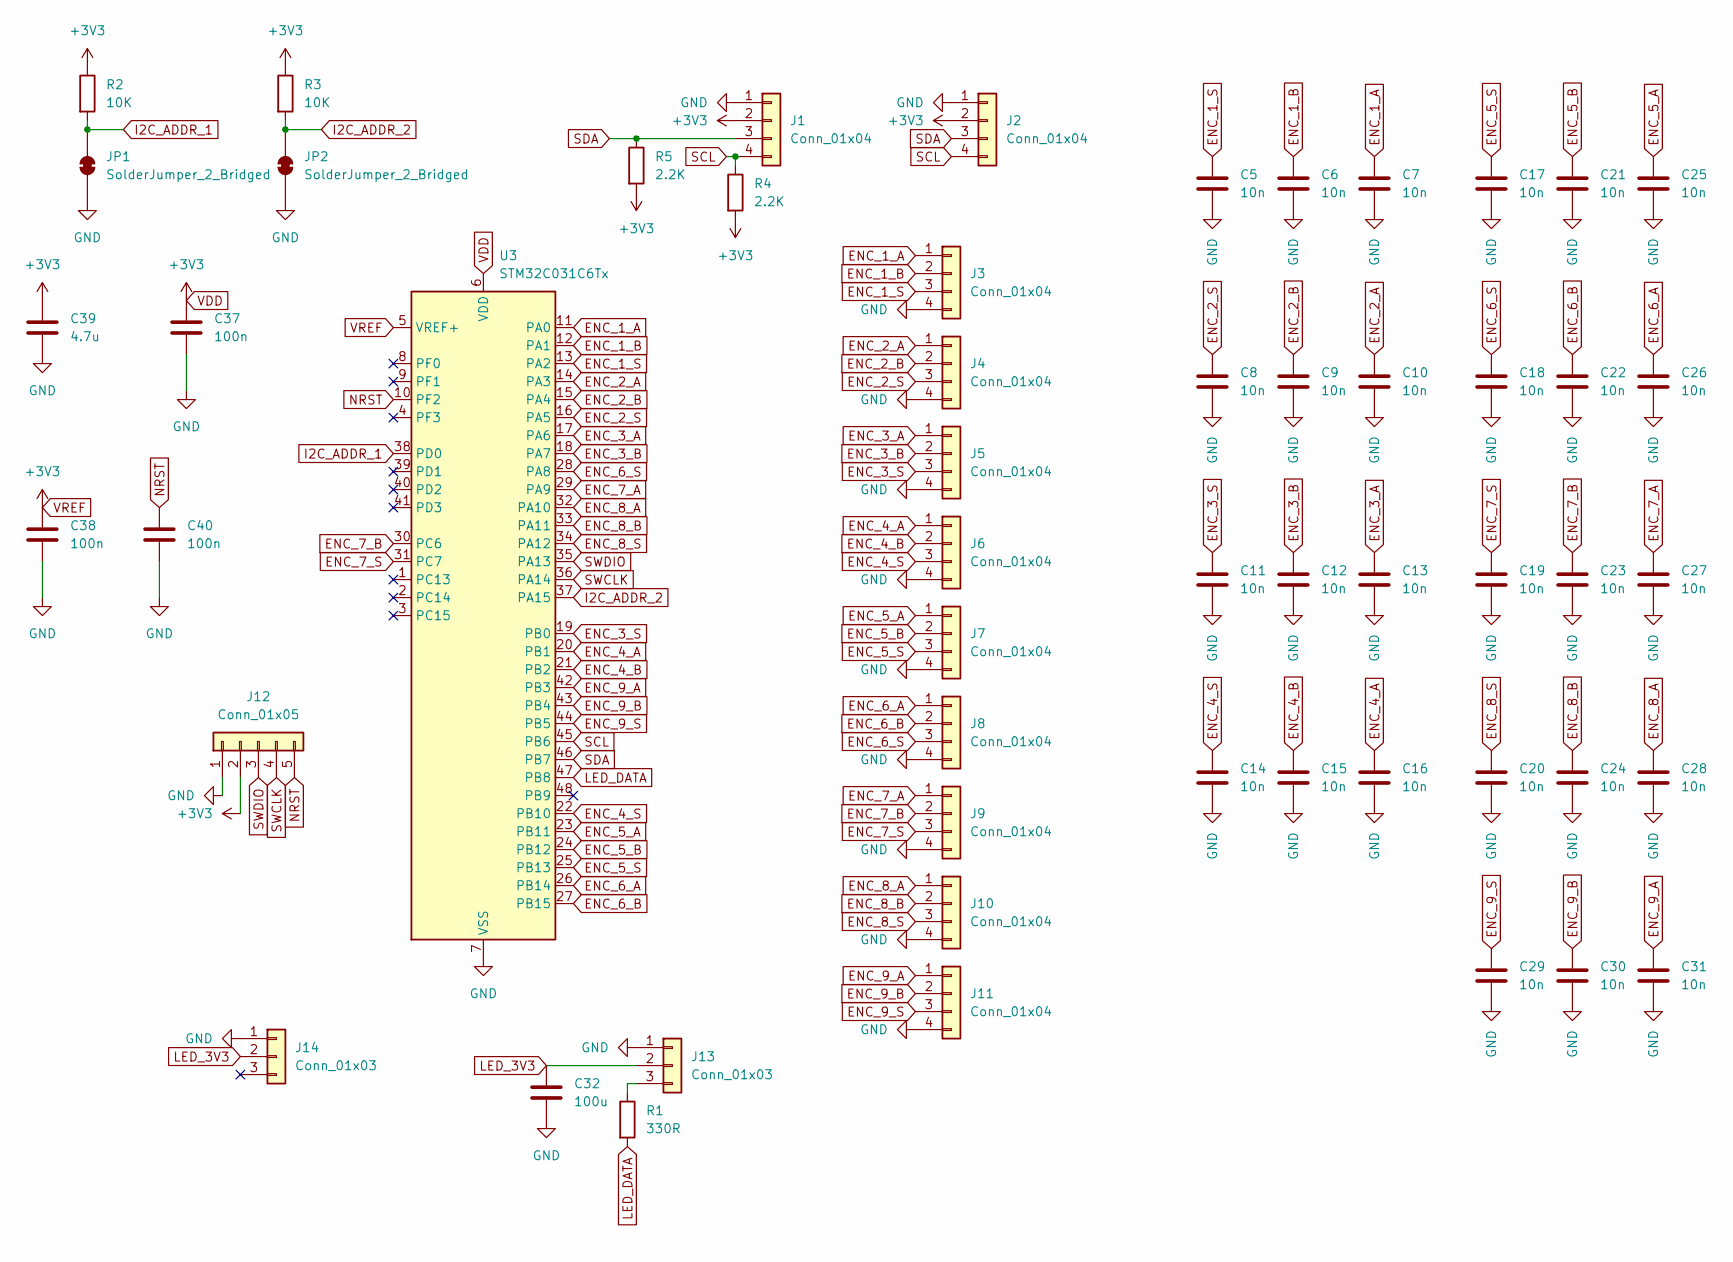
[picture p105: schematic rodeo-encoder-hub.kicad_sch]

Parts:
C5, C6, C7, C8, C9, C10, C11, C12, C13, C14, C15, C16, C17, C18, C19, C20, C21, C22, C23, C24, C25, C26, C27, C28, C29, C30, C31: 10n; C_0603_1608Metric
C32: 100u; C_1206_3216Metric
C37, C38, C40: 100n; C_0603_1608Metric
C39: 4.7u; C_0603_1608Metric
J1, J2, J3, J4, J5, J6, J7, J8, J9, J10, J11: Conn_01x04; JST_SH_SM04B-SRSS-TB_1x04-1MP_P1.00mm_Horizontal
J12: Conn_01x05; PinHeader_1x05_P1.27mm_Vertical
J13: Conn_01x03; JST_SH_SM03B-SRSS-TB_1x03-1MP_P1.00mm_Horizontal
J14: Conn_01x03; JST_ZH_S3B-ZR-SM4A-TF_1x03-1MP_P1.50mm_Horizontal
JP1, JP2: SolderJumper_2_Bridged; SolderJumper-2_P1.3mm_Bridged_Pad1.0x1.5mm
R1: 330R; R_0603_1608Metric
R2, R3: 10K; R_0603_1608Metric
R4, R5: 2.2K; R_0402_1005Metric
U3: STM32C031C6Tx; LQFP-48_7x7mm_P0.5mm

Connections:
ENC_1_A: C7.1, J3.1, U3.11 (PA0)
ENC_1_B: C6.1, J3.2, U3.12 (PA1)
ENC_1_S: C5.1, J3.3, U3.13 (PA2)
ENC_2_A: C10.1, J4.1, U3.14 (PA3)
ENC_2_B: C9.1, J4.2, U3.15 (PA4)
ENC_2_S: C8.1, J4.3, U3.16 (PA5)
ENC_3_A: C13.1, J5.1, U3.17 (PA6)
ENC_3_B: C12.1, J5.2, U3.18 (PA7)
ENC_3_S: C11.1, J5.3, U3.19 (PB0)
ENC_4_A: C16.1, J6.1, U3.20 (PB1)
ENC_4_B: C15.1, J6.2, U3.21 (PB2)
ENC_4_S: C14.1, J6.3, U3.22 (PB10)
ENC_5_A: C25.1, J7.1, U3.23 (PB11)
ENC_5_B: C21.1, J7.2, U3.24 (PB12)
ENC_5_S: C17.1, J7.3, U3.25 (PB13)
ENC_6_A: C26.1, J8.1, U3.26 (PB14)
ENC_6_B: C22.1, J8.2, U3.27 (PB15)
ENC_6_S: C18.1, J8.3, U3.28 (PA8)
ENC_7_A: C27.1, J9.1, U3.29 (PA9)
ENC_7_B: C23.1, J9.2, U3.30 (PC6)
ENC_7_S: C19.1, J9.3, U3.31 (PC7)
ENC_8_A: C28.1, J10.1, U3.32 (PA10)
ENC_8_B: C24.1, J10.2, U3.33 (PA11)
ENC_8_S: C20.1, J10.3, U3.34 (PA12)
ENC_9_A: C31.1, J11.1, U3.42 (PB3)
ENC_9_B: C30.1, J11.2, U3.43 (PB4)
ENC_9_S: C29.1, J11.3, U3.44 (PB5)
GND: C5.2, C6.2, C7.2, C8.2, C9.2, C10.2, C11.2, C12.2, C13.2, C14.2, C15.2, C16.2, C17.2, C18.2, C19.2, C20.2, C21.2, C22.2, C23.2, C24.2, C25.2, C26.2, C27.2, C28.2, C29.2, C30.2, C31.2, C32.2, C37.2, C38.2, C39.2, C40.2, J1.1, J2.1, J3.4, J4.4, J5.4, J6.4, J7.4, J8.4, J9.4, J10.4, J11.4, J12.1, J13.1, J14.1, JP1.1 (A), JP2.1 (A), U3.7 (VSS)
I2C_ADDR_1: JP1.2 (B), R2.2, U3.38 (PD0)
I2C_ADDR_2: JP2.2 (B), R3.2, U3.37 (PA15)
LED_3V3: C32.1, J13.2, J14.2
LED_DATA: R1.2, U3.47 (PB8)
NRST: C40.1, J12.5, U3.10 (PF2)
unnamed: J13.3, R1.1
SCL: J1.4, J2.4, R4.1, U3.45 (PB6)
SDA: J1.3, J2.3, R5.1, U3.46 (PB7)
SWCLK: J12.4, U3.36 (PA14)
SWDIO: J12.3, U3.35 (PA13)
VDD: C37.1, C38.1, C39.1, J1.2, J2.2, J12.2, R2.1, R3.1, R4.2, R5.2, U3.5 (VREF+), U3.6 (VDD)

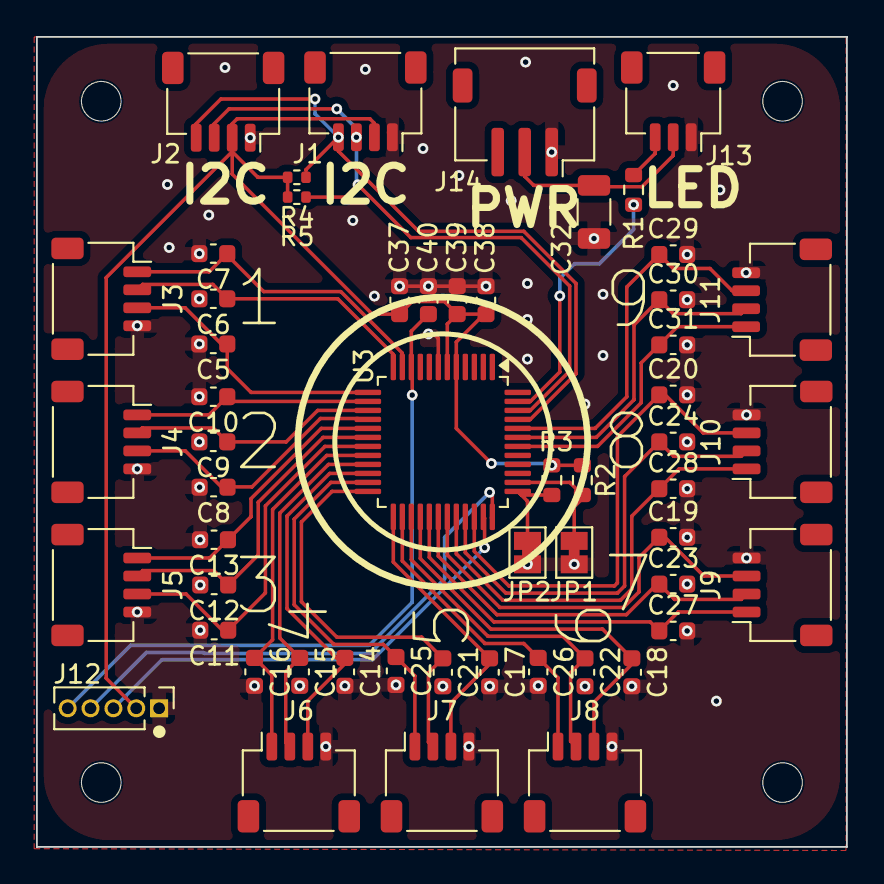
[picture p106: board rodeo-encoder-hub.kicad_pcb from above]

Board: 2 copper layers, 45.0 x 45.0 mm, 54 parts (0 on the bottom side), 39 nets.
