dotrodeo/rodeo/rev-a/rodeo-button/rodeo-button.kicad_pcb

## KiCad design rev-a/rodeo-button/rodeo-button.kicad_pcb (2026-08-21)

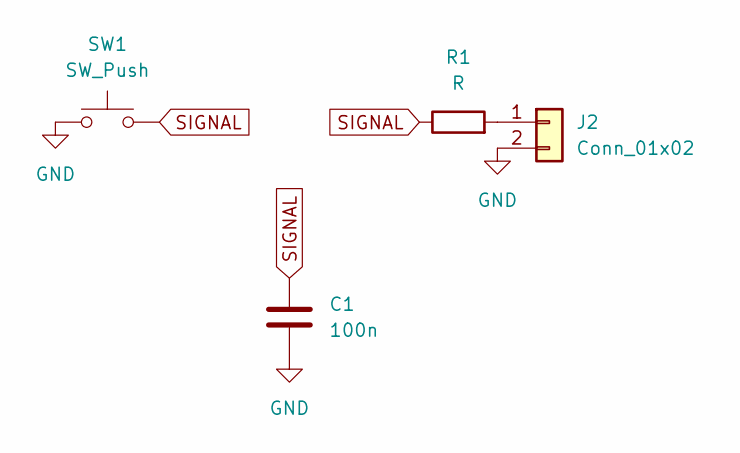
[picture p107: schematic rodeo-button.kicad_sch]

Parts:
C1: 100n; C_1206_3216Metric
J2: Conn_01x02; JST_SH_SM02B-SRSS-TB_1x02-1MP_P1.00mm_Horizontal
R1: R; R_1206_3216Metric
SW1: SW_Push; SW_PUSH-12mm

Connections:
GND: C1.2, J2.2, SW1.1
unnamed: J2.1, R1.2
SIGNAL: C1.1, R1.1, SW1.2

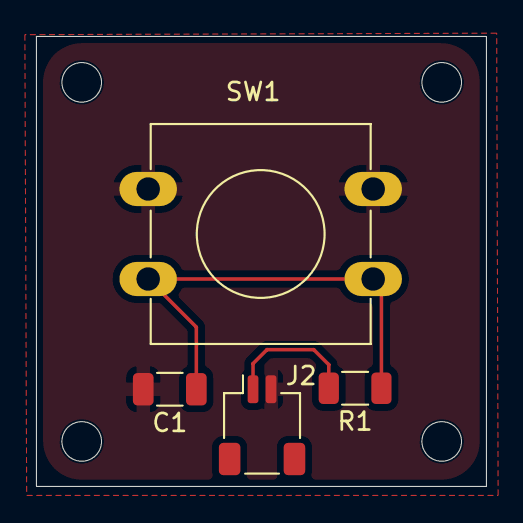
[picture p108: board rodeo-button.kicad_pcb from above]

Board: 2 copper layers, 25.0 x 25.0 mm, 4 parts (0 on the bottom side), 3 nets.
