dotrodeo/rodeo/hardware/rodeo-audio-3.5mm/rodeo-audio-3-5mm.kicad_pcb

## KiCad design hardware/rodeo-audio-3.5mm/rodeo-audio-3-5mm.kicad_pcb (2026-10-16)

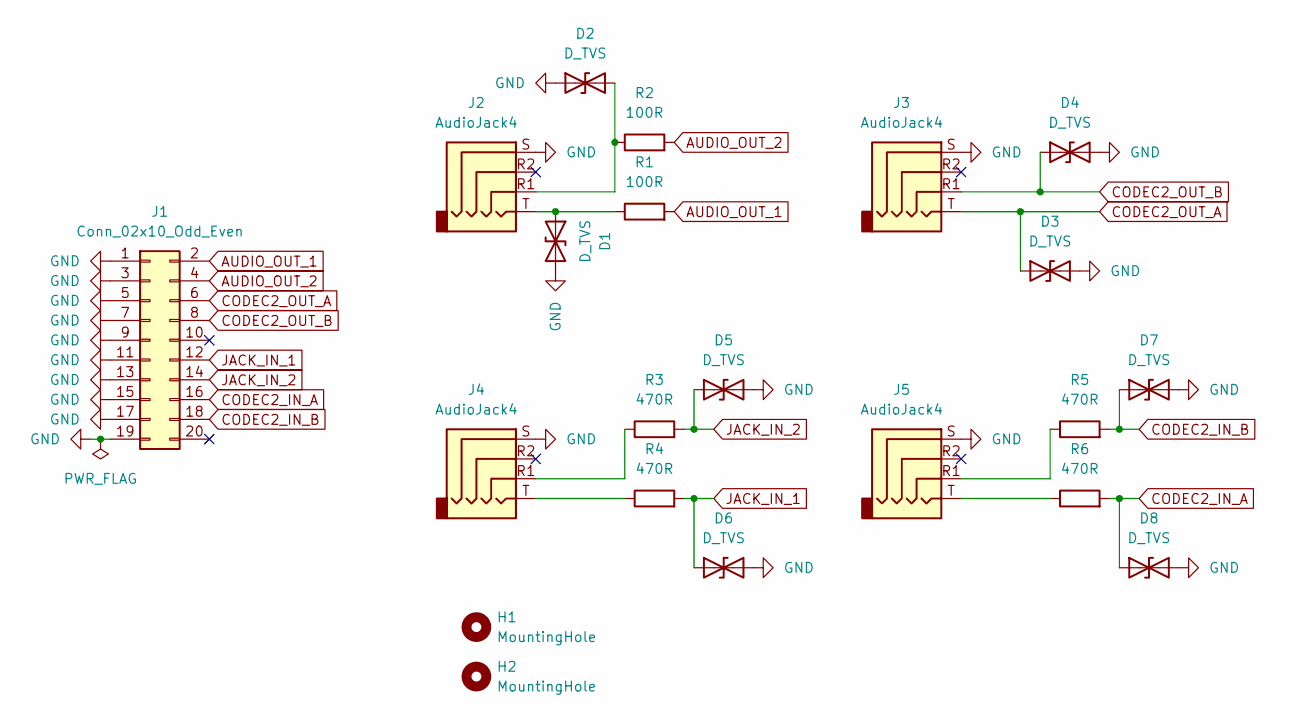
[picture p109: schematic rodeo-audio-3-5mm.kicad_sch]

Parts:
D1, D2, D3, D4, D5, D6, D7, D8: D_TVS; D_SOD-323; LCSC Part C7472904
H1, H2: MountingHole; MountingHole_3.2mm_M3
J1: Conn_02x10_Odd_Even; IDC-Header_2x10_P2.54mm_Vertical; LCSC Part C2977593
J2, J3, J4, J5: AudioJack4; Jack_3.5mm_PJ320D_Horizontal; LCSC Part C431535
R1, R2: 100R; R_0402_1005Metric; LCSC Part C25076
R3, R4, R5, R6: 470R; R_0603_1608Metric; LCSC Part C23179

Connections:
AUDIO_OUT_1: J1.2, R1.2
AUDIO_OUT_2: J1.4, R2.2
CODEC2_IN_A: D8.1 (A1), J1.16, R6.2
CODEC2_IN_B: D7.1 (A1), J1.18, R5.2
CODEC2_OUT_A: D3.1 (A1), J1.6, J3.T
CODEC2_OUT_B: D4.1 (A1), J1.8, J3.R1
GND: D1.2 (A2), D2.1 (A1), D3.2 (A2), D4.2 (A2), D5.2 (A2), D6.2 (A2), D7.2 (A2), D8.2 (A2), J1.1, J1.3, J1.5, J1.7, J1.9, J1.11, J1.13, J1.15, J1.17, J1.19, J2.S, J3.S, J4.S, J5.S
JACK_IN_1: D6.1 (A1), J1.12, R4.2
JACK_IN_2: D5.1 (A1), J1.14, R3.2
unnamed: D1.1 (A1), J2.T, R1.1
unnamed: D2.2 (A2), J2.R1, R2.1
unnamed: J4.R1, R3.1
unnamed: J4.T, R4.1
unnamed: J5.R1, R5.1
unnamed: J5.T, R6.1

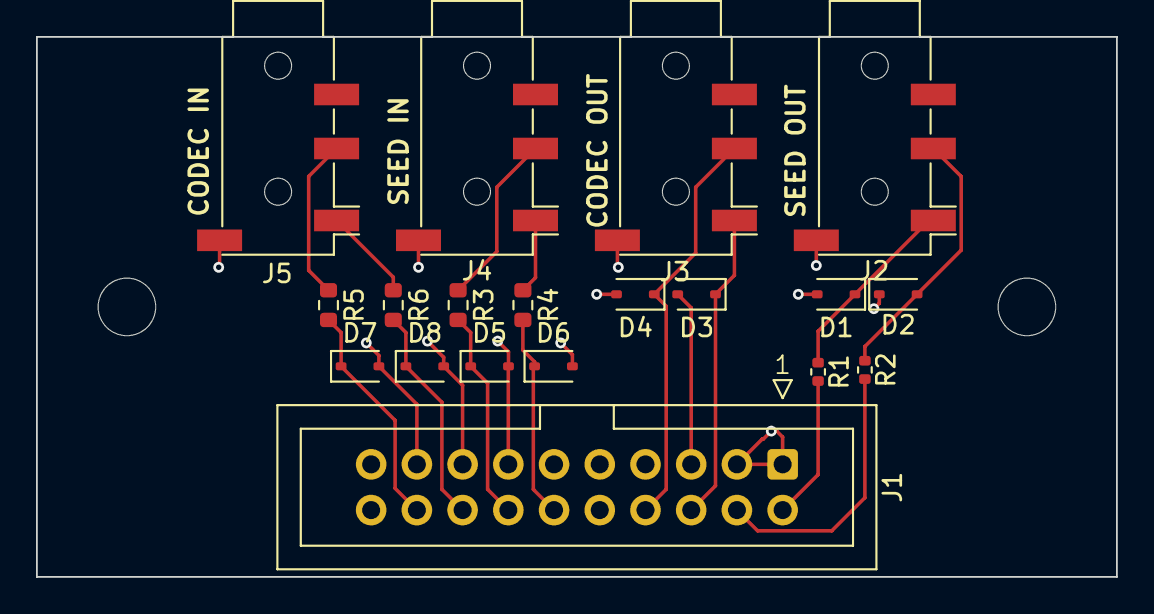
[picture p110: board rodeo-audio-3-5mm.kicad_pcb from above]

Board: 2 copper layers, 60.0 x 30.0 mm, 21 parts (0 on the bottom side), 15 nets.
