dotrodeo/rodeo/hardware/rodeo-midi/rodeo-midi.kicad_pcb

## KiCad design hardware/rodeo-midi/rodeo-midi.kicad_pcb (2026-10-16)

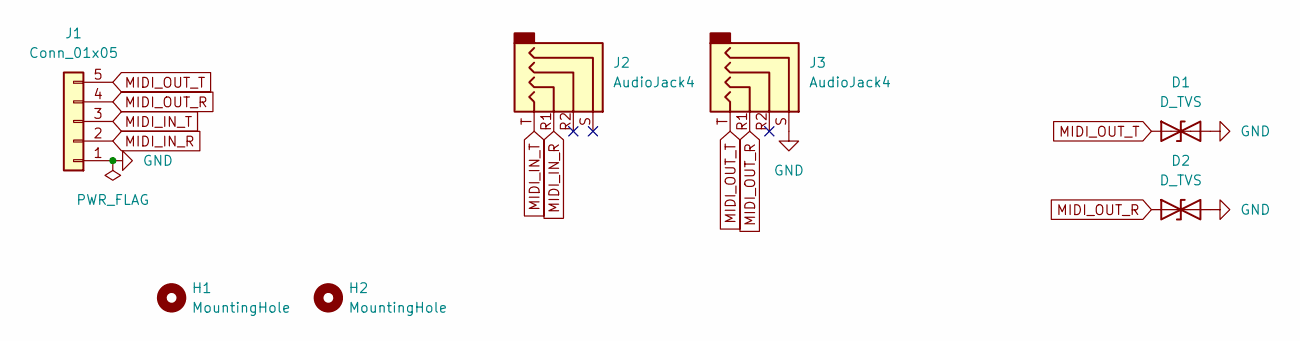
[picture p111: schematic rodeo-midi.kicad_sch]

Parts:
D1, D2: D_TVS; D_SOD-323; LCSC Part C7472904
H1, H2: MountingHole; MountingHole_3.2mm_M3
J1: Conn_01x05; JST_SH_BM05B-SRSS-TB_1x05-1MP_P1.00mm_Vertical; LCSC Part C160391
J2, J3: AudioJack4; Jack_3.5mm_PJ320D_Horizontal; LCSC Part C431535

Connections:
GND: D1.2 (A2), D2.2 (A2), J1.1, J3.S
MIDI_IN_R: J1.2, J2.R1
MIDI_IN_T: J1.3, J2.T
MIDI_OUT_R: D2.1 (A1), J1.4, J3.R1
MIDI_OUT_T: D1.1 (A1), J1.5, J3.T

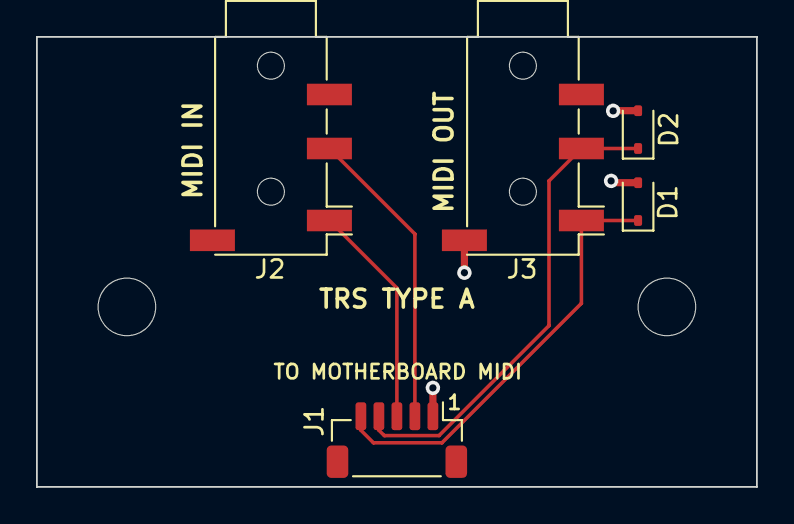
[picture p112: board rodeo-midi.kicad_pcb from above]

Board: 2 copper layers, 40.0 x 25.0 mm, 7 parts (0 on the bottom side), 5 nets.
