dotrodeo/rodeo/rev-a/rodeo-potentiometer/rodeo-potentiometer.kicad_pcb

## KiCad design rev-a/rodeo-potentiometer/rodeo-potentiometer.kicad_pcb (2026-08-21)

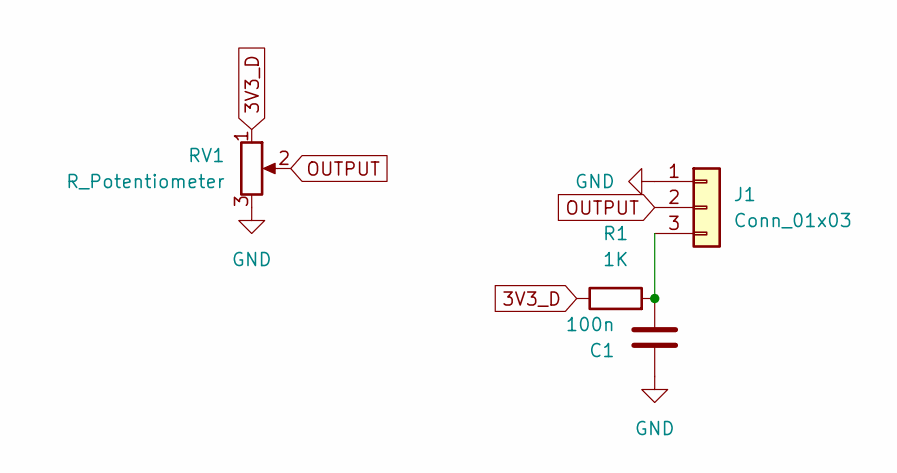
[picture p113: schematic rodeo-potentiometer.kicad_sch]

Parts:
C1: 100n; C_0603_1608Metric
J1: Conn_01x03; JST_SH_SM03B-SRSS-TB_1x03-1MP_P1.00mm_Horizontal
R1: 1K; R_0603_1608Metric
RV1: R_Potentiometer; Potentiometer_Alps_RK09K_Single_Vertical

Connections:
3V3_D: R1.1, RV1.1
GND: C1.1, J1.1, RV1.3
unnamed: C1.2, J1.3, R1.2
OUTPUT: J1.2, RV1.2

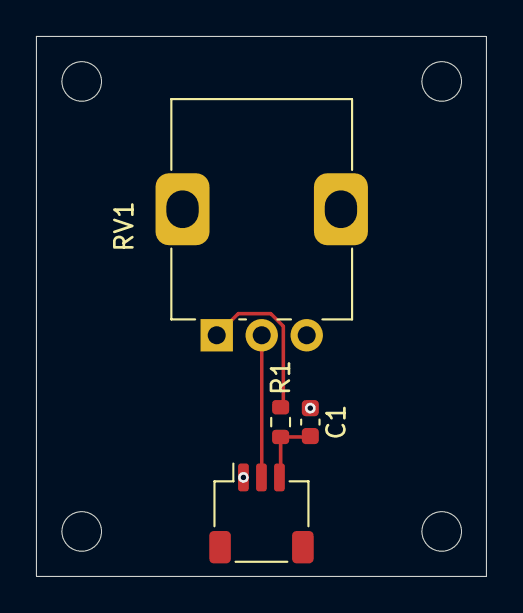
[picture p114: board rodeo-potentiometer.kicad_pcb from above]

Board: 2 copper layers, 25.0 x 30.0 mm, 4 parts (0 on the bottom side), 4 nets.
