dotrodeo/rodeo/rodeo-satellite/firmware/satellite.c

// rodeo-satellite: one image for every satellite on the chain.
//
// At power-up it reads its ID resistor to learn which board it is on, sets up
// that board's pins, and then does two things for good:
//
//   * passes every frame along the ring, a byte at a time (stream.c), with its
//     own inputs appended and its own outputs taken off;
//   * keeps those inputs current: pots and the switch ladder through the ADC,
//     encoders by polling, the LED from what the Seed last sent.
//
// The protocol is RODEO_SATELLITE_CHAIN_CONTRACT.md; its bytes are
// rodeo-sdk/common/sat_frame.h. Everything here is hardware glue: the logic it
// calls is host-tested in ../tests.
//
// Timing rule: once a frame is passing through, the satellite must send a byte
// for every byte it receives, and a gap of two byte times anywhere in a frame
// ends it for the next satellite. So frames pass through in USART1's interrupt,
// a byte in and a byte out at the line's own pace, and the main loop (inputs,
// ADC, LED) can take as long as it likes. When a frame's last byte arrives the
// satellite owes up to 17 bytes at once. Sent from the main loop, one per pass,
// they went out with gaps whenever a pass ran long; worked out all together in
// the interrupt, the first was late by more than the gap. Either way the second
// satellite in a Rev B ring dropped every SCAN. So the interrupt sends the first
// at once and works out each of the rest as the transmitter empties
// (stream_next()), and the last satellite holds the return wire until the frame
// has gone, not just until its fifo runs dry. The main loop shares three things with
// the interrupt, each behind __disable_irq(): the input slots, the finished
// frame's results, and the idle-gap and routing checks.

#include "ch32fun.h"
#include <stdio.h>

#include "boards.h"
#include "buttons.h"
#include "encoder.h"
#include "kind.h"
#include "ladder.h"
#include "lights.h"
#include "pot.h"
#include "stream.h"

// The button bank's WS2812B LEDs: ch32v003fun's driver clocks their bit stream
// out of SPI1's MOSI (PC6) by DMA (channel 3; USART1 uses 4 and 5), calling
// WS2812BLEDCallback() from its interrupt for each LED's word.
#define WS2812DMA_IMPLEMENTATION
#pragma GCC diagnostic push
#pragma GCC diagnostic ignored "-Wunused-but-set-variable" // inside the library
#include "ws2812b_dma_spi_led_driver.h"
#pragma GCC diagnostic pop

#define FW_MAJOR 1
#define FW_MINOR 0

#define TICKS_US DELAY_US_TIME // SysTick ticks per microsecond
#define TICKS_MS DELAY_MS_TIME
#define IDLE_GAP_TICKS (SAT_IDLE_GAP_BYTES * 10u * TICKS_US) // 2 byte times

// The pin a GPIO-fed ID divider hangs from (the pot bank's PC2); see kind.h.
static const sat_pin kIdFeed = {'C', 2};
static const sat_pin kIdPin  = {'D', 3};
static const sat_pin kTxFwd  = {'D', 5}; // USART1 map 0 TX
static const sat_pin kRxFwd  = {'D', 6}; // map 0 RX
static const sat_pin kTxRet  = {'C', 0}; // map 3 TX: the DATA_RET tap
static const sat_pin kRxRet  = {'C', 1}; // map 3 RX

// --- Pins -------------------------------------------------------------------------

static int  code(sat_pin p) { return (p.port - 'A') * 16 + p.pin; }
static bool has(sat_pin p) { return p.port != 0; }

static void mode(sat_pin p, uint32_t m)
{
    int c = code(p);
    funPinMode(c, m);
}

static int  get(sat_pin p) { return funDigitalRead(code(p)); }
static void put(sat_pin p, int v)
{
    int c = code(p);
    funDigitalWrite(c, v ? FUN_HIGH : FUN_LOW);
}

// --- ADC, one conversion at a time -------------------------------------------------

static void adc_init(void)
{
    RCC->APB2PCENR |= RCC_APB2Periph_ADC1;
    RCC->CFGR0 &= ~(0x1F << 11); // ADC clock HCLK / 2
    RCC->APB2PRSTR |= RCC_APB2Periph_ADC1;
    RCC->APB2PRSTR &= ~RCC_APB2Periph_ADC1;
    ADC1->RSQR1 = 0; // one conversion per start
    ADC1->RSQR2 = 0;
    ADC1->SAMPTR2 = 0x00FFFFFF; // channels 0-7: the longest sample time (241 cycles)
    ADC1->CTLR2 |= ADC_ADON | ADC_EXTSEL;
    ADC1->CTLR2 |= ADC_RSTCAL;
    while(ADC1->CTLR2 & ADC_RSTCAL) {}
    ADC1->CTLR2 |= ADC_CAL;
    while(ADC1->CTLR2 & ADC_CAL) {}
}

static void adc_start(int8_t channel)
{
    ADC1->RSQR3 = (uint32_t)channel;
    ADC1->CTLR2 |= ADC_SWSTART;
}

static bool adc_ready(void) { return ADC1->STATR & ADC_EOC; }
static uint16_t adc_result(void) { return (uint16_t)ADC1->RDATAR; }

// Blocking read: only at boot, before the chain is served.
static uint16_t adc_read(int8_t channel)
{
    adc_start(channel);
    while(!adc_ready()) {}
    return adc_result();
}

// --- Board kind (boot) ---------------------------------------------------------------

static uint16_t id_read(void* ctx)
{
    (void)ctx;
    uint32_t sum = 0;
    for(int i = 0; i < 4; i++)
        sum += adc_read(sat_adc_channel(kIdPin));
    return (uint16_t)(sum / 4);
}

static void id_feed(void* ctx, bool high)
{
    (void)ctx;
    if(high)
    {
        mode(kIdFeed, GPIO_Speed_10MHz | GPIO_CNF_OUT_PP);
        put(kIdFeed, 1);
        Delay_Us(50); // let the divider settle
    }
    else
        mode(kIdFeed, GPIO_CNF_IN_FLOATING);
}

// --- The chain UART ------------------------------------------------------------------

// A power of two, so the free-running counters wrap cleanly at 2^32.
#define TX_LEN 512
static uint8_t           tx_fifo[TX_LEN];
static volatile uint32_t tx_head, tx_tail;
static volatile bool     routed_last; // USART1 is on map 3: TX on the return tap
static volatile bool     tap_driven;
static volatile uint32_t last_rx; // SysTick when the last byte arrived
static sat_stream         st;      // the frame passing through; the interrupt owns it

static void uart_init(void)
{
    RCC->APB2PCENR |= RCC_APB2Periph_USART1 | RCC_APB2Periph_AFIO;
    USART1->BRR   = FUNCONF_SYSTEM_CORE_CLOCK / SAT_BAUD; // 48: mantissa 3, fraction 0
    USART1->CTLR1 = USART_CTLR1_TE | USART_CTLR1_RE | USART_CTLR1_UE
                    | USART_CTLR1_RXNEIE; // 8N1; TXEIE while there is something to send
    NVIC_SetPriority(USART1_IRQn, 0);  // above the WS2812B driver's DMA interrupt
    NVIC_EnableIRQ(USART1_IRQn);
}

// Map 0 (TX to the next satellite) or map 3 (TX back along DATA_RET). Only
// called between frames. On map 3 the tap is an input until there is something
// to send, so a satellite past a forced break never fights the return wire.
static void route(bool last)
{
    if(last)
    {
        AFIO->PCFR1 |= AFIO_PCFR1_USART1_REMAP | AFIO_PCFR1_USART1_REMAP_1;
        mode(kTxFwd, GPIO_CNF_IN_FLOATING);
        mode(kTxRet, GPIO_CNF_IN_FLOATING);
        mode(kRxRet, GPIO_CNF_IN_FLOATING);
    }
    else
    {
        AFIO->PCFR1 &= ~(AFIO_PCFR1_USART1_REMAP | AFIO_PCFR1_USART1_REMAP_1);
        mode(kTxRet, GPIO_CNF_IN_FLOATING);
        mode(kTxFwd, GPIO_Speed_50MHz | GPIO_CNF_OUT_PP_AF);
        mode(kRxFwd, GPIO_CNF_IN_FLOATING);
    }
    routed_last = last;
    tap_driven  = false;
}

// From the interrupt.
static void tx_push(const uint8_t* b, size_t n)
{
    if(!n)
        return;
    if(routed_last && !tap_driven)
    {
        mode(kTxRet, GPIO_Speed_50MHz | GPIO_CNF_OUT_PP_AF); // drive the tap
        tap_driven = true;
    }
    for(size_t i = 0; i < n; i++)
        tx_fifo[tx_head++ & (TX_LEN - 1)] = b[i];
    USART1->CTLR1 |= USART_CTLR1_TXEIE;
}

static bool tx_idle(void)
{
    return tx_head == tx_tail && (USART1->STATR & USART_STATR_TC);
}

// From the main loop, once the frame has ended and its last byte has gone. Not
// merely when the fifo runs dry: a satellite sends one byte for each it receives,
// so the fifo empties between bytes, and a released tap floats mid-frame.
static void tap_release(void)
{
    __disable_irq();
    if(tap_driven && !st.active && tx_idle())
    {
        mode(kTxRet, GPIO_CNF_IN_FLOATING); // release the return wire
        tap_driven = false;
    }
    __enable_irq();
}

// --- State -----------------------------------------------------------------------------

static sat_board  board;
static sat_slot   inputs[4]; // read by the interrupt as each frame's header completes
static uint8_t    n_inputs;
static bool       fault; // the kind couldn't be read, or isn't supported here

static sat_pot_filter pot_filt[4];
static sat_quad       enc[4];
static uint8_t        n_enc; // encoders on this board
static sat_ladder     ladder;

static sat_buttons    buttons;      // the button bank's switches
static sat_lights     lights;       // ...its LEDs, as the outputs ask
static bool           aux_present;  // ...and whether they run from aux 5 V
static uint32_t       grb_now[LIGHTS_N], grb_sent[LIGHTS_N];
static uint32_t       lights_sent_ms;

uint32_t WS2812BLEDCallback(int ledno)
{
    return ledno >= 0 && ledno < (int)LIGHTS_N ? grb_sent[ledno] : 0;
}

// A frame's results, handed from the interrupt to the main loop.
typedef struct
{
    bool     took;
    sat_slot taken[4];
    sat_slot cmds[4];
    uint8_t  n_cmds;
} frame_result;
static frame_result  frame_in;
static volatile bool frame_pending;

// Change an input slot whole, never while the interrupt is copying it.
static void set_input(int i, sat_slot v)
{
    __disable_irq();
    inputs[i] = v;
    __enable_irq();
}

static uint8_t  led_level, led_mode; // from the last LED slot
static uint32_t identify_until_ms;
static bool     forced_last;         // CLOSE_RING_HERE until RING_AUTO
static bool     reset_pending;

static uint32_t now_ms;

// The ADC channels this board reads each millisecond, in order.
static int8_t  adc_chan[5];
static uint8_t adc_n, adc_i;
static bool    adc_busy;

static void setup_board(int kind, uint8_t detail)
{
    sat_descriptor me = {0};
    me.fw_major       = FW_MAJOR;
    me.fw_minor       = FW_MINOR;
    me.slots          = 1;
    n_inputs          = 1;

    if(kind == SAT_KIND_POT || kind == SAT_KIND_POT_BANK_4)
    {
        board = kind == SAT_KIND_POT ? (sat_board)SAT_BOARD_POT_1 : (sat_board)SAT_BOARD_POT_BANK_4;
        for(int i = 0; i < 4 && has(board.pots[i]); i++)
        {
            mode(board.pots[i], GPIO_CNF_IN_ANALOG);
            adc_chan[adc_n++] = sat_adc_channel(board.pots[i]);
        }
    }
    else if(kind == SAT_KIND_ENCODER || kind == SAT_KIND_ENC_BANK_4)
    {
        board = kind == SAT_KIND_ENCODER ? (sat_board)SAT_BOARD_ENC_1 : (sat_board)SAT_BOARD_ENC_BANK_4;
        for(n_enc = 0; n_enc < 4 && has(board.enc_a[n_enc]); n_enc++)
        {
            mode(board.enc_a[n_enc], GPIO_CNF_IN_FLOATING); // pulled up on the board
            mode(board.enc_b[n_enc], GPIO_CNF_IN_FLOATING);
            quad_init(&enc[n_enc], (uint8_t)get(board.enc_a[n_enc]), (uint8_t)get(board.enc_b[n_enc]));
        }
        mode(board.switches, GPIO_CNF_IN_ANALOG);
        adc_chan[adc_n++] = sat_adc_channel(board.switches);
        // The bank's R7, R11, R14, R17; the single encoder's R8, its only rung.
        static const uint32_t r_bank[4]   = {10000, 20000, 40200, 80600};
        static const uint32_t r_single[4] = {10000, LADDER_ABSENT, LADDER_ABSENT, LADDER_ABSENT};
        ladder_init(&ladder, kind == SAT_KIND_ENCODER ? r_single : r_bank, LADDER_PULL_UP, 1023);
    }

    else if(kind == SAT_KIND_BUTTON_BANK_4)
    {
        board = (sat_board)SAT_BOARD_BUTTON_BANK_4;
        for(int i = 0; i < 4; i++)
        {
            mode(board.buttons[i], GPIO_CNF_IN_PUPD);
            put(board.buttons[i], 1); // pull-up: a pressed switch reads 0
        }
        mode(board.aux_sense, GPIO_CNF_IN_ANALOG);
        adc_chan[adc_n++] = sat_adc_channel(board.aux_sense);
        buttons_init(&buttons);
        lights_init(&lights);
        WS2812BDMAInit(); // PC6 to SPI1 MOSI; PC5 and PC7 stay untouched inputs
    }

    if(kind == SAT_KIND_POT || kind == SAT_KIND_ENCODER || kind == SAT_KIND_POT_BANK_4
       || kind == SAT_KIND_ENC_BANK_4 || kind == SAT_KIND_BUTTON_BANK_4)
    {
        me.kind  = (uint8_t)kind;
        me.slots = sat_kind_slots((uint8_t)kind);
        n_inputs = me.slots;
        mode(board.present, GPIO_CNF_IN_PUPD);
        put(board.present, 1); // pull-up
        mode(board.led, GPIO_Speed_10MHz | GPIO_CNF_OUT_PP);
        put(board.led, 0);
        for(int i = 0; i < n_inputs; i++)
            inputs[i] = sat_none();
    }
    else if(kind < 0)
    {
        fault     = true;
        me.kind   = SAT_KIND_NO_ID;
        inputs[0] = sat_fault(SAT_FAULT_ID_BETWEEN_BANDS, detail);
    }
    else if(kind == SAT_KIND_NO_ID)
    {
        me.kind   = SAT_KIND_NO_ID;
        inputs[0] = sat_slot_make(SAT_IN_EMPTY, 0, 0);
    }
    else
    {
        fault     = true; // a kind this firmware has no board for yet
        me.kind   = (uint8_t)kind;
        inputs[0] = sat_fault(SAT_FAULT_KIND_UNSUPPORTED, (uint8_t)kind);
    }
    stream_init(&st, me);
}

// Is this satellite the last in the ring? PRESENT high means nothing downstream.
static bool is_last(void)
{
    if(forced_last)
        return true;
    return has(board.present) ? get(board.present) : true;
}

// --- Per-millisecond and per-loop work ------------------------------------------------

static void inputs_poll(void)
{
    for(int i = 0; i < n_enc; i++)
        quad_update(&enc[i], (uint8_t)get(board.enc_a[i]), (uint8_t)get(board.enc_b[i]));
}

static void adc_service(void)
{
    if(!adc_busy || !adc_ready())
        return;
    uint16_t raw = adc_result();
    adc_busy     = false;
    if(st.me.kind == SAT_KIND_POT || st.me.kind == SAT_KIND_POT_BANK_4)
        set_input(adc_i, sat_pot(pot_filter(&pot_filt[adc_i], pot_scale10(raw), 2)));
    else if(st.me.kind == SAT_KIND_ENCODER || st.me.kind == SAT_KIND_ENC_BANK_4)
        ladder_update(&ladder, raw);
    else if(st.me.kind == SAT_KIND_BUTTON_BANK_4)
        aux_present = lights_aux_present(raw, 1023);
    if(++adc_i < adc_n)
    {
        adc_start(adc_chan[adc_i]);
        adc_busy = true;
    }
}

// The button bank, once a millisecond: debounce the switches into the four
// BUTTON slots, and work out what the LEDs should show. A new picture goes out
// only between frames, so the driver's short DMA interrupt never lands while a
// frame is streaming through, and at least every 100 ms, so a glitch can't stick.
static void buttons_service(void)
{
    uint8_t raw = 0;
    for(int i = 0; i < 4; i++)
        if(!get(board.buttons[i]))
            raw |= (uint8_t)(1u << i);
    buttons_update(&buttons, raw);
    for(int i = 0; i < 4; i++)
        set_input(i, sat_button((buttons.pressed >> i) & 1, buttons.presses[i]));

    lights_render(&lights, now_ms, now_ms < identify_until_ms,
                  aux_present ? LIGHTS_CAP_AUX_MA : LIGHTS_CAP_CHAIN_MA, grb_now);
    bool changed = false;
    for(unsigned i = 0; i < LIGHTS_N; i++)
        changed |= grb_now[i] != grb_sent[i];
    if((changed || now_ms - lights_sent_ms >= 100) && !WS2812BLEDInUse && !st.active)
    {
        for(unsigned i = 0; i < LIGHTS_N; i++)
            grb_sent[i] = grb_now[i];
        lights_sent_ms = now_ms;
        WS2812BDMAStart(LIGHTS_N);
    }
}

static void every_ms(void)
{
    // Start this millisecond's conversions; adc_service() walks them.
    if(adc_n && !adc_busy)
    {
        adc_i = 0;
        adc_start(adc_chan[0]);
        adc_busy = true;
    }
    if(st.me.kind == SAT_KIND_BUTTON_BANK_4)
        buttons_service();
    for(int i = 0; i < n_enc; i++)
        set_input(i, sat_encoder(enc[i].detents, (ladder.pressed >> i) & 1, ladder.presses[i]));

    // Re-check PRESENT and re-route, but only between frames.
    bool last = is_last();
    __disable_irq();
    if(!st.active && tx_idle())
    {
        if(last != routed_last)
            route(last);
        st.me.last = last;
    }
    __enable_irq();
}

#ifdef SAT_DEBUG
// `make DEBUG=1`: status over the WCH-LinkE's debug channel (`make monitor`),
// for testing a satellite on its own, with no Seed and no ring. It prints only
// while the chain is quiet, because a print stalls the loop long enough to
// break a frame passing through; with frames arriving it says nothing. Without
// a debugger attached, the first print times out (~120 ms) and the rest are
// skipped at once.
static const char* kind_name(uint8_t kind)
{
    switch(kind)
    {
        case SAT_KIND_POT: return "single pot";
        case SAT_KIND_ENCODER: return "single encoder";
        case SAT_KIND_POT_BANK_4: return "pot bank";
        case SAT_KIND_ENC_BANK_4: return "encoder bank";
        case SAT_KIND_BUTTON_BANK_4: return "button bank";
        case SAT_KIND_CUSTOM: return "custom (needs its own firmware)";
        case SAT_KIND_NO_ID: return "no ID resistor";
        default: return "unsupported";
    }
}

static void debug_status(void)
{
    printf("kind %d (%s)%s, %s, %s", st.me.kind, kind_name(st.me.kind), fault ? " FAULT" : "",
           st.me.last ? "last (PRESENT high)" : "not last", has(board.led) ? "LED" : "no LED");
    if(st.me.kind == SAT_KIND_BUTTON_BANK_4)
        printf(", aux 5 V %s", aux_present ? "present" : "absent");
    printf("\n ");
    for(int i = 0; i < n_inputs; i++)
    {
        sat_slot in = inputs[i];
        switch(in.kind)
        {
            case SAT_IN_POT: printf(" pot %5d", sat_pot_position(in)); break;
            case SAT_IN_ENCODER:
                printf(" enc %3d%s x%d", (int8_t)in.d0, (in.d1 & 1) ? " held" : "", in.d1 >> 4);
                break;
            case SAT_IN_BUTTON: printf(" %s x%d", (in.d0 & 1) ? "held" : "up", in.d1); break;
            case SAT_IN_FAULT: printf(" fault %d/%d", in.d0, in.d1); break;
            default: printf(" kind 0x%02x", in.kind); break;
        }
    }
    printf("\n");
}
#endif

static void led_update(uint32_t ticks)
{
    if(!has(board.led))
        return;
    uint8_t level = led_level, m = led_mode;
    if(now_ms < identify_until_ms)
    {
        level = 255;
        m     = SAT_LED_FAST_BLINK;
    }
    bool gate = m == SAT_LED_SLOW_BLINK   ? (now_ms % 1000) < 500
                : m == SAT_LED_FAST_BLINK ? (now_ms % 250) < 125
                                          : true;
    uint8_t phase = (uint8_t)(ticks / (4 * TICKS_US)); // ~1 kHz software PWM
    put(board.led, gate && phase < level);
}

// A frame has gone through: act on what it brought.
static void frame_done(const frame_result* f)
{
    if(f->took && st.me.kind == SAT_KIND_BUTTON_BANK_4)
        lights_take(&lights, f->taken, LIGHTS_N);
    else if(f->took && f->taken[0].kind == SAT_OUT_LED && sat_slot_ok(f->taken[0]))
    {
        led_level = f->taken[0].d0;
        led_mode  = f->taken[0].d1;
    }
    for(uint8_t i = 0; i < f->n_cmds; i++)
    {
        sat_slot c = f->cmds[i];
        if(c.kind == SAT_CMD_CLOSE_RING_HERE)
            forced_last = true;
        else if(c.kind == SAT_CMD_RING_AUTO)
            forced_last = false;
        else if(c.kind == SAT_CMD_RESET)
            reset_pending = true;
        else if(c.kind == SAT_CMD_IDENTIFY)
            identify_until_ms = now_ms + 1000u * c.d1;
    }
}

// Each byte received goes straight into the stream, and what the stream owes goes
// out as fast as the line takes it. Once a frame is in, the bytes still owed are
// worked out one at a time as the transmitter empties (stream_next()), never all
// at once: that took longer than the idle gap, and the next satellite gave up.
void USART1_IRQHandler(void) __attribute__((interrupt));
void USART1_IRQHandler(void)
{
    uint32_t statr = USART1->STATR;
    if(statr & (USART_STATR_RXNE | USART_STATR_ORE))
    {
        uint8_t b = (uint8_t)USART1->DATAR; // after STATR, so an overrun clears too
        uint8_t out;
        last_rx = SysTick->CNT;
        tx_push(&out, stream_rx(&st, b, inputs, &out));
    }
    if((USART1->CTLR1 & USART_CTLR1_TXEIE) && (USART1->STATR & USART_STATR_TXE))
    {
        uint8_t b;
        if(tx_tail != tx_head)
            USART1->DATAR = tx_fifo[tx_tail++ & (TX_LEN - 1)];
        else if(stream_next(&st, &b))
            USART1->DATAR = b;
        else
            USART1->CTLR1 &= ~USART_CTLR1_TXEIE;
    }
    if(stream_done(&st))
    {
        frame_in.took   = st.took;
        frame_in.n_cmds = st.n_cmds;
        for(int i = 0; i < 4; i++)
        {
            frame_in.taken[i] = st.taken[i];
            frame_in.cmds[i]  = st.cmds[i];
        }
        frame_pending = true;
        stream_reset(&st); // ready for the next frame's SOF
    }
}

int main(void)
{
    SystemInit();
    funGpioInitAll();
    adc_init();

    mode(kIdPin, GPIO_CNF_IN_ANALOG);
    mode(kIdFeed, GPIO_CNF_IN_FLOATING);
    sat_kind_io io     = {id_read, id_feed, 0, 1023};
    uint8_t     detail = 0;
    int         kind   = sat_detect_kind(&io, &detail);
    setup_board(kind, detail);
#ifdef SAT_DEBUG
    printf("rodeo-satellite %d.%d: ID resistor read as kind %d (detail %d)\n", FW_MAJOR,
           FW_MINOR, kind, detail);
    uint32_t debug_ms = 0;
#endif

    route(is_last());
    st.me.last = routed_last;
    last_rx    = SysTick->CNT;
    uart_init();

    uint32_t ms_tick = SysTick->CNT;

    for(;;)
    {
        uint32_t t = SysTick->CNT;

        // Two idle byte times end a frame that is still arriving (contract §2.2);
        // one that has all arrived is still being sent on. A finished frame's
        // results come over from the interrupt.
        frame_result f;
        __disable_irq();
        if(st.active && st.rx != st.in_len && SysTick->CNT - last_rx > IDLE_GAP_TICKS)
            stream_reset(&st);
        bool done = frame_pending;
        if(done)
        {
            f             = frame_in;
            frame_pending = false;
        }
        __enable_irq();
        if(done)
            frame_done(&f);
        tap_release();

        if(reset_pending && tx_idle())
            NVIC_SystemReset();

        inputs_poll();
        adc_service();
        if(t - ms_tick >= TICKS_MS)
        {
            ms_tick += TICKS_MS;
            now_ms++;
            every_ms();
#ifdef SAT_DEBUG
            if(now_ms - debug_ms >= 1000 && t - last_rx > 100 * TICKS_MS)
            {
                debug_ms = now_ms;
                debug_status();
            }
#endif
        }
        led_update(t);
    }
}
