dotrodeo/rodeo/(commit log)

2026-07-30 Housekeeping: ignore KiCad cruft, untrack temp/OS/history files
    - Expand .gitignore with KiCad backup, autosave, lock, cache, and temp
    report patterns (plus .DS_Store and .history/)
    - Untrack .DS_Store and kicad/.history (embedded repo) — already ignored
    but committed before the ignore existed
    - Remove committed temp report kicad/tmpqma3idj7.rpt
2026-07-30 rodeo-001 rev1 — as ordered at JLCPCB
    Design state sent to JLCPCB for rev1 assembly:
    - Repaired schematic hierarchy (root now links all sub-sheets)
    - LDO thermal pad tied to GND
    - USB-C data lines to Daisy USB with USBLC6-2SC6 ESD + VBUS clamp,
    single-layer differential routing
    - AINCOM/REFCOM grounded on both ADCs
    - MIDI-OUT series resistors changed to 150R
    - USB_ID no-connect; net/label cleanup
    - Regenerated gerbers, BOM, and CPL
    [BOM-rodeo-001.csv, daisy_seed.kicad_sch, digital_io.kicad_sch, jst_connectors.kicad_sch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]
2026-07-30 firmware M0: boots and produces audio
    Greenfield firmware bring-up on the Daisy Seed 3.
    - Add libDaisy (v8.1.0) + DaisySP (v1.0.0) as pinned submodules
    - Daisy project Makefile (+ gitignored config.mk for the ARM GNU Toolchain
    GCC_PATH, since Homebrew arm-none-eabi-gcc lacks newlib on macOS)
    - src/main.cpp: init 48kHz/block-32, FPU flush-to-zero, 220Hz sine to J5,
    blink onboard + carrier status LEDs
    - src/platform/board.h: host-safe verified pin map + control-surface constants
    - src/platform/system.*: EnableFlushToZero() (FTZ for RT determinism)
    - Host-native unit test scaffold (make host-test) pinning board invariants
    - README with toolchain/build/flash notes
    Builds clean: build/rodeo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
2026-07-31 firmware M1: one MIDI voice
    MIDI IN -> lock-free note-event queue -> single Osc1+Osc2 -> ladder
    filter -> amp voice, played monophonically (last-note priority).
    Control/audio plane split established:
    - midi/midi_engine: libDaisy UART MIDI on USART1 (default pins = board
    MIDI), Note On/Off -> NoteEvents, omni, runs in main loop
    - util/spsc_queue: lock-free SPSC ring buffer (the control->audio crossing)
    - engine/note_stack: last-note-priority mono stack (pure, host-tested)
    - engine/voice: 2 osc (polyBLEP saw) -> LadderFilter LP24 -> amp VCA,
    per-voice amp + filter ADSR, exponential env-swept cutoff, mtof tuning
    - engine/synth: drains queue at block boundary, renders one voice; note
    stat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
2026-08-01 firmware M2: 12-voice polyphony
    Replace the M1 mono voice with a 12-voice polyphonic engine.
    - engine/voice_alloc: pure FIFO allocation + FIFO (oldest) stealing policy,
    with same-note retrigger and free-before-steal (host-tested, golden seq)
    - engine/voice_manager: owns 12 Voices + bookkeeping, drives the policy
    - engine/synth: 12-voice render summed through a tanh soft-clip master bus
    (interim; full gain-staging is M8)
    - engine/voice: swept cutoff powf(2,x) -> exp2f (cheaper x12 voices)
    - main: libDaisy CpuLoadMeter around the callback + onboard-USB serial
    telemetry (voices, avg/max CPU) to verify the no-glitch budget
    - host test test_voice_alloc
    Builds clean: FLASH 75.2%/128KB, SRA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
    [main.cpp, synth.cpp, synth.h]
2026-08-14 firmware: repurpose as ecosystem boilerplate + PCB bring-up examples
    Clear the 12-voice synth app (preserved on tag archive/synth-m2) and
    restructure firmware/ into a reusable base plus standalone bring-up tests:
    - common/board.h — pin map, moved from src/platform/ (single source of truth)
    - common/rodeo.mk — shared build rules; each app/example includes it
    - template/ — copy-to-start skeleton (blinks LEDs)
    - examples/01_blink, 02_audio_tone, 03_midi_mono_sine, 04_adc_1ch
    - top-level Makefile: `make deps`, `make all`, `make clean`
    - README rewritten around the boilerplate + examples workflow
    All four examples and the template build clean against the vendored
    libDaisy/DaisySP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
2026-08-14 firmware(04_adc_1ch): use external 3.3V ADC reference
    The board drives an external reference on the ADS114S08 (REFP0=+3V3,
    REFN0=GND) for a 3.3V ratiometric span shared with the pot supply,
    confirmed pin-by-pin with hardware. The first draft used the chip's
    internal 2.5V reference, which capped usable range at 2.5V and read
    absolute mV ~32% low.
    - REG_REF 0x0A -> 0x30: REFSEL=00 (external REFP0/REFN0), REFCON=00
    (internal ref off), nREFP_BUF=1 / nREFN_BUF=1 (both reference buffers
    bypassed -- REFP0 sits at AVDD and REFN0 at AVSS, on the supply rails,
    outside the buffers' common-mode input range)
    - kVref 2.5f -> 3.3f so the code->mV scaling matches the real span
    SPI path already bench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
2026-08-14 firmware(docs): ADC abstraction library design
    Plan for turning the verified 04_adc_1ch bring-up into a reusable, non-
    blocking two-chip ADS114S08 driver that presents the control surface as 24
    cached channels.
    - two layers: Ads114s08 (per-chip transport + presence check) and RodeoAdc
    (pipelined round-robin scanner); channel->logical-control mapping stays out
    - scan timing pinned to SBAS815A: low-latency FIR (default) = single-cycle
    settle, zero discards; INPMUX write auto-restarts filter; f_MOD fixed 256kHz
    - two chips convert in parallel -> 24-ch scan = two parallel 12-ch scans;
    ~72 Hz/ch at 1000 SPS (V1 target), config-driven populated-channel list
    - front-end (w/ Bumble): PGA bypa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
2026-08-14 firmware(adc): fold ADC-lib design review feedback (Bumble)
    Design-doc + board.h updates from the hardware review of the ADC library plan:
    - pin the physical channel-index convention as a contract:
    ch = chip*12 + AINindex; U3=chip A ch0..11 (J6..J17), U4=chip B ch12..23
    (J18..J29), monotonic/KiCad-verified. board.h + RodeoAdc reference
    RODEO_CONTROL_MAP.md as the source of truth for channel->connector->function.
    - signedness fix (real pot-off glitch): ReadData() returns int16_t; at the
    fully-off ~0V position offset+noise+leakage dip the code a few counts
    negative, and a raw cast to uint16_t reads ~full-scale -> knob OFF shows
    control FULL. Clamp negatives to 0 in every accessor.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
    [board.h]
2026-08-15 firmware(adc): Layer 1 Ads114s08 device driver
    Extract the ADS114S08 SPI/command/register plumbing from 04_adc_1ch into a
    reusable per-chip driver (common/ads114s08.{h,cpp}), per the ADC library
    design doc.
    - rodeo::Ads114s08: owns a CS line + a reference to a shared SpiHandle; one
    instance per chip. Reset/Start/Stop, WriteReg/ReadReg, SelectChannel (WREG
    INPMUX single-ended AINx vs AINCOM, auto-restarts the filter), ReadData
    (signed 16-bit).
    - Board defaults baked in and applied at Init: REF=0x30 (external 3.3V ref,
    buffers bypassed), PGA=0x00 (bypass/rail-to-rail), DATARATE=0x1B (low-latency
    filter, 1000 SPS). DefaultSpiConfig() builds the shared mode-1/soft-NSS SPI1
    config (S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
    [ads114s08.cpp, ads114s08.h, main.cpp]
2026-08-15 firmware(adc): Layer 2 RodeoAdc two-chip scanner
    Add rodeo::RodeoAdc (common/rodeo_adc.{h,cpp}) — the control-surface scanner
    over both ADS114S08 chips, per the ADC library design doc.
    - owns the shared SpiHandle + two Ads114s08 drivers (U3=chip A/D25,
    U4=chip B/D26); channel index ch = chip*12 + AIN (board.h convention).
    - non-blocking pipelined round-robin: each settle window selects + reads one
    channel on EACH chip (the two converters run in parallel; the bus only
    serializes the pokes), so 24 ch = two parallel 12-ch scans, ~72 Hz/ch at
    1000 SPS. Update() returns immediately until the settle window elapses.
    - config-driven populated-channel mask (default all 24) and settle windo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
2026-08-15 firmware(adc): park both CS idle-high before probing (fix U3 presence race)
    RodeoAdc::Init probed each chip sequentially, and each Ads114s08::Init only
    configured its OWN chip-select before running the presence check. So while the
    first chip (U3) was probed, the second chip's CS (D26) was still a floating
    input — the CS nets have no pull-ups. A floating-low D26 selects U4, so both
    chips drive the shared MISO during U3's INPMUX readback -> contention -> U3
    spuriously fails presence while U4 (probed after U3's CS is safely high) passes.
    The first-initialized chip is the deterministic victim; single-chip 04_adc_1ch
    worked only because D26 happened to float high.
    Fix: add Ads114s08::InitCsIdl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
    [ads114s08.cpp, ads114s08.h, rodeo_adc.cpp]
2026-08-15 firmware(examples): human-readable logs + motherboard status LED in every example
    Adds common/status_led.h — a header-only rodeo::StatusLed helper for the
    carrier status LED (Seed pin 28 / seed::D21 / PC4, board::pin::kStatusLed),
    with Set/Toggle and a non-blocking Heartbeat(). Header-only so no example
    Makefile changes are needed.
    Each example now boots a labeled banner, prints readable telemetry, and drives
    the status LED meaningfully:
    - 01_blink: LED via the helper; per-toggle "tick N LED ON/off" log.
    - 02_audio_tone: banner (freq/amp), ~1 Hz heartbeat, per-second uptime tick.
    - 03_midi_mono_sine: LED mirrors the voice gate (lit while a note sounds);
    NoteOn/NoteOff logged with note n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
2026-08-15 docs(adc-lib): note coexistence with other external SPI devices
    Add §2.1 covering how the ADC lib shares (or doesn't) the SPI bus with
    other external SPI devices such as an SSD1309 OLED. Records Bumble's
    board fact that the current fabbed board breaks out only SPI1 (J43, the
    ADC bus), so a dedicated 2nd SPI peripheral is a Rev-B action; lays out
    today's A/B/C options and why sharing SPI1 is the one to avoid.
2026-08-15 docs(adc-lib): record decision A — OLED stays on I2C
    Derek chose path A (2026-08-15): no SPI OLED on the current board, ADC
    keeps SPI1 to itself. Mark the decision at the head of §2.1; keep the
    A/B/C rationale for any future Rev-B SPI display.
2026-08-15 firmware(board.h): bind frozen ch0-23 control map (Path B)
    Add AdcCtrl enum binding each ADS114S08 channel (ch0-23 -> J6-J29) to
    its synth control, per the pot-by-pot table frozen 2026-08-15 with Honey
    (panel L->R order) and Bumble (channel math). Enum values ARE the channel
    index, so they pass directly to RodeoAdc::GetCode/GetVolts/GetNorm.
    ch0/ch3 (OSC1/OSC2 Wave) are 4-pos rotary-switch ladders, not pots.
    Notes what lives off-ADC (digital cycle-buttons, I2C encoder-banks, MIDI)
    and reiterates the AIN6-11 alias guard. RODEO_CONTROL_MAP.md stays the
    source of truth. Builds clean (05_adc_scan, 64.1% flash).
    [board.h]
2026-08-21 firmware(encoder): Daisy master-side encoder-hub driver + friendly API
    Two-layer library mirroring the ADC lib shape:
    - Layer 1 common/encoder_hub.{h,cpp} (rodeo::EncoderHub): one physical
    hub on the bus, owns a shared I2CHandle + 7-bit address, speaks the
    register-pointer protocol from the shared rodeo_hub_regs.h, and
    presence-gates on WHO_AM_I=0x9E + MAP_VERSION (rejects the OLED @ 0x3C).
    - Layer 2 common/rodeo_encoders.{h,cpp} (rodeo::RodeoEncoders): owns I2C1
    (SCL D11 / SDA D12, the OLED+hub Qwiic bus) + up to 4 hubs, enumerates
    0x30-0x33 at boot, non-blocking timed round-robin poll. Friendly cached
    API: GetDelta (read-clear detents), GetPosition (running counter),
    IsPres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
2026-08-21 chore: consolidate rodeo ecosystem into a single git repo
    Re-root the former rodeo-motherboard repo to the ecosystem root so ONE
    repo at /Users/derek/proj/rodeo tracks every board + firmware. All 18
    commits, tags (archive/synth-m2, rev1-ordered), and branches are
    preserved; the motherboard tree moved firmware/... -> rodeo-motherboard/
    firmware/... as 100% renames, so git log --follow and the synth-archive
    restore keep working.
    - Moved .git up to the ecosystem root; re-pathed the libDaisy/DaisySP
    submodules (and their nested submodules) — .gitmodules, gitdir
    pointers, and core.worktree all fixed for the new depth. Both
    submodules resolve clean and stay pinned at the same commits.
    - A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
    [BOM-rodeo-001.csv, BOM-rodeo-button.csv, BOM-rodeo-encoder-hub.csv, BOM-rodeo-encoder.csv, BOM-rodeo-potentiometer.csv, BOM-rodeo-rotary-switch.csv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]
2026-08-21 firmware(06_poly_synth): commit the 6-voice poly synth bench example
    The first "musical" example: MIDI IN drives a 6-voice polyphonic
    subtractive synth (2 detuned PolyBLEP saws -> resonant SVF low-pass ->
    ADSR per voice, last-note-priority stealing). Ten panel pots read
    through the RodeoAdc scanner (U3/U4, masked to the 10 populated
    channels) shape the sound live; the filter env reuses the amp ADSR shape
    scaled by a Filter-Env-Amt pot so the whole synth fits in 10 knobs.
    Predates the encoder-driver + repo-consolidation work; committed now on
    Derek's call so it lives in the ecosystem repo. Builds clean via the
    moved submodule paths (flash 74.5%); not yet run on hardware.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
2026-08-21 chore(repo): relocate hardware docs into rodeo-motherboard; drop dead worktree
    Move RODEO_HUB_I2C_CONTRACT.md (a generic hub<->host wire contract) and
    the verified hardware-map.md out of the rodeo-001 instance tree and the dead
    synth worktree into rodeo-motherboard/docs/, their proper home. Fix the
    now-relative control-map link and kicad path references; retitle the hardware
    map to 'Rodeo Motherboard'. Remove the 2.6 MB dead git worktree
    (.claude/worktrees/rodeo-001-synth-firmware-9ccbf1) that was committed during
    the repo consolidation — it duplicated an older KiCad set + gerber export.
2026-08-21 chore(kicad): rename rodeo-001 project to rodeo-motherboard
    Completes the incomplete rename: the board is the Rodeo *motherboard*, not the
    rodeo-001 synth instance that now consumes it. Renames the four project files
    (kicad_pcb/pro/prl/sch) and rewrites all 280 internal name references — the
    (project ...) instance tags in every schematic + subsheet, the .pcb sheetfile
    paths, and the .pro/.prl self-references. Subsheet filenames (daisy_seed,
    digital_io, jst_connectors, serial_io) are unchanged. Fixes downstream path
    references in firmware/common/board.h and the enclosure/control-map specs.
    NOTE: the jlcpcb/ gerber + production exports still carry rodeo-001 names and
    internal metadata — t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
    [daisy_seed.kicad_sch, digital_io.kicad_sch, jst_connectors.kicad_sch, rodeo-motherboard.kicad_pcb, rodeo-motherboard.kicad_sch, serial_io.kicad_sch]
2026-08-21 docs: add top-level ecosystem README; fix firmware README paths
    New root README orients the consolidated monorepo — what each board dir is,
    where the source-of-truth docs live, and the motherboard-vs-rodeo-001 naming
    distinction. Update firmware README for the relocated hub I2C contract and drop
    the stale 'rodeo-001 board' reference.
2026-08-21 Clean out old production files
    [BOM-rodeo-001.csv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]
2026-08-23 firmware(rodeo-001): stand up 12-voice instrument scaffold
    First rodeo-001 instrument code, built on the rodeo-motherboard boilerplate
    (consume-not-copy: links vendored libDaisy/DaisySP + common/ drivers via
    RODEO_ROOT, no fork).
    Voice v2 = "less-complicated MiniFreak": 12-voice poly, per-osc engines
    (subtractive live; FM + formant stubbed via Option A per-engine Timbre),
    polyphonic SVF (LP/BP/HP/notch), independent Filter ADSR + Amp ADSR, and one
    global LFO with a single selectable destination (no mod matrix).
    - src/control_map.h: rodeo-001 INSTANCE channel->function binding, frozen per
    RODEO_CONTROL_MAP.md 2026-08-23 (22 pots, ch0/ch3 spare; button + hub-slot
    logical maps). Kept out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
    [control_map.h, main.cpp]
2026-08-23 firmware(rodeo-001): bind digital cycle-buttons (DIG_1-6)
    Control map froze the last class: 6 buttons on DIG_1..6 = J30..J35 = Seed pins
    2..7 (the SDMMC digital-only pins), active-low with the STM32 internal pull-up.
    This clears the cycle-button GPIO stub.
    - common/board.h: add the generic DIG_1..12 -> Seed-pin map (a motherboard
    hardware fact that was missing; kNumDigitalIo=12 had no pin list). DIG_1..6 =
    SDMMC pins (buttons), DIG_7..12 = ADC-capable pins (Seed A0..A5, kept spare).
    Additive only; verified 1:1 against libDaisy's seed::Dxx port table.
    - control_map.h: Button enum bound to DIG_1..6 in signal-flow order
    (HardSync, FilterType, Keytrack, LfoShape, LfoDest, VoiceMode) + k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
    [board.h, control_map.h, main.cpp]
2026-08-23 docs(rodeo-001): freeze control map + enclosure for MiniFreak-lite voice
    Control map: Option A (per-osc Shape -> model-dependent Timbre), OSC
    section resolved semantics-only (22/24, no channel remap), frozen
    digital-button table DIG_1-6 / J30-J35 / Seed pins 2-7.
    Enclosure: voice v1 update, Timbre relabel, mod-set panel-fit confirmation.
2026-08-23 firmware(rodeo-001): Option A flat osc model list (waveforms + engines)
    Wave-encoder now steps one flat model list per osc — Saw/Pulse/Triangle/
    Sine/FM/Formant — instead of only Subtractive/FM/Formant. The four classic
    subtractive waveforms are live via ApplyModel() (sets waveform + morphs the
    Timbre pot's per-model meaning: PW on Pulse, subtle/no-op on Saw/Tri/Sine).
    FM/Formant slots fall back to a base waveform until those engines are built.
    Live model cycling still waits on the encoder-hub read (parts ~1 week out);
    g_model1/g_model2 default to kSaw. Builds clean STM32H750, FLASH 75.6%.
2026-08-24 firmware(common): host unit-test scaffold + ADC value-pipeline tests
    Add a host-side GoogleTest harness under common/tests/ that compiles pure
    driver logic for the Mac (clang++, no ARM, no board) and runs in ms. Reuses
    the googletest already vendored in libDaisy/tests — no new dependency.
    Extract the ADC value pipeline (clamp / code->volts / code->norm) into a
    dependency-free common/adc_convert.h and have RodeoAdc::GetCode/GetVolts/
    GetNorm delegate to it, so the tests guard the real firmware path (one source
    of truth, no drift). First tests cover the negative-tail clamp glitch guard
    (a fully-off pot must not wrap to full-scale) plus the volts/norm math.
    Host: 8/8 pass. Target: ARM build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
    [adc_convert.h, adc_convert_gtest.cpp, gtest_all.cpp, rodeo_adc.cpp]
2026-09-12 firmware(encoder-hub): correct SWD header pin order, fix flash flags
    First bring-up on real hardware. Three things were wrong or missing:
    - The docs described J12 as NRST/SWCLK/SWDIO/VDD/GND, which is the exact
    reverse of the board. Actual order is GND/VDD/SWDIO/SWCLK/NRST with pin 1
    as the square pad, and there are no silkscreen labels to catch the error.
    Counting from the wrong end puts 3V3 on SWCLK and leaves VDD floating, so
    the target never answers and it looks identical to bad pogo contact —
    SWDIO is dead centre and lands correctly either way, so it gives nothing
    away. Wiring table is now in header order with the square-pad cue, plus
    the 1.27 mm pitch and the fact that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
2026-09-13 firmware(motherboard): ADC pipeline, pot UI, bulk OLED transport, hub scan
    Snapshot of the in-progress motherboard firmware work.
    - ADC value pipeline: adc_convert.h plus rodeo_adc hooks, wired into
    05_adc_scan and 06_poly_synth, with the design doc brought up to date.
    - pot_ui.h and its gtest coverage (pot_ui, pot_span), alongside a
    svf_stability test; host test Makefile/README updated to build them.
    - Bulk SSD130x I2C transport: one transaction per 128-byte page instead of
    libDaisy's one-per-byte, with a yield hook so the hub poll keeps running
    between pages.
    - 07_encoder_scan grows an OLED readout so the hub bring-up needs no serial
    monitor, and gains the pass-through triage ba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
2026-09-13 firmware(encoder-hub): fix I2C target speculative-read corruption
    First hardware bring-up. Encoder telemetry came back shifted one byte per
    burst, a phantom +1 stuck on E1, taps silently swallowed, and press events
    attributed to the wrong encoder. One root cause, two halves.
    TXIS fires whenever TXDR empties into the shift register, including for the
    final byte of a burst -- the one the master NACKs. So the ISR always serves
    one byte MORE than the master receives, and that byte is stranded in TXDR.
    1. The stranded byte was never flushed, so it led off the NEXT burst and
    shifted the whole stream by one. The STOP handler did try to flush, but
    gated it on `if (IsActiveFlag_TXE)` -- TXE r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
    [hub.c, hub.h, i2c_target.c]
2026-09-13 docs(encoder-hub): mark firmware validated on hardware
    First bring-up on a fabbed board. All five hardware-specific assumptions the
    Status section listed as open are now settled: AF6 on PB6/PB7, EC11 4
    steps/detent, jumper polarity, CW = positive, and TIMINGR working at 100 kHz.
    TIMINGR is marked confirmed by BEHAVIOUR, not by scope -- setup/hold has still
    not been looked at on a logic analyzer, and the 400 kHz value still has to be
    generated before the contract's 100 k -> 400 k promotion.
    Also records two bring-up gotchas that are invisible in the code:
    - Every JST cable in the ecosystem is straight-through, pin 1 -> pin 1, for
    the Qwiic ports AND the encoder ports. A crossover is alway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
2026-09-14 docs: harness cable orientation, fix contract paths, correct reset diagnosis
    Harness: the ecosystem has no single JST pin-1 convention. Verified pad-by-pad
    from every board's .kicad_pcb:
    analog mobo J6-J29 +3V3/sig/GND vs pot/rotary GND/sig/supply-in REVERSED
    digital mobo J30-J41 DIG/GND vs button sig/GND straight
    I2C mobo J42 GND/3V3/SDA/SCL vs hub J1/J2 same straight
    encoder hub J3-J11 A/B/S/GND vs encoder J1 same straight
    A straight cable on an analog run swaps the satellite's supply and ground:
    nothing is damaged (all passive) but every pot reads backwards and the
    rotary-switch ladder inverts. Add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
    [encoder_hub.h, main.cpp, rodeo_hub_regs.h]
2026-09-14 rodeo-001: move hard-sync to OSC2 Octave press, remove master tune
    Removes two physical inputs: 37 -> 35 controls (22 pots + 7 encoders +
    5 buttons + 1 OLED).
    - OSC2 hard-sync is no longer a button. It is now a press on the OSC2
    Octave encoder (hub slot 6), silkscreened PUSH: SYNC so it stays within
    the no-hidden-controls rule. Octave was chosen over Detune because it is
    turned deliberately, making an accidental press mid-turn unlikely.
    - Master tune (hub slot 4) is removed; the pitch reference is fixed.
    Both freed positions are left as gaps rather than re-packed: DIG_1 / J30
    and hub slot 4 are SPARE, so every other button and encoder keeps its pin,
    slot, and harness wiring.
    Docs: c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
    [control_map.h, main.cpp]
2026-09-17 Add 3D render of motherboard
    [rodeo-motherboard.step]
2026-09-21 rodeo-002: concept + draft control map
    Second instrument instance: multi-engine macro-oscillator polysynth into a
    Chroma-Console-style four-slot texture chain ending in a granular delay.
    Constraints set by Derek 2026-09-20: 16 pots, 5 encoders, OLED, no buttons;
    MIDI-keyboard only; 64 MB SDRAM Seed; presets required; 8 voices targeted.
    Unlike rodeo-001, a single shift layer (held MAIN encoder) is accepted.
    Control map is DRAFT — channel/slot assignments are proposed, not frozen, and
    the engine list is gated on an on-board CPU benchmark still to be written.
2026-09-21 rodeo-002: voice + texture-chain CPU benchmark
    Replaces the concept doc's estimated voice count with a measurement. Sweeps 12
    candidate engines x rising voice counts, twice (chain bypassed, then chain on),
    reporting CpuLoadMeter avg/max as CSV plus a max-voices summary.
    The texture chain's granular delay is implemented for real -- 4 s stereo SDRAM
    buffer, up to 12 overlapping windowed grains with independent playback rates,
    freeze and feedback -- since its cost is the open question. The other three
    slots implement one representative (most expensive) effect each.
    Builds clean; 89% of internal flash with all 12 engines linked in, 136 KB SRAM
    at 16 voices, 1.5 MB SDRAM. Not yet run on hardwar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
    [engines.h, main.cpp, texture_chain.h]
2026-09-21 bench_voices: survive a step that can't run in real time
    First hardware run froze at step 24 with the chord sustaining. Cause: an
    overrunning audio callback starves every lower-priority interrupt, SysTick
    included, so HAL_GetTick() stops advancing -- System::GetNow() and
    System::Delay() never return, and the sweep's measurement loop hangs forever
    while the DMA keeps playing. The harness was timing itself with the one clock
    that an overloaded board cannot keep running.
    Now the audio callback is the clock (48 samples @ 48 kHz = 1 ms per block) and
    it polices itself: 16 consecutive over-budget blocks drops all voices, which
    frees the CPU and unwedges the main thread. The step is logged OVER an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
2026-09-21 rodeo-002: fold measured CPU numbers into the concept
    bench_voices run on hardware. Headline: the texture chain costs a flat 12.9%
    including the granular delay at worst case (12 grains, dense, shimmer, 4 s
    SDRAM buffer) -- SDRAM latency is a non-issue and the instrument's signature
    feature is affordable. Per-voice cost is linear, so load = 12.9% + voices*cost.
    8 voices confirmed for 7 of 12 engines; the two VA engines reach 16. Sets the
    architecture at 8 and redirects the leftover headroom toward a richer voice
    rather than more of them.
    Open: Modal/String/Karplus miss the 6-voice minimum (Modal is monophonic at
    46%/voice) and need a call -- drop, restrict to Mono/Unison, or optimise.
    Wavet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
2026-09-21 rodeo-002: physical models become mono-only engines
    Derek's call (option 2): keep Modal, String and Karplus despite missing the
    6-voice minimum, restricted to the Mono and Unison voice modes -- they are
    struck/plucked models that suit monophonic playing anyway.
    Each engine now declares its supported voice modes. Selecting a mono-only
    engine from Poly switches to Mono and says so on the OLED, restoring the
    previous mode when a polyphonic engine is chosen again. The engine list is
    never filtered: every engine stays reachable in the same order, and the
    instrument explains the change instead of hiding the option.
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2026-09-21 rodeo-002: control map follows the real panel layout
    Derek's panel puts the four slot encoders in a COLUMN beside the pot rows, not
    a row under the screen as the draft assumed. Physical adjacency implies meaning,
    so the mapping now follows the geometry: pot column 4 carries the four slot
    amounts, and each row is one texture slot -- amount pot beside the encoder that
    picks its type, top to bottom in signal order. Columns 1-3 are the synth; the
    isolated fifth encoder under the OLED is MAIN (shift/engine/presets/voice mode).
    This also drops the "which slot is focused" mode the old mapping would have
    needed to fit four slot types onto one encoder.
    LFO destination lands on a stepped shift pot ra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
2026-09-21 rodeo-002: lock panel layout; defer Wavetable/Chord; fix MAIN press conflict
    Derek locked the panel layout, grid, pitch and channel/slot map. Wavetable and
    Chord are deferred, so the shipping engine list is the twelve measured. The
    motherboard and encoder hub mount to the 3D-printed case, not the panel.
    Also fixes a conflict in the draft: MAIN's hold is both shift and a long-press,
    so holding shift past 600 ms while reaching for a pot would have fired the
    long-press action. MAIN's press now resolves on release, and only when nothing
    else was touched during the hold; any other control moving makes it a shift.
2026-09-21 rodeo-002: add the gesture recorder
    Derek approved the gesture recorder (Chroma Console-style pot-motion looping) on
    MAIN's long-press, saved with presets.
    MAIN long-press now arms / closes the loop / clears; Save moves into the preset
    browser (long-press on the highlighted slot), where a slot is already being
    chosen. The loop end is trimmed to the press-DOWN timestamp, since a long-press
    resolves >= 600 ms later and would otherwise make every loop end late. Pots only
    (both layers) -- looping encoder enum jumps would read as a fault. Grabbing a
    looped pot takes that parameter back; loop stop/clear re-arms pickup.
    Presets carry their gesture and start looping on load; clearing only affects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
2026-09-21 rodeo-002: review pass — fix stale text, gesture rate, list in README
    Mechanical corrections from a review pass, no design changes:
    - Gesture sampling was stated as 100 Hz, but pots are only read at ~72 Hz per
    channel (1000 SPS; U3 carries 12 of the 16 pots and sets the pace). Now
    "sampled at the pot scan rate"; storage figures recomputed (~37 KB per full
    gesture, ~2.4 MB for 64 presets).
    - Concept doc still called the panel "not started" with a row of encoders --
    it is locked, with a column. Engine list is no longer a candidate list, and
    Poly's 8-voice cap is stated next to the table.
    - Root README listed rodeo-001 but not rodeo-002.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
2026-09-21 rodeo-002: apply review-pass decisions
    Derek's calls on the review findings, 2026-09-21:
    - Firmware runs under the Daisy bootloader (BOOT_SRAM): the 128 KB internal
    flash is already 90% full with the benchmark alone. One-time bootloader
    install; updates then need no BOOT button. Bench to be re-run in that mode.
    - MIDI channel and master volume are global, never in a preset; master volume
    never waits for pickup. Settings split into Patch and Global pages.
    - One shared ADSR drives amp, filter, Timbre and Morph via their amounts --
    what the panel's four envelope controls imply.
    - MIDI performance mapping: velocity -> amp (+ per-patch filter amount), bend
    +/-2 default, mod wheel adds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
2026-09-21 bench_voices: build under BOOT_SRAM; record the DTCM budget
    Checking the BOOT_SRAM decision against the real linker script turned up a
    constraint the docs didn't have: under the Daisy bootloader, zero-initialised
    globals go to the 128 KB DTCM (shared with the stack), not the 480 KB AXI
    SRAM the code runs from. The benchmark's 16 voices overflowed it by ~5 KB and
    failed to link.
    The bench now sweeps to 12 voices when built with BOOT_APP (87% of DTCM), which
    is enough to confirm the numbers carry over. The concept doc records DTCM as
    the real budget: 8 voices fit, but large buffers -- the live gesture buffer and
    preset staging -- must be placed in SDRAM explicitly. README notes that a
    BOOT_NO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
    [main.cpp]
2026-09-21 bench_voices: default to BOOT_SRAM; refuse mismatched flashes
    On hardware, `make APP_TYPE=BOOT_SRAM` followed by a plain `make program-dfu`
    wrote an SRAM-linked image to 0x08000000, overwriting the Daisy bootloader;
    the board then crashed silently at boot. dfu-util reported success because the
    bootloader and the ST ROM DFU share USB ID 0483:df11, so nothing flagged it.
    The README invited it by showing a plain program-dfu above the bootloader one.
    APP_TYPE sets both the link map and the flash address, so they must agree:
    - The Makefile now defaults to BOOT_SRAM, so plain make/program-dfu agree.
    - Changing APP_TYPE wipes the build (make otherwise keeps the image linked for
    the other memory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
    [main.cpp]
2026-09-21 rodeo-002: flash via the bootloader's indefinite-wait mode, not a race
    Racing the Daisy bootloader's 2.5 s grace period fails even when you're in
    time: dfu-util found the device and lost it mid-claim (LIBUSB_ERROR_NO_DEVICE)
    as the window closed. Per libDaisy's bootloader doc, tapping BOOT while the LED
    pulses extends the grace period indefinitely. Docs now use that.
    [main.cpp]
2026-09-21 rodeo-002: benchmark re-run under the bootloader — numbers hold
    BOOT_SRAM sweep on hardware, 2026-09-21: across 125 paired points, load is
    1.4 points lower on average (-3%; range -5.6 to +1.6), chain unchanged at
    12.9%. Gains concentrate in the engines with the most per-voice state, in line
    with voice state living in zero-wait-state DTCM in this mode. No engine changes
    voice class. FM/Harmonic/Grainlet at 8 voices drop to 63.5-64.7%, leaving ~5
    points for the finished voice. Log kept alongside the first run.
2026-09-21 rodeo-002: texture-chain effect types
    Design session with Derek, 2026-09-21. Five types per slot, fixed chain order
    Character -> Movement -> Texture -> Space:
    Character: Warm / Drive / Fuzz / Fold / Rectify
    Movement: Chorus / Vibrato / Phaser / Flanger / Tremolo
    Texture: Crush / Downsample / Tape / Dust / Squash
    Space: Echo / Cloud / Reverse / Wash / Reverb
    Each slot's secondary means one thing across all its types -- Bias / Rate /
    Tone / Damp -- so the locked panel's shift labels can be silkscreened rather
    than explained by the OLED. Discrete options (shift + encoder) may vary per
    type since they are on screen.
    Reverb is DaisySP-LGPL's ReverbSc: the firmware will always be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
2026-09-21 rodeo-002: Character slot + host test harness
    First of the four texture-chain slots, written as the real effect code the
    instrument will use (rodeo-002/firmware/common), not benchmark throwaways.
    - dsp_util.h: header-only, host-compilable helpers -- smoother, one-pole,
    DC blocker, Padé tanh, parabolic sine, xorshift RNG, and the two-phase LFO
    with the Movement slot's four shapes.
    - fx_character.h: Warm / Drive / Fuzz / Fold / Rectify, amount = Drive (0 is
    transparent), secondary = Bias, option = low cut. Block-processed with the
    type switch outside the sample loop.
    - tests/: GoogleTest on the host against the real vendored DaisySP, mirroring
    the platform's tests. Every type x opt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
2026-09-21 rodeo-002: Movement slot
    Chorus / Vibrato / Phaser / Flanger / Tremolo; amount = Depth (0 is
    transparent), secondary = Rate (0.05-12 Hz), option = LFO shape.
    All five run from the slot's own two-phase LFO, which is what makes the
    LFO-shape option uniform: DaisySP's Chorus/Flanger/Phaser carry fixed internal
    LFOs, so the delay types sit on DaisySP's DelayLine (one shared 1024-sample
    pair, Hermite reads) and the phaser (6 all-pass stages with feedback) and
    tremolo (L/R half a cycle apart, so it pans) are small loops of their own.
    Tests gain an audibility check alongside transparency -- stability alone would
    pass an effect that did nothing. All 180 Movement configurations pass, as do
    Characte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
    [fx_gtest.cpp, fx_movement.h]
2026-09-21 rodeo-002: Texture slot
    Crush / Downsample / Tape / Dust / Squash; amount = Intensity (0 is
    transparent), secondary = Tone (600 Hz-20 kHz after the effect), option per
    type: Crush smooth/stepped, Tape wow/flutter, Dust vinyl/radio, Squash
    soft/hard/pump (Downsample has none; options re-clamp on a type change).
    - Crush/Downsample: DaisySP Decimator (with its default heavy downsampling
    switched off) and SampleRateReducer.
    - Tape: one shared modulated delay per channel -- wow with a random drift, or
    flutter -- plus gentle saturation and hiss.
    - Dust: pops as fast-decaying impulses over a noise bed; Radio also band-limits
    the signal to 300 Hz-3.5 kHz.
    - Squash: stereo-linked compressor; t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
    [fx_gtest.cpp, fx_texture.h]
2026-09-21 rodeo-002: Space slot
    Echo / Cloud / Reverse / Wash / Reverb; amount = Mix (0 is transparent),
    secondary = Damp, plus Time / Feedback / Grain / Pitch / Spread, option = grain
    pitch quantize (free / semitones / fifths+octaves / octaves), Freeze in every
    type. Bypass keeps the tail: input stops, dry returns to unity, wet decays.
    Grain engine: 5.46 s power-of-two buffer per channel (borrowed, SDRAM on the
    Seed), 12 Hann-windowed grains. Wash adds a 4-stage all-pass diffuser; Reverb
    is DaisySP-LGPL's ReverbSc with a pre-delay buffer, and Grain becomes a shimmer
    (pitched grains of the reverb's own output fed back in).
    The host tests caught three instabilities before any reached hardware:
    - Con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
    [fx_gtest.cpp, fx_space.h]
2026-09-21 rodeo-002: texture chain -- click-free switching, output limiter
    Joins the four slots in fixed order, then tilt EQ (+/-6 dB at 700 Hz), master
    volume and a soft limiter.
    - Type changes crossfade: the slot fades out over 10 ms, swaps and resets at
    silence, fades back in. Space fades only its wet (SetWetHold), so the dry
    never dips.
    - Bypass crossfades; a fully bypassed slot is skipped outright (zero CPU).
    Space bypasses with trails and goes idle once its tail has died.
    - Output soft limiter: identity below 0.9, tanh knee to a 1.0 ceiling, and
    OutputPeak() reports the level going in -- for an OLED clip indicator.
    Tests were mutation-checked, not just run:
    - Removing the crossfade mak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
    [fx_gtest.cpp, fx_space.h, texture_chain.h]
2026-09-21 bench_voices: measure every effect type with the real chain
    The benchmark now runs the real texture-chain effects from ../common instead
    of its stand-in chain (removed).
    New first pass (~40 s): with four cheap voices as signal, every slot bypassed
    (zero cost) except the one under test at its heaviest settings, each of the 20
    effect types is costed against an all-bypassed baseline. Then the most
    expensive type per slot runs all at once -- the worst-case chain -- and the
    engine sweep's fx-on pass uses that chain, so its voice counts are real.
    ReverbSc (~396 KB) lives in SDRAM as raw storage and is constructed after
    hw.Init(): a global object with a constructor would be written before the SDR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
2026-09-21 rodeo-002: record the real chain's measured cost
    Hardware FX pass, 2026-09-21: per-type costs for all 20 effect types, and a
    worst-case chain (Warm + Phaser + Tape + Reverb) of 36.8% -- ~3x the stand-in
    chain's 12.9%. Costs add (36.4% summed), so any configuration is predictable
    from the table. Reverb alone is 21.9%. At the 70% ceiling with that chain, FM,
    Harmonic and Grainlet fall to 4 voices, Vosim/Z-osc to 2, Modal to 0.
    Recorded as an open decision. Also corrects the Movement/Texture source columns
    to what was actually built (own code on DaisySP DelayLine; own Dust/Squash).
2026-09-21 rodeo-002: bench_space -- profile where Space's CPU goes
    The FX pass found Space is most of the chain's cost (Reverb 21.9%, Cloud 13.9,
    Wash 13.6, Echo 10.1) but not WHICH part, and each answer points at a
    different fix. bench_space runs ~20 short cases (~40 s) that isolate them:
    - ReverbSc alone (a bare instance, no chain) vs Reverb with no shimmer, with
    pre-delay at both ends, with half and full shimmer, and frozen;
    - the grain engine at three grain settings per type, reporting the average
    number of grains playing -> a cost per grain;
    - Space at mix 0 (does it cost the same when nobody can hear it?);
    - bypassed-idle Space, as a sanity check against the baseline.
    Supporting changes:
    -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
    [engines.h, fx_space.h, main.cpp]
2026-09-22 bench_space: measure load from raw ticks, not CpuLoadMeter
    First hardware run reported 0.0% for every case while the grain counts came
    out right -- so the program ran and processed audio, and only the load figures
    were wrong. CpuLoadMeter computes ticks * ticksPerBlockInv_, and an infinite
    factor (tick frequency reading zero at Init) prints as 0 through an int cast,
    which fits what we saw.
    The profiler now measures load itself -- ticks spent inside the callback over
    ticks available -- and prints the tick frequency plus CpuLoadMeter's number
    alongside, so the next run says which to believe. Case labels with commas also
    renamed; they were splitting the CSV columns.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
    [main.cpp]
2026-09-22 rodeo-002: optimise the grain engine; trust raw ticks over CpuLoadMeter
    Space profile on hardware (log kept): each grain cost ~2.5% CPU -- about 250
    cycles per grain per sample for two interpolated reads and a window lookup,
    which should be nearer 25. SDRAM is cacheable and the D-cache is on, so the
    cost was arithmetic, not memory:
    - grain position is now 18.14 FIXED POINT (the buffer is 1<<18, so the counter
    wraps exactly on its own), removing a floorf and two float->int conversions
    per channel per sample;
    - the window phase advances by a per-grain increment instead of dividing
    age/len every sample;
    - live grains are packed at the front of the array, so idle slots cost nothing
    (the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
    [fx_space.h, main.cpp]
2026-09-22 rodeo-002: record post-optimisation chain costs
    Re-measured on hardware after the grain-engine rewrite: Echo 10.1->7.8 (-23%),
    Cloud 13.9->11.0, Reverse 6.5->5.3, Wash 13.6->11.7, Reverb 21.9->20.6, worst
    chain 36.8->35.4. Other slots unchanged within noise; voice counts barely move
    (Formant now 8 against the worst chain).
    Reverb stays expensive because ReverbSc is 11.6 of its 20.6 -- a lighter
    in-house reverb is the one remaining optimisation of any size, and is not done.
    Also records that raw ticks and CpuLoadMeter agree in bench_voices (within 0.2),
    so the earlier voice numbers stand, and notes that a light chain (~16%) leaves
    FM at 8 voices.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
2026-09-22 rodeo-002: drop Modal; add the measured cost model and voice cap
    Derek, 2026-09-22: drop Modal entirely rather than design around it (46% CPU
    for one voice; it could not run beside an expensive Space type). Eleven engines
    remain and every one fits beside every Space type, so there is no unplayable
    combination left to rule on. The DSP stays in DaisySP if it is ever worth
    optimising back in.
    common/cost_model.h turns the hardware measurements into the approved
    polyphony cap: load = fixed + voices x engine cost + active slot costs, with
    per-voice costs from a least-squares fit over the voice sweep (every engine is
    linear, intercept < 0.3%) and per-type costs from the FX pass. MaxVoices()
    never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
    [cost_model.h, cost_model_gtest.cpp, engines.h]
2026-09-22 rodeo-002: first playable build -- MIDI, voices, chain, audio out
    synth/ is the instrument: MIDI IN -> VoiceManager -> TextureChain -> line out.
    - common/patch.h: everything the panel sets, in control-map order, plus the
    globals a preset must NOT carry (MIDI channel, master volume).
    - common/voice.h: engine -> Svf -> amp with one ADSR and one global LFO;
    poly/mono/unison, last-note priority with a note stack, sustain pedal, glide,
    velocity and keytrack to the filter, bend/mod wheel/aftertouch. Polyphony
    comes from CostModel, so it falls when an expensive engine or Space type is
    chosen. The platform's Svf rule (source at +/-1, SetDrive(0.5)) is applied and
    pinned by a test across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
2026-09-22 rodeo-002: firmware README tidy-up
    Fixes a mangled table row, points the flashing example at any app, and drops
    the stale claim that bench_voices reads CpuLoadMeter (it measures raw ticks and
    prints the meter alongside).
2026-09-23 rodeo-002: the panel -- pots, encoders and the OLED
    common/ui.h is the panel's rules as pure logic (no hardware), so they are
    testable: pickup on both layers, shift as MAIN held, encoder turns/taps/
    long-presses, the stepped enum pots, and a DisplayState for the screen. The
    synth app feeds it pot readings and encoder deltas and draws the result.
    Two bugs the host tests caught before any of it reached hardware:
    - a pot resting at its stored value counted as "touched" every pass, so it
    stole the readout and wiped the pickup hint;
    - moving a pot while holding shift did not count as touching anything, so the
    shift still resolved as MAIN's long-press -- exactly what that rule exists to
    pre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
    [main.cpp, ui.h, ui_gtest.cpp]
2026-09-23 rodeo-002: harness build sheet
    The frozen channel map as a wiring checklist -- panel position to connector for
    the 16 pots and 5 encoders, cable types (pots reversed, encoders and I2C
    straight) and what the wrong one does, plus a bring-up sequence that reads the
    screen to confirm each run.
    Verified against the firmware that reads the map (kPotChannel, kEncoderSlot),
    not just against the control map.
2026-09-23 synth: dump the panel's raw readings for bring-up
    Adds a serial dump every 2 s: each pot's TRUE measured voltage (never
    span-corrected, so it cannot hide a calibration fault) beside its normalised
    control value, labelled by connector in panel order, plus encoder positions and
    press state.
    This is what separates a wiring fault from a firmware one: if volts reaches
    0.00 but norm does not, the span calibration is at fault; if neither does, the
    signal is not getting there.
    [main.cpp]
2026-09-23 synth: fix the connector labels in the panel dump
    The dump printed rows 3-4 as J24-J31; those channels are J18-J25. The
    channel-to-connector rule is uniform across both ADC chips -- J(6+ch) -- and the
    readings were always right, but the labels would have sent someone to the wrong
    connector while tracing.
    [main.cpp]
2026-09-23 rodeo-002: handle straight-built pot cables in software; widen the encoder dump
    Panel bring-up found pots reading 0.30-3.30 V backwards instead of 0.00-3.00 V:
    supply and ground swapped, i.e. straight cables where the analog runs need
    reversed ones. Nothing is harmed (the satellites are passive) and rebuilding 16
    cables is a worse trade, so common/panel_pot.h conditions them here.
    Orientation is DETECTED, not configured: a correct satellite feeds the pot
    through a 1k resistor and so cannot read above ~3.05 V even for a +20% pot, so
    anything above 3.15 V is necessarily reversed. Each channel also learns its own
    travel from the true measured voltage, which is what lets both orientations
    reach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
    [main.cpp, panel_pot.h, panel_pot_gtest.cpp]
2026-09-23 rodeo-002: rescale supply-swapped pots without flipping their direction
    My previous commit conflated two independent things and made every knob on the
    panel run backwards on hardware.
    Swapping supply and ground changes the RANGE a satellite produces -- 0.30..3.30 V
    instead of 0.00..3.00 V, since the same 1k divider now runs from the other end.
    It does NOT change which way the pot reads: that depends on the pot's pin
    orientation, and on this panel it comes out correct either way. So the fix is to
    rescale and leave direction alone.
    Detection is unchanged and still physical (a correct satellite cannot exceed
    ~3.05 V), but a detected channel now RE-SEEDS its travel to that wiring's
    nominal ran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
    [main.cpp, panel_pot.h, panel_pot_gtest.cpp]
2026-09-23 rodeo-002: how to tell a straight JST cable from a reversed one
    The encoder runs need 1:1 cables (hub J3 and satellite J1 are both A/B/S/GND on
    pins 1-4) and the panel's were built reversed, which is why no slot counts.
    Adds the meter check, a colour-order diagram that fixes how to hold each end,
    and the same-face/opposite-face way the cables are sold.
2026-09-23 rodeo-002: correct the harness note on straight-built pot cables
    The sheet still said a straight-built analog run reads backwards. Measured on
    the panel, it does not: supply and ground swap changes the range (0.30-3.30 V)
    but not the direction, and the firmware detects and rescales it. Direction
    depends on the pot's pin orientation, not the cable.
2026-09-23 synth: one bus, one speed -- the encoders' actual problem
    The encoder cables are straight, which is what the runs need, so the wiring was
    never the fault. The platform's own example documents what is: RodeoEncoders
    and the OLED transport each own an I2CHandle, but libDaisy keeps one impl per
    peripheral, so both drive I2C1 and THE LAST Init() WINS on speed. This file set
    the encoder driver's speed and never the display's, so the OLED's default
    (400 kHz) silently reconfigured the bus after the hub had been probed at the
    contract's 100 kHz boot speed -- and the hub stopped answering, which reads as
    "no encoder ever moves".
    Both are now set from one constant at 100 kHz, and the transport's peri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
    [main.cpp]
2026-09-23 synth: read the hub's own registers during bring-up
    Encoders still report nothing while the hub answers its identity probe, so the
    question is whether the hub sees its encoders at all. RodeoEncoders keeps its
    hubs private, so this opens a second, diagnostic view of hub 0 on the same bus
    and prints what the hub itself says: firmware version, CAPABILITIES (does it
    claim encoders and switches?), STATUS, ENC_COUNT, and the live SW_STATE levels.
    SW_STATE is the useful one -- a live level, not read-to-clear -- so pressing an
    encoder either moves it or it does not, which splits 'the hub cannot see the
    encoder' from 'our scanner is not reporting it'.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
2026-09-23 synth: report the hub diagnostic's own failures instead of hiding them
    The hub dump was gated on its probe succeeding, so when the probe failed the
    whole block vanished and the log said nothing at all -- which is how a press
    test produced no data. ReadReg does not depend on the probe, so the dump now
    runs either way and prints whether each read was ACKed, plus the probe and I2C
    init results at startup.
    [main.cpp]
2026-09-23 synth: stamp the build date/time in the startup banner
    A flash that silently did not take is indistinguishable from a firmware bug in
    the serial log -- which is what happened during panel bring-up: two rounds of
    hub diagnostics produced no output because the board was still running an
    earlier build. The banner now carries __DATE__/__TIME__ so the log says which
    build is talking.
    [main.cpp]
2026-09-23 rodeo-002: record the panel bring-up signatures
    Each fault found on first assembly, with the symptom that identifies it: a
    straight-built analog run (0.30-3.30 V, handled in firmware), a dead pot (pegged
    at 0.00 V), a reversed encoder run (turning registers as a tap on that slot --
    the encoder's B line lands on the hub's S pin), floating unused slots, and the
    hub dropping off the bus taking the OLED with it.
2026-09-23 rodeo-002: describe cables by measured mapping, not vendor labels
    A bag labelled 'reverse direction' turned out to be electrically 1:1 and worked
    on an encoder run, which needs 1:1. The doc's 'contacts on the same face means
    straight' heuristic was no more reliable -- it describes the ribbon's
    appearance, and which pin lands where flips with how the ends are held.
    The sheet now says to meter it or match a known-good cable, and states which run
    needs which by electrical mapping (encoders and I2C 1:1, pots crossed) instead
    of by name.
2026-09-23 synth: stop the display starving the panel
    Panel bring-up: the control surface would stop responding -- most often while
    turning MAIN -- with MIDI and audio unaffected, and pot movement looked coarse.
    Both point at the shared I2C bus.
    - 400 kHz, the hub contract's "promote once the populated bus is validated"
    step, now that five encoders and the OLED are live. A full frame drops from
    ~100 ms of bus time to ~25 ms.
    - The hub is no longer polled from inside a frame. Those are transactions on the
    bus the display is using, and nesting them risks leaving a device holding it,
    which wedges the panel for good while audio -- in the interrupt -- carries on.
    Nothing is lost by waiting: the h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
    [main.cpp]
2026-09-23 voice: ramp control changes instead of stepping them
    Derek heard pot moves as stepped IN THE AUDIO, not just on screen -- I had
    claimed otherwise without checking, and was wrong.
    The pots are read ~108 times a second and every macro parameter went straight
    to the engine, so each reading landed as an instantaneous jump roughly every
    9 ms. Harmonics is the worst of them because it sets the virtual-analog sync
    frequency, which is exactly where he noticed it.
    Harmonics, Timbre, Morph, Cutoff, Resonance and Spread now ramp toward their
    target once per block (~1 kHz) with a 20 ms time constant, so the ear gets a
    glide between readings. Tests pin both halves of that: one block must move only
    a fr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
    [main.cpp, voice.h, voice_gtest.cpp]
2026-09-23 synth: pin Space Mix to 100% around the dead pot
    The dead channel is J25 -- Space Mix. The faulty pot came off R3C4 and was
    swapped onto J25 while proving the fault was the pot and not the channel, so
    the fault follows the pot: J25 reads 0.00 V at every position while J21 moves.
    A pot stuck at 0 is worse than an absent one here: the patch default is also 0,
    so pickup catches instantly and the dead pot holds the mix at zero, making the
    whole Space slot untestable. The mix is now held at full after the Ui runs, with
    a startup log line saying so. Remove kPinSpaceMix when the pot is replaced.
    [main.cpp]
2026-09-24 synth: hold the pinned Space Mix at 50% rather than full
    Full wet left no dry path through the Space slot, which is a poor default for
    playing while the pot is dead. Half is a usable blend and still proves the slot.
2026-09-24 space: keep DC out of the feedback loops, and level the decay knob
    Reported from hardware: some reverb and drive settings oversaturate and the
    audio eventually cuts out, returning when the settings come down. Two faults,
    both measured on the host against the real DaisySP.
    The cut-out is DC. The voices carry a ~-0.04 offset -- ordinary for asymmetric
    and sync'd oscillators -- and every Space type feeds itself back, so the offset
    is multiplied by about 1/(1 - decay): near 100x in ReverbSc at full decay, 20x
    in the granular types. The output walks onto the limiter and stays at a constant
    -1.0, which has no AC left in it, and since the line out is AC-coupled that is
    heard as silence until the f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
    [fx_gtest.cpp, fx_space.h]
2026-09-24 panel: learn each pot's real travel, and keep it in flash
    Two things reported from hardware on 2026-09-24: a pot that still would not
    reach zero after a full sweep, and calibration that did not survive a reboot.
    The nominal travel is only a guess. A satellite's divider puts a correct run at
    0.00-3.00 V and a supply-swapped one at 0.30-3.30, but component tolerance moves
    both ends -- a -20% pot tops out at 2.75 V correctly wired and bottoms out at
    0.37 V swapped. The old code only ever WIDENED from the nominal range, so a pot
    whose real travel was narrower than the guess could never reach an end: measured
    at 0.7% instead of 0 for the worst case, which is what a knob that will not go
    to zero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
    [main.cpp, panel_pot.h, panel_pot_gtest.cpp]
2026-09-24 panel: fix the pot ranges instead of learning them
    Learning each channel's real endpoints was the obvious improvement on a nominal
    guess, and on hardware it was worse: "all but one is unable to reach 0 after
    calibration" (Derek, 2026-09-24). The reason is structural. A learned minimum is
    only ever as good as the worst sample the channel has taken, so one reading from
    a settling ADC, a satellite being plugged in or a dry joint becomes the bottom
    of the range for good -- and persisting the calibration to flash turned that
    from an annoyance into a permanent fault.
    So the travel is fixed per wiring and inset by 4% at each end. Every pot within
    +/-20% then reaches a true 0 and 1 on its first tur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
    [main.cpp, panel_pot.h, panel_pot_gtest.cpp]
2026-09-24 presets: a 16-slot bank, eight factory sounds, and the browser
    The browser was already specified in the control map; this builds it. Tapping
    MAIN opens it, turning browses, tapping loads, long-pressing saves -- the one
    place long-press does not mean gesture, which is tolerable only because the
    browser is on screen the whole time it applies. Anything else touched closes it
    without loading, as does five seconds of nothing. The Ui only ASKS: load and
    save are requests the app picks up, so none of this needs hardware to test, and
    the flash work stays out of the audio callback (a save erases a 64 KB sector).
    ENGINES ARE STORED BY A STABLE ID, NOT BY ENUM POSITION. Derek is weighing up
    dropping G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
2026-09-24 ui: stop the save gesture being swallowed
    Reported from hardware: "holding MAIN while on an empty slot doesn't seem to
    save". Two defects, both reproduced on the host before touching anything, and
    neither was the empty slot -- an empty slot saves fine.
    The browser's five-second idle timer kept running while MAIN was held, so
    pausing to decide which slot to use closed the browser under a finger that was
    already pressing the encoder. The long-press then resolved outside the browser,
    where it means gesture. A press is activity, so the timer now stops while MAIN
    is down.
    And a press was disqualified as a shift by any pot movement at all, measured
    pass to pass against a 0.2% threshold. Pot dith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
    [main.cpp, ui.h, ui_gtest.cpp]
2026-09-24 ui: the screen says what the sound is doing
    Boots into the preset it was left on, as stored -- unsaved edits are discarded,
    so power-up is always a known-good sound, and the header's * is what says the
    patch has drifted. The slot lives in its own QSPI sector, written a few seconds
    after it changes rather than the moment a preset is chosen, since the write is a
    64 KB erase. Slot 1 if nothing has been chosen yet.
    The header now carries the preset name, not the engine: the engine announces
    itself when you turn onto it, and the name of what you are playing is the more
    useful thing to have in front of you. Voice mode keeps its place in three
    letters. The CPU meter is gone from the corner; the se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
    [main.cpp, patch.h, ui.h, ui_gtest.cpp]
2026-09-24 panel, lfo, scope: three faults, two of them measured as 48x and 0.065
    A parameter sitting at 0 could not be picked up: the screen said DN for ever and
    the knob did nothing. The cause is the wiring assumption. A run whose wiring had
    not been proven was treated as correctly wired, and a supply-swapped pot reads
    0.065 at its stop under that mapping rather than 0 -- so pickup could never
    catch a parameter at 0. The pots that worked were the ones that happened to have
    been turned fully clockwise at some point, which proved their wiring.
    Wiring is now three states, and either stop proves it: only a swapped run can
    read above 3.15 V, only a correct one below 0.20 V. Until one of them is proven
    th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
    [main.cpp, panel_pot.h, panel_pot_gtest.cpp, voice.h, voice_gtest.cpp]
2026-09-24 ui: the scope stays up while you turn, with the value as a number
    Watching the waveform change shape as a parameter moves is the point of having
    it, and it costs nothing extra: while a knob is moving the screen is already
    redrawing because the bar is moving, and a frame is the same 1024 bytes of I2C
    whatever is drawn in it. So the scope is now a strip above the readout whenever
    there is a readout, and takes the whole space when there is not. Only the case
    where the scope alone is moving -- a still panel -- is rate-limited, to ~10 fps;
    anything the panel did still redraws as it happens.
    The envelope is the one readout that keeps the whole area to itself. When you
    are setting an attack, the s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
2026-09-24 ui: give the bottom of the screen back to the waveform
    There was a text line reserved at the bottom for shift, freeze and messages --
    empty in almost every frame -- while the waveform was squeezed into eighteen
    rows above it, and the last two rows went unused entirely. Ten rows doing
    nothing.
    The footer's contents moved onto the things they describe, which is a better
    place for them anyway: shift inverts the header, since it is a held state that
    wants to be unmissable; freeze inverts the Space cell, because freeze belongs to
    Space; and messages float over the scope for the second or so they last, since a
    message is a moment rather than a state.
    The waveform took the space: 27 rows above a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
    [main.cpp]
2026-09-24 ui, presets: a fixed-height scope, and sixteen factory sounds
    The waveform now keeps the same height whether or not a readout is under it:
    the rows below stay reserved rather than being reclaimed when a popup expires.
    A scope that resizes as popups come and go is harder to read than a smaller one
    that holds still.
    Eight more factory presets fill the bank: Sync Stab, Wash Drone, Reverse Keys,
    Dust Piano, Fold Bass, Vowel Pad, Squash Pluck and Phase Drift. Like the first
    eight, none uses one of the four engines under consideration for removal, so
    dropping those would still orphan nothing.
    The delivery problem was the interesting part. A store's defaults are only
    written while it has never be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
    [factory_presets.h, main.cpp, preset.h, preset_gtest.cpp, ui_gtest.cpp]
2026-09-25 hardware: log the load-dependent output hum as a Rev-B review item
    A high-pitched hum on the line out that stacks with each key held, reported on
    rodeo-002 from a USB brick. Recorded against the motherboard rather than the
    instrument, because nothing about it is specific to rodeo-002.
    Two measurements put it outside the firmware. Sustained notes rendered on the
    host through the whole path -- voices and the texture chain, four engines --
    contain no component that holds a fixed frequency when the note changes, down to
    -80 dB, and a 16-sample block gives an identical spectrum to a 48, so the
    control grid is not leaking either. On hardware the hum persists with master
    volume at zero, where the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
2026-09-25 panel: ADS envelope, and two main-layer slots bought back
    Derek's reorganisation of the control surface, which pays for itself twice over.
    The envelope is now ADS, Moog style: Decay sets the fall time whether or not the
    key is still held. In practice a separate release is rarely set far from the
    decay, so the expressive range is much the same -- and it buys a slot, which is
    what lets the WHOLE envelope sit on the main layer instead of being split across
    both. Patch and StoredPreset keep a release field, moved in step by the panel
    and by CC and read by nothing, so the stored format is byte-identical: no version
    bump, no saved preset lost, and a later firmware could separate them again the
    sa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
2026-09-25 voice: two ways a note could be started and make no sound
    Reported from hardware: with Decay at zero the synth somewhat randomly stops
    responding to keypresses, and changing presets does not fix it. Two faults
    sharing a cause -- both about how a voice is started, neither about the decay,
    which only exposes them by collapsing the envelope fast enough to notice.
    DaisySP's Adsr restarts on a RISING GATE EDGE. Start() set gate = true and left
    it at that, so re-using a voice for the same note, or stealing one while it is
    still held, produced no edge at all: the envelope carried on from wherever it
    was. With a long decay that is inaudible. With a short one it has already
    collapsed, so the new not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
    [voice.h, voice_gtest.cpp]
2026-09-25 lfo, envelope, ui: three from the bench, and a destination that went nowhere
    The envelope preview gave every segment a few pixels of minimum width, so an
    attack of zero drew a slope and implied a time that was not there. A segment's
    width is now its time and nothing else: zero draws a vertical line, which is
    what zero means.
    Three more LFO destinations -- Harmonics, Resonance and Character amount -- and
    one that was already on the list, offered on the panel and stored in presets,
    and wired to nothing at all: Space mix. VoiceManager exposed the LFO value for
    the chain to read and no caller ever read it. The two chain destinations now
    live in common/lfo_dest.h, applied once per audio block ra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
2026-09-25 ui: a menu on MAIN's tap, and the gesture recorder under it
    MAIN's hold used to mean SHIFT and, on release, a long-press that armed the
    gesture recorder -- told apart only by whether anything else had been touched.
    That rule is invisible at the moment it matters and wrong in both directions:
    hesitate while holding shift and you armed the recorder; graze a pot while
    arming and nothing happened. Derek: "that feels confusing and easy to mess up."
    So nothing resolves on a long press any more. A hold is shift, in every mode,
    and everything else hangs off MAIN's tap through a modal menu: Load preset,
    Save preset, Gesture. Load and Save being separate entries is what let the
    browser's own long-pre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
    [gesture.h, gesture_gtest.cpp, main.cpp, ui.h, ui_gtest.cpp]
2026-09-25 gesture: saved with the preset, and it cost no stored format
    A take is ~100 KB -- three orders of magnitude bigger than a preset -- so it
    never belonged inside the bank. Each slot gets its own 128 KB region from
    0x100000, two erase blocks, which is what a full-length 32-lane take needs, and
    that region's own header answers whether the preset has a gesture. So there is
    no version bump, no migration and no saved preset lost, despite having
    permission to lose them.
    Only the frames actually recorded are erased and written: a four-second take is
    25 KB rather than 100, and erasing stalls the panel for the best part of a
    second. Saving a slot with no gesture running writes an empty header, which
    c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
    [gesture.h, gesture_gtest.cpp, gesture_store.h, main.cpp]
2026-09-25 panel, voice: volume waits its turn, glide only on legato, no ghost inputs
    Four from the bench; three are fixed here and the fourth is made answerable.
    Volume no longer goes live the instant SHIFT goes down. Being exempt from
    pickup was right while it sat on the main layer, where that knob's position WAS
    the volume -- behind SHIFT the same knob belongs to Sustain, so the output level
    jumped to wherever Sustain was sitting. It is still global and still never
    stored in a preset; it just waits to be caught like everything else, with the
    UP/DN hint saying which way.
    Glide now belongs to a note that arrives while a key is still down, and nothing
    else. Start() used to decide that from whether th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
    [main.cpp, ui.h, ui_gtest.cpp, voice.h, voice_gtest.cpp]
2026-09-25 panel: unconverted zeros are not evidence of anything
    Derek was right and I was wrong. "Having to calibrate knobs every boot" is not
    pickup -- it is a wiring map being destroyed milliseconds after it is restored.
    The platform's ADC cache is zero-initialised, so every channel reads exactly
    0.00 V until its first conversion lands. A full 16-channel scan takes ~19 ms
    and the panel loop runs at 25 kHz, so at boot each channel is offered as 0.00 V
    hundreds of times before any real data exists. A reading below 0.20 V is proof
    of correct wiring from a live channel -- nothing supply-swapped can go that low
    -- so every channel was being marked correctly wired at every boot, overwriting
    the map resto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
    [panel_pot.h, panel_pot_gtest.cpp]
2026-09-25 ui: settings pages, engine voice-mode limits, and CC out
    Three of the four remaining items from the original plan.
    The settings pages close a real gap: filter keytrack, velocity->filter, bend
    range and LFO shape had no control anywhere on the instrument and could only be
    reached by editing a preset in source, and the MIDI channel was stuck on omni
    with filtering already written and waiting for it. They are two more menu
    entries. Turn to choose the line, hold MAIN and turn to change it -- the same
    push-turn that picks the voice mode, so a page needs no edit mode of its own and
    the one press rule survives: tap acts, hold shifts. A tap leaves, because there
    is nothing to confirm; the change ha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
    [dsp_util.h, main.cpp, ui.h, ui_gtest.cpp]
2026-09-25 ui: presets can be named from the panel
    The last thing on the instrument that could not be done from the instrument.
    Saving now goes to the name first: turn spells the character under the cursor,
    hold MAIN and turn moves along the name, and a tap saves. Those are the two axes
    a settings page already uses, so naming needed no gesture of its own and the one
    press rule still holds.
    It starts from what the slot is already called, so renaming is an edit rather
    than spelling it out from scratch; an empty slot starts from its own number, and
    a name spelled down to nothing comes back as that rather than saving as blank.
    Trailing spaces are not part of a name. Upper case only -- at six pixels a
    char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
2026-09-25 ui: a menu that waits, a screen that keeps up, and two more destinations
    Four from the bench.
    The menu no longer times out. Five seconds is precisely the wrong amount of
    time: it closed while Derek was still deciding what to pick. Nothing is lost by
    leaving it open, because touching any pot or slot encoder still closes it, so it
    can only persist while the panel is untouched -- and there is now a Close entry
    for getting out without touching one. Double-tap was the suggestion, but a tap
    already enters the highlighted entry, so a double-tap would have to act first
    and undo second.
    The OLED delay was a bug of mine, not the bus. ScreenSignature decides whether a
    frame is worth sending, and it h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
    [lfo_dest.h, lfo_gtest.cpp, main.cpp, patch.h, preset.h, ui.h, ui_gtest.cpp, voice.h]
2026-09-25 rodeo-002 v1.0.0
    Two things a notice and a name.
    The bug first: turning onto a physical-model engine posts two things at once --
    the engine's name, and the fact that the voice mode had to move to Mono. There
    was one slot for both, so the second overwrote the first and you could not see
    which engine you had just turned onto. They have separate slots now and separate
    places on screen: what YOU did stays in the middle, what the INSTRUMENT decided
    goes to the header, where it cannot cover it. (Not the footer as asked -- there
    is no footer any more; those rows went to the waveform two rounds ago.)
    And the version: semantic, in firmware/common/version.h, printed in the startup
    banner. For an ins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
    [main.cpp, ui.h, ui_gtest.cpp, version.h]
2026-09-25 docs: two more for the backlog, with the decisions they carry
    Factory reset from the menu, and eight empty user slots on top of the sixteen
    factory ones. Recorded with what each one costs rather than as one-liners,
    because both have a decision in them that is easier to make now than halfway
    through the work.
    Factory reset has four regions to clear, and the sixteen gesture regions are
    128 KB erases apiece -- seconds, not milliseconds, so it has to say what it is
    doing. It also needs a confirmation pattern the menu does not have yet, and a
    hold cannot provide one because a hold is shift; turn-to-YES-then-tap reuses the
    settings-page gesture instead of inventing another. Whether it should also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
2026-09-29 rodeo-002 v2.0.0: user slots, factory reset, boot splash
    Eight empty slots for your own presets, on top of the sixteen factory ones.
    Empty rather than copies of Init: an empty slot says so and refuses to load,
    where a copy of Init looks like a sound somebody chose. FillEmptySlots composes
    with that, since it only fills where the FACTORY bank has a preset, so the user
    slots are not quietly repopulated at every boot.
    MAJOR rather than minor, by the rule this project wrote down at v1.0.0. Nothing
    was taken away, but the bank grew from 16 slots to 24 and that changes the
    stored layout, so a v1 bank is rejected and the factory sixteen come back --
    anything saved over a factory slot goes with it.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
    [factory_presets.h, gesture_gtest.cpp, main.cpp, preset.h, preset_gtest.cpp, ui.h, ui_gtest.cpp, version.h]
2026-09-29 tools: render the instrument's screens on a laptop
    Derek asked what software would let him design screens against the OLED library
    we use. The good external tools -- image2cpp and the u8g2/Adafruit designers --
    emit code for a different API, so every mockup would be hand-ported, and none of
    them know our fonts. What actually fits is a preview of OUR drawing code, and it
    turns out that is buildable: libDaisy's OledDisplay is a template over its
    driver, and display.h, graphics_common.h, daisy_core.h and the font tables are
    all plain C++ with no STM32 in them. Only the hardware driver is device
    specific. A stub driver with a framebuffer therefore gives pixel-exact screens
    on a laptop, with the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
2026-09-29 tools: read the framebuffer without lying about where it is
    The previewer reached the framebuffer by reinterpret_cast-ing the display to its
    driver. OledDisplay has a vtable, so that pointer lands twelve bytes before the
    driver's own storage and every screen came out shifted by twelve pixels -- which
    is precisely the quiet lie a preview exists to prevent, and I had already shown
    Derek one.
    The framebuffer is a file-scope array the driver writes into now, so reading it
    needs no cast at all. The drawing code was correct throughout; only the reader
    was wrong.
    Also adds mock.cpp: candidate layouts for the six-encoder UI -- a full-height
    list menu with a title bar, selection by inversion and a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
    [mock.cpp, preview.cpp]
2026-09-29 ui: a sixth encoder, and one meaning per gesture
    Derek found another encoder assembled, which is what this needed. Every
    complaint about navigating traced back to one thing: MAIN did five jobs, so its
    gestures had to mean different things depending on the screen. With a second
    brain encoder they do not.
    NAV moves, MAIN changes. Turn NAV to move a selection, tap it to enter, hold it
    to go back one level. Turn MAIN to change whatever is highlighted -- the engine
    on the normal screen, the value on a settings line, the letter under the cursor
    in a name, the answer on the reset page. Hold MAIN is still shift and nothing
    else. Three things fall out: hold-to-edit is gone, the Close entry is gone
    b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
    [main.cpp, preview.cpp, screen.h, ui.h, ui_gtest.cpp]
2026-09-29 ui: size the encoder state by the encoder count
    Three per-encoder arrays were still five long after NAV became encoder six, so
    every NAV press wrote one past the end of enc_held_, enc_long_ and
    enc_press_ms_ -- and read one past the end to decide what the press meant. On a
    host that is undefined behaviour; on the device it is three bytes of whatever
    happens to sit after them in DTCM, corrupted by the encoder that drives the
    entire menu.
    GCC said so nine times and I did not see it, because I have been grepping my own
    builds for "error" and for the memory figures and filtering everything else out.
    Derek read the build output instead. The arrays are sized by kNumEncoders now,
    so the next encod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
    [ui.h]
2026-09-29 ui: NAV turns presets, NAV taps opens the menu
    Turning NAV on the normal screen opened the menu. That was the last
    gesture still meaning two things, and it was in the layer you spend all
    your time in -- the menu appeared when you had only meant to look at
    something. Now the tap opens the menu and the turn is the preset
    selector: one detent, one new sound.
    Empty slots are skipped. Eight of the twenty-four are empty user slots,
    and stopping on them would be eight detents of silence in the middle of
    the bank; they are still in the browser, which is where you go to fill
    one. A bank with one sound in it has nowhere to go, so the turn does
    nothing rather than reloading what is already playing and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
    [main.cpp, preview.cpp, ui.h, ui_gtest.cpp, version.h]
2026-09-29 preset: an empty slot plays Init, and is in the scroll
    Skipping the empty slots when NAV cycles was the wrong fix for the right
    problem. It made the bank a different length depending on how much of it
    you had filled in, and it treated "nothing saved here" as "nowhere to
    go" -- when an empty slot is exactly somewhere to go. Derek, 2026-09-29:
    "I don't think empty user slots should be silent."
    So: every slot is in the scroll, and an unsaved slot plays Init while
    still being NAMED `-- empty --`. The name is what carries the honesty
    about the slot being unsaved; the silence was carrying nothing. `used`
    means what it always did, so the browser still offers the slot as free
    and saving into it is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
    [factory_presets.h, main.cpp, ui.h, ui_gtest.cpp, version.h]
2026-09-29 ui: the header says which preset, not how many voices
    `NN - Preset name`, zero-padded, with the voice mode (or ARM/REC/LOOP)
    at the right end. The `3/8` voice counter is gone: once NAV cycled
    presets, where you are in the bank became something you ask several
    times a minute, and how many voices happen to be sounding had not been
    asked since bring-up.
    Zero-padded because the name then always begins at the same x. You
    scroll this list now, and a name that shuffles sideways between slots 9
    and 10 is harder to read than one that does not.
    The number is the PLAYING slot, not the browser's selection -- scrolling
    the browser past a slot is not loading it, so Ui grew loaded_slot_
    beside browser_sl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
2026-09-29 ui: the menu has precedence, and Load leaves it
    Three things Derek asked for after flashing.
    1. Nothing on the panel closes the menu. A pot turn used to drop you
    straight back to playing, which is the same complaint the five-second
    timeout earned: brush a knob on the way past and you are out
    mid-thought. Worse, a gesture playing back moves pots that no hand is
    touching, so a looping take could close the menu by itself. The menu
    now closes when you close it. Playing still works with it open -- the
    knobs move their parameters, the menu just keeps the screen.
    Two tests were guarding "touching something else gets you out", on
    the name page and the factory-reset page. Wh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
    [preview.cpp, screen.h, ui.h, ui_gtest.cpp, version.h]
2026-09-29 docs(web): discovery, brand, architecture, claims audit and roadmap
    Planning output for the Rodeo marketing site and build log. No site code
    yet — these settle the decisions the build phase depends on.
    The product is the platform (motherboard + satellite boards); an instrument
    instance is a demonstration of it. The site is devlog-first, aimed at
    builders, ahead of a Kickstarter.
    Visual identity is derived from the motherboard PCB rather than invented:
    the palette is sampled from a kicad-cli render (black soldermask #141416,
    silkscreen #FEFEFE, plated-hole gold #F0D81E) and the typefaces are the
    ones already specified in the boards' KiCad text objects — Barlow Black,
    Barlow and IBM Plex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
2026-09-29 engines: drop Grainlet, Particle, String and Karplus
    Derek's call after living with the instrument: four engines nobody
    reached for, two of which could not be played polyphonically at all.
    Seven remain -- virtual analog, variable saw, 2-op FM, formant, Vosim,
    harmonic-16, Z-osc.
    Their stored ids 8..11 are RETIRED, not reused. A preset saved by an
    older build still carries the number and still has to mean "an engine
    this firmware does not have", so it falls back to virtual-analog and
    says so rather than quietly becoming a different sound. There is now a
    test that fails if a live engine is ever handed one of those numbers.
    DTCM 85.5% -> 53.8%. `Engine` holds one union sized by its largest
    me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
    [cost_model.h, cost_model_gtest.cpp, engines.h, preset.h, preset_gtest.cpp, ui.h, ui_gtest.cpp, version.h]
2026-09-29 feat(web): Astro scaffold, design tokens and the board catalogue
    Phase 1 of the plan in web/docs/WEB_ROADMAP.md, plus the board pages, which
    turned out to need no new content: the facts were already in the repo docs
    and the imagery comes out of KiCad.
    Stack is Astro 5 static + Tailwind v4 via @tailwindcss/vite, dark mode only.
    Design tokens are a transcription of WEB_BRAND.md: the palette is sampled
    from a kicad-cli render of the motherboard and the three typefaces are the
    ones the boards' KiCad text objects already specify, self-hosted via
    @fontsource for the GDPR reason noted in WEB_ARCHITECTURE.md.
    Pages: /, /ecosystem/, a page per board, /style-guide (internal, noindex)
    and /404. Board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
2026-09-29 docs(web): re-audit claims against rodeo-002
    The claims audit was written on 2026-09-17 and was wrong in two places by
    2026-09-29: rodeo-002 has taken 86 commits in that window (rodeo-001: zero)
    and now has a four-slot texture chain and working presets, both of which the
    audit listed as not-planned or planned and put on the never-say list.
    Corrected, and `preset`/`effects` become scope-dependent rather than banned
    outright. Also records what must NOT be stated about rodeo-002 until it is
    checked — voice count, engine list and encoder count all currently disagree
    between the concept doc, the bench logs and the firmware.
    This is the drift the guardrail was designed for, arriving in twelve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
2026-09-29 voice: stereo placement, and voices that are tuned slightly wrong
    Derek: "I mostly just want to add a little more complexity/depth/
    richness." Two things every analog polysynth does for free. No panel
    controls, no RAM, no CPU worth measuring.
    Every voice is tuned slightly wrong and wanders. A fixed error per voice
    in cents -- irregular on purpose, since evenly spaced offsets comb
    rather than thicken -- plus a slow wander from one-pole filtered noise,
    ~0.5 s to settle so it reads as drift and not vibrato. Voice 0 is
    exactly in tune: Mono only ever plays voice 0.
    Every voice has a place in the stereo field, scaled by Spread. The
    voices summed to mono before and main.cpp copied that to both c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
    [lfo_gtest.cpp, main.cpp, version.h, voice.h, voice_gtest.cpp]
2026-09-29 voice: a sub-oscillator, on the two knobs Env>Timbre/Morph gave up
    A plain waveform under or over the note, mixed in before the filter.
    Deliberately NOT a second macro engine: that would roughly double the
    per-voice cost -- FM and Harmonic 8 voices to 5, Vosim and Z-osc to 3 --
    to buy beating, which Unison already gives now that its detune works.
    What Poly lacked was weight.
    Sub level and Sub interval take shift pots 0 and 1. Env>Timbre and
    Env>Morph moved to the patch settings page rather than being deleted:
    they are depths you set for a patch and leave, so nothing is lost but
    the travel. The waveform is on that page too, being a set-once choice.
    IT FITS THE LAST TWO SPARE BYTES OF Stored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
    [cost_model.h, main.cpp, patch.h, preset.h, preset_gtest.cpp, ui.h, ui_gtest.cpp, version.h]
2026-09-29 presets: rebuild the factory bank for the instrument as it now is
    Sixteen sounds, written from nothing. The old bank predated the
    sub-oscillator, Spread-as-stereo-width and the per-voice drift, so half
    of those controls sat at their defaults in every slot -- it was a bank
    for a different synth.
    Built to COVER the instrument rather than to be sixteen good sounds in
    one corner of it: all seven engines, all three voice modes, all three
    filter types, all five Space types, and the sub above the note, below it
    and switched off. Two tests hold that line, because a header comment
    claiming coverage is worth nothing on its own:
    * CoversTheInstrument checks every one of those claims, so adding or
    d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
    [factory_presets.h, preset_gtest.cpp, version.h]
2026-09-30 fx: review all twenty effect types, and fix two
    Derek: "I suspected some of them may not be working as expected."
    The existing fx tests ask whether each type is stable, transparent at
    zero and audible at full. That is necessary and not sufficient: a phaser
    that is really a low-pass passes all three, and so does a tremolo that
    never modulates. So this measures CHARACTER -- harmonics for the
    waveshapers, the actual modulation rate for Movement, aliasing and
    crackle and gain reduction for Texture, tail length and repeat time for
    Space. Every number is printed as well as asserted, so the table itself
    is reviewable.
    TWO REAL FAULTS, both in Texture:
    * Crush sent -0.125 of DC to the output. Dec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
    [fx_review_gtest.cpp, fx_texture.h]
2026-10-01 preset: every patch carries its own gain
    Derek: "the maximum volume output has quite a wide range." Measured:
    19.3 dB of peak spread across the sixteen factory presets.
    WHERE IT COMES FROM decided the fix. At identical settings all seven
    engines sit within 5.7 dB of each other, so the per-engine trim I would
    have reached for first buys almost nothing. The spread is the patches --
    envelope, filter, voice mode, how much chain is in play -- and nothing
    but a stored per-preset number fixes that.
    So: a gain per preset, -18 to +12 dB, on the patch settings page in dB,
    half a decibel a detent. Applied AFTER the chain as a trim separate from
    the master volume, because turning a preset down must no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
    [factory_presets.h, level_gtest.cpp, main.cpp, patch.h, preset.h, preset_gtest.cpp, texture_chain.h, ui.h]
2026-10-01 ui: show the half decibel the gain actually steps in
    The patch gain steps 0.5 dB and displayed whole dB, so "+8 dB" appeared
    for two different settings and the second detent looked like it had done
    nothing. I had written a comment calling that "not inventing precision
    it does not have", which was rationalising a defect: a readout that
    cannot tell two states apart is worse than no readout.
    It shows one decimal now. Each adjustment also snaps to the
    half-decibel grid instead of running the value through log and exp and
    keeping whatever error that leaves -- otherwise the reading eventually
    sits between two detents and the display has to round again, which is
    the same bug by a slower route.
    Si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
    [preview.cpp, ui.h, ui_gtest.cpp]
2026-10-01 platform: lift the generic parts of rodeo-002 into the Rodeo library
    Four things that were never about a synthesiser, and one correction.
    THE CORRECTION FIRST, because it was wrong in a way that would have cost
    somebody a harness. panel_pot.h claimed the motherboard and the
    rodeo-potentiometer satellite were pinned opposite ways, so a REVERSED
    cable was required. Checked against both schematics today:
    motherboard J6-J29 pin 1 = +3V3 pin 2 = signal pin 3 = GND
    rodeo-potentiometer pin 1 = supply pin 2 = wiper pin 3 = GND
    (pin 1 -> 1K -> pot top leg, 100n to GND)
    They AGREE. A straight-through cable is correct and always was.
    rodeo-002's harness was simpl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
    [dsp_util.h, panel_pot.h, preview.cpp, rodeo_dsp.h, rodeo_dsp_gtest.cpp, rodeo_scope.h, rodeo_screen.h]
2026-10-01 repo: the shared firmware becomes rodeo-sdk, at the top level
    It lived at rodeo-motherboard/firmware/, which read as if it belonged to
    one board. It does not: rodeo-001 and rodeo-002 both consume it, and the
    next instrument will too. Derek, 2026-10-01: "It doesn't really make
    sense to have the firmware library under rodeo-motherboard anymore."
    Called rodeo-sdk rather than rodeo-lib because it is more than a
    library -- driver code, the pure host-tested logic, bring-up examples, a
    copy-to-start template, host tools, and the vendored libDaisy and
    DaisySP. And not rodeo-firmware, because rodeo-encoder-hub/firmware is a
    real thing: that one IS a single board's own firmware, for the STM32C0
    on th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
    [adc_convert.h, adc_convert_gtest.cpp, ads114s08.cpp, ads114s08.h, board.h, dsp_util.h, encoder_hub.cpp, encoder_hub.h]
2026-10-01 Add hardware files
    [Faceplate.3mf, Faceplate.stl, Panel_2x8.kicad_pcb, Panel_2x8.kicad_sch]
2026-10-01 rodeo-sdk: a version of its own, and Issue 1's resolution recorded
    ISSUE 1 (SPI MOSI/MISO crossed at the Daisy header): the fix went into
    the layout BEFORE the board was fabbed (Derek, 2026-10-01). So there is
    no rework on the board and nothing to find with a meter -- the copper is
    correct as delivered, and the table in that section describes a layout
    that never reached fabrication. The doc said "CRITICAL ... the MCU
    cannot talk to the ADCs ... fix before fab" until yesterday; now it says
    what actually happened, and the page header no longer warns of a wiring
    error that is not in the board.
    VERSION: common/version.h, tagged rodeo-sdk/v0.1.0. Component-first
    tags, same as rodeo-002/vX.Y.Z, s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
    [version.h]
2026-10-01 readme: put rodeo-panels on the map
    A top-level directory the repo map did not mention, so the map was no
    longer the map. KiCad panel templates for fabbing daughterboards in
    arrays (Derek: "just some kicad panel templates") -- Panel_2x8 is
    sixteen up. Nothing in it is code and nothing belongs in the SDK.
2026-10-02 feat(web): real hardware photos replace the renders
    Six photographs of the assembled boards: the motherboard front, back and two
    detail shots (the I/O edge, and the Daisy footprint with the power-only
    USB-C), plus the encoder hub front and back. Two of the supplied files were
    byte-identical; only one was imported.
    The renders for the motherboard and hub are retired. The potentiometer,
    encoder and button have not been shot yet and keep theirs, so the set is now
    mixed — BoardFigure therefore requires `media` ('photo' | 'render') alongside
    `rev` and prints both in the caption. A render shown as if it were a photo is
    the same class of dishonesty as an unlabelled board revision, and the earlie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
2026-10-04 motherboard: Rev B plan gathered into one doc
    rodeo-motherboard/docs/rev-b.md collects every Rev B item that was spread
    across hardware-map.md, the rodeo-001 control map and enclosure spec, and the
    ADC library design, plus the 2026-10-04 brainstorm: a full Seed pin map, the
    decided changes (CS pull-ups, shareable SPI1 with a J43 chip-select, a third
    ADC, ADC pull-downs, I2C pull-ups and taps on the motherboard, native SD,
    USB data with extdfu flashing, a CV header), the open audio/power items, and
    what was rejected and why. Rev B is a breaking change.
    hardware-map.md closes the power-jumper question and points at the new doc.
2026-10-04 motherboard: Rev B goes hybrid, with a satellite chain on USART2
    Keep the two ADCs and their 24 analog channels, drop the third ADC (U5)
    and J50-J61, and grow past 24 controls with a UART ring of smart
    satellites on USART2 (TX pin 35/PA2, RX pin 23/PA3). Pins checked
    against libDaisy's UART pin table and ST's pin database. libDaisy's UART
    DMA can't run alongside MIDI, so the chain needs its own rodeo-sdk
    driver on free DMA streams. The freed pin 8 becomes a digital jack.
2026-10-05 Rev B initial commit
    [power.kicad_sch, rodeo-motherboard.kicad_pcb, rodeo-motherboard.kicad_sch]
2026-10-06 Add rev B 5V source
    [power.kicad_sch, rodeo-motherboard.kicad_pcb]
2026-10-06 feat(web): new palette, three accents, and a third type family
    Applies the decisions from the Figma mockup review.
    Palette moves off the measured board values to round hex codes, per Derek.
    The identity still derives from the board; the numbers are now chosen for
    the screen, and WEB_BRAND.md says so rather than repeating a provenance
    claim that stopped being true.
    Three accents instead of one. The old rule was a good argument for a short
    page and a bad one for a long page — a dark page with a single accent has
    no way to signal a new section except another yellow band.
    The contrast fix is a split rather than a tint: #6655FF is 3.9:1 on the
    field and fails as text, which is what the mocku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
2026-10-06 feat(web): port the mockup home page, Source Serif 4, merge main
    Home page follows the Figma mockup: the "maybe it is your first rodeo"
    headline, mono hero copy, waitlist-first CTAs, a full-width board photo,
    the gold band, the three-step explainer and the indigo waitlist band.
    Nav becomes lowercase mono with rodeo-sdk added.
    Long-form face is Source Serif 4 (candidate A); the other two are
    uninstalled.
    Six fixes from the review, applied rather than carried over: the "all of
    best parts" typo, the "something, something" placeholder, the 01/02/01
    numbering, the waitlist/wait list split, and the duplicated photo in the
    gold band. Two copy points were also changed for accuracy rather than
    styl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
2026-10-06 feat(web): mobile hamburger nav
    Collapses the five nav items behind a toggle below 768px, where they were
    wrapping to a second row.
    Built as progressive enhancement: the panel ships visible in the HTML and
    the script collapses it on load, so with JS unavailable every link is
    still reachable rather than sealed behind a button that does nothing. The
    icon swaps off the aria-expanded attribute in CSS, so the button's
    accessible state and its appearance cannot drift apart.
    44x44 target, accessible name "Menu", aria-expanded/aria-controls wired,
    Escape closes and returns focus to the button. Verified by clicking and
    keying it rather than by reading the markup; desktop is untouched —
    toggle dis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
2026-10-06 motherboard: Rev B power sheet done, and rev-b.md catches up
    The power sheet is drawn and reviewed against each part's datasheet:
    USB-C (5 V only) and a power-daughterboard input through a TPS2121 mux,
    a BQ24073 charger with a DW01A/FS8205A-protected single cell and a
    MAX17048 fuel gauge, a TPS63070 buck-boost to +5V_SYS behind a latching
    power button, then +3V3_D (TPS563208), the quiet +3V3_A (TPS7A2033) and
    ferrite-filtered SEED_VIN, +5V_A and +3V3_SAT. Every part carries an
    LCSC number.
    The project library gains the TK-6580A-1 power switch, with its STEP
    model offset corrected and its pins named from the datasheet.
    rev-b.md gets a Power section, and the USB, satellite-feed, I2C, CV
    head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
    [power.kicad_sch, rodeo-motherboard.kicad_pcb]
2026-10-06 motherboard: Rev B power sheet passes ERC with no errors
    Five PWR_FLAGs mark the nets driven by parts KiCad can't see as power
    outputs: GND, +5V_SYS (the TPS63070's VOUT pin is typed unspecified),
    MUX_VCC, the LDO's ferrite-fed input and the DW01A's RC-fed VCC. The
    netlist is unchanged; the remaining ERC items are pin-type warnings from
    the imported symbols and labels waiting on the Seed sheet.
    [power.kicad_sch]
2026-10-06 Clean up power flags
    [power.kicad_sch]
2026-10-06 motherboard: Rev B trades its ADC bank for a second codec
    rev-b.md records option C, decided 2026-10-06. The two on-board
    ADS114S08s become an optional board on the SPI expansion header, and a
    CS4272 on SAI2 (pins 31-35, as on Daisy Patch) brings the audio to
    4 in / 4 out. To free the pins, the SD card drops to 1-bit and the
    satellite chain moves from USART2 to USART3 on PC10/PC11, with PC9 as
    the codec's reset.
    The pin map, SPI, satellite chain, SD, I2C pull-up sizing, power rail
    notes, open items, rejected options and firmware consequences are all
    updated to match.
2026-10-07 motherboard: Rev B Daisy, Codec and Audio Interface sheets
    The Daisy sheet moves to the option C pin map, the Codec sheet adds the
    CS4272 on SAI2, and the Audio Interface sheet adds its front end: THS4521
    inputs, OPA2376 outputs (CS4272 Fig. 14 filter) and the 2x10 IDC ribbon to
    a passive jack board. Every audio-interface part has its LCSC number, with
    the 1.5-6.8 nF C0G caps on 0603. rev-b.md records the jack-board pinout,
    the measured Seed levels and the front-end trade-offs.
    [audio_interface.kicad_sch, codec.kicad_sch, daisy.kicad_sch, power.kicad_sch, rodeo-motherboard.kicad_pcb, rodeo-motherboard.kicad_sch]
2026-10-07 rodeo-sdk: bench tool for measuring the Seed's audio levels
    10_audio_levels plays a 1 kHz sine stepping through 1.0/0.5/0.25/0.125 of
    full scale and prints input peaks over USB serial. Its measurements set the
    Rev B front-end gains.
2026-10-07 motherboard: Rev B Daisy and Codec sheets get LCSC numbers, ERC clean
    Every part on the Daisy and Codec sheets now has its LCSC number (R25 had
    the TPS63070's by mistake). PWR_FLAGs on SEED_VIN and GNDA clear the last
    two ERC errors in the project.
    [codec.kicad_sch, daisy.kicad_sch]
2026-10-08 motherboard: Rev B SD and MIDI sheets
    SD: push-push microSD socket (SHOU HAN TF PUSH, added to rodeo_jlc with
    its 3D model) in 1-bit mode, 47k pull-ups on CMD and all four DAT lines,
    22R source termination on CLK and an SRV05-4 ESD array at the socket.
    MIDI: TLP2361 opto on +3V3_D replaces Rev A's 6N138, and the jacks move
    to a daughterboard on a 5-pin JST SH (GND, IN ring/tip, OUT ring/tip).
    The MIDI IN sleeve stays unconnected there, per the spec.
    Every placed part now has an LCSC number, audited against JLC for value
    and package. Top-level label cleanup clears the last ERC errors.
    [audio_interface.kicad_sch, midi.kicad_sch, rodeo-motherboard.kicad_pcb, rodeo-motherboard.kicad_sch, sd.kicad_sch]
2026-10-08 motherboard: rev-b.md records the SD and MIDI sheets
    The SD section gets the as-drawn details (socket, pull-ups, CLK
    termination placement, ESD). A new MIDI section covers the move to a
    daughterboard on JST SH, the TLP2361 replacing the 6N138, the IN sleeve
    left unconnected, and the connector pinout. hardware-map.md had Rev A's
    MIDI OUT resistors as 220 ohm; the schematic says 100 ohm.
2026-10-08 motherboard: satellite chain connector and self-closing ring decided
    5-pin JST SH with a PRESENT pin: the satellite that sees nothing
    downstream remaps its UART TX onto the pass-through return line, so the
    ring closes without a terminator plug or return cable. Records the
    pinout, the ~6 mA per satellite power budget, the remappable-TX MCU
    requirement and the close-the-ring-here contract command.
2026-10-08 motherboard: rev-b.md records the connectors sheet
    Ten identical 3-pin JST SH I/O connectors (GND, signal via 1k, +3V3_A,
    the rodeo-potentiometer pinout) replace the digital jacks and the CV
    header; CV output conditioning moves to the jack board. Adds the SPI
    header and I2C tap pinouts, notes that an SPI OLED needs extra GPIO, and
    fixes the pot connector pinout, which was written backwards.
2026-10-08 motherboard: Rev B connectors sheet
    Satellite chain (5-pin JST SH, PTC-fused +3V3_SAT, 33R on TX, 10k
    pull-up on RX, USBLC6 flow-through ESD), four Qwiic-pinout I2C taps, the
    7-pin SPI expansion header with its chip-select and +3V3_A, and ten
    identical 3-pin I/O connectors (GND, signal via 1k, +3V3_A) for DIG_1-8
    and both DACs. Every placed part except the Seed module now has an LCSC
    number. Also fixes a Daisy-sheet label that had pin 24 on DIG_3.
    [connectors.kicad_sch, daisy.kicad_sch, midi.kicad_sch, rodeo-motherboard.kicad_pcb, rodeo-motherboard.kicad_sch, sd.kicad_sch]
2026-10-08 motherboard: satellite chain wire contract, draft v1
    Frames work like a conveyor belt: each satellite takes the first slot
    (its outputs), forwards the rest and appends its inputs, so position is
    address. Covers the electrical layer, the board-kind ID resistor table
    (one firmware image), frame and slot formats with CRC-8, discovery,
    commands including close-the-ring-here fault finding, timing (about
    2.5 ms per scan for 30 satellites) and the satellite MCU requirements.
2026-10-08 motherboard: mute shunts on the second codec's outputs
    The CS4272's active-low AMUTEC/BMUTEC drive a back-to-back 2N7002DW
    shunt on each output's connector node, switched by a BSS84DW from +5V_A
    with 1M holding the gates to the joined sources. It needs no negative
    rail and passes the +/-1.85 V output unclipped when off. The coupling
    caps now charge into the shunt at power-up, so the thump is gone.
    rev-b.md records the circuit and the socketed Seed (2x C2905423).
    [audio_interface.kicad_sch, codec.kicad_sch]
2026-10-08 motherboard: rev-b.md gathers the layout notes
    One section with every placement and routing note from the decisions:
    floorplan and ground, power, Seed and digital, audio, connectors,
    protection and silkscreen.
2026-10-08 motherboard: layout notes pin down the 4-layer stackup
    Same 4 layers as Rev A: In1.Cu an unbroken GND plane, In2.Cu zoned power
    pours, audio and fast signals on F.Cu over the ground.
2026-10-08 motherboard: power input and switch move to cabled daughterboards
    The USB-C, the TPS2121 mux, the power switch and the charge/power-good
    LEDs leave the motherboard. One JST PH 8-pin input (J2) takes 5 V, USB
    D+/D- for the Seed and the charger's PGOOD/CHG lines for LEDs on the
    power board; a JST SH 2-pin (J3) takes any panel switch, with 10k in
    series from BATT_VCC and 10 nF on EN. The SMBJ5.0A stays on VIN.
    rev-b.md gets the new power section and daughterboard contract, and
    every Rev B reference follows the project re-annotation (the satellite
    contract's chain connector is now J18).
    Known issue: D1 (SMBJ5.0A) is placed with its cathode, pad 1, on GND.
    It must be flipped before layout.
    Co-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
    [audio_interface.kicad_sch, codec.kicad_sch, connectors.kicad_sch, daisy.kicad_sch, midi.kicad_sch, power.kicad_sch, rodeo-motherboard.kicad_pcb, sd.kicad_sch]
2026-10-08 motherboard: D1 TVS the right way round
    D1 (SMBJ5.0A) now uses the unidirectional Device:D_Zener symbol, with
    its cathode (pin 1, pad 1 of D_SMB) on VIN and its anode on GND. Fixes
    the known issue noted in 4b649b8.
    [power.kicad_sch]
2026-10-09 motherboard: Rev B PCB, first-draft placement
    Portrait 87 x 142.5 mm, 4 layers, everything on top. The analog chain
    (J4, THS4521s, CS4272, OPA2376) runs down the left side next to the
    Seed's audio pins; power sits bottom right below the Seed's VIN and USB
    pins; the SD socket opens at the right edge beside Seed pins 5-7. No
    routing yet.
    The TF PUSH footprint gets one courtyard rectangle covering its pads
    (the import was 48 broken segments) and its two locating pegs become
    NPTH; update J5 from the library to pick it up.
    [power.kicad_sch, rodeo-motherboard.kicad_pcb, rodeo-motherboard.kicad_sch]
2026-10-12 motherboard: Rev B PCB fully routed
    Every connection routed on 4 layers: In1.Cu a solid GND plane, In2.Cu
    zoned +5V_A (under the audio), +5V_SYS, +3V3_D and +3V3_A. Power,
    Default and USB net classes. The battery path (BATT_P/BATT_N/BATT_VCC)
    runs 0.8-1.0 mm with at least 0.3 mm between the cell terminals, the
    BQ24073 thermal pad has four vias and Q1's source three.
    DRC: 0 unconnected. Open: 10 THS4521 pad-gap hits that the Power
    class's 0.2 mm clearance causes (set it to 0.15 mm plus a 0.3 mm
    BATT_P/BATT_N custom rule), three dangling stubs and silkscreen tidying.
    [rodeo-motherboard.kicad_pcb]
2026-10-12 motherboard: Rev B PCB DRC-clean
    Power net-class clearance down to 0.15 mm (clears the THS4521 pad
    gaps), with a custom rule holding BATT_P to BATT_N at 0.3 mm or more.
    Dangling stubs removed. DRC with schematic parity: 0 errors, 0
    unconnected; the only warnings are intentional silkscreen overlaps and
    the thin "REV B" text.
    [rodeo-motherboard.kicad_pcb]
2026-10-13 tools: KiCad helpers for reviewing schematics and building JLC orders
    netlist.py lists parts, nets or one part's pins from a fresh kicad-cli
    netlist; lcsc_fill.py sets LCSC Part fields; jlc_parts.py checks JLC's
    own stock and searches its parts; jlc_fab.py writes Gerbers, drill, BOM
    and a CPL corrected to JLC's EasyEDA footprints, with an overlay image
    to confirm it. JLC's footprints are kept in easyeda-footprints/ because
    the EasyEDA API rate-limits. Tested on the Rev B motherboard (output
    identical to the hand-built files) and a copy of rodeo-potentiometer.
    [C106259.json, C107039.json, C107626.json, C109322.json, C113474.json, C113974.json, C11702.json, C122548.json]
2026-10-13 motherboard: Rev B fabrication files
    jlcpcb/ holds the JLC order: Gerbers for all 4 copper layers plus drill
    (zipped), a 76-line, 200-part BOM, and a CPL corrected to JLC's own
    footprints (35 parts rotated or moved, including J2, J4, the JST SH
    connectors and the SOIC/TSSOP/SOT-23 parts), with placement-check.png
    showing JLC's footprints over our pads. Generated by tools/kicad/jlc_fab.py
    from the saved board (zone fills current).
    Also: C74 (0.1 uF +3V3_D) by the SD lines' layer change, the +3V3_D
    bridges under the Seed trimmed to four, and the back-side silkscreen
    art. DRC: 0 unconnected, schematic parity clean; the remaining hits
    are the back-side QR code over vias and silkscreen, kept as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
    [BOM-rodeo-motherboard.csv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]
2026-10-13 Move Rev B into its own top-level rev-b/ folder
    The Rev B motherboard project moves from
    rodeo-motherboard/rev-b/kicad/rodeo-motherboard/ to rev-b/rodeo-motherboard/
    (flat, like the satellite boards), and its docs (rev-b.md, the satellite
    chain contract) to rev-b/rodeo-motherboard/docs/. Rev A stays in
    rodeo-motherboard/. Links from the root README, hardware-map.md, the
    audio-levels example and the tools README follow. Pure renames
    otherwise; DRC, ERC and the JLC outputs are unchanged.
    [BOM-rodeo-motherboard.csv, audio_interface.kicad_sch, codec.kicad_sch, connectors.kicad_sch, daisy.kicad_sch, midi.kicad_sch, power.kicad_sch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]
2026-10-13 Rev B power boards: USB-C board done, USB-C + barrel designed
    rodeo-power-usbc: the default power input. USB-C (5.1k CC sinks, USBLC6
    flow-through, SMF5.0A on VBUS), side-view power-good and charging LEDs,
    and a PH 8-pin to the motherboard's J2. 30 x 20 mm, 2 layers, routed,
    DRC clean with schematic parity; JLC outputs from jlc_fab.py, 3 CPL
    corrections, placement check passes. J1 uses a project copy of KiCad's
    HRO footprint carrying the LCSC 3D model, aligned by render.
    rodeo-power-barrel: README with the full design (PJ-102AH 5 A jack,
    AO4407A reverse-polarity FET, SMBJ20A, TPS54308 for the motherboard and
    TPS54302 for a 3 A LED output, TPS2121 barrel-first mux) and its project
    library, r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
    [BOM-rodeo-power-usbc.csv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]
2026-10-13 tools: cache JLC footprints for the USB-C power board's parts
    [C157974.json, C160469.json, C165948.json, C193402.json, C25905.json, C284935.json, C69335.json]
2026-10-13 Rev B mounting: rear rail and motherboard frame, with a grid checker
    Printable open-rib frames that sit on a solid floor:
    - rear rail: a groove for the back panel and two rows of heat-set insert
    bosses at 15 and 35 mm from it, every 10 mm, split into bed-sized
    segments;
    - motherboard frame: four bosses on the board's existing 82 x 104 mm
    holes.
    Boards sit on M3 x 8 standoffs, undersides at 14 mm. tools/kicad/grid_check.py
    checks a board's holes, keep-outs and connector overhang against the rail
    (--rear) or the frame (--frame).
    [rodeo_motherboard_frame.scad, rodeo_mount_common.scad, rodeo_rear_rail.scad]
2026-10-13 rodeo-power-usbc: 40 x 20 mm board on the rear rail
    M3 holes at (5, 15) and (35, 15) on rail row 1, J2 centred between them and
    rotated so the power cable from the motherboard's front-facing J2 arrives
    without a twist. Fab outputs regenerated. The barrel board's README now
    plans for the rail too (M3 holes on row 2).
    [CPL-rodeo-power-usbc.csv, rodeo-power-usbc-B_Cu.gbl, rodeo-power-usbc-B_Mask.gbs, rodeo-power-usbc-B_Paste.gbp, rodeo-power-usbc-B_Silkscreen.gbo, rodeo-power-usbc-Edge_Cuts.gm1, rodeo-power-usbc-F_Cu.gtl, rodeo-power-usbc-F_Mask.gts]
2026-10-13 rev-b.md: SD card is internal, loaded over USB
    Needs the USB device MSC class in firmware.
2026-10-14 rodeo-power-barrel: schematic drawn, parts and footprints filled
    Barrel jack through a reverse-polarity P-FET to two 3 A bucks (TPS54308 for
    the motherboard, TPS54302 for the LED aux output), and a TPS2121 mux that
    prefers the barrel supply over USB. Every LCSC number checked against JLC's
    library. README renumbered to the schematic's references.
    The library gets the USB-C receptacle footprint and model from the USB-C
    board, and lcsc_fill.py can now set other fields (--field Footprint).
    [rodeo-power-barrel.kicad_pcb, rodeo-power-barrel.kicad_sch]
2026-10-14 feat(web): restyle the ecosystem pages to the mockup language
    Brings /ecosystem/ and the board pages in line with the home page, which
    was the last place the pre-mockup styling survived.
    Three pieces came out as shared components rather than being copied: the
    indigo Eyebrow section label, the CtaBand waitlist block (so every page
    ends on the one conversion that matters before launch), and the mockup's
    caption treatment, which moves into BoardFigure so every figure gets the
    gold rule and the raised chip.
    Catalogue gets an eyebrow, a real headline instead of "The boards", the
    host board in a bordered card, and the satellites as equal-height cards
    with square images. Each card states Rev and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
2026-10-14 rodeo-power-barrel: layout routed, fab outputs generated
    60 x 40 mm board on rail row 1, holes at (5, 15) and (55, 15) either side of
    the barrel jack. Each buck has its first 10 uF input cap straddling the pin
    row, with the switch node running out through the gap to the inductor, so the
    input loop stays under a millimetre. DRC is clean apart from silkscreen.
    KiCad ships no 3D models for the PJ-102AH (J3) or B2P-VH (J4), so the local
    library gets copies of their footprints with LCSC's models aligned to the pins.
    The mounting README's status table now shows the board passing.
    [BOM-rodeo-power-barrel.csv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]
2026-10-14 tools: cache JLC footprints for the barrel power board's parts
    [C132141.json, C160315.json, C168839.json, C173429.json, C25756.json, C25772.json, C25912.json, C262035.json]
2026-10-14 feat(web): build log — content collection, posts, tags and RSS
    /log/ with an index, per-post pages, tag routes and an RSS feed, built on
    an Astro content collection with a Zod schema and a closed tag enum, so a
    mistyped tag fails the build instead of quietly making a second tag page.
    The content is Derek's. Two posts already existed, untracked, in the
    rodeo-build-logs-ideas worktree — in his voice and far better than
    anything synthesised from git history. They are brought in rather than
    replaced; the I2C and SVF debugging stories move to later entries.
    Three things worth recording:
    MDX parses `<!-- -->` as JSX and throws, so the four placeholder comments
    in the drafts were converted t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
2026-10-14 feat(web): rodeo-sdk docs on Starlight at /sdk/
    Documentation for the SDK, built on Starlight rather than hand-rolled —
    sidebar, table of contents, prev/next, code highlighting and Pagefind
    search come with it, and as an Astro integration it ships in the same
    build and deploy as the rest of the site.
    Eight pages written from the actual source, not invented: the two-layer
    driver split, RodeoAdc and RodeoEncoders with their real method surfaces,
    the pure-logic headers, the nine bring-up examples and the versioning
    scheme. Caveats carried across from the claims audit — panel USB-C is
    power only, ADC absolute-voltage accuracy is unverified, the I2C bus is
    100 kHz and the Rev-A hub anchors i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
2026-10-14 fix(web): surface separation and syntax palette in the SDK docs
    Derek reported contrast problems in /sdk/. Measured first: every text
    element passes WCAG — asides, TOC, search, sidebar, and the syntax tokens,
    whose worst case was the comment colour at 6.22:1. So this was not an
    accessibility failure, and two "failures" my first audit reported were
    false positives from its own background detection walking past the real
    background. Checked both directly before changing anything.
    What was actually wrong is surface separation. Code blocks sat at 1.11:1
    against the page and had no border, so they never detached; asides and
    tables had the same problem. On a near-black page that reads as flat, a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
2026-10-14 feat(web): SDK header matches the site
    Replaces Starlight's header with the site's own: Rodeo wordmark hard
    left, lowercase mono nav hard right, yellow for the current section.
    Measured against the main site in its own page context — Barlow 900 at
    26px uppercase, IBM Plex Mono at 14px, #FFCC00 current — rather than
    eyeballed. An earlier comparison that mounted the site header inside a
    Starlight page was meaningless, since the site's Tailwind classes have no
    CSS there.
    Replacing Header wholesale is safe because the mobile sidebar toggle is
    rendered by PageFrame, not Header, so docs navigation on a phone is
    untouched. Below 50rem the site links are hidden from the bar and appear
    instead a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
2026-10-14 fix(web): declare Starlight's virtual component modules
    The previous commit went in with two type errors. I ran the check, saw
    the count, and committed anyway — the gate is only worth having if it
    actually stops the commit.
    Starlight resolves `virtual:starlight/components/*` at build time but
    ships no declarations, so `astro check` failed on the Header override
    while the build itself was fine. Importing the concrete components would
    also type-check, but it bypasses the override chain: if Search were ever
    overridden in config, a concrete import would silently keep rendering the
    stock one. Declaring the virtual modules keeps the documented behaviour.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
2026-10-14 rodeo-audio-3.5mm: jack board drawn, laid out, fab outputs generated
    Four PJ-320D stereo jacks (Seed out, codec out, Seed in, codec in) on the 2x10
    audio ribbon. Inputs get 470 ohms then a bidirectional 3.3 V clamp, outputs an
    ESD diode at the jack, the Seed outputs 100 ohms in series. J1 matches the
    motherboard's J4 orientation so the ribbon runs flat. 60 x 30 mm on rail row 1.
    KiCad has no PJ-320D model, so the local library carries LCSC's.
    Jack size is decided (3.5 mm now, a 1/4" variant to follow), and the mounting
    README's connector rule now covers panel thickness: plugs have to seat fully, so
    cut-outs are sized for plug mouldings or counterbored. Opening sizes and heights
    for every re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
    [BOM-rodeo-audio-3-5mm.csv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]
2026-10-14 tools: jlc_fab maps named KiCad pads (jack T/R/S) to JLC pad numbers
    Adds the PJ-320D mapping and caches the jack board's JLC footprints.
    [C23179.json, C431535.json, C7472904.json]
2026-10-14 ci(web): Cloudflare Pages deploy and the claims workflow
    Builds web/ and publishes to Cloudflare Pages with wrangler, rather than
    using the Pages git integration, which cannot skip submodules and would
    clone libDaisy on every site build.
    The checkout is sparse: web/ plus only the hardware paths the claim
    guardrail reads evidence from, about 4 MB. Submodules, gerbers and
    renders are never fetched. npm run check gates the deploy, so copy that
    has outrun the hardware fails before it ships.
    SITE_ENV is set per branch and drives the noindex tag, so preview
    deployments cannot be indexed under the real brand. Verified locally that
    the variable actually reaches the build — Astro does not expose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
2026-10-14 ci(web): deploy as a Worker with static assets, not Pages
    Derek pointed out the dashboard has changed: creating an app now offers
    Workers, and Pages is behind a "Need to use the legacy Pages workflow?"
    link. Checked Cloudflare's docs rather than guessing — the Pages docs
    carry a migration banner and the migrate-from-pages guide is current, so
    a site starting now belongs on Workers.
    What actually changed, verified against wrangler 4.151 rather than
    inferred:
    wrangler deploy, not wrangler pages deploy
    config in web/wrangler.jsonc, validated with --dry-run (182 assets)
    no project to pre-create — the first deploy creates the Worker
    token needs Workers Scripts:Edit, not Pages:Edit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
2026-10-14 ci(web): print token scopes when the deploy fails
    The Cloudflare API returns "No access to the specified resource" without
    naming the missing permission, which has now cost two round trips. A
    failure-only `wrangler whoami` prints the account and granted scopes, so
    the log answers the question instead of prompting another guess.
2026-10-15 Satellite contract: CH32V003F4P6 chosen, board kinds 5 and 6
    The UART remap scheme is now verified: TX and RX move together, so a satellite
    uses mapping 0 (PD5/PD6) normally and mapping 3 (PC0/PC1) when it is last, with
    IN DATA_FWD wired to both PD6 and PC1. Kind 5 is the 4-pot bank, kind 6 the
    4-encoder bank, the first multi-slot satellites.
2026-10-15 tools: jlc_fab places bottom-side parts
    Bottom-side parts are solved against JLC's footprint flipped left-right, with the
    rotation counter-clockwise as seen from the top, and the CPL marks them bottom.
    JLC doesn't document its bottom-side convention and has changed it before, so the
    script lists those parts and asks for a check in JLC's order preview. Also caches
    the pot bank's JLC footprints.
    [C125107.json, C22843.json, C23046.json, C23140.json, C25804.json, C470463.json, C5187096.json]
2026-10-15 rodeo-pot-bank-4: first satellite, drawn, routed, fab outputs
    Four Alps RK09L pots (M9 bushing) on 25 mm centres on the top side, hanging from
    the panel on their nuts; CH32V003, chain connectors and a reverse-mount status LED
    on the bottom. GND is a solid top pour, the chain's 3V3 a bottom pour. Slots are
    in board order from the IN end; the README lists each pot's ADC channel. The
    local library carries LCSC's RK09L model, aligned by measurement.
    [BOM-rodeo-pot-bank-4.csv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]
2026-10-15 rodeo-encoder-bank-4: spec and encoder footprint for the second satellite
    Four Bourns PEC11R-4215F-S0024 encoders with push switches, built like the pot
    bank so their knobs sit level with it. The CH32V003 runs out of pins, so the four
    switches share one ADC pin through a binary-weighted ladder. The local library
    has the PEC11R model on KiCad's EC11E-with-switch footprint, checked by measuring
    an exported test board.
2026-10-15 feat(web): the waitlist actually subscribes people
    The form has been posting to a path that did not exist. This adds the
    handler behind it, as a Worker route rather than the Pages Function the
    architecture doc planned, since the site moved to Workers.
    - worker/index.ts: honeypot, address validation, Turnstile, then
    Buttondown with type "unactivated" so the provider owns the double
    opt-in and the dated record of consent. 303 to /subscribe/thanks/.
    - SubscribeForm.astro, used by CtaBand and by a new /subscribe/ page, so
    the markup the Worker checks cannot drift between the two.
    - /subscribe/ and /subscribe/thanks/; the latter is noindex and out of
    the sitemap, which BaseHead grew a pr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
2026-10-15 fix(web): the captcha error told people to do the wrong thing
    Turnstile's Managed mode can render an interactive "Verify you are
    human" checkbox, and it sits below the submit button, so submitting
    before ticking it is an easy mistake. The error that came back said to
    reload the page, which does not help and loses whatever they typed.
2026-10-15 fix(web): the board strip was not centred, and `m-0` was why
    `.wrap` carries `margin-inline: auto`, but it is defined in
    @layer components and the same element also carried Tailwind's `m-0`,
    which sits in a later layer and wins. The yellow strip was pinned to
    the left gutter with the slack piled up on the right, while every other
    section centred normally. `.wrap` now goes on a plain div.
    Measured at 1585px: the strip's left edge and the section eyebrow below
    it both land at 205px, with 205px of yellow to the right. At 375px the
    gutter is 16px either side and nothing overflows.
    Also records in the docs that the production double opt-in round trip
    was run and passed on 2026-10-15, and the Tu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
2026-10-15 feat(web): hold the subscribe until Turnstile has a token
    Clicking before Turnstile finished posted a tokenless form, and the
    Worker bounced the subscriber to an error page for doing nothing wrong
    — losing what they had typed. The form now catches submit, waits for
    the token, and sends itself on the moment it arrives. The usual case,
    Managed mode resolving in a second or two, costs one line of status
    text. After 8s it says the check has not finished and points at the
    widget, which is the right advice whether the challenge is interactive
    and untouched or Turnstile is blocked outright.
    The script sits at the top level of the component rather than inside a
    `{siteKey && ...}` expression. Astr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
2026-10-15 tools: jlc_fab pin-name map for the PEC11R encoder
    KiCad's EC11E-with-switch footprint names its pads A/B/C/S1/S2/MP; JLC's PEC11R
    footprint numbers them. Also caches the encoder bank's JLC footprints.
    [C12447.json, C143790.json, C1538.json, C23249.json, C31850.json, C4184.json, C60344.json]
2026-10-15 rodeo-encoder-bank-4: second satellite, drawn, routed, fab outputs
    Four PEC11R encoders with push switches on the top side, everything else on the
    bottom like the pot bank. The four switches share one ADC pin through a binary
    ladder. GND is a solid top pour; the chain's 3V3 runs on 1 mm track with a
    bottom pour connected to pads solid. Shafts sit 1.5 mm further along than the pot
    bank's, recorded in the README; the pot bank README now has its exact positions.
    [BOM-rodeo-encoder-bank-4.csv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]
2026-10-15 feat(web): a privacy page written against the code
    Names Buttondown (processor, US, DPA and SCCs) and Cloudflare (host,
    operational logs, Turnstile), with purpose, legal basis, retention and
    the right to erasure.
    Every factual claim was checked rather than assumed: the only
    third-party runtime origin in the built output is challenges.cloudflare
    .com; there is no analytics of any kind; all 28 font files are served
    from this domain; the one browser-storage key is `starlight-theme` on
    the /sdk/ pages; and the handler sends Buttondown the address plus the
    IP as a spam signal while logging only the source label. The linked
    policy URLs were resolved — buttondown.com/privacy is a 404, the real
    o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
2026-10-15 docs(web): the Rev-B change list had been wrong for eleven days
    The claims audit said Rev-B takes analog channels 24 to 36. That was
    rejected on 2026-10-04 in favour of the satellite chain, and the audit
    whose whole job is catching drift had drifted itself. Rev-B keeps 24
    analog channels.
    Rewrites the change list against rodeo-motherboard/docs/rev-b.md, which
    is now the authoritative Rev-B source and says so — the older notes in
    RODEO_CONTROL_MAP.md, RODEO_ENCLOSURE_SPEC.md and RODEO_ADC_LIB_DESIGN
    .md are history. Adds that precedence rule, records that digital GPIO
    goes down 12 to 9 rather than staying put, and adds the satellite chain
    as the change that actually matters.
    Also settles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
2026-10-15 fix(web): the claims guardrail did not check its own documents
    Merging rev-b moved rodeo-motherboard/docs/rev-b.md out from under nine
    citations in WEB_CLAIMS_AUDIT.md and the check stayed green, because it
    only ever scanned src/data/boards.ts. The document that defines the
    truth rules was the one place rot could not be seen.
    check-claims.mjs now also resolves every repo path cited in
    web/docs/*.md. Markdown gets the path and range check but not TODO
    proximity — these docs discuss unfinished work deliberately, which is
    the opposite of a spec table claiming something shipped. Citation count
    goes 35 -> 97.
    It found real rot the moment it ran, beyond my own nine:
    - rodeo-motherboard/firmwar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
2026-10-15 fix(rev-b): two boards had no soldermask colour and rendered green
    rodeo-encoder-bank-4 and rodeo-power-usbc were missing (color "Black")
    on both mask layers, the only two boards in the repo without it. They
    render green as a result, which is not what gets fabbed. Four lines
    added, nothing else in the board files touched; kicad-cli parsed and
    re-rendered both, and power-usbc's green bias went from -10 to -1.
    The other half of this turned out to be a false alarm, and the reason
    is worth recording. rodeo-pot-bank-4 renders warm brown despite a
    stackup byte-identical to boards that render neutral black. It is not
    defective: KiCad renders black soldermask semi-transparently, so a
    dense ground p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
    [rodeo-encoder-bank-4.kicad_pcb, rodeo-power-usbc.kicad_pcb]
2026-10-15 rodeo-midi: MIDI jack board, drawn, routed, fab outputs
    Two PJ-320D TRS jacks (Type A) and a JST SH 5-pin to the motherboard's J6; the
    optocoupler and resistors stay on the motherboard. The IN jack's sleeve and pads
    stay isolated from ground (opto-isolated input, no ground loop through the
    cable); OUT gets ESD diodes. 40 x 25 mm on rail row 1, jack bodies flush with
    the I/O edge like the audio board. The mounting README's cut-out and status
    tables include it.
    [BOM-rodeo-midi.csv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]
2026-10-15 ci(web): the sparse checkout hid the paths the new check needs
    Teaching check-claims.mjs to verify citations in web/docs/ immediately
    broke CI, because the deploy checks out a sparse subset of the repo and
    rev-b/ was not in it. 26 citations resolved locally and did not exist
    on the runner. The guardrail blocked its own deploy, which is the
    correct outcome and the reason nothing shipped.
    Non-cone mode now, because cone mode can only include whole
    directories. The Rev B board folders are 2-10 MB each of gerbers and
    fab outputs wrapped around a single README the audit cites; the
    `/rev-b/**/*.md` pattern takes the eight markdown files and leaves 23
    MB of manufacturing data behind. Also adds rod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
2026-10-15 feat(web): the catalogue is about Rev-B now
    Nearly every spec on the site was a fact about a board that is not for
    sale. Rev-B is not a revision of the Rev-A motherboard, it is a
    different division of labour, so this is a rewrite rather than an edit.
    The catalogue is now the motherboard, two chain satellites, four
    daughterboards, the optional ADC expander, and rodeo-potentiometer —
    the one Rev-A board that survives, because the generic I/O connectors
    deliberately use the pinout it already has.
    Retired, with reasons: rodeo-encoder-hub, replaced by the chain;
    rodeo-encoder, which went with the hub; rodeo-button, whose two-pin
    connector no longer fits; plus the two already-retired boards.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
2026-10-15 rev-b: silkscreen checklist, regulatory notes and per-board audit
    Splits what each board's silkscreen needs into "for the Kickstarter run" and
    "after", lists the compliance decisions to settle before launch (shipping
    region first), and audits the seven Rev B boards as of 2026-10-15.
2026-10-15 feat(web): /prototype/ — the Rev-A story
    Every photograph on this site is of Rev-A hardware, and until now they
    sat on pages describing a board that does not have those parts. This
    is where they belong: beside the specs they actually match, in the past
    tense, under a heading that says what they are.
    Three sections. What it proved — ten facts measured on the fabricated
    boards, from the bench-confirmed conversion path to hub firmware
    running on silicon, each cited. The two limits Rev-A shipped with,
    named rather than buried: power-only USB-C, and the hub carrying the
    only I²C pull-ups. Then the five changes that make Rev-B a different
    board, each with what it cost and why it was worth it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
2026-10-16 feat(web): board placeholders drawn from the real outlines
    Photographs are waiting for fabricated boards, so the catalogue needs
    something in the meantime. Not a grey box: the rectangle is each
    board's actual outline, measured off its KiCad Edge.Cuts layer, scaled
    so the boards are shown in proportion to each other. A reader still
    learns the shape and the size, which is most of what a catalogue
    photograph conveys.
    The caption reads "outline only · no photograph yet", in the same
    grammar BoardFigure uses, so the two never get confused.
    Outlines, from Edge.Cuts: motherboard 90 x 112, both banks 20 x 100,
    audio 60 x 30, MIDI 40 x 25, USB-C power 40 x 20, barrel 60 x 40. They
    match the dimens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
2026-10-16 feat(web): /docs/ — the hardware documentation
    The last dead nav item, and the one a builder reads before backing
    anything. Four pages on the same Starlight instance as the SDK, under
    their own Hardware sidebar group, so they share its search, table of
    contents and styling.
    - Overview, leading with the fact that no Rev B board has been
    fabricated, because a docs section that buries that is dishonest.
    - Pinout: all forty header pins, the ten general-purpose I/O
    connectors, the SPI expansion header. Includes the two things that
    bite — PB1 and PC1 share an interrupt line, and pin 8 is the one I/O
    connector that cannot read analog.
    - Satellite chain: connector, line, how the ring cl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
2026-10-16 rev-b: Kickstarter silkscreen on all seven boards, outputs regenerated
    Every board now names itself and carries its revision, the CERN-OHL-W notice, a
    source link and the DOT RODEO LLC copyright, plus connector labels: chain IN/OUT
    (spelling fixed on the satellites), J2 pin letters on the power boards, ratings
    on the barrel board, jack functions, TRS TYPE A, battery polarity, programming
    pad letters and knob numbers. Gerbers regenerated for every board; only the
    motherboard's placement changed (C74 moved 0.5 mm). silkscreen.md records what
    is done and what is still open (board kinds on the satellites, the deferred JLC
    marker, the source links that must exist before ordering).
    Co-Authored-By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
    [CPL-rodeo-motherboard.csv, rodeo-audio-3-5mm-B_Cu.gbl, rodeo-audio-3-5mm-B_Mask.gbs, rodeo-audio-3-5mm-B_Paste.gbp, rodeo-audio-3-5mm-B_Silkscreen.gbo, rodeo-audio-3-5mm-Edge_Cuts.gm1, rodeo-audio-3-5mm-F_Cu.gtl, rodeo-audio-3-5mm-F_Mask.gts]
2026-10-16 rev-b satellites: board kind on the silkscreen, outputs regenerated
    The pot bank now says Kind 5 and the encoder bank Kind 6, so a board can be
    matched to the Seed's discovery report. Gerbers regenerated; BOM and placement
    unchanged. silkscreen.md updated.
    [rodeo-encoder-bank-4-B_Cu.gbl, rodeo-encoder-bank-4-B_Mask.gbs, rodeo-encoder-bank-4-B_Paste.gbp, rodeo-encoder-bank-4-B_Silkscreen.gbo, rodeo-encoder-bank-4-Edge_Cuts.gm1, rodeo-encoder-bank-4-F_Cu.gtl, rodeo-encoder-bank-4-F_Mask.gts, rodeo-encoder-bank-4-F_Paste.gtp]
2026-10-16 tools: jlc_fab bottom-side flip is top-to-bottom, satellites' CPLs regenerated
    JLC's order preview showed the satellites' U1 and D1 180 degrees out: JLC flips
    a bottom-side footprint top-to-bottom, not left-right as assumed. Every
    bottom-side part on the pot and encoder banks turns 180 degrees in the CPL
    (positions unchanged), which also puts J1/J2's pin 1 back on the right end.
    [CPL-rodeo-encoder-bank-4.csv, CPL-rodeo-pot-bank-4.csv, rodeo-encoder-bank-4-B_Cu.gbl, rodeo-encoder-bank-4-B_Mask.gbs, rodeo-encoder-bank-4-B_Paste.gbp, rodeo-encoder-bank-4-B_Silkscreen.gbo, rodeo-encoder-bank-4-Edge_Cuts.gm1, rodeo-encoder-bank-4-F_Cu.gtl]
2026-10-16 jlc_fab: bottom-side parts flip left-right and rotate clockwise
    JLC's preview of the satellite order showed U1 right only with a
    top-to-bottom flip and the JST SH connectors right only with a
    left-right flip. A left-right flip with the CPL rotation negated fits
    both. The LTST-C230's JLC footprint numbers its pads the other way from
    KiCad's LED, so swap them.
    [CPL-rodeo-encoder-bank-4.csv, CPL-rodeo-pot-bank-4.csv]
2026-10-16 Licences to DOT RODEO LLC, source links to the dotrodeo org
    The GitHub org is now dotrodeo, matching the Rev B silkscreen. LICENSE
    and MIT.txt name DOT RODEO LLC as the copyright holder, and the
    CERN-OHL-W source location is github.com/dotrodeo/rodeo. The site's
    GitHub links follow, and rodeooh.rodeo/source, which the daughterboards
    print, now redirects to the repo.
2026-10-16 feat(web): /about/, and the open-source ban is lifted
    The licences landed with the rev-b merge, so the claims audit's ban on
    the phrase "open source" is satisfied and gone. What replaces it is a
    narrower rule, because the risk moved rather than disappeared: licence
    names are legal statements, and three things must not be got wrong —
    CERN-OHL-W is *weakly* reciprocal and must never be described as
    strongly reciprocal or as CERN-OHL-S; it is three licences, not one;
    and rodeooh.rodeo/source is printed on the Rev B boards, so that
    redirect must outlive any repository move.
    /about/ carries that: who is accountable (DOT RODEO LLC, a one-person
    company), why the platform exists, and a licence t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
2026-10-16 feat(web): Open Graph cards, and the card tag that promised nothing
    Every page declared `twitter:card=summary_large_image` and emitted no
    og:image at all, so every share rendered a large empty card — worse
    than having claimed `summary`. All 34 pages now carry an absolute
    og:image, which is what scrapers require; a relative one is silently
    dropped, and that is the usual way a blank card happens.
    Four cards, generated by scripts/make-og.mjs from the real brand faces
    through fontconfig — Barlow Black and IBM Plex Mono, both already
    installed because KiCad uses them. Black field, yellow rail, 10-14KB
    each. PNG on purpose: Slack, iMessage and X will not render AVIF or
    WebP in a preview, and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
2026-10-16 rodeo-001: describe the voice without naming a competitor
    The Rev A docs and firmware comments used a competitor's product name as
    shorthand for the voice target. Reworded as a multi-engine poly ahead of
    the repo going public; comments only, no code change.
    [control_map.h, main.cpp]
2026-10-16 Reorganise around Rev B: hardware/, rev-a/, instruments/
    Rev B is the main line now, so it moves out of rev-b/ into hardware/.
    Everything Rev A (motherboard, encoder hub, the four daughterboards and
    the panel templates) goes into rev-a/, and the two reference instruments
    into instruments/. The tree before the move is tagged rev-a-final.
    Every move is a rename, so history follows. References are repointed:
    relative links (resolved from each file's old location), root-relative
    paths in docs, code comments and claims evidence, the CI sparse
    checkouts and path filters, the claims check's citation pattern, the
    instruments' RODEO_ROOT, and the SDK's include of the hub register map.
    The README des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
    [BOM-rodeo-audio-3-5mm.csv, BOM-rodeo-button.csv, BOM-rodeo-encoder-bank-4.csv, BOM-rodeo-encoder-hub.csv, BOM-rodeo-encoder.csv, BOM-rodeo-midi.csv, BOM-rodeo-motherboard.csv, BOM-rodeo-pot-bank-4.csv]
2026-10-16 motherboard: rev-b.md status is designed and sent to fab
    The status still said "schematic in progress". It now says the board is
    laid out, routed, DRC-clean and went to JLC with the six daughterboards
    on 2026-10-16, with nothing bench-tested yet, plus a dated history of how
    it got there. The longer status moved every later line down 14, so the
    site's line citations into rev-b.md move with it (each checked to land
    on the same text), and the site's motherboard caveat and the claims
    audit's status note say the same thing.
2026-10-16 feat(web): the Rev-B boards are at the fab, and the site now says so
    The reorganisation brought rev-b.md's new status with it: the
    motherboard and all six daughterboards went to JLC on 2026-10-16 for a
    first run of five of each. The site was still describing a schematic
    in progress and boards that were merely drawn, which badly understated
    where the project is.
    Adds an `at-fab` status, because neither existing word fits. `designed`
    means drawn and sent nowhere; `shipped` means proven on hardware and
    would be a lie. "Ordered and being made" is a real milestone a backer
    can weigh, and it is verifiable. All seven Rev-B boards move to it,
    citing one record rather than each board's design date.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
2026-10-16 motherboard: R13 47 kΩ, so the power switch carries a usable current
    R13 pulls U5's EN down against R12's 10 kΩ from the battery; at 1 MΩ
    only 3-4 µA flowed through the power switch's contacts, below what a
    silver-contact switch (the TK-6580A-1 chosen for the switch board) is
    made to switch reliably. 47 kΩ (C25792, already on the BOM) gives
    50-75 µA with EN still at 2.5 V or more. BOM and CPL regenerated;
    Gerbers are unchanged.
    Also corrects the status: the board is uploaded to JLC but not ordered.
    The site's caveat and the claims audit say the same, and the line
    citations into rev-b.md move down 4 past the new note.
    [BOM-rodeo-motherboard.csv, power.kicad_sch, rodeo-motherboard.kicad_pcb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]
2026-10-16 rodeo-power-switch: the Rev B power switch board
    A TK-6580A-1 (C528770) right-angle latching push button on a 30 x 20 mm
    rear-rail board, cabled by JST SH 2-pin to the motherboard's J3. Pins 2
    and 4 close when latched. The plunger clears the 3 mm back panel by
    only 1.8 mm, so it gets a printed cap (to be drawn). README with the
    pinout, placement, panel opening and plunger dimensions for the cap.
    The switch's symbol, footprint and model are copied from the
    motherboard's library, with the pins made passive and the plunger
    outline moved to F.Fab (it lies past the board edge). Fab outputs, plus
    rows in the mounting and silkscreen tables.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
    [BOM-rodeo-power-switch.csv, C528770.json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]
2026-10-17 mounting: assembly check with every Rev B board drawn
    Rendered the barrel, switch, MIDI and audio boards on one rail with the
    motherboard on its frame: no collisions, every connector at the panel.
    Recorded what it showed: leave an empty 10 mm cell between boards
    (they otherwise meet edge to edge and JLC's ±0.2 mm outline tolerance
    can make them bind), the back panel needs to be at least 35 mm tall,
    and the motherboard sits at least 45 mm from the panel. Also retires the
    JLC order-number marker: JLC now omits it by default.
2026-10-17 Rear panels: one FR4 panel per rear board, on a panel wall and top rail
    Each rear board gets its own 1.6 mm FR4 panel, board width + 10 mm
    wide and 40 mm tall, held by four M3 screws, Eurorack-style:
    - rear rail: the groove becomes a 9 mm wall with horizontal inserts on
    every 10 mm mark for the panels' bottom screws, plus an end post at
    each end; a joints parameter puts segment splits behind panel middles
    - new top rail on the end posts, inserts at the same marks (z = 35)
    - tools/kicad/rear_panels.py generates the five panels in
    hardware/panels/ from one table of openings; Gerbers from jlc_fab
    The 1.6 mm panel drops the 3.5 mm jacks' counterbores. Their openings
    grow from Ø5.0 to Ø6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
    [rodeo-audio-3.5mm-panel-B_Cu.gbl, rodeo-audio-3.5mm-panel-B_Mask.gbs, rodeo-audio-3.5mm-panel-B_Paste.gbp, rodeo-audio-3.5mm-panel-B_Silkscreen.gbo, rodeo-audio-3.5mm-panel-Edge_Cuts.gm1, rodeo-audio-3.5mm-panel-F_Cu.gtl, rodeo-audio-3.5mm-panel-F_Mask.gts, rodeo-audio-3.5mm-panel-F_Paste.gtp]
2026-10-18 rodeo-power-barrel-panel: Derek's hand edits, outputs regenerated
    A 9 x 11 mm rectangular barrel opening (the jack body's face), an
    11 x 5.5 mm USB-C opening, LED labels above, a drawn centre-positive
    symbol, no wordmark. On trial: the barrel opening has no clearance
    round the jack body. The generator now skips panels marked hand_edited
    (--force to regenerate) so a rerun can't overwrite this one.
    [rodeo-power-barrel-panel-B_Cu.gbl, rodeo-power-barrel-panel-B_Mask.gbs, rodeo-power-barrel-panel-B_Paste.gbp, rodeo-power-barrel-panel-B_Silkscreen.gbo, rodeo-power-barrel-panel-Edge_Cuts.gm1, rodeo-power-barrel-panel-F_Cu.gtl, rodeo-power-barrel-panel-F_Mask.gts, rodeo-power-barrel-panel-F_Paste.gtp]
2026-10-18 Panels: barrel opening clearance, smaller USB-C opening, no wordmark
    - rodeo-power-barrel-panel (hand-edited): the rectangular barrel opening
    grows from 9.0 x 11.0 to 9.4 x 11.4 mm, 0.2 mm a side round the jack
    body's face
    - rodeo-power-usbc-panel: USB-C opening 11 x 5.5 mm, r 1.5, matching the
    barrel panel (was 13.5 x 7.5, r 2); slots can now set their own radius
    - no panel carries the RODEO wordmark
    All five pass DRC; Gerbers regenerated.
    [rodeo-audio-3.5mm-panel-B_Cu.gbl, rodeo-audio-3.5mm-panel-B_Mask.gbs, rodeo-audio-3.5mm-panel-B_Paste.gbp, rodeo-audio-3.5mm-panel-B_Silkscreen.gbo, rodeo-audio-3.5mm-panel-Edge_Cuts.gm1, rodeo-audio-3.5mm-panel-F_Cu.gtl, rodeo-audio-3.5mm-panel-F_Mask.gts, rodeo-audio-3.5mm-panel-F_Paste.gtp]
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2026-10-18 jlc_fab: a STEP for renders with every board's outputs
    jlc_fab.py now writes <name>.step beside the .kicad_pcb: board, pads,
    silkscreen and soldermask with every part's 3D model, origin at the
    outline's top-left corner, the settings Derek used for his Fusion
    renders (a test export matched his barrel board's). Projects without a
    schematic (the rear panels) get Gerbers and the STEP and stop there.
    STEPs regenerated for all eight boards and five panels. The rest of
    their fab outputs came out identical apart from timestamps and are
    unchanged here.
2026-10-18 Panels: black soldermask stackup, audio jacks labelled by channel
    - every generated panel now has a stackup with black soldermask both
    sides and white silkscreen (the barrel panel already did), so KiCad's
    3D view, the STEP exports and the Gerber job file match what's ordered
    - the audio panel says AUDIO OUT 1/2, AUDIO OUT 3/4, AUDIO IN 1/2,
    AUDIO IN 3/4 instead of SEED/CODEC, at 1.3 mm so neighbours don't
    crowd; panels can set their own label size
    - the audio board README records the mapping: 1/2 is the Daisy Seed's
    codec, 3/4 the motherboard's second codec (CS4272); the board's own
    silkscreen keeps SEED/CODEC for builders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
    [rodeo-audio-3.5mm-panel-B_Cu.gbl, rodeo-audio-3.5mm-panel-B_Mask.gbs, rodeo-audio-3.5mm-panel-B_Paste.gbp, rodeo-audio-3.5mm-panel-B_Silkscreen.gbo, rodeo-audio-3.5mm-panel-Edge_Cuts.gm1, rodeo-audio-3.5mm-panel-F_Cu.gtl, rodeo-audio-3.5mm-panel-F_Mask.gts, rodeo-audio-3.5mm-panel-F_Paste.gtp]
2026-10-18 rodeo-audio-3.5mm-panel: OUT 1/2, OUT 3/4, IN 1/2, IN 3/4
    One line per jack instead of AUDIO over each, which fits the 11 mm jack
    spacing better. Channel numbering unchanged.
    [rodeo-audio-3.5mm-panel-B_Cu.gbl, rodeo-audio-3.5mm-panel-B_Mask.gbs, rodeo-audio-3.5mm-panel-B_Paste.gbp, rodeo-audio-3.5mm-panel-B_Silkscreen.gbo, rodeo-audio-3.5mm-panel-Edge_Cuts.gm1, rodeo-audio-3.5mm-panel-F_Cu.gtl, rodeo-audio-3.5mm-panel-F_Mask.gts, rodeo-audio-3.5mm-panel-F_Paste.gtp]
2026-10-18 Stop tracking the board and panel STEP exports
    jlc_fab.py still writes <name>.step beside each .kicad_pcb with the
    rest of the production files; they're now ignored rather than committed
    (about 75 MB per full regeneration). Part models in lib/*.3dshapes/ and
    the Rev A render exports stay tracked.
2026-10-18 rodeo-sdk: plan for the Rev B rewrite
    docs/REV_B_PLAN.md: Rev B only with Rev A frozen at v0.2.0 (a copy in
    rev-a/rodeo-sdk proposed for the instruments), satellite firmware in a
    top-level rodeo-satellite/ on ch32v003fun, and a first milestone of one
    bring-up example per Rev B board. Covers what happens to each part of
    the SDK, the new drivers, a shared host-tested chain-protocol header,
    the pot pipeline that stands between this and 1.0, and what can start
    before the boards arrive. The README points at it.
2026-10-18 Freeze the Rev A SDK in rev-a/rodeo-sdk; the instruments build against it
    rev-a/rodeo-sdk is rodeo-sdk as tagged v0.2.0, with its own libDaisy
    and DaisySP submodules pinned at the tag's commits. The only edit is the
    encoder-hub include path in common/rodeo.mk, for the new location.
    rodeo-001 and rodeo-002 now point RODEO_ROOT there, so the top-level
    rodeo-sdk is free to become Rev B only. Checked: rodeo-002's synth,
    bench_voices and bench_space, its screens tool and rodeo-001 build
    clean against it, and rodeo-002's 181 host tests pass.
    Also records three decisions in the Rev B plan and rev-b.md: the
    encoder hub doesn't carry over to Rev B (encoder banks replace it),
    rodeo-002 moves to Rev B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
    [adc_convert.h, adc_convert_gtest.cpp, ads114s08.cpp, ads114s08.h, board.h, encoder_hub.cpp, encoder_hub.h, gtest_all.cpp]
2026-10-18 rodeo-sdk plan: USB findings, TinyUSB recommended
    libDaisy's USB-MIDI is ST's CDC class with swapped descriptors, MIDI or
    serial and nothing beside it, and ST's library has no MIDI class and
    playback-only UAC1, so MIDI + storage + two-way audio means TinyUSB.
    A community port already runs TinyUSB UAC2 stereo in/out at 48/24 on
    the Daisy (2.5 % CPU, Windows and macOS) and found the two traps that
    apply here: the feedback format macOS and Windows disagree on, and
    libDaisy's flat interrupt priorities making audio callbacks late.
    Full-speed bandwidth fits 4x4 at 24-bit (89 % of the periodic budget).
    Storage gets a disk mode so host and firmware never share the card.
    Five steps, starting with MID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
2026-10-18 content: audit the whole site against the repo
    A pass over every page, checking each claim against what the tree
    actually contains. Four things were wrong rather than merely wordy.
    **The home page promised software that does not exist.** It said
    drivers "for the chain, the codecs and the rest come with rodeo-sdk".
    There is no satellite-chain driver and no SAI2 support anywhere in
    rodeo-sdk; the only matches for "satellite" are comments about a Rev-A
    pot's series resistor. It now says the Rev-A drivers are written and
    proven and the Rev-B ones are being written.
    **/sdk/ advertised hardware Rev-B does not have** — twenty-four analog
    channels and the I²C encoder hubs — with nothing sayin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
2026-10-18 content: correct the fab overclaim, add the eighth board and the battery
    Rebased onto Derek's correction, which walked `at-fab` back to
    `designed`: the Rev-B Gerbers were uploaded to JLC on 2026-10-16 and
    have not been ordered. The rebase took that for the board data, but
    three sentences of mine still said "went to the fab", which is the
    same overclaim in prose. They now say drawn, routed and uploaded —
    not ordered, not built, not powered on.
    Worth naming plainly: I read "it went to JLC ... for a first run of
    five of each" and built a status around it without asking whether an
    order had actually been placed. Uploading Gerbers is not buying
    boards, and the whole point of the status vocabul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
2026-10-18 content: the battery earns a place above the fold
    Rev B runs on a 1S Li-ion and charges over USB-C, and the site was
    mentioning it nowhere. For a synth-DIY audience that is not a footnote
    — it is the difference between a thing on a bench and an instrument
    you can pick up.
    Three places: the hero says it, the motherboard's own description says
    it carries the battery, charger and fuel gauge, and /prototype/ gains
    a Power row in the Rev-A-to-Rev-B changes, because it is one of the
    larger changes between them.
    Checked rather than assumed that "Rev B adds" is the right framing:
    hardware-map.md mentions a battery zero times. Rev A was USB-C in,
    straight to a regulator, tethered for as long as i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
2026-10-18 rodeo-sdk: TinyUSB 0.21.0, and a USB-MIDI + serial test for a bare Seed
    Step 1 of the USB plan. TinyUSB is pinned at 0.21.0 as a submodule, and
    examples/usb_midi_cdc is a composite MIDI + CDC device on the Seed's
    micro-USB (OTG_FS): it echoes MIDI, plays middle C every 500 ms, echoes
    the serial port and reports counters, and blinks the LED fast once
    configured. It uses System rather than DaisySeed so libDaisy's own USB
    stack isn't linked. 67 KB flash, 13.6 KB RAM. Not yet run on hardware.
    The plan records the step 2 snag: libDaisy defines OTG_HS_IRQHandler in
    system.cpp, so the external-pin core needs a vector remap or a small
    libDaisy patch.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
2026-10-18 content: follow the SDK into its Rev B rewrite
    Two citations had silently drifted. The Rev A SDK was frozen into
    rev-a/rodeo-sdk/ and the live tree shifted by four lines, so the site
    cited rodeo-sdk/README.md:125-127 for a bench-confirmed ADC and landed
    on a paragraph about control maps. check-claims passed the whole time,
    because it verifies that a line exists and is not blank — not that it
    says what the claim says.
    Rev A facts now cite the frozen copy, which cannot drift again:
    rev-a/rodeo-sdk/README.md. Verified by reading the lines back.
    Also corrects something I got wrong a few hours ago. I wrote that the
    ADC expander uses the same ADS114S08 so RodeoAdc "carries over
    unchanged". The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
2026-10-18 rodeo-sdk: USB audio works, two-way stereo 48/24 beside MIDI and serial
    examples/usb_audio makes a bare Seed a composite USB device: UAC1 audio
    in and out (stereo, 48 kHz, 24-bit, asynchronous with feedback), MIDI
    and CDC, on TinyUSB. UAC1 because TinyUSB's UAC2 feedback is 16.16,
    which macOS rejects at full speed. DaisySeed's own OTG_FS handler is
    sidestepped by copying the vector table to DTCM and pointing the USB
    entry at TinyUSB, which also clears the way for the external pins. USB
    runs below audio's interrupt priority, and the app checks for room
    before writing because TinyUSB's audio FIFOs silently overwrite.
    On a Seed 2 with macOS 26.5, a 60 s full-duplex loopback came back
    glitch-fr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
    [main.cpp, tusb_config.h]
2026-10-18 The Rev B boards are at the fab: ordered from JLC 2026-10-18
    The motherboard (R13 at 47 kΩ), the seven daughterboards and the five
    rear panels went in one order, five of each. The eight boards move to
    at-fab on the site, with caveats saying ordered, not built; the power
    switch board joins the shared order record. rev-b.md's status, the
    home page, the board index, the docs warning and the claims audit say
    the same.
2026-10-18 fix(web): the lockfile had two holes, and they hid 17 citations
    The Rev B boards were ordered from JLC on 2026-10-18, and a separate
    session had already moved the site to `at-fab` and rewritten the
    status. The lockfile should have flagged rev-b.md:3-6 changing under a
    citation. It said nothing, which is how this surfaced.
    Two holes, both silent rather than loud:
    1. The recording sat below the proximity early-exit, so no markdown
    citation was ever locked — only the ones reached from boards.ts.
    2. boards.ts gained `evidence: FAB`, a bare constant, and the fallback
    parser matched template literals and quoted strings but not bare
    identifiers. Seven citations were invisible to *every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
2026-10-18 rodeo-sdk: USB disk mode on a RAM disk (usb_audio -> usb_device)
    The USB test app gains a disk mode: 16 MB of SDRAM as a FAT16 disk, standing
    in for Rev B's SD card. 'd' on the serial port unmounts FatFs and
    re-enumerates as serial + mass storage (PID 1209:0003); ejecting the disk
    hands it back, and the Seed remounts and reports each file's size and
    CRC-32. Tested on macOS 26.5.2: files written from the Mac arrive intact,
    and audio is still glitch-free afterwards. Renamed usb_device now that it
    is more than audio.
    [main.cpp, tusb_config.h]
2026-10-18 tools/kicad: panelize with KiKit (jlc_fab.py --panel); power switch 2x2 panel
    jlc_fab.py --panel runs KiKit on the board's panel.json and writes the panel's
    Gerbers, BOM and CPL into jlcpcb-panel/. Each copy's parts are <ref>_<n>, and
    the CPL is solved per copy, so rotated copies place correctly. The power
    switch board's panel is 2x2 at 76 x 42 mm, with the second row turned so every
    plunger faces out, mouse-bite tabs on the 20 mm sides, and rails left and right.
    [BOM-rodeo-power-switch-panel.csv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]
2026-10-18 tools/kicad: panels for the small boards, and tabs that don't cut copper
    Panels for the MIDI, USB-C power, audio, power barrel, pot bank and encoder
    bank boards. The rear boards are 2x2 with the second row turned, so the I/O
    edges face out; the banks are 4 side by side. rodeo_tabs.py is a KiKit tabs
    plugin that places tabs at set positions along each edge, clear of
    connectors, parts at the edge and curved corners, and follows each copy's
    rotation.
    The mouse-bite holes sit outside the board edge. Inside it, DRC showed them
    cutting the ground pours on every board, and SWIO/NRST/PGOOD traces on the
    banks and the barrel board.
    The panels keep the board's references, so their silkscreen matches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
    [BOM-rodeo-audio-3-5mm-panel.csv, BOM-rodeo-encoder-bank-4-panel.csv, BOM-rodeo-midi-panel.csv, BOM-rodeo-pot-bank-4-panel.csv, BOM-rodeo-power-barrel-panel.csv, BOM-rodeo-power-usbc-panel.csv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]
2026-10-18 docs: SDK documentation moves into the SDK, plans move out
    Three changes that go together.
    **The eight published SDK pages now live in rodeo-sdk/docs/**, versioned
    with the code they describe and reviewed in the same change, instead of
    sitting in the website repo describing a library they were not next to.
    web/src/content/docs/sdk is a symlink to them, because Starlight routes
    by directory and 0.36 has no routeBasePath.
    Two other approaches were tried first. Two loaders feeding one
    collection does not work: Astro's glob loader deletes every entry in
    the collection it did not itself touch, so whichever runs second wipes
    the other's pages — the symptom is Starlight claiming a sidebar slug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
    [ads114s08.h, main.cpp, rodeo_adc.h, tusb_config.h]
2026-10-18 content: Rev A lives on the prototype page and nowhere else
    At launch nobody needs to know there was an earlier revision, except
    as proof that this works. Everywhere else it was explaining the
    product by contrast with a board that will never be for sale.
    The catalogue now describes boards by what they are. The motherboard
    "has one job" rather than losing converters that "defined Rev A"; the
    ADC expander is twenty-four 16-bit inputs for builds that need them,
    rather than where Rev A's inputs went; the audio and power boards drop
    their comparisons.
    rodeo-potentiometer moves to the prototype page. It does still plug
    into the shipping I/O connectors, but it is prototype hardware and
    explaining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
2026-10-18 hardware: motherboard 2x2 panel
    196 x 226 mm, inside JLC's 250 x 250 mm assembly limit. The second row is
    turned, so the SD slots face out and the plain bottom edges meet in the
    middle. Tabs are clear of the corner holes and the Seed's footprint, and DRC
    finds no copper near any tab hole.
    [BOM-rodeo-motherboard-panel.csv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]
2026-10-18 rodeo-sdk docs: a generated API reference, Rev B design drafts, and corrections
    The API reference (docs/reference/api/) is generated from the headers'
    comments by tools/docs/gen_reference.py, using libclang to find the
    declarations. It handles both the // and /** */ comment styles. `make docs`
    writes it, and `make docs-check` fails when a header's comments and the pages
    disagree; CI runs the check. Seven headers for now: the ones that carry over
    to Rev B. version.h's macro comments were each above the wrong macro, which
    the generated page made visible.
    docs/guides/ holds design drafts for the Rev B APIs that aren't written yet:
    the board's pin map, 4x4 audio, the satellite chain, the I/O co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
    [version.h]
2026-10-19 rodeo-sdk: board.h is the Rev B pin map
    Every Seed pin is named by what it is wired to: the satellite chain, the
    second codec on SAI2, microSD (1-bit), SPI to the expansion header, I2C, MIDI
    and USB. The ten I/O connectors are listed by silkscreen, with their seed::A
    and DAC channels. board.h stays host-safe; board_daisy.h converts its pins to
    libDaisy's.
    board_gtest.cpp checks the map against libDaisy's own pin table, read from
    daisy_seed.h, and checks that no pin is used twice. A planted pin typo fails
    it. It also turned up a second shared interrupt line that rev-b.md doesn't
    list: A7 (PC4) with CV1 (PA4), besides A3 with A6 (PB1, PC1). The test pins
    both pairs, so a third can't arrive un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
    [board.h, board_daisy.h, board_gtest.cpp, encoder_hub.cpp, encoder_hub.h, main.cpp, pot_ui.h]
2026-10-19 rodeo-sdk: sat_frame.h, the satellite chain's wire format in code
    The contract (RODEO_SATELLITE_CHAIN_CONTRACT.md) as one header, which both
    ends include: frame and slot layout, CRC-8/SMBUS, every slot kind, board kinds
    and the ID-resistor reading, descriptors, commands, and the Seed's
    build/parse/check functions with their result codes. It's plain C99 with
    static inline functions, because the satellites build with ch32v003fun, a C
    toolchain, on 16 KB of flash. The test build compiles it as strict C99, so a
    C++-only construct fails on the host first.
    sat_satellite_pass() is the reference model of what one satellite does with
    one frame (contract section 2.3). 17 host tests chain it to simula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
    [sat_frame.h, sat_frame_gtest.cpp, version.h]
2026-10-19 rodeo-satellite: the satellite's logic, host-tested; the chain's real lag
    rodeo-satellite/ starts with everything that doesn't touch the chip, in C99
    for ch32v003fun:
    - stream.*: passes a frame along a byte at a time. It matches
    sat_satellite_pass() byte for byte across every frame type, slot count
    and satellite kind, a chain of four included, and never gaps once it
    starts.
    - kind.*: the board kind from the ID resistor.
    - encoder.*: quadrature in detents, bounce-proof.
    - ladder.*: the encoder bank's four push switches on one ADC pin; all 16
    combinations decode at the 1 % corners.
    - pot.h: a 10-bit reading to 0..65535, smoothed.
    - boards.h: both banks' pins, read from their schematics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
    [boards.h, encoder.c, encoder.h, gtest_all.cpp, kind.c, kind.h, ladder.c, ladder.h]
2026-10-19 rodeo-satellite: the firmware builds on ch32v003fun (not yet run)
    firmware/satellite.c is the hardware glue around the host-tested logic. It
    reads the board kind at boot and sets up that board's pins. USART1 runs at 1
    Mbaud, received by DMA into a ring, and is routed on map 0 normally or on map
    3 when last (PRESENT high, or CLOSE_RING_HERE), only between frames. The
    return tap is driven only while a frame goes out. Pots and the switch ladder
    are read one ADC conversion at a time, never blocking, and encoders are
    polled. The LED follows the Seed's slot, with software PWM, blink modes and
    IDENTIFY; RESET waits for the last byte to leave. The stream now also keeps
    any COMMAND slots addressed to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
    [satellite.c, stream.c, stream.h, stream_gtest.cpp]
2026-10-19 ci: run the SDK and satellite host tests
    The SDK's 79 host tests (board.h against libDaisy's pin table, sat_frame.h's
    simulated ring, the DSP and UI helpers) and the satellite's 16 (frame
    streaming, board kind, encoders, the switch ladder) ran only locally. This
    job runs both on any change to their code, with clang as on the Macs they're
    written on. GNU make predefines CC and CXX, so the Makefiles' `?=` defaults
    never applied, and Linux would otherwise build with g++.
    It checks out only libDaisy (googletest, and daisy_seed.h for the pin-map
    check) and DaisySP (the SVF test's sources). A last step fails if the pin-map
    check skipped for want of libDaisy, so it can't pass silently.
    Co-Authore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
2026-10-19 rodeo-sdk: the satellite chain driver (engine host-tested, not yet run)
    sat_chain.h is the engine, as pure logic: it decides what frame goes next and
    makes sense of what comes back. It waits 50 ms for the satellites to boot,
    discovers, and scans every 4 ms. After 3 bad scans it rediscovers; after 3
    failed discoveries it finds the break and keeps scanning the satellites before
    it, retrying the whole ring every 2 s. Controls are read by satellite and slot:
    Pot, EncoderSteps, Pressed, Presses, SwitchPosition, Fault. SetLed rides on
    every scan.
    11 host tests run it against a simulated ring built on sat_satellite_pass():
    power-up wait, the 4 ms rate, inputs and LEDs, an empty ring, a satellite a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
    [main.cpp, sat_chain.cpp, sat_chain.h, sat_chain_gtest.cpp, sat_chain_port.cpp, sat_chain_port.h, version.h]
2026-10-19 rodeo-sdk: chain port runs on a Seed; fix USART3's baud rate
    First run on a Seed 2 with pin 3 jumpered to pin 2 (a ring with no
    satellites) showed the ring broken and USART3's BRR at 0.
    HAL_RCCEx_GetPeriphCLKFreq() returns 0 for the USART234578 group in this HAL,
    without an error. The port now reads USART3's clock selection from RCC and
    uses PCLK1 (libDaisy's choice), HSI or CSI accordingly. BRR is 100 (100 MHz
    / 1 Mbaud).
    Bench result: discovery finds 0 satellites, and the Seed scans at 250 a
    second. About 3,750 scans in a row came back whole, 0 bad. The break-and-
    recovery test (pulling the jumper) is next.
    The port keeps an exchange count and the last reply's length and first bytes
    as d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
    [main.cpp, sat_chain_port.cpp, sat_chain_port.h]
2026-10-19 rodeo-sdk docs: the chain driver ran on a Seed
    examples/sat_chain on a Daisy Seed 2, with pin 3 wired to pin 2 (a ring with
    no satellites). It discovered an empty chain and scanned at 250 a second,
    none bad. With the wire pulled it went through 3 bad scans, rediscovery and
    the break search to "broken before the first satellite". With the wire back,
    the next 2 s retry restored scanning. The examples page lists it as running
    today. The guide stays a draft until satellites have run on a Rev B board.
    [version.h]
2026-10-19 rodeo-sdk: the I/O connectors, self-tested on a Seed
    io_plan.h checks a configuration of the ten connectors before any pin is
    touched: analog only where there's an ADC channel, CV out only on CV1/CV2. It
    reports failures by silkscreen name and works out the ADC scan order. It is
    pure, with 5 host tests (95 in all).
    io.h does the hardware with libDaisy: GPIO for digital in (with or without a
    pull) and out, AdcHandle scanning every analog input in the background on
    DMA, and DacHandle in polling mode with its output buffer on for CV1/CV2.
    Get/Set/Read/Write go by connector name.
    examples/io_connectors self-tests on a bare Seed with two jumpers: pin 30 to
    29 (CV1's DAC into CV2's ADC) and pin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
    [io.cpp, io.h, io_plan.h, io_plan_gtest.cpp, main.cpp, version.h]
2026-10-19 tools/render: studio renders of every Rev B board, from KiCad via Blender
    render.py runs headless in Blender (5.2). kicad-cli exports each board as GLB
    with silkscreen, mask and copper; the script replaces KiCad's materials
    (black satin mask, ENIG pads, satin-nickel metal, part plastics sorted by
    the colour KiCad's 3D library gives them), lights it on a warm backdrop
    and renders front, back (flipped left to right, as KiCad's flipped view, so
    the back silkscreen reads) and three-quarter views with Cycles.
    blender -b -P tools/render/render.py -- --all
    writes hardware/<board>/renders/<board>-{front,back,iso}.jpg: 24 images for
    the 8 boards, about 16 minutes on an M4. --panel adds the board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
2026-10-19 web: Rev-B boards shown as CAD renders until they can be photographed
    Every Rev-B board now has a three-quarter render as its lead image, on its
    card in /ecosystem/ and at the top of its page, with top and bottom views
    below. The motherboard's sits beside its specs on /ecosystem/. Each is
    captioned Rev-B and CAD render, the card included, so none passes for a
    photograph. They are placeholders: photographs replace them once the boards
    are back from the fab.
    Decision 8 held the renders back until the soldermask stackups agreed. Every
    Rev-B stackup now declares black mask on both sides, which is what the renders
    show, so the comments that cited it are updated.
    npm run renders, with no argumen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
2026-10-19 hardware: USB-C power board gets its copyright line
    The back silkscreen block (name, revision, licence, source) is now 0.8 mm
    text with "© DOT RODEO LLC" added, so every Rev B board carries the
    copyright line. DRC: 17 findings, down from 20, none on the new text.
    Fab outputs regenerated. On the single board only the back silkscreen
    changed; the BOM and CPL are unchanged. The panel's other layers changed too,
    but only in the order KiKit writes objects: its tracks, pads and zone fills
    match the previous panel exactly, and a panel rebuilt from the pre-edit board
    churns the same way.
    [rodeo-power-usbc-B_Cu.gbl, rodeo-power-usbc-B_Mask.gbs, rodeo-power-usbc-B_Paste.gbp, rodeo-power-usbc-B_Silkscreen.gbo, rodeo-power-usbc-Edge_Cuts.gm1, rodeo-power-usbc-F_Cu.gtl, rodeo-power-usbc-F_Mask.gts, rodeo-power-usbc-F_Paste.gtp]
2026-10-19 web: the ecosystem lists only the platform's boards
    rodeo-adc-expander comes off the site, page and all: it is specified but not
    drawn, so it is not part of what the campaign sells. The motherboard's own
    copy still mentions an optional expander. The Retired section goes too, with
    the list behind it; the claims audit keeps the record of what was cut and why.
2026-10-19 Revert "hardware: USB-C power board gets its copyright line"
    This reverts commit 400a522. The board, its fab outputs and its panel are
    back as ordered for B1. The copyright line, and the year every board but
    the motherboard lacks, go on the board's next-revision list, to be made
    together in B2.
    [rodeo-power-usbc-B_Cu.gbl, rodeo-power-usbc-B_Mask.gbs, rodeo-power-usbc-B_Paste.gbp, rodeo-power-usbc-B_Silkscreen.gbo, rodeo-power-usbc-Edge_Cuts.gm1, rodeo-power-usbc-F_Cu.gtl, rodeo-power-usbc-F_Mask.gts, rodeo-power-usbc-F_Paste.gtp]
2026-10-19 hardware: versioning rules, and a record of each board's revisions
    versioning.md: the letter is the platform generation (every board of one
    letter works with every other; changing a connector pinout, the chain's
    electrical contract, the I/O pinout, the mounting system or the Seed pin map
    makes a new letter). The number is each board's own revision, and any change
    to what's fabricated bumps it. A revision is fixed when ordered and tagged
    <board>/B1 on the commit whose outputs went to the fab. The SDK targets the
    letter; satellites identify by ID resistor, not revision.
    revisions.md: all 13 Rev B designs ordered from JLC on 2026-10-18 are B1, at
    ebca252. Next-revision lists start with the cop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
2026-10-19 web: the homepage shows the Rev-B boards and nothing of Rev A
    The hero is a new 16:9 render of the motherboard: render.py's wide view, the
    three-quarter angle framed with room around the board (--views wide, 2400 x
    1350). The yellow strip shows the pot bank, the encoder bank and the audio
    jacks, one per step below it. Every image is captioned Rev-B and CAD render,
    the strip included.
    The prototype photographs go, with the paragraph introducing them and its
    link to /prototype/, and the hero copy says the synth runs on a battery
    rather than that Rev B does. npm run renders encodes a wide view at up to
    2400 px for a hero (119 KB); everything else stays at 1400.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
2026-10-19 hardware: chain power is a voltage-drop budget; note the missing 5 V aux output
    The chain contract's 6 mA per satellite was an average for 30; the real
    limit is the drop at the end of the chain, so state the headroom rule and
    what it allows (lit-button satellites). Record in the next-revision list
    that the motherboard brings no +5V_SYS to a connector, and the B1 rework.
2026-10-19 rodeo-button-bank-4: spec for the third satellite
    Four 6 x 6 mm tact switches on 12 mm centres with a WS2812B-2020-V6 above each,
    on a CH32V003. The LEDs run from the chain's 3V3, or from an optional aux 5 V
    through a Schottky, with a P-FET dropping the 3V3 feed when aux is present; a
    divider tells firmware which, for the brightness cap. Board kind 7. LED
    positions and keep-outs are fixed for light pipes in the panel.
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2026-10-19 rodeo-button-bank-4: schematic
    One sheet, ERC clean, nets as the README's tables. Q1 uses the TP0610T symbol
    (the AO3401A's base in KiCad's library, same SOT-23 pinout) so the sheet's copy
    matches the library. The aux-sense divider doubles as Q1's gate pull-down, so
    the separate 100k is gone.
    [rodeo-button-bank-4.kicad_sch]
2026-10-21 tools/kicad: jlc_fab places parts whose KiCad pads repeat a number
    A 6 x 6 mm tact switch is pads 1, 1, 2, 2 in KiCad (each row one contact) but 1-4
    in JLC's footprint, and the solver translated by the first pad of each number,
    so the switches came out 2.25 mm off. It now uses the centre of each number's
    pads (unchanged for unique numbers), and EE_PAD_ALIASES renames JLC's pads to
    ours, starting with the Omron B3F-1052.
2026-10-21 tools/kicad: EasyEDA footprints for the button bank's parts
    [C15127.json, C160352.json, C19702.json, C22775.json, C23114.json, C25803.json, C52917434.json, C8598.json]
2026-10-23 rodeo-button-bank-4: layout, routing, silkscreen and fab outputs
    Derek's layout: a 20 x 75 mm strip like the other banks, switches on 12.5 mm
    centres with each LED 7 mm to its right, hung on two M2 standoffs. Four
    layers: In1 GND, In2 split between +3V3 (the chain pass-through) and V_LED,
    AUX_5V in the gap. Assembled on both sides; the LEDs face the panel.
    The PH aux connectors and the WS2812B-2020 had no 3D models in KiCad; a
    project library carries copies of their footprints pointing at LCSC's models,
    the PH one placed by its pins and tabs. Fab outputs for single boards and a
    1 x 4 panel with tabs clear of the parts at the edges, and studio renders.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
    [BOM-rodeo-button-bank-4-panel.csv, BOM-rodeo-button-bank-4.csv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]
2026-10-23 rodeo-pot-1: spec for a single-pot satellite
    Kind 1: the pot bank cut to one RK09L pot, with the same CH32V003F4P6 (the 8-pin
    J4M6 has no PC0, so it couldn't close the ring), connectors, status LED and pin
    map, so the firmware's kind-1 map is the bank's slot 1. R_ID 715 ohm. Open: whether
    one bushing holds the board against rotation.
2026-10-26 rodeo-pot-1: schematic, layout, fab outputs and renders
    Derek's board: 25 x 25 mm, 2 layers, the pot on the panel side at the centre and
    every SMD part on the back. An M2 standoff at H1 keeps the board from turning
    on the pot's single bushing; the status LED sits 9.5 mm from the shaft, which
    limits knobs to about 14.8 mm. Library copied from the pot bank. Fab outputs
    for single boards and a 3 x 3 panel (79 x 93 mm, rails top and bottom since the
    side edges are full), and studio renders.
    [BOM-rodeo-pot-1-panel.csv, BOM-rodeo-pot-1.csv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]
2026-10-26 tools/kicad: EasyEDA footprint for the 715 ohm ID resistor
    [C2998136.json]
2026-10-26 rodeo-satellite: kind 1, the single pot
    SAT_BOARD_POT_1 is the pot bank's map cut to slot 1: the pot on PA2, PRESENT on
    PC3, the LED on PC6, the ID divider fed from PC2. setup_board takes the slot
    count from sat_kind_slots() and sets up only the pots a board has, so kind 1
    reports one POT slot through the bank's code. Tests: kind 1 (R_ID 715 ohm, the
    lowest reading of any kind) is found by driving its feed, and its map matches
    the bank's slot 1. Firmware still builds to 6.6 KB.
2026-10-26 web(claims): re-point citations that 6a922cb moved
    Adding the chain's voltage-drop budget lengthened rev-b.md by 4 lines and the
    chain contract by 14, so 12 citations in the claims audit and boards.ts pointed
    at the wrong text, and the claims workflow has failed since. Every quoted text
    is unchanged, word for word, at its new line: the lockfile diff renames 12 keys
    and changes no text.
2026-10-26 rodeo-encoder-1: spec for a single-encoder satellite
    Kind 3: the encoder bank cut to slot 1, with the same PEC11R, CH32V003F4P6,
    connectors, status LED and pin map. The push switch keeps the bank's ladder
    circuit with one rung, so the firmware's existing decoder serves it; the ID
    divider is fed from 3V3 like the bank's. R_ID 2.49 kohm. Outline suggested to
    match the single pot's, with an M2 standoff hole from the start; the pot's LED
    spot collides with the encoder's switch pins, so the LED moves to the lug axis.
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2026-10-26 tools/kicad: jlc_fab places the PEC11R encoder by both lugs
    KiCad names both encoder lugs MP; JLC numbers them 7 and 8. The old alias
    mapped MP to 7, which worked only while the fit used the first pad of each
    name; since the fit uses each name's centre, it put the single encoder 1.05 mm
    off. The encoder is now renamed on JLC's side, 7 and 8 both to MP. (The encoder
    bank's CPL would move by 0.017 mm; its B1 outputs, as ordered, are left alone.)
2026-10-26 rodeo-encoder-1: schematic, layout, fab outputs and renders
    Derek's board: the single pot's 25 x 25 mm outline and hole positions with the
    PEC11R at the centre, every SMD part on the back, and an M2 standoff at H1. The
    LED sits 10.5 mm from the shaft, a millimetre further than the pot's, to clear
    the encoder's switch pins. The push switch is the bank's ladder with one rung,
    and the ID divider is fed from 3V3. Library copied from the encoder bank. Fab
    outputs for single boards and a 3 x 3 panel, and studio renders.
    [BOM-rodeo-encoder-1-panel.csv, BOM-rodeo-encoder-1.csv, C22908.json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]
2026-10-26 rodeo-satellite: kind 3, the single encoder
    SAT_BOARD_ENC_1 is the encoder bank's map cut to slot 1. The encoder loops run
    over the encoders a board has instead of a fixed four, and the push-switch
    ladder is set up with one rung: LADDER_ABSENT gives a missing switch zero
    conductance, so the bank's decoder never reports it. Tests: kind 3 is found
    without driving PC2, and the one-rung ladder decodes, debounces and counts.
    Firmware builds to 6.8 KB.
    [boards.h, ladder.h, logic_gtest.cpp, satellite.c]
2026-10-26 tools/render: leave Do Not Populate parts out of the renders
    kicad-cli renders DNP parts as fitted unless told --no-dnp, so every satellite
    showed its programming header (J3, or J5 on the button bank), which is never
    fitted. Re-rendered the five boards that have one, and the site's WebP copies of
    the two banks it shows. The motherboard's Seed (A1) is off the BOM but not DNP,
    so it still renders, as it should.
2026-10-26 web: the three satellites drawn since the fab order
    rodeo-button-bank-4, rodeo-pot-1 and rodeo-encoder-1 went into the repo
    after the 2026-10-18 JLC order and were missing from the site entirely.
    All three are `designed`, not `at-fab`: the Built table in revisions.md
    lists thirteen boards and none of these is one of them.
    Their CAD renders become the placeholders, as the other Rev B boards
    already do (`npm run renders`, nine new WebP — no other board's
    derivative changed).
    Claims that the new boards broke:
    /ecosystem/ "every one is drawn, routed and ordered from the fab"
    / "the boards are drawn, routed and ordered from the fab"
    /ecosystem/ "Four controls at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
2026-10-26 chain contract: kind 7 is the button bank, and RGB is an output slot
    The button bank's silkscreen has said `Kind 7` since it was routed, while
    the contract's table still read "7-14 unassigned". Assign it: four slots,
    `BUTTON` in and `RGB` out, one LED per button.
    `RGB` = `0x11` closes §9's open item rather than deferring it again. That
    item assumed a colour needs more than a slot's two data bytes, which is
    wrong for RGB565 — sixteen bits is exactly a colour, so no second slot and
    no change to §2. It carries no brightness or blink field: scale the colour,
    and blink by sending a different one. A satellite with colour LEDs also
    takes `LED` on the same slot and shows it white, so a Seed tha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
2026-10-26 web: the button bank's firmware is written, not yet on a board
    The site said kind 7, the RGB slot and the WS2812 driver were unwritten; they
    now exist. The board's caveat moves from planned to in-progress and cites the
    README's 'built and host-tested, not yet run on a board'; the satellite-chain
    page's note says the same. The lockfile swaps that one citation.
2026-10-26 rodeo-sdk: audio_4x4 and sd_card bring-up examples
    common/audio_4x4.{h,cpp} puts both codecs in one four-channel callback:
    Daisy Patch's dual-SAI setup with Rev B's pins. SAI1 is rebuilt to match
    whichever Seed libDaisy detected, and the CS4272's reset is released
    once SAI2's clocks are running. rodeo_dsp.h gains ToneMeter, which
    reports peak and frequency, with host tests (99 pass).
    examples/audio_4x4 sends 250/500/1000/2000 Hz out of outputs 1-4 and
    reports, for each input, whether it hears its own tone, another
    output's, or nothing. examples/sd_card runs SDMMC1 in 1-bit mode
    through FatFS: it mounts the card, lists the root, writes 4 MiB, reads
    it back, checks it and times both direction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
    [audio_4x4.cpp, audio_4x4.h, main.cpp, rodeo_dsp.h, rodeo_dsp_gtest.cpp, version.h]
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2026-10-26 Specs for the single button and rotary switch; kind 14 for custom boards
    hardware/rodeo-button-1 (kind 2): one cell of the button bank, built
    like the single pot. A B3F tact switch on PA1 and the singles' red
    reverse-mount LED keep SMT single-sided and the board on chain power.
    Two M2 standoffs carry the press, since there's no bushing. RGB is
    left open.
    hardware/rodeo-rotary-switch-1 (kind 4): up to 8 positions read on the
    single pot's ADC pin through a 9 x 4.7k ladder (taps at 1/9..8/9), with
    a 1M pull-down so the gap between contacts is never position 1. The
    Alpha SR1712F is recommended but JLC doesn't stock it; the Alps parts
    JLC has don't fit, and the spec says why.
    Kind 14 is now a c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
    [main.cpp, sat_frame.h, sat_frame_gtest.cpp, satellite.c]
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2026-10-26 rodeo-button-1: schematic and layout, first pass; rotary switch library
    rodeo-button-1 is the single pot's board with SW1 (B3F, KiCad's
    SW_PUSH_6mm and model) in place of the pot. The switch goes on the old
    wiper pin (PA2, net SW) with C1 now 10 nF; R5 is 1.54k (C2933149) for
    kind 2. H2 is added at (12.5, 21).
    Derek's routing is kept except where the switch's pins landed: PRESENT,
    NRST, DATA_RET and PC0's net were ripped up and re-routed by script,
    along with SW's run to the old wiper pin. The routes are correct but
    not tidy. ERC is clean. DRC with schematic parity shows only the
    single pot's three lens-hole edge errors. The title stays on the back,
    next to the switch; the licence and copyr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
    [rodeo-button-1.kicad_pcb, rodeo-button-1.kicad_sch]
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2026-10-26 rodeo-rotary-switch-1: pin functions from Alps' circuit diagram
    Terminals 1 and 10 are the common, 2-9 positions 1-8 (6-9 dummies on
    the 4-position part), 11 and 12 the lugs. Wire all eight taps so the
    SRBV181004 is a BOM swap.
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2026-10-27 rodeo-rotary-switch-1: schematic and layout, first pass
    From the single pot's files, by script: SW1 (Alps SRBV) for RV1, the
    9 x 4.7k ladder on terminals 2-9, 1M pull-down, R_ID 3.65k. The board
    is 25 x 37.5 mm with the switch centred, U1 between its terminal rows
    on the back, and every net routed by the grid router. ERC clean; DRC
    with schematic parity shows only D1's two lens-hole edge errors.
    [rodeo-rotary-switch-1.kicad_pcb, rodeo-rotary-switch-1.kicad_sch]
2026-10-29 revisions: motherboard battery polarity, found at bring-up
    Every cell on hand is wired opposite to J1; the first went in reversed and
    the fuel gauge no longer measures. Swap J1 and add reverse protection.
2026-10-30 Rev B bring-up: 01 and 03 pass on the board
    01 passes apart from the fuel gauge, which a reversed cell probably
    damaged; 03's MIDI loop returns every note, CC and SysEx in order.
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2026-10-30 usb_storage: keep FatFS file objects off the stack
    FatFS moves a partial sector through the FIL's own buffer, and the stack
    is in DTCM, which the SD driver's DMA can't reach. On Rev B a 55-byte
    .TXT copied from the Mac listed with CRC 0, and README.TXT was created
    empty; whole-sector files were fine. Make both FILs static, as sd_card's
    already are.
    Bring-up 09 passes with the fix.
    [main.cpp]
2026-10-30 docs: with USB-C attached, tap RESET after a ROM DFU flash
    The STM32H750 ROM bootloader also listens for USART1 on PB14/PB15, which
    Rodeo routes to the USB-C's D-/D+. With a host attached there, the DFU
    leave never reaches the app (not even its first instruction, traced with
    a patched reset vector). Software resets and flashing with the USB-C
    unplugged both start the app normally.
2026-10-30 rodeo-sdk: build for the Daisy bootloader, flash over the USB-C
    rodeo.mk now defaults to APP_TYPE=BOOT_SRAM and installs libDaisy's
    extdfu-2000ms bootloader with `make program-boot`. Its DFU answers on
    pins 36/37, Rev B's USB-C. Installed on the bring-up Seed 2026-10-30.
    'B' on every example's serial port now calls ResetToDfu() (common/dfu.h),
    which waits in the Daisy bootloader. A BOOT_NONE build falls back to the
    ROM.
    Under BOOT_SRAM, statics live in DTCM, and SDMMC1's DMA reaches neither
    DTCM nor SRAM1. So sd_card and usb_storage keep their FatFS objects and
    buffers in the SDRAM. Both pass again on Rev B: 07 at 347 KB/s write and
    1274 KB/s read, and 09 with README.TXT rewritten.
    The bo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
    [dfu.h, main.cpp]
2026-10-31 rodeo-sdk: keep the CS4272 in slave mode; audio_4x4 passes on Rev B
    libDaisy pulls every SAI pin up, and SAI2's SD_B is the CS4272's SDOUT,
    which it reads at reset to choose master or slave. The ~40k pull-up
    against R19's 47k pull-down sat near the threshold, so the codec came up
    as master at random: noise both ways, or its data 2 bits off per step.
    Clear the pull after the SAI init.
    [audio_4x4.cpp]
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2026-11-01 audio_4x4: round outputs 3/4 to 16 bits for the CS4272
    On Rev B1 the CS4272's DAC data corrupts its ADC data through the layout.
    Rounding out[2] and out[3] to 16 bits after the instrument's callback keeps
    SDIN's low byte quiet and cuts the damage. Measured on the board, three or
    four 20 s runs each, Seed outs 1/2 into codec ins 3/4, outs 3/4 at 0.25:
    usb_audio 24-bit: 500-1,500 bad samples per channel before, 5-52 after
    usb_audio 16-bit: 0-10 before, 0 in all four runs after
    [audio_4x4.cpp, audio_4x4.h]
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2026-11-02 rodeo-satellite: flash with a Pi Pico running picorvd
    make flash-pico PICO=<port> flashes a satellite through a Pico or Pico 2
    running picorvd, until a WCH-LinkE arrives. tools/picorvd_flash.py speaks
    picorvd's GDB protocol directly, so no RISC-V GDB is needed: erase, write,
    read back and compare, reset. Tried on two satellites, one an encoder bank, with a
    Pico 2; the README has the wiring and the two changes picorvd needs on an
    RP2350.
2026-11-02 rodeo-satellite: pass frames through in the UART interrupt
    A two-satellite ring (pot bank, then encoder bank) found both but failed
    every SCAN: replies came back 3 to 26 bytes of 36. Three causes, all on
    the satellite's side of the gap rule (two idle byte times end a frame):
    - The main loop sent owed bytes one per pass. RX and TX now run in
    USART1's interrupt, the RX DMA ring is gone, and the main loop shares
    the input slots, frame results and idle/routing checks behind
    __disable_irq().
    - At a frame's last byte the stream worked out all it still owed (up to
    17 bytes) before sending any, longer than the gap on a CH32V003.
    stream_rx() now returns at most one byte and stream_next() h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
    [satellite.c, stream.c, stream.h, stream_gtest.cpp]
2026-11-02 rodeo-demo: a small synth and sampler for Rev B
    Eight voices shared between a two-oscillator synth and an SD-card sampler
    (pitched sounds and kits), played from USB MIDI or the TRS jack and shaped
    from the pot bank and encoder bank. USB audio 4x4: the demo to the computer
    on inputs 1/2, the computer's playback on OUT 3/4.
    On the board: 8 voices at 69 % CPU, filter at control rate. 16-frame audio
    blocks, because 1 ms blocks held off the USB interrupt long enough to drop
    isochronous packets (about 36 underruns a second with voices sounding, none
    after).
    [main.cpp, panel.cpp, panel.h, samples.cpp, samples.h, synth.cpp, synth.h, tusb_config.h]
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2026-11-02 tools/rodeo-console: phase 1, building the SD card in a browser
    Drop in audio of any format, lay a kit across the keys, edit presets as
    a form, and find out what the firmware would quietly skip — before
    walking back to the bench. No build step, no dependencies, Chrome or
    Edge. `npx serve tools/rodeo-console`, and `?demo` shows it working with
    no hardware attached.
    The useful part is not the converting, it is knowing the firmware's
    rules and saying so first. samples.cpp skips what it cannot use, in
    silence, at power-up: a WAVE_FORMAT_EXTENSIBLE file (which is what a lot
    of tools write for 24-bit), a sample past the 48 MiB pool, a filename
    over 63 characters, anything past 64 sounds or 512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
2026-11-03 planning: the `#S` state line, specified for the firmware session
    Everything rodeo-console still needs from the firmware, in one file: the `j`
    command, every field with the call that produces it, and the chain array the
    original sketch was missing — "2 satellites, 24581 good scans" cannot draw a
    pot moving, and nothing currently prints where a control is.
    Two things worth reading before implementing: `EncoderSteps()` is destructive,
    so a state line that calls it stops `panel::Update()` seeing the encoders and
    breaks the instrument's own controls; and `PrintState()`'s 800-byte buffer is
    not enough for a full chain.
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2026-11-03 tools/rodeo-console: the chain, live over Web Serial
    Phase 2's other half, now that `j` and `J` are in the firmware. Connect the
    port and the page sends `J`; the satellites draw in ring order with every slot
    live — pots as meters, encoders as running detent totals, buttons and switches
    as they are — beside the preset, sound, filter, card and scan counts, with a
    break drawn after the satellite it follows.
    js/chain.js is a copy of two things that both stay authoritative: the line's
    shape from state_line.cpp, and the board kinds from sat_frame.h. The rule it
    is built around is that a line which does not parse is skipped rather than
    guessed at — the firmware abandons a line if the compute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
2026-11-03 tools/rodeo-console: the live page fills the width it is given
    Three comments on the review artifact, all of them right.
    The keyboard was a fixed 30px per white key under a row with min-width:100%,
    so a wide window stretched the row and not the keys. --pk-w now comes from the
    wrapper's width, clamped to 22-54px, recomputed on resize; since the black keys
    are positioned in --pk-w units nothing else had to change. Narrow windows clamp
    and scroll as before.
    The sequencer's columns were already 1fr, so its 760px cap was the only thing
    holding it narrow. Gone, from the grid and the footer. Step cells go to 26px
    tall, since at full width they are about 68px wide and looked like slots.
    And the s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
2026-11-03 tools/rodeo-console: make the encoder card legible
    Three things were wrong with it. Each row was its own CSS grid, so the columns
    lined up with nothing — a row with a note in its last column pushed everything
    left and the numbers wandered. The card is now the grid and the rows are its
    cells.
    The press indicator was an unlabelled 9px circle. It is a chip that says PRESS
    and lights up.
    And the number on each row was the detent total since power-up, which is not a
    state and tells you nothing: +14 means the same thing whether the encoder is
    spinning or has not been touched in an hour. The totals are now differenced
    between lines and shown as the turn that just happened, blank when the encode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
2026-11-03 tools/rodeo-console: one screen, three dots, the card in a dialog
    The card/live tab switch is gone. It existed because the Rodeo cannot have
    the card and the serial port open at once — disk mode closes CDC and takes
    USB-MIDI with it — but that is the hardware's constraint, not a reason to make
    the user navigate around a USB limitation. The page now shows the connections
    going dark instead of being two places.
    One toolbar carries all three: MIDI with its port, serial, and the card with
    its re-read and pool meter. Each has a status dot — grey not connected, yellow
    connected, cyan carrying traffic, red open but wrong — and the sentence the dot
    replaced is its tooltip, because a colour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
2026-11-03 tools/rodeo-console: read the five fields the firmware just added
    807d9b8 put det, oct, lfo, fx and mix in the `#S` line, so no panel row says
    "not reported" any more: E2 shows its detune and the octave its hold sets, E3
    its attack and whether the LFO is on, E4 the effects mix and which effect.
    The readout is one function with its own tests, including the case that
    matters if a field ever leaves the line again — absent must read as absent,
    never as a blank, because a blank looks exactly like a parameter set to zero.
    The test that asserted E2 and E4 were missing from the line now asserts they
    are present, which is the test doing its job: the world changed and it said so.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
2026-11-04 rodeo-demo: four presets after classic synths, and the engine to play them
    A fat mono lead, a poly brass, an FM electric piano and a screaming
    12 dB mono replace the three example presets. The engine gains what they
    need, reachable from preset files only: an FM shape (two sine pairs, body
    and tine), a zero-delay-feedback ladder at 24 or 12 dB with drive (DaisySP's
    oversampled ladder cost ~18 % CPU a voice), a high-pass, key tracking,
    settable decay and sustain, the filter envelope's own attack, and mono with
    legato and glide. Presets without the new keys sound as before; eight
    voices still cost about 70 % CPU. 'p' on the serial port steps presets.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
    [main.cpp, presets.cpp, presets.h, synth.cpp, synth.h]
2026-11-08 rodeo-demo: two pot banks and two encoder banks
    Pot bank 1 is the filter (cutoff, resonance, env, drive) and pot bank 2
    the amp envelope (attack, decay, sustain, release). Encoder bank 1 is as
    before but E3 turns the high-pass; encoder bank 2 is the filter envelope
    and glide, with mono on E8's tap. Of each kind, the first bank after the
    Seed is bank 1. Release moves from pot 4 to pot 8 and attack from E3 to
    pot 5; the protocol's hold bits are 8 wide.
    #S carries the new parameters, and rodeo-console pairs all four banks
    with what they drive. Its preset editor now knows every key the firmware
    parses (it was missing the eleven added on 2026-11-03, and fm).
    Built and host-tested; not yet run o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
    [main.cpp, panel.cpp, panel.h, params.cpp, params.h, presets.cpp, presets.h, remote.cpp]
2026-11-08 tools/rodeo-console: TypeScript, built with Vite
    The same page, typed: js/*.js moved to src/*.ts (renames, so history
    follows), strict, with types for the #S line, the chain, presets, the
    card model and WAVs, and no any. The tests run as TypeScript too, with
    Node's own type stripping (erasableSyntaxOnly keeps them runnable).
    npm install, then npm run dev; npm run build for dist/. Dev
    dependencies only: typescript, vite and the Web Serial and File System
    Access types. Behaviour is unchanged; one bug the types exposed is
    marked TODO(ts) in live.ts.
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2026-11-09 rodeo-sdk: the host protocol, run on a Rodeo
    examples/host on Rev B with four satellites: hello, state, set and chain
    answered within 7 ms, a stream through full sweeps of the first bank's
    pots, and dfu. What it showed:
    - dfu's reply never arrived: once it was in TinyUSB's buffer the Host
    counted it sent, and the firmware rebooted. host_usb.h gains
    HostUsbFinish(), which runs USB a little longer; call it first.
    - A requested state counted as a change, so a stream sent the same state
    20 times in its first second. Now nothing until something changes.
    - The example's pots took over at boot: a satellite reads 0 until its
    first scan comes back, so every pot seemed to move. It waits for o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
    [host.cpp, host.h, host_gtest.cpp, host_usb.h, main.cpp, version.h]
2026-11-09 rodeo-demo: on the SDK's host protocol
    Step 2 of planning/RODEO_HOST_PROTOCOL_PLAN.md. rodeo-demo's MIDI
    protocol becomes the SDK's rodeo::Host (protocol 2) with rodeo-demo's own
    parts on top; the console moves with it.
    Firmware:
    - remote.cpp is now the HostApp: get and set through params.cpp and
    panel::Set(), the hold bits, voices and the card fields; its CC map;
    and presets, load and sounds, renumbered 0x20-0x22 into the range the
    SDK leaves to a firmware. The queue, the SysEx reassembly and the stream
    are the SDK's.
    - params.cpp's table is rodeo::HostParam. Each default is computed at
    start-up from a default synth::Params, so it can't drift from synth.h.
    - The chain goes to the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
    [main.cpp, params.cpp, params.h, remote.cpp, remote.h, tusb_config.h]
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2026-11-10 rodeo-console: a piano roll, and the arp moves to the keyboard
    The 8 x 16 step grid becomes a piano roll: C0 to C5, 2 to 8 bars of
    sixteenths, notes with lengths, drawn on a canvas (src/roll.ts). Click to
    add, drag to lengthen or move, click to remove; notes of one pitch never
    overlap, and shortening the roll keeps the notes past its end.
    The arp is the keyboard's now, with its own clock, rate and gate: it runs
    whenever keys are held, transport or not, and lines up with the roll's next
    boundary when the roll is playing. The roll keeps play, tempo and swing.
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2026-11-12 rodeo-console: an 88-key roll, and a shorter arp lookahead
    The roll runs A0 to C8. A full column is now 88 notes, past the
    firmware's 64-event queue, so a step's notes go out 32 a millisecond,
    each note off as late as its note on, all before the 4 ms legato gap.
    The arp schedules 60 ms ahead instead of 140: it reads the held keys
    as it schedules, so a chord played a key at a time repeated its first
    key for a whole 1/16.
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2026-11-12 rodeo-demo editor: an instrument, not a debugging tool
    The console takes a debug option: the serial log and its button, the
    firmware's serial commands, the chain report, reboot for flashing and the
    build line. The generic console keeps them; the rodeo-demo editor turns
    them off (and stops streaming the chain report), unless the URL has ?debug.
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2026-11-12 tools: KiCad and render tools run on Linux as well as macOS
    bin/kicad-cli and bin/kicad-python run the macOS app's tools if it's there,
    else the Flathub Flatpak's (KiCad 10; Debian 13 only packages 9). The Python
    tools keep their lookup order ($KICAD_CLI / $KICAD_PYTHON, PATH, the macOS
    bundle) and fall back to the wrappers last, so nothing changes on a Mac.
    - render.py finds kicad-cli the same way instead of the hardcoded Mac path,
    and says to use Blender from blender.org (Debian's lacks numpy and
    OpenImageDenoise).
    - rear_panels.py finds KiCad's footprint libraries on either platform, and
    numbers the mounting holes as it places them: board.GetFootprints() order
    differs between KiC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
    [rodeo-audio-3.5mm-panel.kicad_pcb, rodeo-midi-panel.kicad_pcb, rodeo-power-switch-panel.kicad_pcb, rodeo-power-usbc-panel.kicad_pcb]
2026-11-12 hardware: regenerate the motherboard and encoder bank CPLs
    Both predate jlc_fab.py's fixes for parts whose pads repeat a number (d3e0e01)
    and for placing the PEC11R encoder by both lugs (dad5cab). U5 moves 0.05 mm,
    SW1-SW4 0.02 mm. Only the CPLs and placement checks change; the Gerbers and
    BOMs were already current.
    [CPL-rodeo-encoder-bank-4-panel.csv, CPL-rodeo-encoder-bank-4.csv, CPL-rodeo-motherboard-panel.csv, CPL-rodeo-motherboard.csv]
2026-11-12 rodeo-sdk docs: parse with clang's own headers on Linux, so CI agrees
    The libclang wheel ships without clang's builtin headers. A Mac gets them
    from the SDK; on Linux, host.h stopped parsing at <stddef.h> and defaults
    using its macros dropped out of host.mdx. That made the API reference check
    fail on every SDK push since 2026-11-01. Borrow an installed clang's resource
    dir (GitHub's Ubuntu runners have one). Also regenerate version.mdx, which
    really was behind version.h (the host-js line).
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2026-11-12 console and rodeo-demo editor: open them from another computer on the LAN
    `npm run dev:lan` / `preview:lan` listen on the network; plain `dev` stays on
    localhost. The Rodeo plugs into the computer with the browser, since Web MIDI
    and Web Serial reach only its own USB devices.
    - vite.serve.ts, shared by both vite.config.ts: fixed ports (console 5173,
    editor 5174), local host names allowed (Vite 403s unknown Host headers, so
    <server>.local was refused), and HTTPS from RODEO_TLS_CERT/RODEO_TLS_KEY.
    Over plain HTTP from another machine the page isn't a secure context, and
    Web MIDI, Web Serial and the File System Access API are missing.
    - README: making a local CA and certificate, trusti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
